Gugong0412/currentboard/R2_ALERT_REPORTS_005/explorer-template.html

CURRENT BOARD / R2

# 12채널 전류 측정 보드

공급원에서 DUT까지, 필요한 연결만 따라가며 보는 회로 지도

R2_REPAIRED_005ERC 0 · 8,437개 검사 통과ALERT 수정 반영제작 HOLD

## 같은 공급원은 묶고, 측정 채널은 따로

채널을 선택하면 실제 넷·핀·ALERT 연결이 표시됩니다.

−100%+기본 크기

블록도는 좌우로 이동할 수 있습니다. 채널 상세는 아래에 표시됩니다.

공통 공급원

직렬 션트채널 · Kelvin 측정DUT 출력

비측정 출력 U600 · VDDIO1V2 1.2V → J1400.7 / U620 · SYS_1V8 1.8V → J1400.9
두 전원에는 전류 측정 채널이 없습니다. SYS_1V8은 MOSCATO·레벨시프터에도 공급됩니다.

→ 공급원에서 DUT로 이어지는 경로INA228은 션트 양단을 Kelvin 감지보라색 = GND_F 기준 VGL 도메인

## 전원은 이렇게 만들어집니다

동일 공급원의 분기는 함께 ON/OFF됩니다. 전체 전원의 시퀀스 승인을 의미하지 않습니다.

J100 · DC 12VVIN_12V_RAW

→

U100 · TPS26600B1 · eFuse / UVLO·OVP·전류 제한

→

VIN_12V_PROTU200 및 U300의 공통 입력

12V 보호 출력에서 분기 A

### U200 · TPS62130 → AUX_5V

U400 · TPS7A9001CTRL_3V3→MCU · 양전압 INA 10개
U500/U520/U540/U600/U620 입력
USB 절연기 보드측 · U1300

U800 · RFM-0505S절연 DC/DC→RAW_5V_F → U810 TPS7A1633
F_3V3 / GND_FVGL INA 2개 + ISO1641 절연측

POWER LED→R1500 / D1500

12V 보호 출력에서 분기 B

### U300 · TPS62130 → VBAT

U900 · MOSCATOVBAT + SYS_1V8 공급→AVDDH1_SRC · 1채널
AVDDH2_SRC · S/O + GM 2채널
VGH_SRC · VGH1/2 2채널
VGL_SRC · VGL1/2 2채널

MOSCATO는 현재 PLACEHOLDER 심볼입니다. 실제 부품 핀맵은 확정 전입니다.

### CTRL_3V3에서 공급되는 LDO 5개 · 모두 TPS7A9001

LDO | 출력 | 분기·용도 | MCU 제어
U500 | VDDI_DIG_SRC | DIG 1채널 | EN_VDDI_DIG
U520 | VDDI_SRC | VDDI / LPDP / OSC 3채널 공통 | EN_VDDI
U540 | VCI_SRC | VCI 1채널 | EN_VCI
U600 | VDDIO1V2 · 1.2V | DUT · 비측정 | EN_VDDIO1V2
U620 | SYS_1V8 · 1.8V | DUT / MOSCATO / 레벨시프터 공유 | EN_SYS_1V8

U520 피드백은 R525 DNP / R526 FIT로 션트 전단 공통점을 기준으로 합니다. 채널별 션트 후단을 개별 보상하지 않습니다.

### VGL 도메인의 기준점

VGL_SRCMOSCATO 공통 음전원 출력

↔

NT800 · Copper net tieVGL_SRC와 GND_F 연결

↔

GND_FU820/U840 · U810 · ISO1641 절연측 기준

GND_F는 시스템 GND 또는 VGL1/2 DUT 후단과 같은 넷이 아닙니다. VGL 헤더의 2번 핀은 시스템 GND입니다.

## 측정값은 I2C로, 직접 알림은 ALERT로

12채널 모두 MCU에서 읽을 수 있습니다. MCU에 연결된 전용 ALERT는 6개입니다.

U1100 · STM32F072CBT6CTRL_3V3 / GND · 전원 EN · PG/FAULT 감시 · 측정값 수집

### I2C1 · 시스템 GND

PB6 SCL / PB7 SDA

↕

양전압 INA228 10개

전원 CTRL_3V3 / GND
주소 0x40~0x49

### I2C2 · 절연 경계 통과

PB10 SCL / PB11 SDA

↕

U830 · ISO1641시스템 GND ↔ GND_F

↕

U820 VGL1 · 0x40U840 VGL2 · 0x41

I2C2_SCL_F / I2C2_SDA_F
F_3V3 / GND_F 공급

### PC · USB 2.0

J1200 · USB4105-GF-ACC Rd / U1201~U1204 ESD

↕

U1200 · ADuM4160PC측 USB_VBUS / USB_GND
보드측 CTRL_3V3 / GND

↕

MCU PA11/PA12 · USB D−/D+
PB1 · USB_ATTACH_3V3

### 직접 ALERT · 6채널

AVDDH2 S/O → PB3, VGH1 → PB4 연결을 최신 수정본에서 복구했습니다.

### ALERT 핀은 있지만 MCU 연결은 없는 6채널

VGL1·2는 polling 유지
U820.3 / U840.3의 ALERT는 F_3V3에 10kΩ으로 pull-up됩니다. VGL1에는 TP1069가 있습니다. MCU로 가는 ALERT 절연 경로는 없으며, 진단 상태를 절연 I2C2로 읽습니다.

Polling = MCU가 주기적으로 측정·진단 레지스터를 읽는 방식입니다. 실행 펌웨어와 읽기 주기는 아직 검증되지 않았습니다.

### B13 · 1.8V 제어

U1300 · SN74AXC2T45

CTRL_3V3 → SYS_1V8 레벨 변환
MOSCATO_EN → U900
DDI_RESET_N → J1400.11

### B11 · 클록·서비스

Y1100 · 8MHz
J1100 SWD / J1101 BOOT
RESET / VDDA 필터 / 디커플링

### B10·B15 · 점검·상태

B10 테스트포인트 70개
POWER / STATUS / FAULT LED
추가 서비스 TP / M3 장착홀

## 12채널 연결표

주소·핀·ALERT 경로는 최신 네이티브 넷리스트와 펌웨어 정의에서 추출했습니다.

인쇄 / PDF 저장

채널 | 션트 | INA228 | I2C 주소 | DUT 핀 | MCU ALERT

R2_REPAIRED_005 · KiCad 10.0.7 · 2026-10-15 KST
회로 연결 검증 통과 / 션트값은 후보값 · 피크·기동·정확도·PCB 실측 미완료 · 제작 HOLD
