Gugong0412/currentboard/history/R2_VERIFY_002/channel_pin_audit.csv

ref | rail | bus | address_7bit | shunt_ref | R_ohm | 1 | 2 | 3 | 4 | 5 | 6 | 7 | 8 | 9 | 10
U700 | VDDI_DIG | 1 | 64 | R507 | 20.0 | GND | GND | ALERT_VDDI_DIG_N | I2C1_SDA | I2C1_SCL | CTRL_3V3 | GND | VDDI_DIG_SRC | VDDI_DIG_INA_N | VDDI_DIG_INA_P
U710 | VDDI | 1 | 65 | R527 | 20.0 | GND | CTRL_3V3 | ALERT_VDDI_N | I2C1_SDA | I2C1_SCL | CTRL_3V3 | GND | VDDI_SRC | VDDI_INA_N | VDDI_INA_P
U720 | VCI | 1 | 66 | R547 | 100.0 | GND | I2C1_SDA | ALERT_VCI_N | I2C1_SDA | I2C1_SCL | CTRL_3V3 | GND | VCI_SRC | VCI_INA_N | VCI_INA_P
U730 | AVDDH1 | 1 | 67 | R737 | 3.01 | GND | I2C1_SCL | ALERT_AVDDH1_N | I2C1_SDA | I2C1_SCL | CTRL_3V3 | GND | AVDDH1_SRC | AVDDH1_INA_N | AVDDH1_INA_P
U740 | AVDDH2_S_O | 1 | 68 | R747 | 3.01 | CTRL_3V3 | GND | ALERT_AVDDH2_S_O_N | I2C1_SDA | I2C1_SCL | CTRL_3V3 | GND | AVDDH2_SRC | AVDDH2_S_O_INA_N | AVDDH2_S_O_INA_P
U750 | VGH1 | 1 | 69 | R757 | 3.01 | CTRL_3V3 | CTRL_3V3 | ALERT_VGH1_N | I2C1_SDA | I2C1_SCL | CTRL_3V3 | GND | VGH_SRC | VGH1_INA_N | VGH1_INA_P
U820 | VGL1 | 2 | 64 | R807 | 20.0 | GND_F | GND_F | ALERT_VGL1_N | I2C2_SDA_F | I2C2_SCL_F | F_3V3 | GND_F | GND | VGL1_INA_N | VGL1_INA_P
U760 | AVDDH2_GM | 1 | 70 | R767 | 3.01 | CTRL_3V3 | I2C1_SDA | ALERT_AVDDH2_GM_N | I2C1_SDA | I2C1_SCL | CTRL_3V3 | GND | AVDDH2_SRC | AVDDH2_GM_INA_N | AVDDH2_GM_INA_P
U770 | VGH2 | 1 | 71 | R777 | 3.01 | CTRL_3V3 | I2C1_SCL | ALERT_VGH2_N | I2C1_SDA | I2C1_SCL | CTRL_3V3 | GND | VGH_SRC | VGH2_INA_N | VGH2_INA_P
U780 | VDDI_LPDP | 1 | 72 | R787 | 20 | I2C1_SDA | GND | ALERT_VDDI_LPDP_N | I2C1_SDA | I2C1_SCL | CTRL_3V3 | GND | VDDI_SRC | VDDI_LPDP_INA_N | VDDI_LPDP_INA_P
U790 | VDDI_OSC | 1 | 73 | R797 | 20 | I2C1_SDA | CTRL_3V3 | ALERT_VDDI_OSC_N | I2C1_SDA | I2C1_SCL | CTRL_3V3 | GND | VDDI_SRC | VDDI_OSC_INA_N | VDDI_OSC_INA_P
U840 | VGL2 | 2 | 65 | R847 | 20 | GND_F | F_3V3 | ALERT_VGL2_N | I2C2_SDA_F | I2C2_SCL_F | F_3V3 | GND_F | GND | VGL2_INA_N | VGL2_INA_P
