Gugong0412/currentboard/history/R2_VERIFY_002/SUMMARY.txt

Status: FAIL_OR_UNVERIFIED
Checks: 8473
Issues: 7
Production: HOLD
