Gugong0412/currentboard/R2_FIX_REPORTS_006/native/SUMMARY.txt

Status: SCHEMATIC_CHECKS_PASS_HARDWARE_HOLD
Checks: 8437
Issues: 0
Production: HOLD
