Gugong0412/currentboard/history/R1/DDI_Phase2_2_Independent_Audit.html

# Phase 2-2 · 독립 회로 검토

2026-10-13 / 제조사 데이터시트 · 실제 부품값 · 부분전원 · 고장조건 · 펌웨어 환산

검토 결과 JSON 내려받기

## 검토의 독립성과 범위

설계 작성과 분리된 검토 에이전트 3개가 전원부(B1~B6), 측정부(B7~B9), 디지털·인터페이스부(B11~B15)를 검토했다. B10 TP는 연결 계약 검사 범위에 포함하며 별도 능동회로는 없다. 실제 핀·넷·부품값을 제조사 자료와 대조하고, 보고서 설명이나 ERC 통과를 동작 보증으로 가정하지 않았다.

이 보고서는 전달했던 Phase2-2 회로도에 대한 정적 검토다. 미확정 MOSCATO 물리핀, 미선정 구매품 및 실측·PCB 레이아웃은 확인 완료로 처리하지 않았다. GitHub 현재판과 동일하다는 보증은 포함하지 않는다.

대상 344개 항목 / 전기 핀 897개 / IC·모듈·placeholder 27개. 아래 체크 표에 실제 확인한 범위를 기록하며 모든 수동소자의 모든 동작을 시험했다고 주장하지 않는다.

입력 계약 SHA256: 63ade460b9bef7a4eee51b0784ea3a5e7c3ac84fff7381ec68c0a9b74f5b98d3

## 우선 대응

① 실제 션트에서 전류 범위·펌웨어 환산값을 다시 생성한다. ② DUT 단락 시 션트 전력과 하드웨어 제한을 검증한다. ③ eFuse raw 입력 C와 서지 보호를 재선정한다. ④ MOSCATO 실물 자료로 VGL 및 전원 순서를 확정한다. ⑤ 저전류 전압 정확도·원격FB 안정성·기동 정착을 시험한다.

VDDA 1Ω 필터와 I²C timing은 에이전트 간 재대조하여 고장 확정과 조건부 계산을 구분했다. 중복되는 지적은 관련 ID를 함께 읽는다.

## 판정 기준

구분 | 의미
FAIL / CONFIRMED | FAIL은 명시 조건 불충족. CONFIRMED는 근거가 확인된 관측이며 tare 같은 정상 동작 영향도 포함한다. 제목·수정안을 보고 오류인지 미반영 예산인지 구분한다. Fault condition은 정상상태와 구분한다.
UNVERIFIED / CONDITIONAL | 필수 정보 또는 실측·제조사 허용 근거가 부족. 고장이 발생했다고 단정하지 않는다.
PASS | 해당 체크에서 명시한 정적 조건만 만족. 회로 전체 승인 아님.
P0 / P1 / P2 | P0: 제작 전 필수해결 / P1: 기능·정확도·보호 중요 / P2: 문서·실측·구현 확인. 원문 항목의 의미를 함께 읽는다.

## 발견사항 요약

ID | 우선도 | 판정 | Ref | 내용 | 수정 방향
PWR-01 | P0 | UNVERIFIED | ["D100", "U100", "U200", "U300"] | TVS/eFuse/벅의 서지 보호 최고전압 입증 미완료 | Specify actual adapter/surge/cable envelope, instrument VIN_12V_PROT during surge andfault. Use rated downstreamclamp with energycoordination or higherVINbuck if needed. Do not assume lowerVRWMalone solves
M-F08 | P0 | CONFIRMED | ["U900"] | 실제 PMIC 회로가 placeholder라 필수 외장부품 검증 불가 | Require MOSCATO exactMPN/data sheet/pinmap/reference circuit plus DUT power sequencing; keep fabrication release blocked forB9 until actual implementation audited.
PWR-02 | P1 | FAIL | ["C100", "U100"] | TVS 적용 시 eFuse 입력 커패시터 권장값 미충족 | Add manufacturerqualified≥1µFeffective highvoltage nonpolarceramic at U100IN/GND, checkhotplugringing and eFusepower; useactualsurgescope to validate
PWR-03 | P1 | UNVERIFIED | ["U500", "U520", "U540", "R505", "R525", "R545", "R507", "R527", "R547"] | 션트 뒤 원격 피드백의 부하별 루프 안정성 미검증 | SimulatevendorLDOmodel with Rs/CDUT/wiring/load range, measureloopgainorstepresponse allloads. Considerlocalfeedbackpluscalibratedvoltage setting, lowerRs plus highresolutionINA, or validatedcompensation. Do not labeloscillationconfirmed
PWR-04 | P1 | UNVERIFIED | ["U400", "U500", "U520", "U540", "U600", "U620", "R400", "R402", "R520", "R522", "R540", "R542"] | LDO 저전류 전압 정확도와 피드백 전류 오차 예산 미완료 | Declare railvoltage requirement; measurezero/min/maxloadandtemperature; reducefeedbackresistors while accounting for extra shunttare, orchooseLDOguaranteedlowloadaccuracy/calibratabletrim. No blindpromiseof±1%
PWR-05 | P1 | FAIL | ["R507", "R527", "U500", "U520"] | DUT 단락 시 20Ω 션트의 연속 열정격 초과 가능 | Hardwarechannelcurrentlimit/faultoff, appropriate shuntpower/derating and definedshortduration. FirmwareALERTalone should not be sole indefinitefaultprotection; testthermals. RaisingRsnotrecommendeddueheadroom/range
PWR-06 | P1 | UNVERIFIED | ["C405", "C505", "C525", "C545", "C605", "C625"] | SS 램프·30ms 대기·PG만으로 정밀 정착 완료 입증 불가 | UseactualINA/ADCvoltagestabilitywindow or characterized delay;keepPGforgrossvalidity,notprecisioncompletion. Specifyminimumdelay basedonworstcharacterization includingexternalDUTcapacitance
PWR-07 | P1 | UNVERIFIED | ["U400", "U500", "U520", "U540", "U600", "U620"] | 외부 전원 인가 및 입력 저하 시 LDO 역전류 미검증 | Defineexternalpower-offconstraints;testoutput>inputandinputremoval; addreverseblockingwhereexternalrailmayremainpowered,accountaddedvoltage/headroom
M-F01 | P1 | CONFIRMED | ["R737", "R757", "U730", "U750"] | AVDDH1/VGH 션트 최대 측정 전류 부족 | Choose actualR based peak/inrush plus margin;3.01Ω at20mA gives60.2mV and54.43mA FS. Update MPN/BOM/calibration/current-LSB together; VGH peak spec still required.
M-F02 | P1 | CONFIRMED | ["R527", "R737", "R757", "R807", "U710", "U730", "U750", "U820"] | 4개 채널의 실제 션트와 펌웨어 환산 저항 불일치 | Generate per-channelR_actual and conversion from authoritative BOM; add cross-artifact validation that fails on any mismatch.
M-F06 | P1 | UNVERIFIED | ["U820", "NT800", "U900", "R807"] | PMIC OFF 및 역방향 과도 상태에서 음전압 측정 입력 범위 미검증 | Measure GND_F/GND and both INA inputs during PMIC OFF/ON, unplug, rail shorts and residual charge with differential probe; derive safe clamp/discharge or rail-qualified power gating from actual PMIC spec. I2C delay alone does not ensure electrical limits.
M-F07 | P1 | UNVERIFIED | ["U900", "R807", "J1402"] | VGL1/VGL2의 공통 소스·통합 측정 허용 여부 미확정 | Obtain real PMIC/DUT net topology and decide common-sum vs separate measurement. Independent outputs require own sensing/power domains or suitable signed front end; revise actual contract.
D-F01 | P1 | UNVERIFIED | ["R1103", "C1105", "C1106", "U1100"] | VDDA 직렬1Ω 필터의 공급 규정 충족 근거 미완료 | 정확한STM32F072 제조사 허용filter 및기동파형으로closure; 가장보수적인최소수정은R1103=0Ω 동일rail직결 유지1u+100n localdecap.
D-F02 | P1 | CONFIRMED | ["U830", "U1100"] | ISO1641 side1 Cbus 한계를 보고서 I2C 설계한계에서 누락 | I2C2 MCU-side Cbus<=80pF로수정,각sidepin/trace/connector/probe합산;side2<=161pF현pullup/tr가정. rise/hold 실측.
D-F03 | P1 | UNVERIFIED | ["Y1100", "C1107", "C1108", "R1102"] | 정확도/드라이브/기동은 후보계산 단계이며 PCB검증 미완료 | 실제PCB Cs/주파수/drive/startup온도측정하여C1107/8,R1102조정;시간축200ppm요구기준기교정과온도/aging예산입증.
D-F04 | P1 | UNVERIFIED | ["U1201", "U1202", "U1203", "U1204", "U1300"] | 일부B12/B13 footprint 실제landpattern 미확정 | 제조사package/landpattern에대조한customfootprint완료후pin/padnumbergeometry검사.
PWR-08 | P2 | UNVERIFIED | ["U400", "U620"] | 정밀 영역의 국부 온도 상승 목표 미입증 | Thermalpad/copperdesign,spacefromshunt/INA,measurezoneΔTinworststeadystate;reportactualambients
M-F03 | P2 | UNVERIFIED | ["U700", "R507", "C701", "U730", "U820"] | 현재 ADC 설정의 노이즈 예산과 요구 측정 정확도 충족이 검증되지 않음 | Define target per sample/mean/window/threshold and test actual bandwidth/noise; select averaging/filter from required edge latency, characterize near100µA threshold chatter. Do not certify20-bit effective resolution.
M-F04 | P2 | CONFIRMED | ["R507", "R527", "R547", "U700", "U710", "U720"] | 원격 FB 분압 부하의 tare와 그 부하 의존성 확인 | Use measured no-DUT tare at same rail/temperature/config, preserve metadata; decide threshold semantics raw vs DUT. R507 remoteFB bandwidth/transient response needs actual DUT cap/load verification.
M-F05 | P2 | CONFIRMED | ["U700", "U710", "U720", "U730", "U740", "U750", "U820"] | INA 차동 입력저항의 션트 병렬 부하를 gain 예산에 추가 필요 | Include finite input impedance in calibration/error budget; do not infer guaranteed correction from typical92k. Validate fitted input filter with gain calibration.
M-F09 | P2 | UNVERIFIED | ["U800", "R800", "U810", "U820"] | 부동 전원의 발열 및 절연 커패시턴스 잡음 영향 미검증 | Place RFM/preload away from shunt/INA, verify thermal drift and VGLreference switching current; selectMLCCparts effectiveC, measure RFMlight-load startup/raw voltage, avoid grounded probes onGND_F.
M-F10 | P2 | UNVERIFIED | ["U720", "U830", "R830", "R831"] | I²C 소자별 주소 hold와 ISO1641 정전용량 조건 확인 | Verify addressMSBhold, buscap andVOL including MCU TIMINGR, routing and TP/probe loads; use scope across isolated domains appropriately.
D-F05 | P2 | UNVERIFIED | ["U1300", "J1400", "J1401", "J1402", "J1100"] | 외부DUT/debug장비연결조건에따른backpower/isolation 미검증 | MOSCATO/DDIpinleak,VDDI/O시퀀스외부전원조건확정;동일PCUSB+SWD동시사용시isolatedprobe혹은USB분리운용;headerkey/polaritymapping고정.

### PWR-01 · TVS/eFuse/벅의 서지 보호 최고전압 입증 미완료

항목 | 검토 결과
reviewer | power
severity | P0
status | UNVERIFIED
refs | ["D100", "U100", "U200", "U300"]
evidence | D100 clamp29.2V >TPS62130A abs20V; eFuseOVP14.874V and typicaldisable6µs, no max6µs guarantee
calculation | A fast step/ringing can cross20V beforedisconnect; staticOVP<17V does not prove peak limiting
fix | Specify actual adapter/surge/cable envelope, instrument VIN_12V_PROT during surge andfault. Use rated downstreamclamp with energycoordination or higherVINbuck if needed. Do not assume lowerVRWMalone solves
source_section | §7.5 OVPtyp6µs;TPS62130§7.1;TVSrating
cross_review | —

제조사 근거: https://www.ti.com/lit/ds/symlink/tps2660.pdf

### M-F08 · 실제 PMIC 회로가 placeholder라 필수 외장부품 검증 불가

항목 | 검토 결과
reviewer | measurement
severity | P0
status | CONFIRMED
refs | ["U900"]
evidence | Nine temporarylogicalpins; source contract PopulationPLACEHOLDER. No verified actualpinmap/footprint/output passives/timing limits available.
calculation | No basis to verify outputvoltage/current, startsequence, VGLoff impedance, required inductors/caps/diodes, voltage ratings or converterloop stability.
fix | Require MOSCATO exactMPN/data sheet/pinmap/reference circuit plus DUT power sequencing; keep fabrication release blocked forB9 until actual implementation audited.
source_section | MOSCATO actual source not supplied
cross_review | —

### PWR-02 · TVS 적용 시 eFuse 입력 커패시터 권장값 미충족

항목 | 검토 결과
reviewer | power
severity | P1
status | FAIL
refs | ["C100", "U100"]
evidence | Only100nF is present beforeeFuse; post-eFuse47µF+40µF cannot replace isolatedrawinputcap during cutoff
calculation | TI§11.1 recommends at least1µF for TVS/surge applications to limit negativeVINslew≤20V/µs
fix | Add manufacturerqualified≥1µFeffective highvoltage nonpolarceramic at U100IN/GND, checkhotplugringing and eFusepower; useactualsurgescope to validate
source_section | §11 PowerSupplyRecommendations;§11.1
cross_review | —

제조사 근거: https://www.ti.com/lit/ds/symlink/tps2660.pdf

### PWR-03 · 션트 뒤 원격 피드백의 부하별 루프 안정성 미검증

항목 | 검토 결과
reviewer | power
severity | P1
status | UNVERIFIED
refs | ["U500", "U520", "U540", "R505", "R525", "R545", "R507", "R527", "R547"]
evidence | FB selectedDUT aftershunt;44µFoutputcapacitorsatSRC;DUTcapacitanceandloadimpedanceunknown
calculation | Rs20Ω×CDUT10µF ->pole796Hz;100Ω×10µF ->159Hz (illustrative unloadedRC). Sourcecapacitance doesnotremove downstreamfeedbackphase shift
fix | SimulatevendorLDOmodel with Rs/CDUT/wiring/load range, measureloopgainorstepresponse allloads. Considerlocalfeedbackpluscalibratedvoltage setting, lowerRs plus highresolutionINA, or validatedcompensation. Do not labeloscillationconfirmed
source_section | §6.2;§7.1.3.1/§7.1.3.2
cross_review | —

제조사 근거: https://www.ti.com/lit/ds/symlink/tps7a90.pdf

### PWR-04 · LDO 저전류 전압 정확도와 피드백 전류 오차 예산 미완료

항목 | 검토 결과
reviewer | power
severity | P1
status | UNVERIFIED
refs | ["U400", "U500", "U520", "U540", "U600", "U620", "R400", "R402", "R520", "R522", "R540", "R542"]
evidence | TPS7A90±1% tested/guaranteed5mA..0.5A;actualDDIloads100µA..3mA;Rbottom150k gives5.333µAdivider;IFBmax±100nA
calculation | IFB×Rtop:CTRL46.875mV=1.42%;VCI41.25mV=1.375%;VDDI18.75mV=1.04%, on top ofIC/resistortolerance
fix | Declare railvoltage requirement; measurezero/min/maxloadandtemperature; reducefeedbackresistors while accounting for extra shunttare, orchooseLDOguaranteedlowloadaccuracy/calibratabletrim. No blindpromiseof±1%
source_section | §5.5;§7.1.1
cross_review | —

제조사 근거: https://www.ti.com/lit/ds/symlink/tps7a90.pdf

### PWR-05 · DUT 단락 시 20Ω 션트의 연속 열정격 초과 가능

항목 | 검토 결과
reviewer | power
severity | P1
status | FAIL
refs | ["R507", "R527", "U500", "U520"]
evidence | remoteFB=0 atshort commandsLDOsource towardCTRL3.3V;LDOcurrentlimit0.8–1.5A wellabovefault165mA;upstreameFuse~1.49A
calculation | 3.3²/20=.5445W, at3.333V .5554W;continuous0.25Wlimit corresponds111.8mA. Normal3mA0.18mW safe
fix | Hardwarechannelcurrentlimit/faultoff, appropriate shuntpower/derating and definedshortduration. FirmwareALERTalone should not be sole indefinitefaultprotection; testthermals. RaisingRsnotrecommendeddueheadroom/range
source_section | §5.5;§6.2
cross_review | —

제조사 근거: https://www.ti.com/lit/ds/symlink/tps7a90.pdf

### PWR-06 · SS 램프·30ms 대기·PG만으로 정밀 정착 완료 입증 불가

항목 | 검토 결과
reviewer | power
severity | P1
status | UNVERIFIED
refs | ["C405", "C505", "C525", "C545", "C605", "C625"]
evidence | 100nFSS_CTRL GND ramp13ms;last3%referencechargedvia280kΩ;PGthreshold84–95%
calculation | τ=280k*100n=28ms; final3%→1% needs28ln3=30.76ms additional after97% ramp≈12.5ms ⇒43.3ms typical;RNRtolerancenot specified
fix | UseactualINA/ADCvoltagestabilitywindow or characterized delay;keepPGforgrossvalidity,notprecisioncompletion. Specifyminimumdelay basedonworstcharacterization includingexternalDUTcapacitance
source_section | §7.1.2.2.2;§6.3.7
cross_review | —

제조사 근거: https://www.ti.com/lit/ds/symlink/tps7a90.pdf

### PWR-07 · 외부 전원 인가 및 입력 저하 시 LDO 역전류 미검증

항목 | 검토 결과
reviewer | power
severity | P1
status | UNVERIFIED
refs | ["U400", "U500", "U520", "U540", "U600", "U620"]
evidence | Datasheetdoesnot claimreversecurrentblocking;DUT/header maystilldriveoutputs whileCTRL inputoff;LDO500mAratingnotreverseblock
calculation | Storedcharge or externalDDIsignal/source can backfeedCTRL viaLDOpassstructure;actualdevicecurrentrequiresmodel/test
fix | Defineexternalpower-offconstraints;testoutput>inputandinputremoval; addreverseblockingwhereexternalrailmayremainpowered,accountaddedvoltage/headroom
source_section | §5.1;§6.2;§7.1.3.1
cross_review | —

제조사 근거: https://www.ti.com/lit/ds/symlink/tps7a90.pdf

### M-F01 · AVDDH1/VGH 션트 최대 측정 전류 부족

항목 | 검토 결과
reviewer | measurement
severity | P1
status | CONFIRMED
refs | ["R737", "R757", "U730", "U750"]
evidence | Contract+actual netlist component values20R; intended up to20mA analog measurement. INA228 range±163.84mV.
calculation | 10mA×20Ω=200mV; 20mA×20Ω=400mV. IFS=163.84mV/20Ω=8.192mA. Clipping starts before10mA.
fix | Choose actualR based peak/inrush plus margin;3.01Ω at20mA gives60.2mV and54.43mA FS. Update MPN/BOM/calibration/current-LSB together; VGH peak spec still required.
source_section | §6.5, §8.2.2 max shunt selection
cross_review | —

제조사 근거: https://www.ti.com/lit/ds/symlink/ina228.pdf

### M-F02 · 4개 채널의 실제 션트와 펌웨어 환산 저항 불일치

항목 | 검토 결과
reviewer | measurement
severity | P1
status | CONFIRMED
refs | ["R527", "R737", "R757", "R807", "U710", "U730", "U750", "U820"]
evidence | Hardware R52720Ω,R73720Ω,R75720Ω,R80720Ω; HTML firmware U710100Ω,U730/U750/U8203.01Ω. SHUNT_CAL1000 common.
calculation | Actual20Ω CURRENT_LSB15.625nA. U710 documented3.125nA yields0.2× true current. Other3.01Ω table103.8206nA yields6.644518× true current.
fix | Generate per-channelR_actual and conversion from authoritative BOM; add cross-artifact validation that fails on any mismatch.
source_section | §8.1.2 Equations2/4; artifact build_phase22.py INA table
cross_review | —

제조사 근거: https://www.ti.com/lit/ds/symlink/ina228.pdf

### M-F06 · PMIC OFF 및 역방향 과도 상태에서 음전압 측정 입력 범위 미검증

항목 | 검토 결과
reviewer | measurement
severity | P1
status | UNVERIFIED
refs | ["U820", "NT800", "U900", "R807"]
evidence | U820GND=VGL_SRC,VBUS=systemGND; IN−≈0 relativeGND_F,IN+≈I×20Ω. PMICOFF output behavior unknown. INA IN±/VBUS absolute min−0.3V.
calculation | Normal2mA givesIN+=40mV and VBUS≈11V atVGL_SRC−11V, valid. IfVGL_SRC rises above+0.3V, VBUS_local<−0.3V. Reverse current below−15mA at20Ω drivesIN+<−0.3V. Actual PMIC/output cap/return transient absent.
fix | Measure GND_F/GND and both INA inputs during PMIC OFF/ON, unplug, rail shorts and residual charge with differential probe; derive safe clamp/discharge or rail-qualified power gating from actual PMIC spec. I2C delay alone does not ensure electrical limits.
source_section | §6.1 absolute maximum; §6.5 VBUS/input ranges
cross_review | —

제조사 근거: https://www.ti.com/lit/ds/symlink/ina228.pdf

### M-F07 · VGL1/VGL2의 공통 소스·통합 측정 허용 여부 미확정

항목 | 검토 결과
reviewer | measurement
severity | P1
status | UNVERIFIED
refs | ["U900", "R807", "J1402"]
evidence | Actual U900 pin9 soleVGL, R807 one shunt, J1402 soleVGL_DUT. NoVGL1/VGL2 nets.
calculation | Common source split after shunt measuressum only. Independent PMIC outputs cannot be shorted merely because set voltage same.
fix | Obtain real PMIC/DUT net topology and decide common-sum vs separate measurement. Independent outputs require own sensing/power domains or suitable signed front end; revise actual contract.
source_section | Circuit topology; PMIC data sheet absent
cross_review | —

제조사 근거: https://www.ti.com/lit/ds/symlink/ina228.pdf

### D-F01 · VDDA 직렬1Ω 필터의 공급 규정 충족 근거 미완료

항목 | 검토 결과
reviewer | digital
severity | P1
status | UNVERIFIED
refs | ["R1103", "C1105", "C1106", "U1100"]
evidence | DS9826 VDDA>=VDD 및먼저형성 요구; actual1Ω+1.1uF는DCdrop와positive-ramp lag 발생. AN4080 외부filter권장하므로 필터 존재 자체를 확정불량으로 단정하지 않음. abs VDD−VDDA≤0.4V와operatingrule을분리.
calculation | tau1.1us; U40012.9ms/3.3V ramp capacitive lag0.281mV +analogload I*1Ω(예10mA→10mV). 실제 ramp/startuptested없음.
fix | 정확한STM32F072 제조사 허용filter 및기동파형으로closure; 가장보수적인최소수정은R1103=0Ω 동일rail직결 유지1u+100n localdecap.
source_section | §3.5.1/3.5.2;Table20;AN4080§1.1.1
cross_review | —

제조사 근거: https://www.st.com/resource/en/datasheet/stm32f072cb.pdf

### D-F02 · ISO1641 side1 Cbus 한계를 보고서 I2C 설계한계에서 누락

항목 | 검토 결과
reviewer | digital
severity | P1
status | CONFIRMED
refs | ["U830", "U1100"]
evidence | 보고서모든segment<=161pF라고지시하지만ISOside1recommendmax80pF. actualPCBcap미제공이라하드웨어초과는미확정.
calculation | tr0.8473*2200*80pF=149.1ns;161pF는300nsRC상한일뿐 device80pF제약이우선.
fix | I2C2 MCU-side Cbus<=80pF로수정,각sidepin/trace/connector/probe합산;side2<=161pF현pullup/tr가정. rise/hold 실측.
source_section | §6.3C1/C2
cross_review | —

제조사 근거: https://www.ti.com/lit/ds/symlink/iso1641.pdf

### D-F03 · 정확도/드라이브/기동은 후보계산 단계이며 PCB검증 미완료

항목 | 검토 결과
reviewer | digital
severity | P1
status | UNVERIFIED
refs | ["Y1100", "C1107", "C1108", "R1102"]
evidence | Cs4pF가정으로CL10pF. STM datasheet rough Cs10pF도가능,이면현재12p각CL16pF. 주변부품진동자loadpull/drivemax는ERC로검증못함.
calculation | actual CL=6pF+Cs. gmcrit0.584mS. maxdrive100uW에서IRMS sqrt(100uW/200Ω)=0.707mA;이는ESR200가정전류기준이지실측값아님.
fix | 실제PCB Cs/주파수/drive/startup온도측정하여C1107/8,R1102조정;시간축200ppm요구기준기교정과온도/aging예산입증.
source_section | specs;DS9826§6.3.6;AN2867
cross_review | —

제조사 근거: https://abracon.com/Resonators/abm3b.pdf

### D-F04 · 일부B12/B13 footprint 실제landpattern 미확정

항목 | 검토 결과
reviewer | digital
severity | P1
status | UNVERIFIED
refs | ["U1201", "U1202", "U1203", "U1204", "U1300"]
evidence | pending_footprints.json이ESD3pin/2pin+AXCDCT8을미확정으로표시;schematicprovenancepincorrect여도PCB생산용패드geometry증명없음.
calculation | B12/B13 5components footprintfinalizationpending.
fix | 제조사package/landpattern에대조한customfootprint완료후pin/padnumbergeometry검사.
source_section | DCTpackage mechanical drawing;TPDpackage drawings
cross_review | —

제조사 근거: https://www.ti.com/lit/ds/symlink/sn74axc2t45.pdf

### PWR-08 · 정밀 영역의 국부 온도 상승 목표 미입증

항목 | 검토 결과
reviewer | power
severity | P2
status | UNVERIFIED
refs | ["U400", "U620"]
evidence | CTRLseriesregulatordissipates~0.44W and SYS~0.15W;temperaturezone placementPCBpending
calculation | θJA62.5°C/W implies~27°C U400junctionrise—not boardlocalΔT≤5°C
fix | Thermalpad/copperdesign,spacefromshunt/INA,measurezoneΔTinworststeadystate;reportactualambients
source_section | §5.4;§7.2/§7.4
cross_review | —

제조사 근거: https://www.ti.com/lit/ds/symlink/tps7a90.pdf

### M-F03 · 현재 ADC 설정의 노이즈 예산과 요구 측정 정확도 충족이 검증되지 않음

항목 | 검토 결과
reviewer | measurement
severity | P2
status | UNVERIFIED
refs | ["U700", "R507", "C701", "U730", "U820"]
evidence | Datasheet Table8-2 AVG1 noise-freeENOB14.2 at540µs,16.0 at4120µs vs encoded20bits. Default differential caps DNP and0Ω series no fitted EMI filtering. HTML contains no ENOB/noise budget; this is a specification-validation gap, not proof that long-window averaging fails.
calculation | DIG noise-free p-p equivalent327.68mV/2^14.2≈17.41µV /20Ω≈0.871µA, versus15.625nA code step. At8µA signal this is ~10.9% p-p typical instantaneous spread; it is not a guaranteed absolute error and averaging-window accuracy must be separately assessed. 4120µs ENOB16 gives5µV p-p≈0.25µA at20Ω or1.661µA at3.01Ω. Offset max1µV=50nA at20Ω; resistor/gain/temp/tare add.
fix | Define target per sample/mean/window/threshold and test actual bandwidth/noise; select averaging/filter from required edge latency, characterize near100µA threshold chatter. Do not certify20-bit effective resolution.
source_section | §6.5; §8.1.3 Table8-2
cross_review | —

제조사 근거: https://www.ti.com/lit/ds/symlink/ina228.pdf

### M-F04 · 원격 FB 분압 부하의 tare와 그 부하 의존성 확인

항목 | 검토 결과
reviewer | measurement
severity | P2
status | CONFIRMED
refs | ["R507", "R527", "R547", "U700", "U710", "U720"]
evidence | FIT R505/R525/R545 connect feedback divider downstream of shunt. Divider current is0.8V/150kΩ≈5.333µA nominal. Source-sideVBUS bypasses shunt.
calculation | Measured load≈DUT current+divider+other downstream leakage; at8µA DUT nominal raw13.333µA. DIG SOVL0190=2mV/20Ω=100µA raw≈94.667µA DUT, not100µA DUT. FB bias/voltage/temp change tare.
fix | Use measured no-DUT tare at same rail/temperature/config, preserve metadata; decide threshold semantics raw vs DUT. R507 remoteFB bandwidth/transient response needs actual DUT cap/load verification.
source_section | §7.6.1.13 SOVL; TPS7A90 feedback circuit and actualR505/R525/R545
cross_review | —

제조사 근거: https://www.ti.com/lit/ds/symlink/ina228.pdf

### M-F05 · INA 차동 입력저항의 션트 병렬 부하를 gain 예산에 추가 필요

항목 | 검토 결과
reviewer | measurement
severity | P2
status | CONFIRMED
refs | ["U700", "U710", "U720", "U730", "U740", "U750", "U820"]
evidence | INA RDIFF typical92kΩ, in addition to2.5nA max input bias specification; report did not budget divider path explicitly.
calculation | EffectiveR=Rsh||92kΩ. Ideal hardware V/Rsh under-reports total DUT path current by Rsh/(92k+Rsh):20Ω0.021734%,100Ω0.108578%,3.01Ω0.003272%; typicalRDIFF only, not guaranteed bound. Optional10Ω filter each adds20/92k≈0.0217% additional gain loss.
fix | Include finite input impedance in calibration/error budget; do not infer guaranteed correction from typical92k. Validate fitted input filter with gain calibration.
source_section | §6.5 RDIFF; §8.1.4 input filtering Figure8-1
cross_review | —

제조사 근거: https://www.ti.com/lit/ds/symlink/ina228.pdf

### M-F09 · 부동 전원의 발열 및 절연 커패시턴스 잡음 영향 미검증

항목 | 검토 결과
reviewer | measurement
severity | P2
status | UNVERIFIED
refs | ["U800", "R800", "U810", "U820"]
evidence | RFM unregulated50..100kHz, ripple100mVppmax at specified100nFtest; isolation capacitance75pFmax. R800≈114mW at5V; RFM inputquiescent25mAtyp. U820offsetdrift10nV/°Cmax.
calculation | Digital3.3V headroom and capacitance nominal plausible; precision pickup depends PCB.75pF×dV/dt injects common-mode current, not DC short. 5°C INA offsetdrift max50nV (~2.5nA at20Ω), resistor25ppm/°C contributes125ppm over5°C; PCB temp actual unknown.
fix | Place RFM/preload away from shunt/INA, verify thermal drift and VGLreference switching current; selectMLCCparts effectiveC, measure RFMlight-load startup/raw voltage, avoid grounded probes onGND_F.
source_section | Electrical characteristics, regulation, isolation capacitance; INA §6.5
cross_review | —

제조사 근거: https://recom-power.com/pdf/Econoline/RFM.pdf

### M-F10 · I²C 소자별 주소 hold와 ISO1641 정전용량 조건 확인

항목 | 검토 결과
reviewer | measurement
severity | P2
status | UNVERIFIED
refs | ["U720", "U830", "R830", "R831"]
evidence | INA A0=SDA needsadditional100ns hold; ISOside1Cmax80pF,side2Cmax400pF; nominal2.2k pullups valid.
calculation | At80pF t_r≈0.8473×2.2k×80pF=149ns; RC-only300ns limit161pF does not authorizeISOside1>80pF.
fix | Verify addressMSBhold, buscap andVOL including MCU TIMINGR, routing and TP/probe loads; use scope across isolated domains appropriately.
source_section | INA §7.5.1 Table7-2; ISO §6.3 recommended operating conditions
cross_review | 디지털 검토와 대조: tf≤100ns/48MHz/지정필터 조건에서 주소 hold 최소 약179ns로 조건부 충족. 실제 파형 확인은 필요. ISO side1은≤80pF 적용; 보고서161pF 일반값과의 문서 불일치는D-F02에 별도 기록.

제조사 근거: https://www.ti.com/lit/ds/symlink/ina228.pdf ; https://www.ti.com/lit/ds/symlink/iso1640.pdf

### D-F05 · 외부DUT/debug장비연결조건에따른backpower/isolation 미검증

항목 | 검토 결과
reviewer | digital
severity | P2
status | UNVERIFIED
refs | ["U1300", "J1400", "J1401", "J1402", "J1100"]
evidence | AXC Ioff보호는신호포트에한정;DUT의외부pullup/다른전원/RESETdiode와railfeeding은미제공. SWD PC ground로USBisolation우회가능. unkeyedheadersreverse/misplug위험.
calculation | B출력Ioff8uA*10k=80mV은외부누설/풀업없을때만성립.
fix | MOSCATO/DDIpinleak,VDDI/O시퀀스외부전원조건확정;동일PCUSB+SWD동시사용시isolatedprobe혹은USB분리운용;headerkey/polaritymapping고정.
source_section | §5.5Ioff;systemconnectionconditions
cross_review | —

제조사 근거: https://www.ti.com/lit/ds/symlink/sn74axc2t45.pdf

## 체크 매트릭스 · 에이전트 원문

### Actual Phase2-2 B1–B6 independent datasheet audit; schematic/verified netlist; no edits

refs | status | item | actual | criterion | source_url | source_section
["U100"] | PASS | PWP16 pins/reference domains | IN1/2;OUT15/16;RTN8/EP17;GND9;UV3;OV5;MODE6→RTN;SHDN7 NC | §6 pinmap consistent; RTN must not be shorted GND | https://www.ti.com/lit/ds/symlink/tps2660.pdf | §6;§10.4
["R100", "R101", "R102"] | PASS | Nominal DC UVLO/OVP | 110k/4.99k/10k,0.1%; UVLO9.922V,OVP14.874V | At full resistor temp allowance OVP about14.508–15.433V <17V continuous buck max; no transient claim | https://www.ti.com/lit/ds/symlink/tps2660.pdf | §7.5;§9.3.2
["R103"] | PASS | eFuse nominal current limit | 8.06kΩ =>12000/8060=1.4888A | 5.36k≤RILIM≤120k; approximately1.40–1.58A with ±5%IC and ±1%R (interpolated bound) | https://www.ti.com/lit/ds/symlink/tps2660.pdf | §7.5;§9.3.5.1.1
["C101"] | PASS | Output slew ramp | 100nF;4.7µA,gain24.6 =>dVOUT/dt1.156V/ms;12V ramp10.38ms;CdVdt delay1.45ms typical | Local referenced to RTN, within recommended control pin voltage | https://www.ti.com/lit/ds/symlink/tps2660.pdf | §7.5;§9.3.3
["R104"] | PASS | FLT pullup | 10k CTRL_3V3; about330µA sink | Open-drain voltage rating covers3.3V; low≈53mV using max160Ω | https://www.ti.com/lit/ds/symlink/tps2660.pdf | §7.5
["C102", "C103"] | UNVERIFIED | eFuse output capacitor mechanical/surge | 47µF35V+100nF50V; logical polarity correct | Actual47µF MPN/ESR/ripple/land pattern not finalized; output-negative spike protection to be tested | https://www.ti.com/lit/ds/symlink/tps2660.pdf | §11.1
["J100"] | UNVERIFIED | Input jack physical rating/pin orientation | PJ-102AH logical center1/sleeve2/switch3NC | Manufacturer drawing/mating plug/actual max current rating not independently verified in this pass | https://www.sameskydevices.com/product/interconnect/connectors/dc-power-connectors/jacks/pj-102ah | Mechanical drawing
["D100", "C100", "U200", "U300"] | UNVERIFIED | Transient protection chain | SMBJ18CA29.2V;C100100nF;TPS62130A abs20V | Requires source surge envelope plus eFuse downstream peak proof; see findings PWR-01/PWR-02 | https://www.ti.com/lit/ds/symlink/tps2660.pdf | §7.5;§11.1
["U200"] | PASS | TPS62130A physical pins/function | SW1/2/3;PG4;FB5;AGND6;FSW7GND;DEF8GND;SS9;AVIN10;PVIN11/12;EN13;VOS14 output;PGND15/16;EP17GND | Matches datasheet RGT16; AVIN/PVIN same source;2.5MHz selected, DEFno+5% | https://www.ti.com/lit/ds/symlink/tps62130.pdf | §6 Table6-1;§8.3.5
["U300"] | PASS | TPS62130A physical pins/function | SW1/2/3;PG4;FB5;AGND6;FSW7GND;DEF8GND;SS9;AVIN10;PVIN11/12;EN13;VOS14 output;PGND15/16;EP17GND | Matches datasheet RGT16; AVIN/PVIN same source;2.5MHz selected, DEFno+5% | https://www.ti.com/lit/ds/symlink/tps62130.pdf | §6 Table6-1;§8.3.5
["R200", "R201", "R202"] | PASS | 5V divider | 523k+2k/100k =>0.8*(1+525/100)=5.000V;divider8µA | Rbottom≤400k, Vout0.9–6V; extra serialR mathematically okay | https://www.ti.com/lit/ds/symlink/tps62130.pdf | §9.2.2.1
["R300", "R301", "R302"] | PASS | 3.8V divider | 374k+1k/100k =>3.800V;divider8µA | Rbottom≤400k; ratio correct | https://www.ti.com/lit/ds/symlink/tps62130.pdf | §9.2.2.1
["L200", "L300"] | PASS | Inductor nominal value/load margin | XFL4020-222MEC2.2µH±20%;DCRmax23.5mΩ;datasheet3.8A recommendation; ΔI worst at15.43V,L1.76µH,f2MHz≈0.960A(5V),0.814A(3.8V) | At intended AUX≈0.5A/PMIC≤1A, peak≤1.48A < Coilcraft6A at10%L drop; actual full3A continuous not separately promised | https://www.ti.com/lit/ds/symlink/tps62130.pdf | §9.2.2.2;Table9-3;Coilcraft XFL4020 datasheet
["C200", "C201", "C202", "C203", "C204", "C300", "C301", "C302", "C303", "C304"] | UNVERIFIED | Buck input/output capacitors | CIN2×10µF50V+CAVIN100nF;COUT2×22µF16V | Nominal adequate and required AVIN100nF present; MPN/DC-bias effective cap/PCB loop placement pending | https://www.ti.com/lit/ds/symlink/tps62130.pdf | §9.2.2.2.2
["C205", "C305"] | PASS | Buck soft-start | 3.3nF =>tSS1.65ms typical | Equation10 C=t*2.5µA/1.25V; max timing not established | https://www.ti.com/lit/ds/symlink/tps62130.pdf | §9.2.2.2.2.3
["R203", "R303", "R304", "R305"] | PASS | Buck PG/EN/bleeder | PG10k→CTRL;VBAT EN100k→GND;VBAT1k→GND | PGopen-drain;bootENlow;bleeder3.8mA/14.44mW <0.1W;44µF→0.3V decay111.7ms nominal | https://www.ti.com/lit/ds/symlink/tps62130.pdf | §6;§8.3.3
["U400"] | PASS | TPS7A90 DSK10 pin wiring | OUT1/2;FB3;GND4;PG5;SS_CTRL6GND;EN7;NR8;IN9/10;EP11GND | Correct pinmap; supplies3.3/5V inside1.4–6.5V; SS_CTRL grounded | https://www.ti.com/lit/ds/symlink/tps7a90.pdf | §4 pinfunctions;§5.3
["U500"] | PASS | TPS7A90 DSK10 pin wiring | OUT1/2;FB3;GND4;PG5;SS_CTRL6GND;EN7;NR8;IN9/10;EP11GND | Correct pinmap; supplies3.3/5V inside1.4–6.5V; SS_CTRL grounded | https://www.ti.com/lit/ds/symlink/tps7a90.pdf | §4 pinfunctions;§5.3
["U520"] | PASS | TPS7A90 DSK10 pin wiring | OUT1/2;FB3;GND4;PG5;SS_CTRL6GND;EN7;NR8;IN9/10;EP11GND | Correct pinmap; supplies3.3/5V inside1.4–6.5V; SS_CTRL grounded | https://www.ti.com/lit/ds/symlink/tps7a90.pdf | §4 pinfunctions;§5.3
["U540"] | PASS | TPS7A90 DSK10 pin wiring | OUT1/2;FB3;GND4;PG5;SS_CTRL6GND;EN7;NR8;IN9/10;EP11GND | Correct pinmap; supplies3.3/5V inside1.4–6.5V; SS_CTRL grounded | https://www.ti.com/lit/ds/symlink/tps7a90.pdf | §4 pinfunctions;§5.3
["U600"] | PASS | TPS7A90 DSK10 pin wiring | OUT1/2;FB3;GND4;PG5;SS_CTRL6GND;EN7;NR8;IN9/10;EP11GND | Correct pinmap; supplies3.3/5V inside1.4–6.5V; SS_CTRL grounded | https://www.ti.com/lit/ds/symlink/tps7a90.pdf | §4 pinfunctions;§5.3
["U620"] | PASS | TPS7A90 DSK10 pin wiring | OUT1/2;FB3;GND4;PG5;SS_CTRL6GND;EN7;NR8;IN9/10;EP11GND | Correct pinmap; supplies3.3/5V inside1.4–6.5V; SS_CTRL grounded | https://www.ti.com/lit/ds/symlink/tps7a90.pdf | §4 pinfunctions;§5.3
["R400", "R401", "R402"] | UNVERIFIED | LDO nominal divider / total tolerance | Nominal 3.300000V, target3.3V;divider5.333µA;IFB±100nA gives±46.875mV (1.420%) | Ratio nominal PASS. Overall precision not established; IC1% is ≥5mA condition; IFB/resistor/temp added, see PWR-04 | https://www.ti.com/lit/ds/symlink/tps7a90.pdf | §5.5;§7.1.1
["R500", "R502"] | UNVERIFIED | LDO nominal divider / total tolerance | Nominal 1.240000V, target1.24V;divider5.333µA;IFB±100nA gives±8.250mV (0.665%) | Ratio nominal PASS. Overall precision not established; IC1% is ≥5mA condition; IFB/resistor/temp added, see PWR-04 | https://www.ti.com/lit/ds/symlink/tps7a90.pdf | §5.5;§7.1.1
["R520", "R521", "R522"] | UNVERIFIED | LDO nominal divider / total tolerance | Nominal 1.799995V, target1.8V;divider5.333µA;IFB±100nA gives±18.750mV (1.042%) | Ratio nominal PASS. Overall precision not established; IC1% is ≥5mA condition; IFB/resistor/temp added, see PWR-04 | https://www.ti.com/lit/ds/symlink/tps7a90.pdf | §5.5;§7.1.1
["R540", "R541", "R542"] | UNVERIFIED | LDO nominal divider / total tolerance | Nominal 2.999995V, target3V;divider5.333µA;IFB±100nA gives±41.250mV (1.375%) | Ratio nominal PASS. Overall precision not established; IC1% is ≥5mA condition; IFB/resistor/temp added, see PWR-04 | https://www.ti.com/lit/ds/symlink/tps7a90.pdf | §5.5;§7.1.1
["R600", "R602"] | UNVERIFIED | LDO nominal divider / total tolerance | Nominal 1.200000V, target1.2V;divider5.333µA;IFB±100nA gives±7.500mV (0.625%) | Ratio nominal PASS. Overall precision not established; IC1% is ≥5mA condition; IFB/resistor/temp added, see PWR-04 | https://www.ti.com/lit/ds/symlink/tps7a90.pdf | §5.5;§7.1.1
["R620", "R621", "R622"] | UNVERIFIED | LDO nominal divider / total tolerance | Nominal 1.799995V, target1.8V;divider5.333µA;IFB±100nA gives±18.750mV (1.042%) | Ratio nominal PASS. Overall precision not established; IC1% is ≥5mA condition; IFB/resistor/temp added, see PWR-04 | https://www.ti.com/lit/ds/symlink/tps7a90.pdf | §5.5;§7.1.1
["R505", "R506", "R525", "R526", "R545", "R546"] | UNVERIFIED | Feedback selection and remote regulation | DUT selection0Ω FIT, source0Ω DNP, exclusive assembly | Assembly population is correct; bothFIT would short shunt. Remote stability not covered by standard OUT-senseddatasheet;see PWR-03 | https://www.ti.com/lit/ds/symlink/tps7a90.pdf | §6.2;§7.1.3
["R507", "R527", "R547"] | FAIL | Shunt DC/fault power and dropout | 20Ω/20Ω/100Ω,0.25W;normal3mA→60mV0.18mW DIG;1mA→20mV0.02mW VDDI;1mA→100mV0.1mW VCI | Normal rated loads PASS. DUTshort makes20Ω about0.545W without upstream protection; see PWR-05 | https://www.ti.com/lit/ds/symlink/tps7a90.pdf | §5.5 currentlimit;§6.2 block diagram
["R503", "R523", "R543", "R603", "R623", "R404", "R504", "R524", "R544", "R604", "R624"] | PASS | LDO EN boot pull-down/PG pullup | EN100k→GND;PG10k→CTRL | ENdisabledthreshold≤0.4V;pullup10k within10–100k;PGnotprecisionstatus and invalid belowVIN0.8V | https://www.ti.com/lit/ds/symlink/tps7a90.pdf | §5.3;§5.5;§6.3.7
["C400", "C401", "C402", "C403", "C404", "C500", "C502", "C503", "C504", "C520", "C522", "C523", "C524", "C540", "C542", "C543", "C544", "C600", "C602", "C603", "C604", "C620", "C622", "C623", "C624"] | UNVERIFIED | LDO decoupling effective value | U400CIN44µF,COUT44µF;otherCIN10µF+100nF,COUT44µF | 10µF recommendation already includes50%derating; nominal setup acceptable. Actual ≥5µF minimum adopted design floor requires MPNcurve confirmation, not a separately specified guarantee | https://www.ti.com/lit/ds/symlink/tps7a90.pdf | §7.1.3
["C405", "C505", "C525", "C545", "C605", "C625"] | UNVERIFIED | Soft-start and final settling | 100nF,SS_CTRL GND;tSSnom12.90ms, referencecurrent4–9µA;last3%throughRNR≈280k | Last3% timeconstant≈28ms;43ms nominal to1%error;PGcanrise at84–95%;seePWR-06 | https://www.ti.com/lit/ds/symlink/tps7a90.pdf | §7.1.2.2.2;§6.3.7
["C406", "C506", "C526", "C546", "C606", "C626"] | PASS | Feedforward optional/DNP | 100pF allDNP | CFFnotrequired for standard topology stability. Fitting differentCFF requiresstartup/PGrecheck and remote-loop check | https://www.ti.com/lit/ds/symlink/tps7a90.pdf | §7.1.3.2
["U400", "U620"] | UNVERIFIED | Thermal intended budget | U400~0.436W@250mA θJA62.5→27.3°C;SYS100mA1.5Vdrop→0.15W≈9.4°C | Junction likely okay at labambient with thermalpad;localmeasurementzoneΔT≤5°Cnotguaranteed by package spec,PCB/IRtest needed | https://www.ti.com/lit/ds/symlink/tps7a90.pdf | §5.4;§7.2 thermal
["#FLG0100", "#FLG0101", "#FLG0102", "#FLG0200", "#FLG0300"] | PASS | PWR_FLAGs | No physicalload | ERC helper only; not functional sourcing guarantee

### B5 shunts + B7 INA228 positive channels + B8 floating VGL + B9 MOSCATO; Phase2-2 actual schematic/netlist/contract vs embedded firmware report; independent design audit, no changes

id | status | refs | detail
M-C01 | PASS | ["U700", "U710", "U720", "U730", "U740", "U750", "U820"] | INA228 physical pins 1=A1,2=A0,3=ALERT,4=SDA,5=SCL,6=VS,7=GND,8=VBUS,9=IN−,10=IN+; seven devices match. Positive rail IN+ source/IN− DUT; VGL polarity deliberately reversed to measure current toward negative source as positive.
M-C02 | PASS | ["U700", "U710", "U720", "U730", "U740", "U750", "U820"] | I2C1 0x40..0x45 unique; I2C2 local 0x40 allowed on separate bus. Supply CTRL_3V3/F_3V3 satisfies VS2.7..5.5V; each device has local100nF+1µF nominal.
M-C03 | UNVERIFIED | ["U720", "U830"] | A0=SDA address requires additional100ns hold on address MSB; measured timing is absent. ISO1641 side1 bus capacitance max80pF, side2 max400pF, stricter than RC-only side1 calculation. Pullup2.2k at3.3V sinks1.5mA, within ISO side1 max3.5mA.
M-C04 | FAIL | ["R737", "R757"] | 20Ω shunt fullscale8.192mA at ADCRANGE0, below intended analog20mA range.
M-C05 | FAIL | ["R527", "R737", "R757", "R807"] | Four hardware shunt values differ from embedded HTML firmware conversion table.
M-C06 | PASS | ["U700", "U710", "U720", "U730", "U740", "U750", "U820"] | CONFIG0000 ADCRANGE0; AB28/ABE8 correctly encode shunt-only continuous540µs/4120µs AVG1; SHUNT_CAL1000 corresponds CURRENT_LSB=0.3125µV/R_actual. 24-bit VSHUNT/CURRENT bits23:4 signed, VBUS bits23:4 nonnegative. SOVL LSB5µV differs ADC0.3125µV.
M-C07 | UNVERIFIED | ["R507", "R527", "R547", "R737", "R747", "R757", "R807"] | 0.1%/25ppm targets and logical4-pin/physical2-terminal1206 implementation are stated; actual ordered resistance/tempco, Kelvin pad routing and copper current distribution need PCB/manufacturer proof. FIT sense resistors0Ω, differential1nF DNP: no external analog filter fitted.
M-C08 | PASS | ["U800", "R800", "U810", "C810", "C812"] | RFM pin1−VIN/2+VIN/3−VOUT/4+VOUT correct. TPS7A1633 DNC pin2 open; DELAY7 open legal. IN22µF/OUT22µF nominal exceeds minima0.1/2.2µF; effective capacitance still needs selected-MLCC curve. R800220Ω creates>=20.25mA at4.5V,+1%R and therefore >=10% of200mA rating; 5V dissipation113.6mW within0.5W rating. Raw22.1µF is below470µF RFM max capacitive load.
M-C09 | PASS | ["U820", "NT800", "U830"] | VGL_SRC=GND_F byNT800; U820VBUS=systemGND means VBUS_local=−VGL_SRC, permitting magnitude measurement for negative rail. I2C domains electrically isolated; pullups terminate in own domains. No direct system-pullup feed into GND_F.
M-C10 | UNVERIFIED | ["U820", "U900", "NT800"] | No PMIC OFF-output impedance/discharge/waveform exists to guarantee GND_F potential or U820 pin absolute limits during power-up/off/reverse current. PG_F_3V3 proves only local3.3V, not floating-domain absolute potential.
M-C11 | UNVERIFIED | ["U900", "R807"] | Only one VGL source/shunt/output path; VGL1/VGL2 identity, permitted shared rail or independent PMIC outputs unprovided.
M-C12 | FAIL | ["U900"] | MOSCATO nine logical pins PLACEHOLDER, no actual package, PMIC inductor/diode/caps/current-limit/compensation/output discharge requirements; cannot release physical B9 design.
M-C13 | PASS | ["B7", "B8", "B9"] | {"exported_netlist_contract_mismatches": []}
M-C14 | PASS | ["R507", "R527", "R547", "R737", "R747", "R757", "R807"] | YageoRTseries latest2026-02-12V17 p5Table2 RT1206 1/4W ±0.1% ±25ppm range1Ω..1.5MΩ. Part codes BRD mean±0.1%,paperreel,±25ppm; 3.01Ω/20Ω/100Ω valid within series published range. Production exactorder availability remains procurement check. Source https://yageogroup.com/content/datasheet/asset/file/PYU-RT_1-TO-0-01_ROHS_L

### B11~B15 independent electrical/datasheet audit; actual schematic verified netlist; no edits

id | refs | status | detail | source_url | source_section

D-C01

["U1100", "C1100", "C1101", "C1102", "C1103", "C1104", "R1103", "C1105", "C1106", "Y1100", "R1102", "C1107", "C1108", "R1100", "C1109", "SW1100", "R1101", "J1101", "R1104", "R1105", "J1100", "J1200", "R1200", "R1201", "U1200", "R1202", "R1203", "R1204", "R1205", "R1206", "R1207", "C1200", "C1201", "C1202", "C1203", "C1204", "C1205", "U1201", "U1202", "U1203", "U1204", "#FLG1200", "#FLG1201", "U1300", "C1300", "C1301", "R1300", "R1301", "R1302", "R1303", "R1304", "R1305", "J1400", "J1401", "J1402", "R1500", "D1500", "R1501", "D1501", "R1502", "D1502", "H1500", "H1501", "H1502", "H1503", "LOGO1500", "TP1500", "TP1501", "TP1502", "TP1503", "TP1504", "TP1505", "TP1506", "TP1507", "TP1508"]

PASS

B11~B15 actual verified_netlist.xml vs contract: local sheet path normalized; PWR_FLAG excluded; non-NC pin differences=[]

None

netlist cross-check
D-C02 | ["U1100"] | PASS | LQFP48 physical pin names 1~48 compared DS9826 Table14/Figure10; VDD24/48 VDDIO2=36 VBAT=1 VDDA=9 VSSA=8 VSS23/35/47 correctly assigned. | https://www.st.com/resource/en/datasheet/stm32f072cb.pdf | Table14; Figure10
D-C03 | ["U1100", "C1100", "C1101", "C1102", "C1103", "C1104", "C1105", "C1106"] | PASS | VDD/VDDIO2/VBAT all same3.3V; separate100n per power,4.7u bulk,VDDA1u+100n present. PASS on values only; placement/return geometry unverified. | https://www.st.com/resource/en/datasheet/stm32f072cb.pdf | §3.5; Figure13
D-C04 | ["U1100", "R1103"] | UNVERIFIED | VDDA filter compliance needs closure: DS recommends VDDA>=VDD and first established, AN4080 recommends single rail external filtering. Current1Ω means small lag/drop; cannot call catastrophic error. See D-F01. | https://www.st.com/resource/en/datasheet/stm32f072cb.pdf | §3.5.1/3.5.2; Table20
D-C05 | ["R1100", "C1109", "SW1100", "R1101", "J1101", "J1100"] | PASS | NRST external10k to3.3V+100n GND+button; BOOT0 10k pulldown service jumper; ARM SWD standard1VTref2SWDIO3GND4SWCLK5GND7key9GND10reset. Pin7 remains physical unkeyed-header pin requiring remove/keying. | https://www.st.com/resource/en/application_note/an4080-getting-started-with-stm32f0x1x2x8-hardware-development-stmicroelectronics.pdf | §1.2.3; §3; §4
D-C06 | ["U1100"] | PASS | PA0 AF2 TIM2CH1_ETR; PB6/7 AF1 I2C1 and PB10/11 AF1 I2C2; PA13/14 SWD; PA11/12 USB PHY; PG/FAULT PC13/14/15 used inputs, so restricted drive PC13~15 not violated. | https://www.st.com/resource/en/datasheet/stm32f072cb.pdf | Table14/Table15/Table16
D-C07 | ["Y1100", "C1107", "C1108", "R1102"] | UNVERIFIED | 8MHz crystal CL10pF,12p+12p with assumed stray4p yields10p. ESR200Ω,C0max7p gives gmcrit0.584mS vs10mS startup ~17.1margin. Actual Cs,drive100µW bound,startup and ppm calibration are not measured. Crystal pin1/3 active2/4GND matches package drawing. | https://abracon.com/Resonators/abm3b.pdf | Electrical specs; package drawing; DS9826§6.3.6
D-C08 | ["U1100"] | PASS | HSE8/PREDIV1 PLLx6=48MHz; FLASH1WS; RCC_CFGR3.USBSW=1 PLL USB and I2C1SW=1 SYSCLK are correct settings; implementation absent so runtime confirmation pending. | https://www.st.com/resource/en/reference_manual/rm0091-stm32f0x1stm32f0x2stm32f0x8-advanced-armbased-32bit-mcus-stmicroelectronics.pdf | RCC_CFGR3
D-C09 | ["U1100"] | PASS | TIM2 32bit,48MHz PSC0 ARR0xffffffff wrap89.4785s. CCMR1=0x0201 CH1direct/CH2indirect sameTI1; CCER0x31 rising/falling; DIER0x7. 10/30s tick count fits. Need CCR/overflow atomic extension and overcapture rejection in code. | https://www.st.com/resource/en/reference_manual/rm0091-stm32f0x1stm32f0x2stm32f0x8-advanced-armbased-32bit-mcus-stmicroelectronics.pdf | TIM2 input capture/register definitions
D-C10 | ["U1100", "U720"] | PASS | TIMINGR0x10941723 uses48MHz PCLK, PRESC1,SCLDEL9,SDADEL4,SCLH23,SCLL35. AFon/DNF0,tr<=300ns,tf<=100ns condition: lower SDADEL bound for INA SDA-address100ns hold87.5ns <configured166.7ns, minhold~179.2ns. SCLDEL416.7>=tr300+setup100; upper SDADEL256.7ns>166.7. Scope each segment required. | https://www.st.com/resource/en/reference_manual/rm0091-stm32f0x1stm32f0x2stm32f0x8-advanced-armbased-32bit-mcus-stmicroelectronics.pdf | I2C data setup/hold equations,§26.4.5
D-C11 | ["U830", "U1100"] | FAIL | Report generic Cbus<=161pF from2.2k/tr300ns cannot supersede ISO1641 side1 max80pF. Side1 must<=80pF; side2<=min400pF,RC161pF=161pF. Actual capacitance not known. | https://www.ti.com/lit/ds/symlink/iso1641.pdf | §6.3 C1/C2 recommended operating conditions
D-C12 | ["J1200", "R1200", "R1201"] | PASS | USB-C sink-only: both CC separate5.1k toUSB_GND; A6/B6DP and A7/B7DM joined; VBUS/GND duplicatepins same respective net, SBU NC; shield via0Ω USB_GND only. Full USB4105 actual footprint pad geometry must match manufacturer drawing. | https://gct.co/files/drawings/usb4105.pdf | USB4105 drawing
D-C13 | ["U1200", "C1200", "C1201", "C1202", "C1203", "C1204", "C1205"] | PASS | ADuM Table9 physical16pin matched. Host VBUS1=5V,VDD1internal3.3V bypass; board VBUS2=VDD2=CTRL3.3V regulator bypass correct. 100n at all four power terminals; host directcap1.1uF. No hostVBUS-boardrail conductive route. | https://www.analog.com/media/en/technical-documentation/data-sheets/ADuM4160.pdf | Table9; Power supply options; Figure5
D-C14 | ["U1200", "R1207", "U1100"] | PASS | PDEN/SPU hostVDD1 and SPD boardVDD2 high set fullspeed; PIN drivenMCU with100k pulldown delayedenumeration. Table10 missing either sidepower forces other side outputsHiZ/disconnect within32bittimes. MCU internal D+ pullup must enabled prior PIN attach; firmware not supplied. | https://www.analog.com/media/en/technical-documentation/data-sheets/ADuM4160.pdf | Table9/Table10
D-C15 | ["R1202", "R1203", "R1204", "R1205"] | PASS | 24Ω1% series D+/D− on both ADuM sides matches fullspeed requirement; not duplicated by extraMCU22Ω. Connector-side ESD before seriesresistors. | https://www.analog.com/media/en/technical-documentation/data-sheets/ADuM4160.pdf | PCB layout
D-C16 | ["U1201", "U1202", "U1203", "U1204"] | PASS | TPD2EUSB30DRT3 pin1D+2D−3GND matched; TPD1E10B06bidirectional2terminal toCC1/CC2/VBUS andUSB_GND supports5V USB. ESD itself is not continuousOVP; customlandpatterns absent so PCB release unresolved. ESD discharge layout not checked. | https://www.ti.com/lit/ds/symlink/tpd2eusb30.pdf | Table5-1; TPD1E10B06 application
D-C17 | ["U1300", "R1300", "R1301", "R1302", "R1303", "R1304", "R1305", "C1300", "C1301"] | PASS | AXC DCT8 pinmap matched; VCCA3.3/VCCB1.8,DIR tiedVCCA AtoB correct; eachsupply100n. A/B both10k pulldowns,47Ω outputseries. Ioff<=8µA atfulltemp gives<=80mV atB10k (DUTleak excluded). AXC datasheet explicitly glitchfreepowersequencing; no OEpin. | https://www.ti.com/lit/ds/symlink/sn74axc2t45.pdf | Table4-1;§5.5;§7.3.4/§7.3.6
D-C18 | ["J1400", "J1401", "J1402"] | PASS | Each rail adjacent GND. Negativeheader carriesVGL_DUT andsystemGND; GND_F never routedtoDUTconnector so intendedfloatingdomainnotshorted. VGL1/VGL2independent outputarchitecture unspecified; onecombinedVGLonly currently. | None | actualnets/header contract
D-C19 | ["D1500", "D1501", "D1502", "R1500", "R1501", "R1502"] | PASS | LED polarity Kpin1GND Apin2seriesresistor; AUX5Vgreen3.3k ~0.91mA atVF2V; MCU3.3Vgreen1.5k~0.87mA/red~1mA; farbelownormalGPIOdrivelimit. LEDpart/VFminmax actualMPN unknown so brightness未verified. | https://www.st.com/resource/en/datasheet/stm32f072cb.pdf | GPIO DC characteristics; actualpassivevalues
D-C20 | ["H1500", "H1501", "H1502", "H1503", "TP1500", "TP1507", "TP1508"] | UNVERIFIED | M3NPTHholesnoelectricalpins; USB_GND TP separated electrically fromGND. Physicalisolationslots,copperclearance,standoff/screwclearance/harnesspolarity/connector-keying requirePCB andassemblyreview. SWDprobe groundedPC bypassesUSB galvanicisolation viaPCGND whenbothconnected. | None | layout/systemconnection absent

## 향후 검토 에이전트의 작업 규칙

1. 입력 고정: 실제 .kicad_sch → 내보낸 netlist → BOM/연결 계약을 읽고 서로 다르면 우선 불일치로 기록한다. 보고서 숫자를 회로도 값으로 간주하지 않는다.
2. 의도 명시: 레일 전압, 정상·최대·기동·단락 전류, 측정 범위/정확도, 외부 장비 연결과 허용 power sequence를 먼저 정리한다. 없는 정보는 UNVERIFIED다.
3. 핀 전수 대조: package별 physical pin, EP, NC/DNC, power/GND, pull-up/down, 방향핀 및 boot state를 제조사 pin table과 비교한다.
4. 외장부품: divider, shunt, inductor, input/output/NR/SS/filter capacitor, TVS, termination의 값·공차·온도·정격·실효값과 실제 구매 MPN을 대조한다.
5. 상태별 검토: 정상 최대부하, 모든 rail off, 부분전원, startup/shutdown, hot-plug, load removal, 단락, 외부 역급전, MCU reset을 구분한다.
6. 오차·보호 계산: ADC fullscale, offset/bias, burden, gain/tare/temp drift, rail headroom, capacitor/inrush, SOA/열, surge response를 계산한다. typ 값으로 max 보증을 선언하지 않는다.
7. 문서·펌웨어 동기화: 실제 션트 → CURRENT_LSB/SHUNT_CAL/ALERT threshold, 실제 clock → timer/I2C timing, actual EN/PG → sequence를 자동 대조한다.
8. 출력 계약: 모든 지적에 Ref·pin/net·실제값·제조사 문서 section·계산·심각도·수정안·닫힘 조건을 기록한다. 확인된 오류와 가설을 섞지 않는다.
9. 역검토: 다른 검토자는 지적의 근거와 권장 수정 자체의 부작용도 확인한다. 전원 필터/부동 ground 같은 항목은 한 문장만으로 고장 확정하지 않는다.
10. 종료 조건: 확정 오류 수정→새 netlist 대조/ERC→변경 항목 재검토. 실측이 필요한 항목은 시험조건·합격 기준을 남기고 전체 PASS로 덮지 않는다.

이 규칙은 이번 검토에 사용한 작업 기준이다. 상시 실행되는 자동 에이전트나 개인 플러그인을 설치했다는 의미는 아니다.
