Gugong0412/currentboard/history/README.md

# 변경 이력 및 보존 기록

과거 의사결정과 검증 경과를 보존합니다. 현재 설계는 `R2_REPAIRED_006`입니다. 이곳의 과거 채널 수·경로·미검증 문구는 당시 기록이며 최신 설계 지시가 아닙니다.

| 단계 | 기록 | 결과 |
|---|---|---|
| 초기 요구사항 | [requirements](requirements/) | 사용자 요구사항과 단계별 설계 프롬프트 원문 |
| R1 | [R1](R1/) | 독립 검토, PCB 착수 전 인수 문서, 과거 검증 요약 |
| R2 인수 | [R2_HANDOFF](R2_HANDOFF/) | 승인된 12채널 구조, 원본 63개 해시, 시작 지침 |
| R2 최초 로컬 검증 | [R2_VERIFY_002](R2_VERIFY_002/) | Value 5건, 라이브러리 보완 후 ERC 경고 8건 발견 |
| R2 표기·라벨·USB 수정 | [R2_FIX_003](R2_FIX_003/) | Value 5건, 이전 라벨 7건, J1200 풋프린트 수정; 8,445개 통과 |
| R2 ALERT 수정 | [최종 보고서](../R2_ALERT_REPORTS_005/RESULT_KO.txt) | AVDDH2 S/O·VGH1 ALERT 연결; 8,437개 통과; VGL polling 유지 |
| HTML 추가·브랜치 정리 | [정리 manifest](CLEANUP_MANIFEST_2026-10-16.json) | 제거 경로·보존 문서 대응·SHA256 |

## 주요 변경

- **2026-10-15 · 7d491da:** Value·라벨·J1200 수정본과 전후 검증 증거 업로드.
- **2026-10-15 · 3569bfe:** AVDDH2 S/O ALERT → PB3, VGH1 ALERT → PB4 복구. MCU 2핀과 대응 TP 2핀 외 연결 유지. VGL1·2 polling 유지.
- **2026-10-16 · 이번 정리:** 독립 실행 HTML 추가. 전원 흐름/전원 생성/MCU·ALERT/채널 표, 상세 선택·확대 기능 제공. 최종 프로젝트 바이트 변경 없이 중복·구버전 자료를 현재 브랜치에서 정리.

## 보존·복구

과거 문서·요구사항·변경 manifest·검증 요약·로그를 원문 바이트 그대로 복사했습니다. 재검증 도구는 [`tools/r2`](../tools/r2/)에 있습니다.

이력의 `repair_*.py`, `finalize.py`는 당시 절차 기록입니다. 현재 폴더 배치에서 다시 실행하는 도구가 아닙니다. 과거 환경 재현은 `3569bfe`를 별도 체크아웃하세요. 과거 문서의 경로도 당시 트리를 기준으로 합니다.

구버전 회로도·넷리스트·HTML·ZIP은 이전 커밋에 남아 있습니다. 로컬에서도 삭제하지 않고 Git 추적만 해제했으며 `.gitignore`로 재업로드를 방지했습니다. 최초 인수 원본 63개와 이전 수정본의 로컬 파일을 보존했습니다.

정리 manifest의 `removed_from_current_tree`는 현재 브랜치에서 제거한 경로, `preserved_records`는 새 위치와 원문 해시입니다. 제작 HOLD는 유지합니다.

## 2026-10-20 · VDDI 실장 표시 정정 및 전체 블록 해설

`R2_REPAIRED_006`은 005를 복사한 작업본입니다. R525의 Value를 `0R [DNP]`, R526을 `0R`로 변경해 기존 DNP 플래그·Population·BOM과 맞췄습니다. VDDI는 SRC 전단 피드백을 유지합니다. 변경된 회로 파일은 B5_VDDI.kicad_sch 하나이며 배선·BOM·펌웨어·12채널 및 VGL polling은 동일합니다.

[새 검증](../R2_FIX_REPORTS_006/native/verification_summary.json): KiCad 10.0.7, 8,437개 검사, 36시트 ERC 위반 0건. [변경 감사](../R2_FIX_REPORTS_006/change_audit.json)에 이전 65개 파일 해시와 전체 핀-넷 동일 결과를 기록했습니다. 기존 ERC 설정을 유지했고 제작 HOLD는 해제하지 않았습니다.

[B1~B15 탭형 해설](../R2_BLOCK_GUIDE/ALL_BLOCKS_GUIDE.html)을 추가했습니다. VDDI·LPDP·OSC 공통 공급원은 U520/VDDI_SRC이며 DIG/U500과 별개임을 해설에도 바로잡았습니다.

## 2026-10-20 · B1 기준으로 B2–B15 도식 및 해설 재작성

승인된 B1 문서를 보존하고 나머지 블록의 자동 핀–넷 그래프를 실제 소자 기호와 회로별 배선으로 구성한 33개 도식으로 교체했습니다. 기능 흐름과 각 R·C의 연결·값 해석·변경 영향을 추가했습니다. 근거가 없는 선정 의도는 확정하지 않고 조건부 계산과 미확인 자료를 표시했습니다. B9 미확정 상태, 12채널, VGL1·2 polling을 유지합니다.

회로·BOM·펌웨어 파일 변경은 없습니다. 기존 006 입력 65개 파일 해시와 1,035개 핀 연결을 대조했습니다. 도식의 부품·단자·넷, 배선 겹침, 글자 겹침·잘림, 15개 탭과 검색·확대·모바일 표시를 검사했습니다. 이 개정에서 ERC를 다시 실행한 것은 아니며 전기 검증 결과는 기존 006 보고서입니다. 웹 게시본은 동일한 통합 HTML을 사용합니다.
