Gugong0412/currentboard/history/R2_FIX_003/native_final/SUMMARY.txt

Status: SCHEMATIC_CHECKS_PASS_HARDWARE_HOLD
Checks: 8445
Issues: 0
Production: HOLD
