Gugong0412/currentboard/(list of files, drawings)

Other design files:
R2_BLOCK_GUIDE/SCHEMATIC_DRAWING_AUDIT.json
R2_REPAIRED_006/schematic_additions.json
