Gugong0412/currentboard/R2_REPAIRED_006/B1.kicad_sch

## KiCad design R2_REPAIRED_006/B1.kicad_sch (2026-10-15)

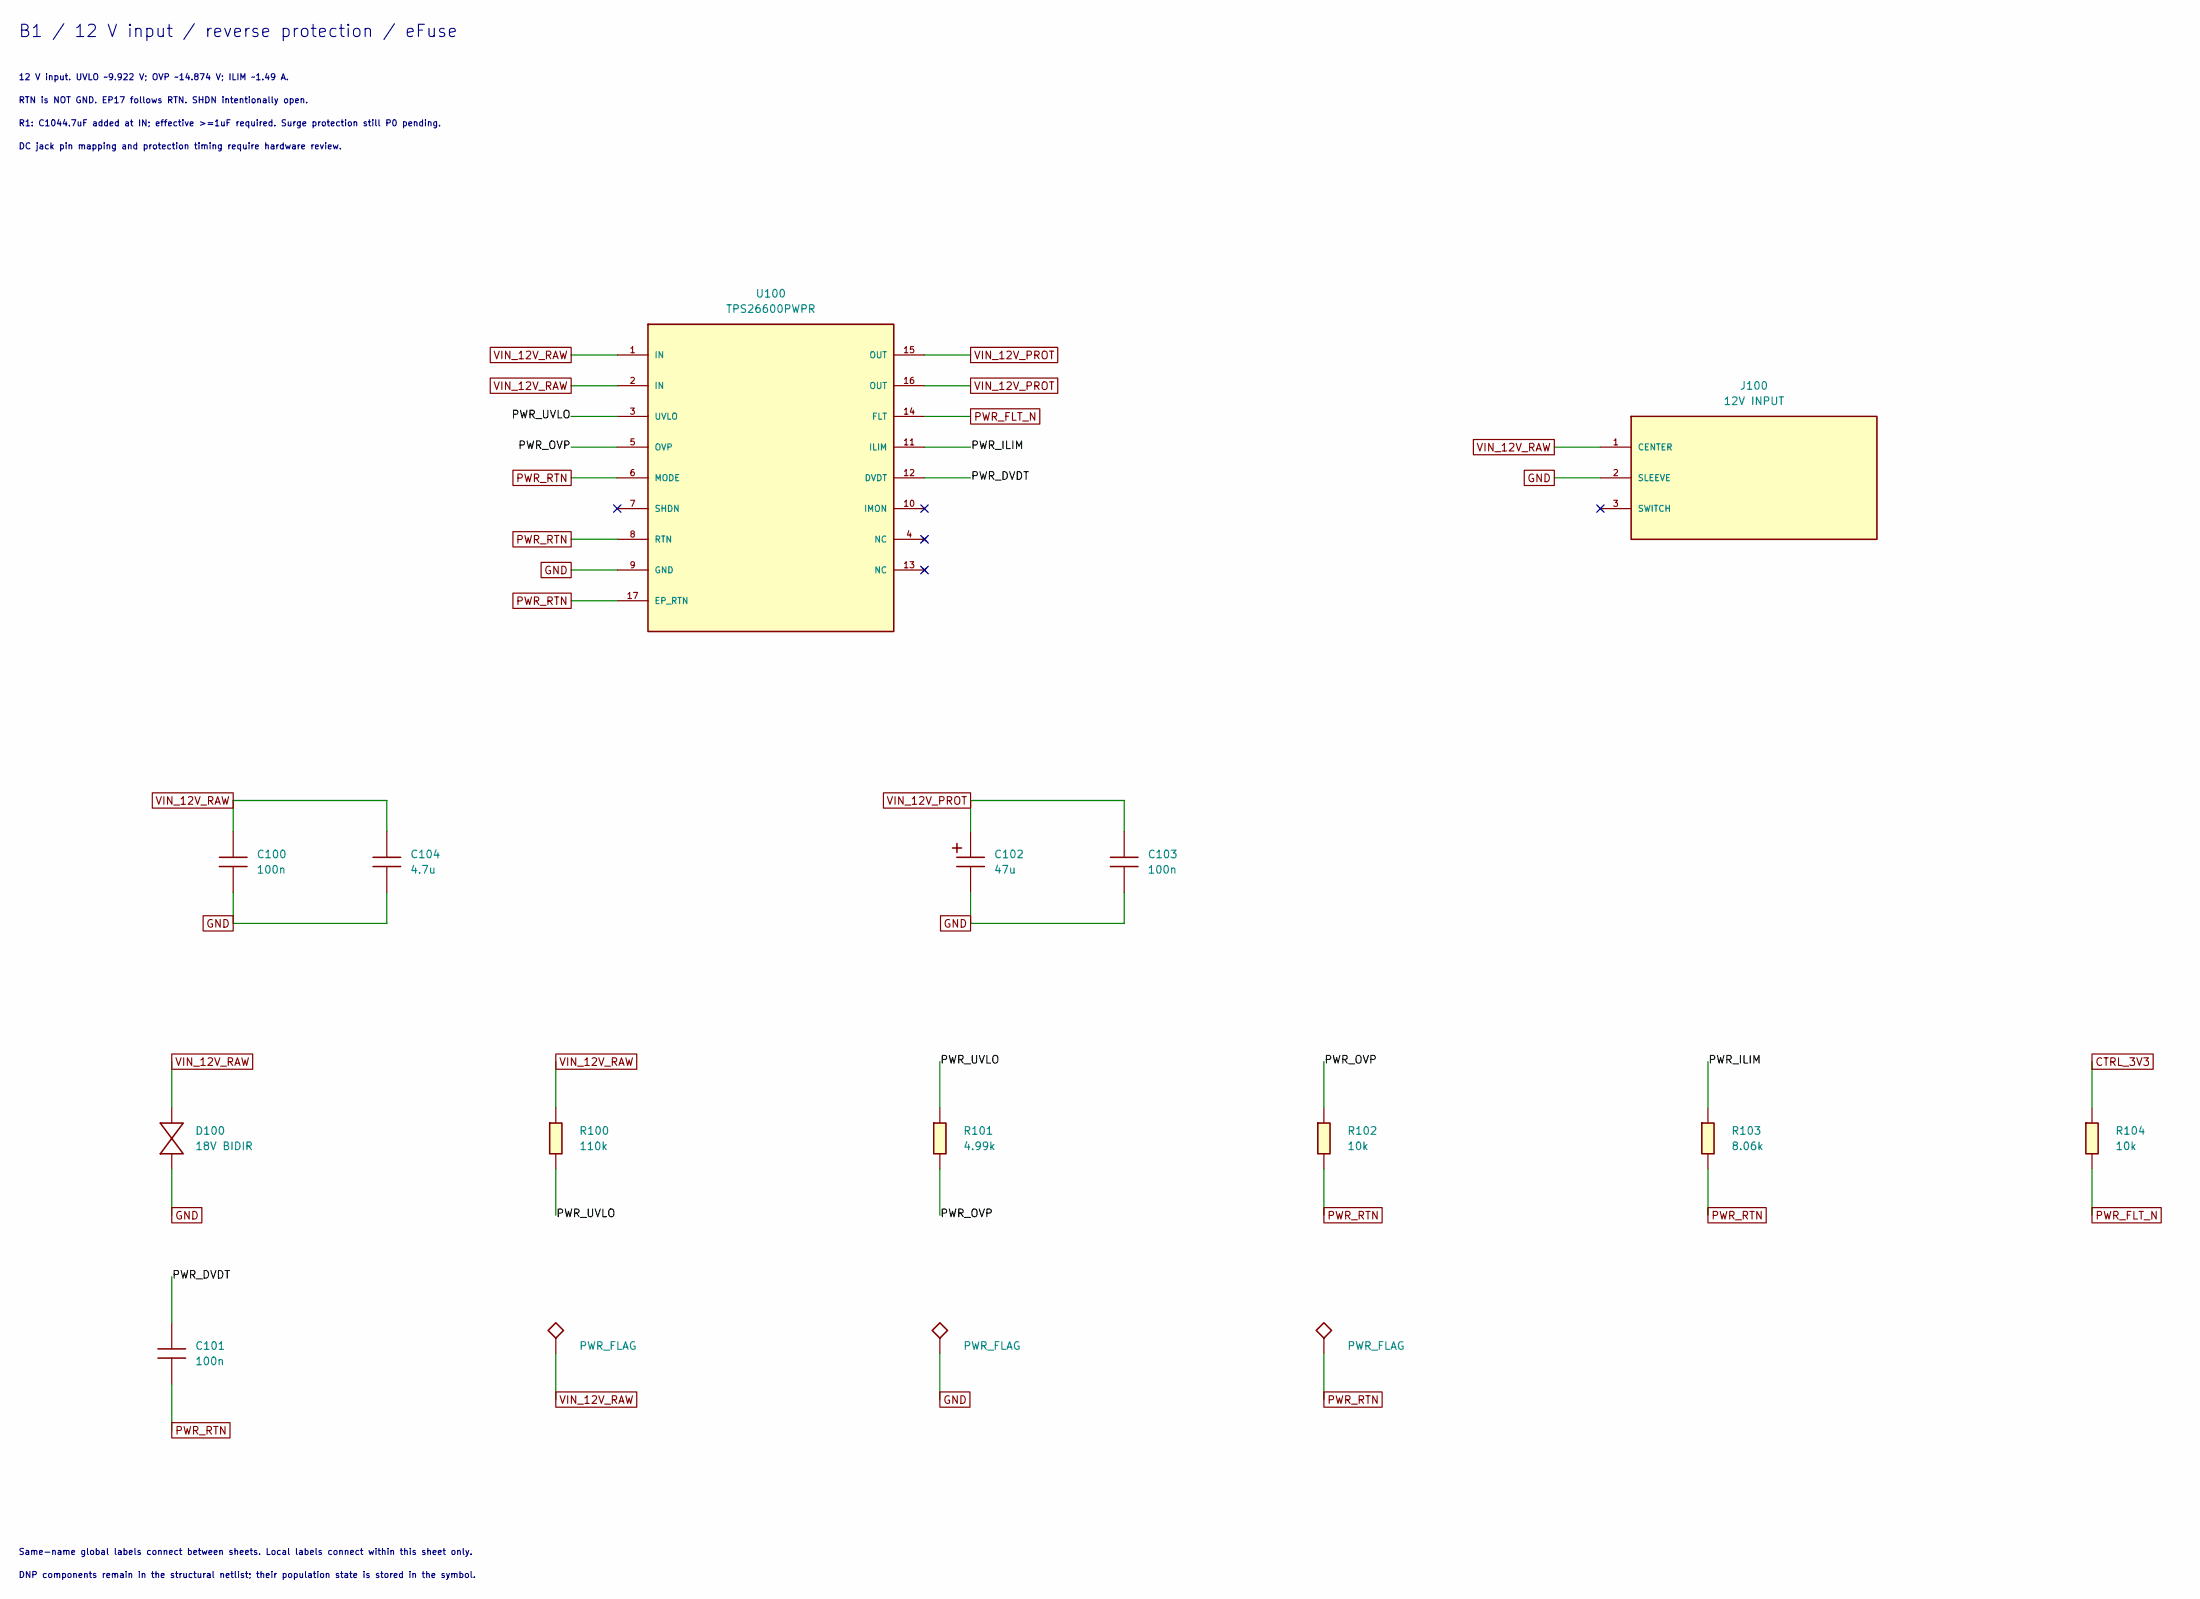
[picture p1: schematic B1.kicad_sch]

Parts:
C100, C103: 100n; C_0603_1608Metric; Rating 50V X7R ±10%; MPN 확인 필요: 유효용량·누설 검증 후 선정
C101: 100n; C_0603_1608Metric; Rating 25V X7R ±10%; MPN 확인 필요: 유효용량·누설 검증 후 선정
C102: 47u; Rating 35V ≥47µF ±20%; ripple/ESR 확인; MPN 확인 필요: 35V low-ESR
C104: 4.7u; C_1210_3225Metric; Rating 50V X7R ±20%; actual DC/temperature/tol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; MPN 확인 필요: 4.7µF/50V/X7R/1210 유효≥1µF
D100: 18V BIDIR; D_SMB; Rating VRWM18V, Vclamp29.2V@정격pulse,600W pulse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; MPN SMBJ18CA
J100: 12V INPUT; BarrelJack_CUI_PJ-102AH_Horizontal; Rating 24V/5A 후보; mating plug 및 제조사 도면 확인; MPN PJ-102AH
R100: 110k; R_0603_1608Metric; Rating 0.1%, ≤25ppm/°C, ≥0.1W, ≥25V; MPN 확인 필요: 지정값·정격 구매품
R101: 4.99k; R_0603_1608Metric; Rating 0.1%, ≤25ppm/°C, ≥0.1W, ≥25V; MPN 확인 필요: 지정값·정격 구매품
R102: 10k; R_0603_1608Metric; Rating 0.1%, ≤25ppm/°C, ≥0.1W, ≥25V; MPN 확인 필요: 지정값·정격 구매품
R103: 8.06k; R_0603_1608Metric; Rating 1%, ≥0.1W, ≥50V; MPN 확인 필요: 지정값·정격 구매품
R104: 10k; R_0603_1608Metric; Rating 1%, ≥0.1W, ≥50V; MPN 확인 필요: 지정값·정격 구매품
U100: TPS26600PWPR; Rating 4.2~60V; current limit 설정 약1.49A; PWP 패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; MPN TPS26600PWPR

Connections:
CTRL_3V3: R104.1
GND: C100.2, C102.2 (-), C103.2, C104.2, D100.2 (A2), J100.2 (SLEEVE), U100.9 (GND)
PWR_DVDT: C101.1, U100.12 (DVDT)
PWR_FLT_N: R104.2, U100.14 (FLT)
PWR_ILIM: R103.1, U100.11 (ILIM)
PWR_OVP: R101.2, R102.1, U100.5 (OVP)
PWR_RTN: C101.2, R102.2, R103.2, U100.6 (MODE), U100.8 (RTN), U100.17 (EP_RTN)
PWR_UVLO: R100.2, R101.1, U100.3 (UVLO)
VIN_12V_PROT: C102.1 (+), C103.1, U100.15 (OUT), U100.16 (OUT)
VIN_12V_RAW: C100.1, C104.1, D100.1 (A1), J100.1 (CENTER), R100.1, U100.1 (IN), U100.2 (IN)

Notes on the sheet:
B1 / 12 V input / reverse protection / eFuse
12 V input. UVLO ~9.922 V; OVP ~14.874 V; ILIM ~1.49 A.
RTN is NOT GND. EP17 follows RTN. SHDN intentionally open.
R1: C1044.7uF added at IN; effective >=1uF required. Surge protection still P0 pending.
DC jack pin mapping and protection timing require hardware review.
Same-name global labels connect between sheets. Local labels connect within this sheet only.
DNP components remain in the structural netlist; their population state is stored in the symbol.
