Gugong0412/currentboard/R2_REPAIRED_006/B2.kicad_sch

## KiCad design R2_REPAIRED_006/B2.kicad_sch (2026-10-15)

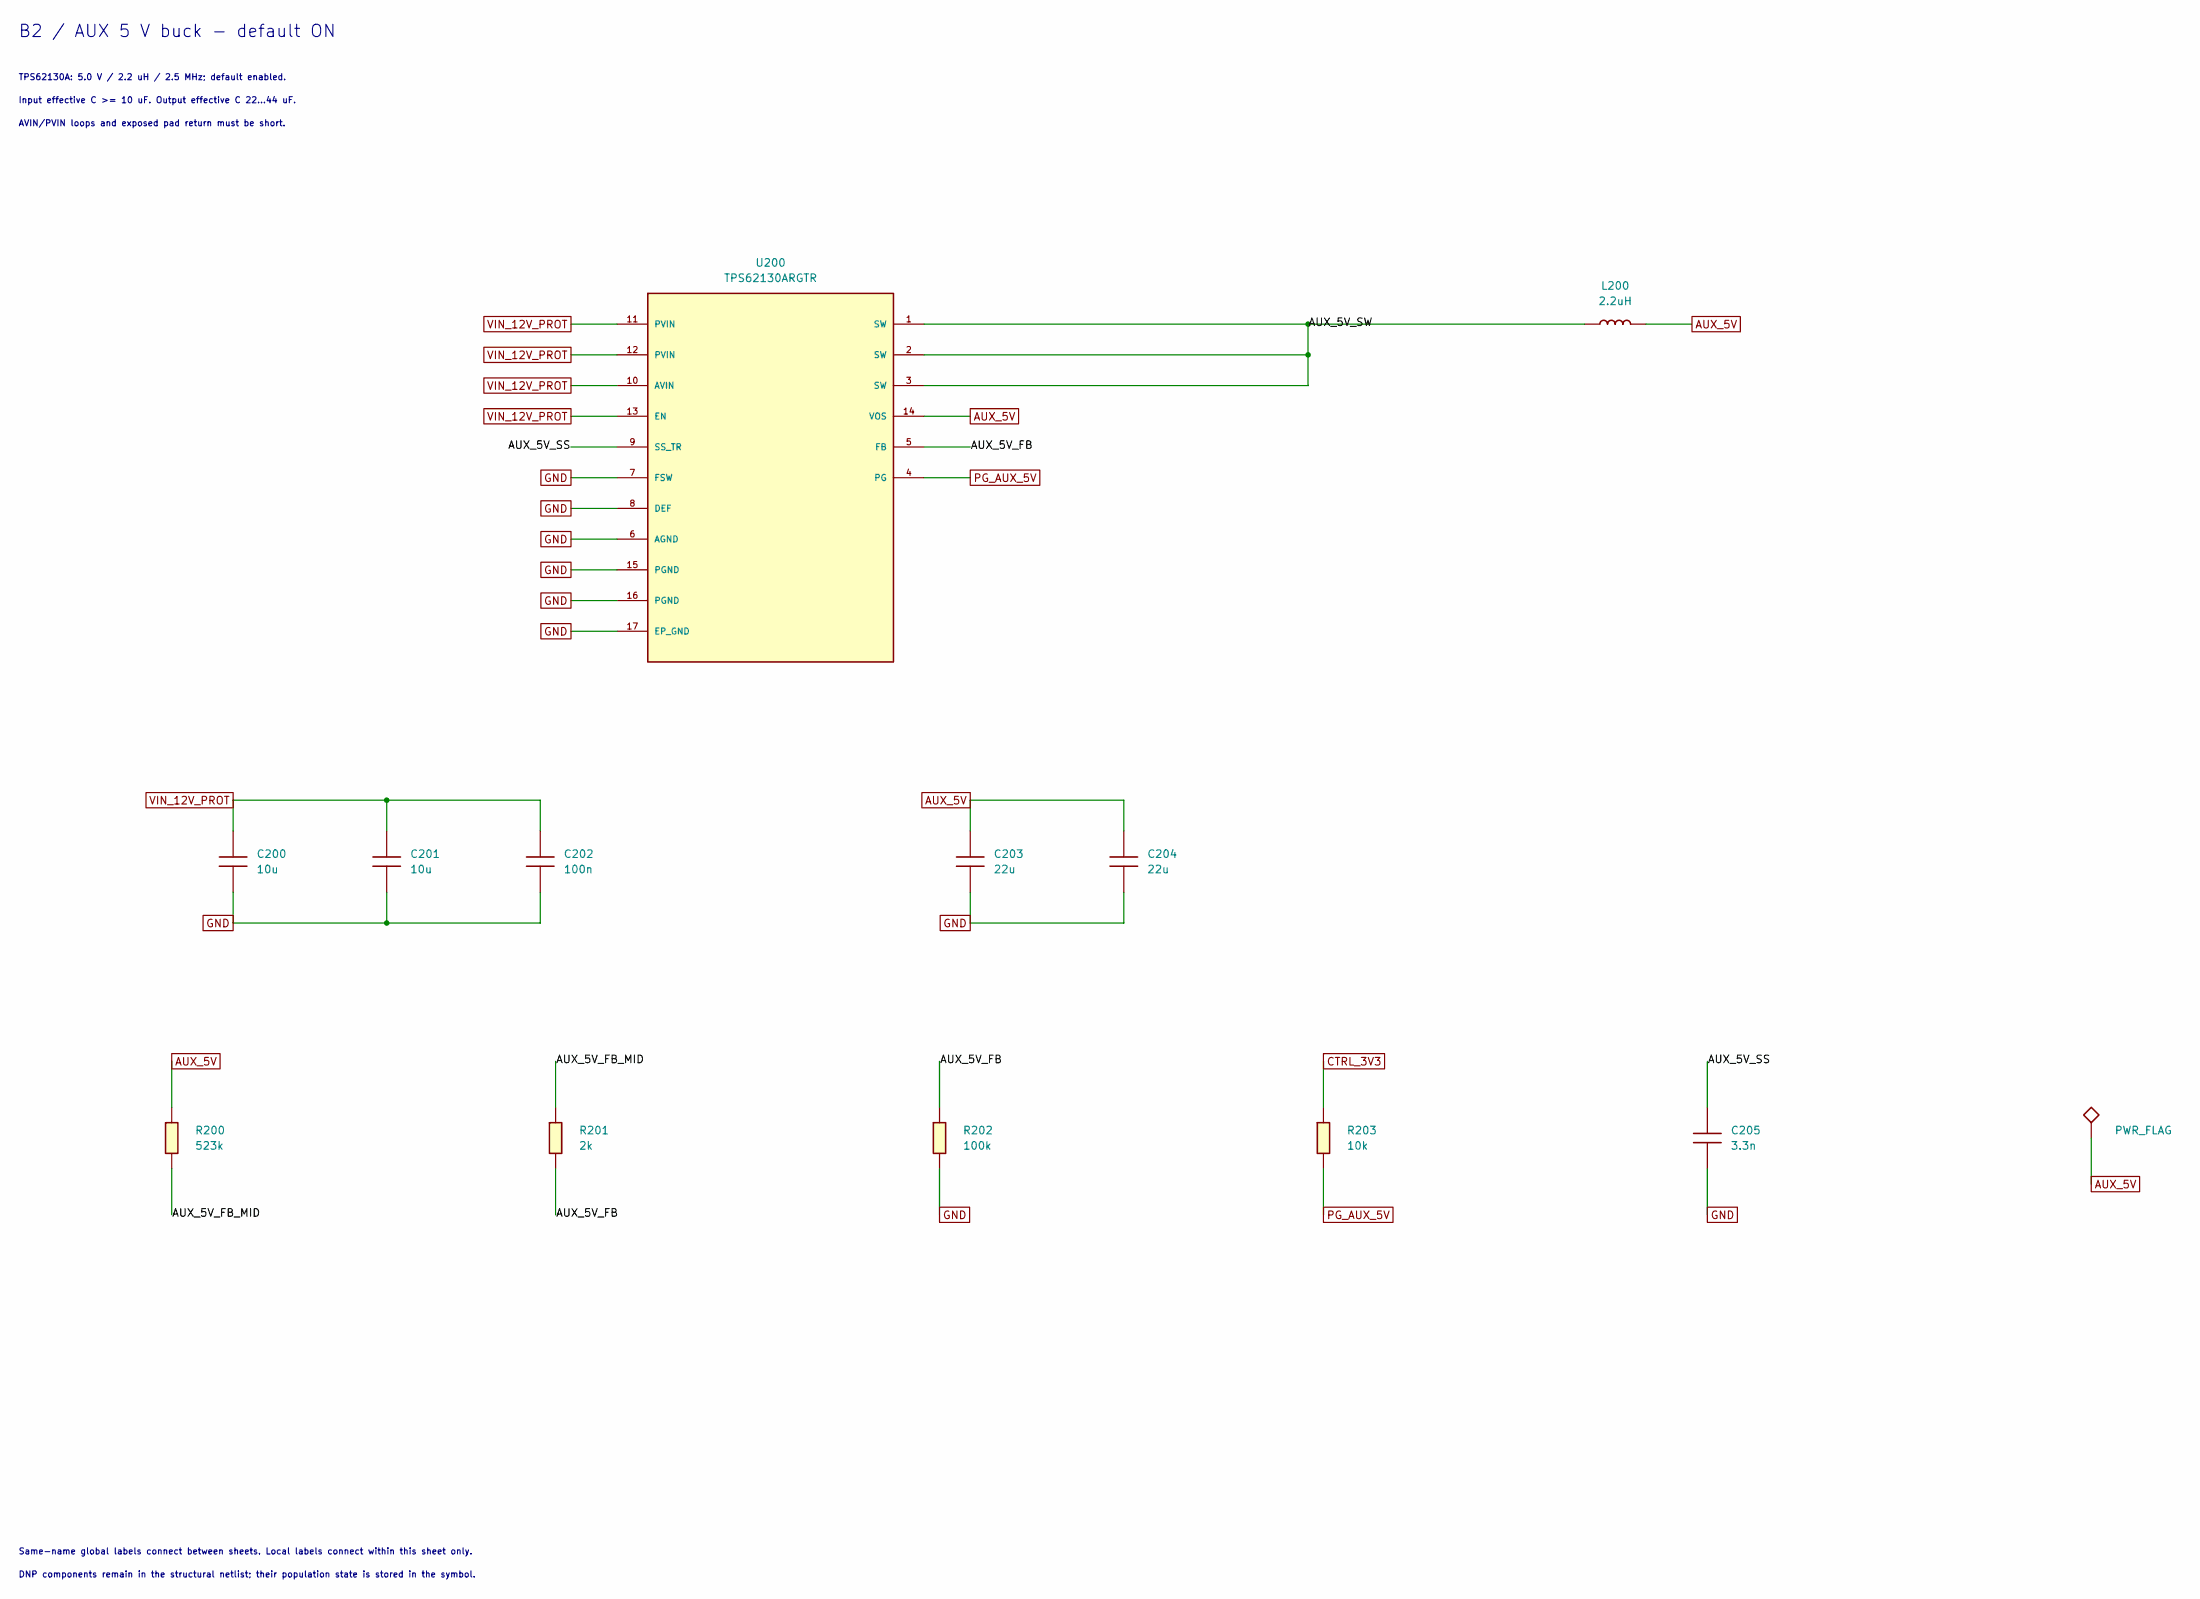
[picture p2: schematic B2.kicad_sch]

Parts:
C200, C201: 10u; C_1210_3225Metric; Rating 50V X7R ±10%; MPN 확인 필요: 유효용량·누설 검증 후 선정
C202: 100n; C_0603_1608Metric; Rating 50V X7R ±10%; MPN 확인 필요: 유효용량·누설 검증 후 선정
C203, C204: 22u; C_1210_3225Metric; Rating 16V X7R ±10%; MPN 확인 필요: 유효용량·누설 검증 후 선정
C205: 3.3n; C_0603_1608Metric; Rating 25V C0G ±5%; MPN 확인 필요: 유효용량·누설 검증 후 선정
L200: 2.2uH; Rating ±20%; current/Isat·DCR 공식선정표 대조; MPN XFL4020-222MEC
R200: 523k; R_0603_1608Metric; Rating 0.1%, ≤25ppm/°C, ≥0.1W, ≥25V; MPN 확인 필요: 지정값·정격 구매품
R201: 2k; R_0603_1608Metric; Rating 0.1%, ≤25ppm/°C, ≥0.1W, ≥25V; MPN 확인 필요: 지정값·정격 구매품
R202: 100k; R_0603_1608Metric; Rating 0.1%, ≤25ppm/°C, ≥0.1W, ≥25V; MPN 확인 필요: 지정값·정격 구매품
R203: 10k; R_0603_1608Metric; Rating 1%, ≥0.1W, ≥50V; MPN 확인 필요: 지정값·정격 구매품
U200: TPS62130ARGTR; VQFN-16-1EP_3x3mm_P0.5mm_EP1.68x1.68mm_ThermalVias; Rating 데이터시트 운용범위 적용; MPN TPS62130ARGTR

Connections:
AUX_5V: C203.1, C204.1, L200.2, R200.1, U200.14 (VOS)
AUX_5V_FB: R201.2, R202.1, U200.5 (FB)
AUX_5V_FB_MID: R200.2, R201.1
AUX_5V_SS: C205.1, U200.9 (SS_TR)
AUX_5V_SW: L200.1, U200.1 (SW), U200.2 (SW), U200.3 (SW)
CTRL_3V3: R203.1
GND: C200.2, C201.2, C202.2, C203.2, C204.2, C205.2, R202.2, U200.6 (AGND), U200.7 (FSW), U200.8 (DEF), U200.15 (PGND), U200.16 (PGND), U200.17 (EP_GND)
PG_AUX_5V: R203.2, U200.4 (PG)
VIN_12V_PROT: C200.1, C201.1, C202.1, U200.10 (AVIN), U200.11 (PVIN), U200.12 (PVIN), U200.13 (EN)

Notes on the sheet:
B2 / AUX 5 V buck - default ON
TPS62130A: 5.0 V / 2.2 uH / 2.5 MHz; default enabled.
Input effective C >= 10 uF. Output effective C 22...44 uF.
AVIN/PVIN loops and exposed pad return must be short.
Same-name global labels connect between sheets. Local labels connect within this sheet only.
DNP components remain in the structural netlist; their population state is stored in the symbol.
