Gugong0412/currentboard/R2_REPAIRED_006/B3.kicad_sch

## KiCad design R2_REPAIRED_006/B3.kicad_sch (2026-10-15)

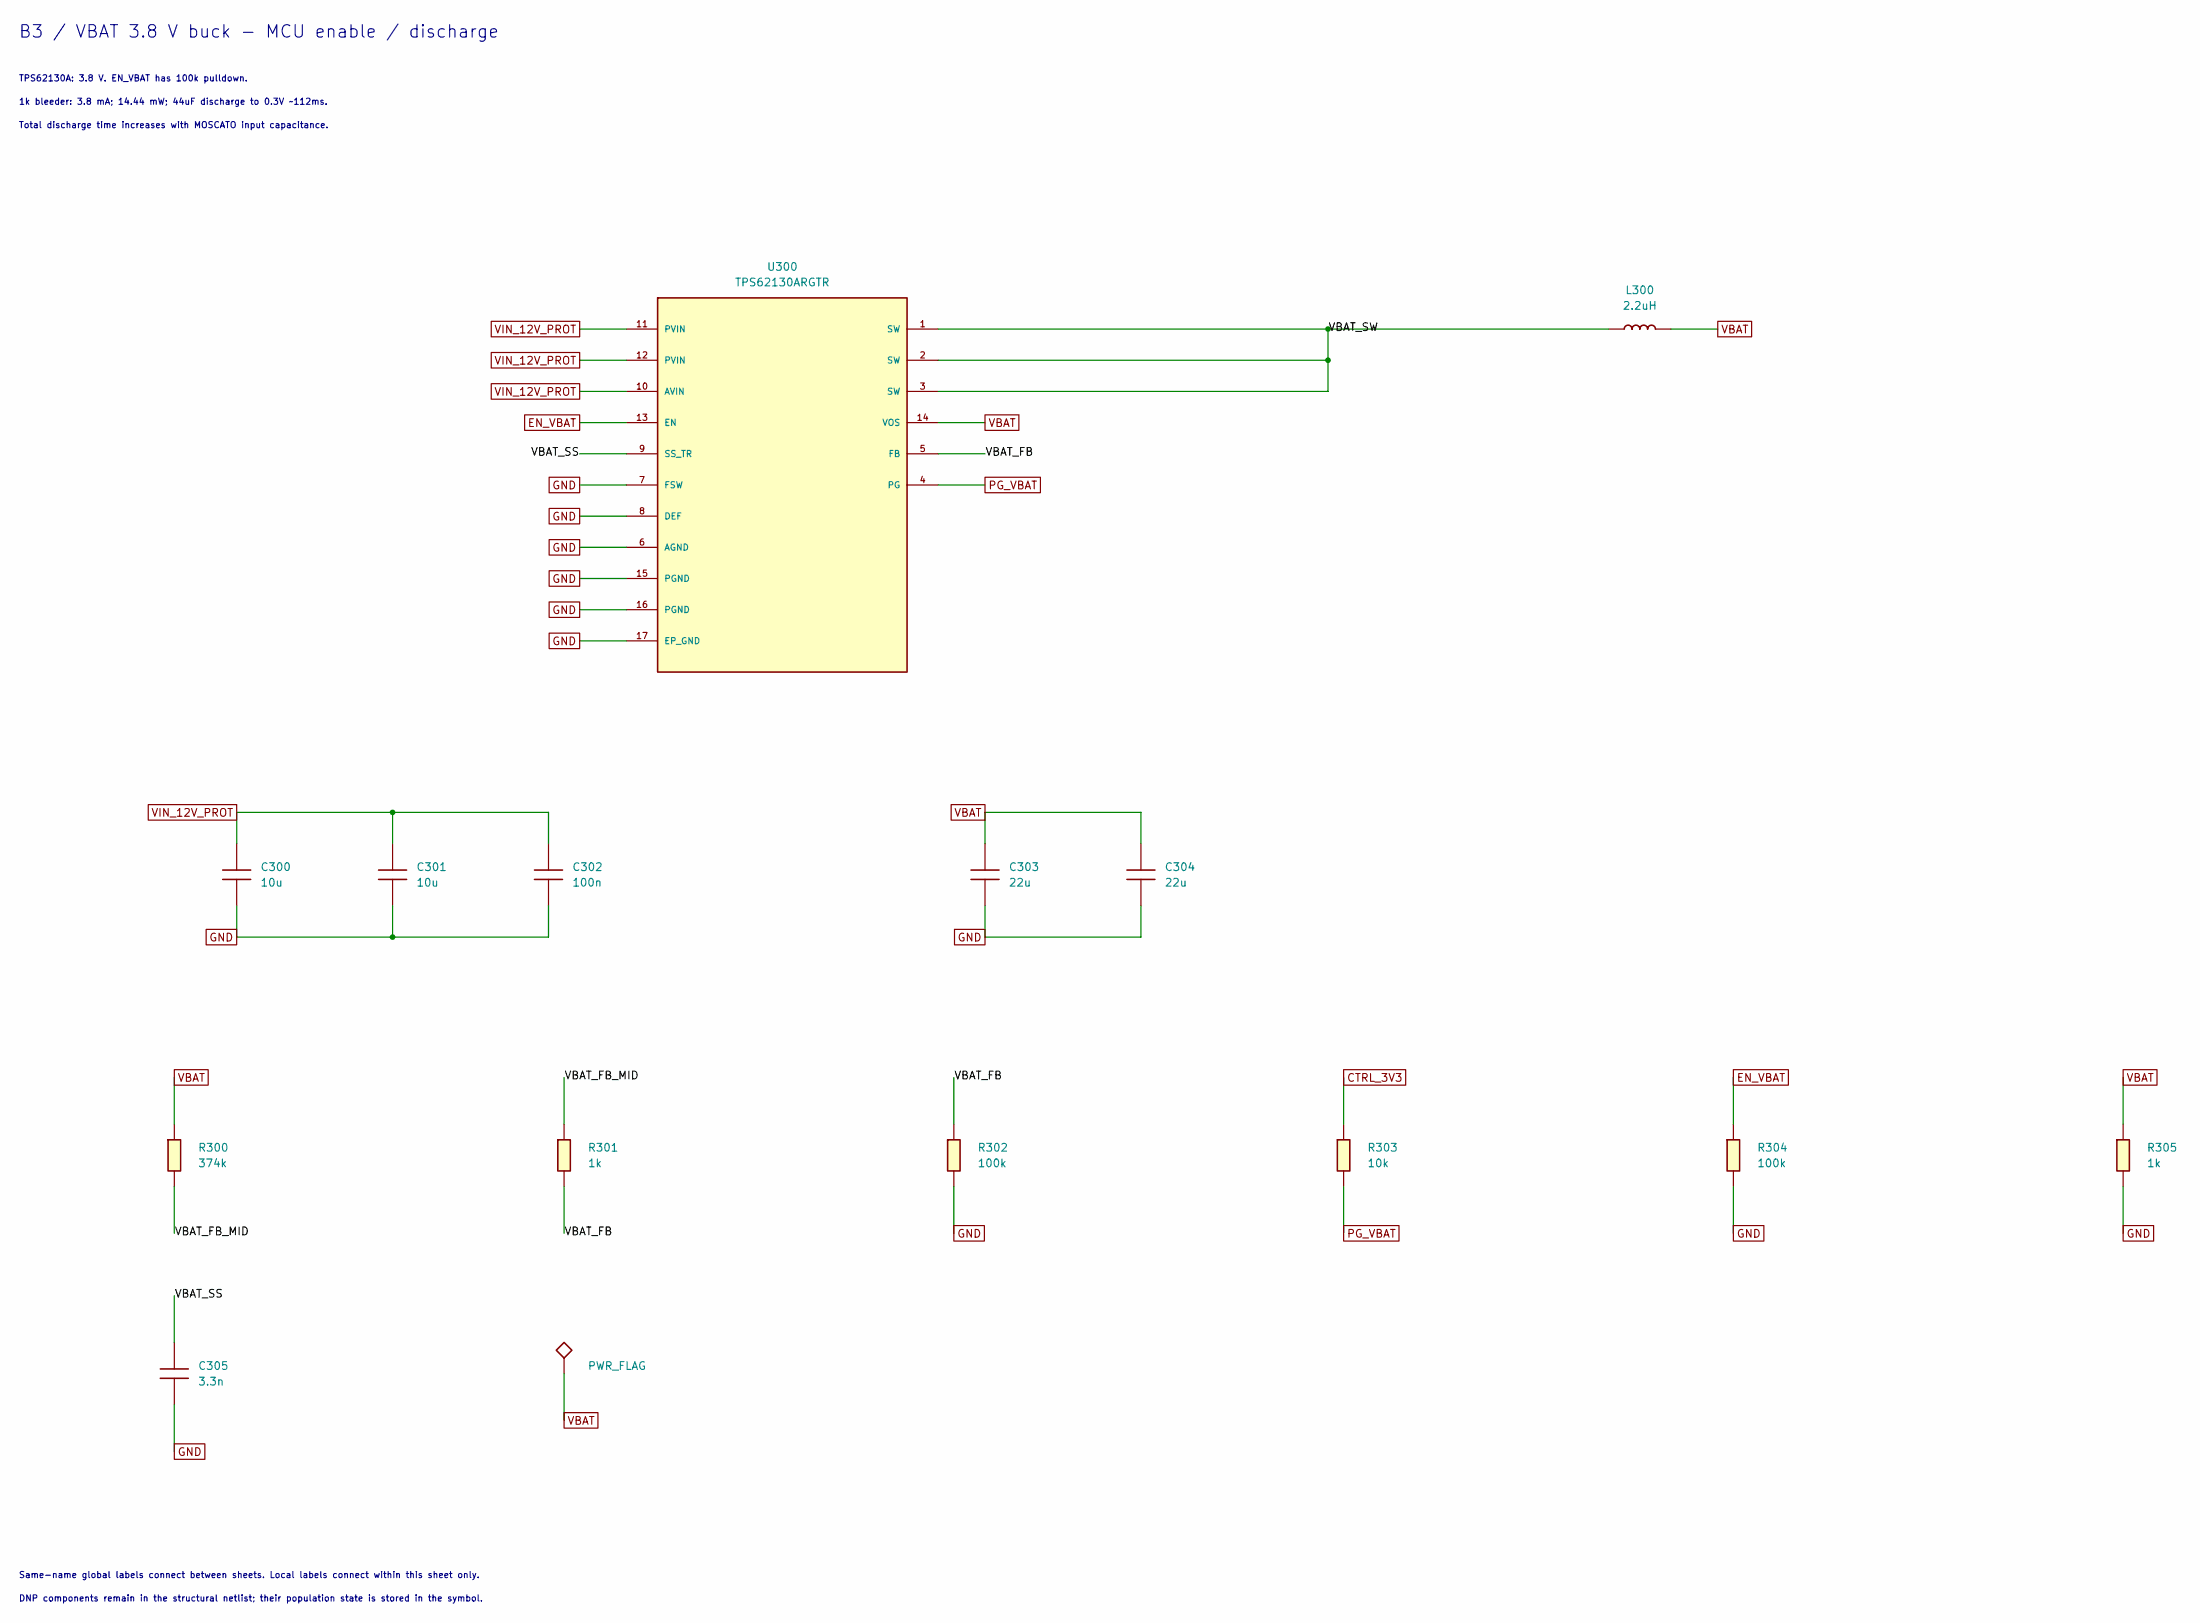
[picture p3: schematic B3.kicad_sch]

Parts:
C300, C301: 10u; C_1210_3225Metric; Rating 50V X7R ±10%; MPN 확인 필요: 유효용량·누설 검증 후 선정
C302: 100n; C_0603_1608Metric; Rating 50V X7R ±10%; MPN 확인 필요: 유효용량·누설 검증 후 선정
C303, C304: 22u; C_1210_3225Metric; Rating 16V X7R ±10%; MPN 확인 필요: 유효용량·누설 검증 후 선정
C305: 3.3n; C_0603_1608Metric; Rating 25V C0G ±5%; MPN 확인 필요: 유효용량·누설 검증 후 선정
L300: 2.2uH; Rating ±20%; current/Isat·DCR 공식선정표 대조; MPN XFL4020-222MEC
R300: 374k; R_0603_1608Metric; Rating 0.1%, ≤25ppm/°C, ≥0.1W, ≥25V; MPN 확인 필요: 지정값·정격 구매품
R301: 1k; R_0603_1608Metric; Rating 0.1%, ≤25ppm/°C, ≥0.1W, ≥25V; MPN 확인 필요: 지정값·정격 구매품
R302: 100k; R_0603_1608Metric; Rating 0.1%, ≤25ppm/°C, ≥0.1W, ≥25V; MPN 확인 필요: 지정값·정격 구매품
R303: 10k; R_0603_1608Metric; Rating 1%, ≥0.1W, ≥50V; MPN 확인 필요: 지정값·정격 구매품
R304: 100k; R_0603_1608Metric; Rating 1%, ≥0.1W, ≥50V; MPN 확인 필요: 지정값·정격 구매품
R305: 1k; R_0603_1608Metric; Rating 1%, ≥0.1W, ≥50V; MPN 확인 필요: 지정값·정격 구매품
U300: TPS62130ARGTR; VQFN-16-1EP_3x3mm_P0.5mm_EP1.68x1.68mm_ThermalVias; Rating 데이터시트 운용범위 적용; MPN TPS62130ARGTR

Connections:
CTRL_3V3: R303.1
EN_VBAT: R304.1, U300.13 (EN)
GND: C300.2, C301.2, C302.2, C303.2, C304.2, C305.2, R302.2, R304.2, R305.2, U300.6 (AGND), U300.7 (FSW), U300.8 (DEF), U300.15 (PGND), U300.16 (PGND), U300.17 (EP_GND)
PG_VBAT: R303.2, U300.4 (PG)
VBAT: C303.1, C304.1, L300.2, R300.1, R305.1, U300.14 (VOS)
VBAT_FB: R301.2, R302.1, U300.5 (FB)
VBAT_FB_MID: R300.2, R301.1
VBAT_SS: C305.1, U300.9 (SS_TR)
VBAT_SW: L300.1, U300.1 (SW), U300.2 (SW), U300.3 (SW)
VIN_12V_PROT: C300.1, C301.1, C302.1, U300.10 (AVIN), U300.11 (PVIN), U300.12 (PVIN)

Notes on the sheet:
B3 / VBAT 3.8 V buck - MCU enable / discharge
TPS62130A: 3.8 V. EN_VBAT has 100k pulldown.
1k bleeder: 3.8 mA; 14.44 mW; 44uF discharge to 0.3V ~112ms.
Total discharge time increases with MOSCATO input capacitance.
Same-name global labels connect between sheets. Local labels connect within this sheet only.
DNP components remain in the structural netlist; their population state is stored in the symbol.
