Gugong0412/currentboard/R2_REPAIRED_006/B4.kicad_sch

## KiCad design R2_REPAIRED_006/B4.kicad_sch (2026-10-15)

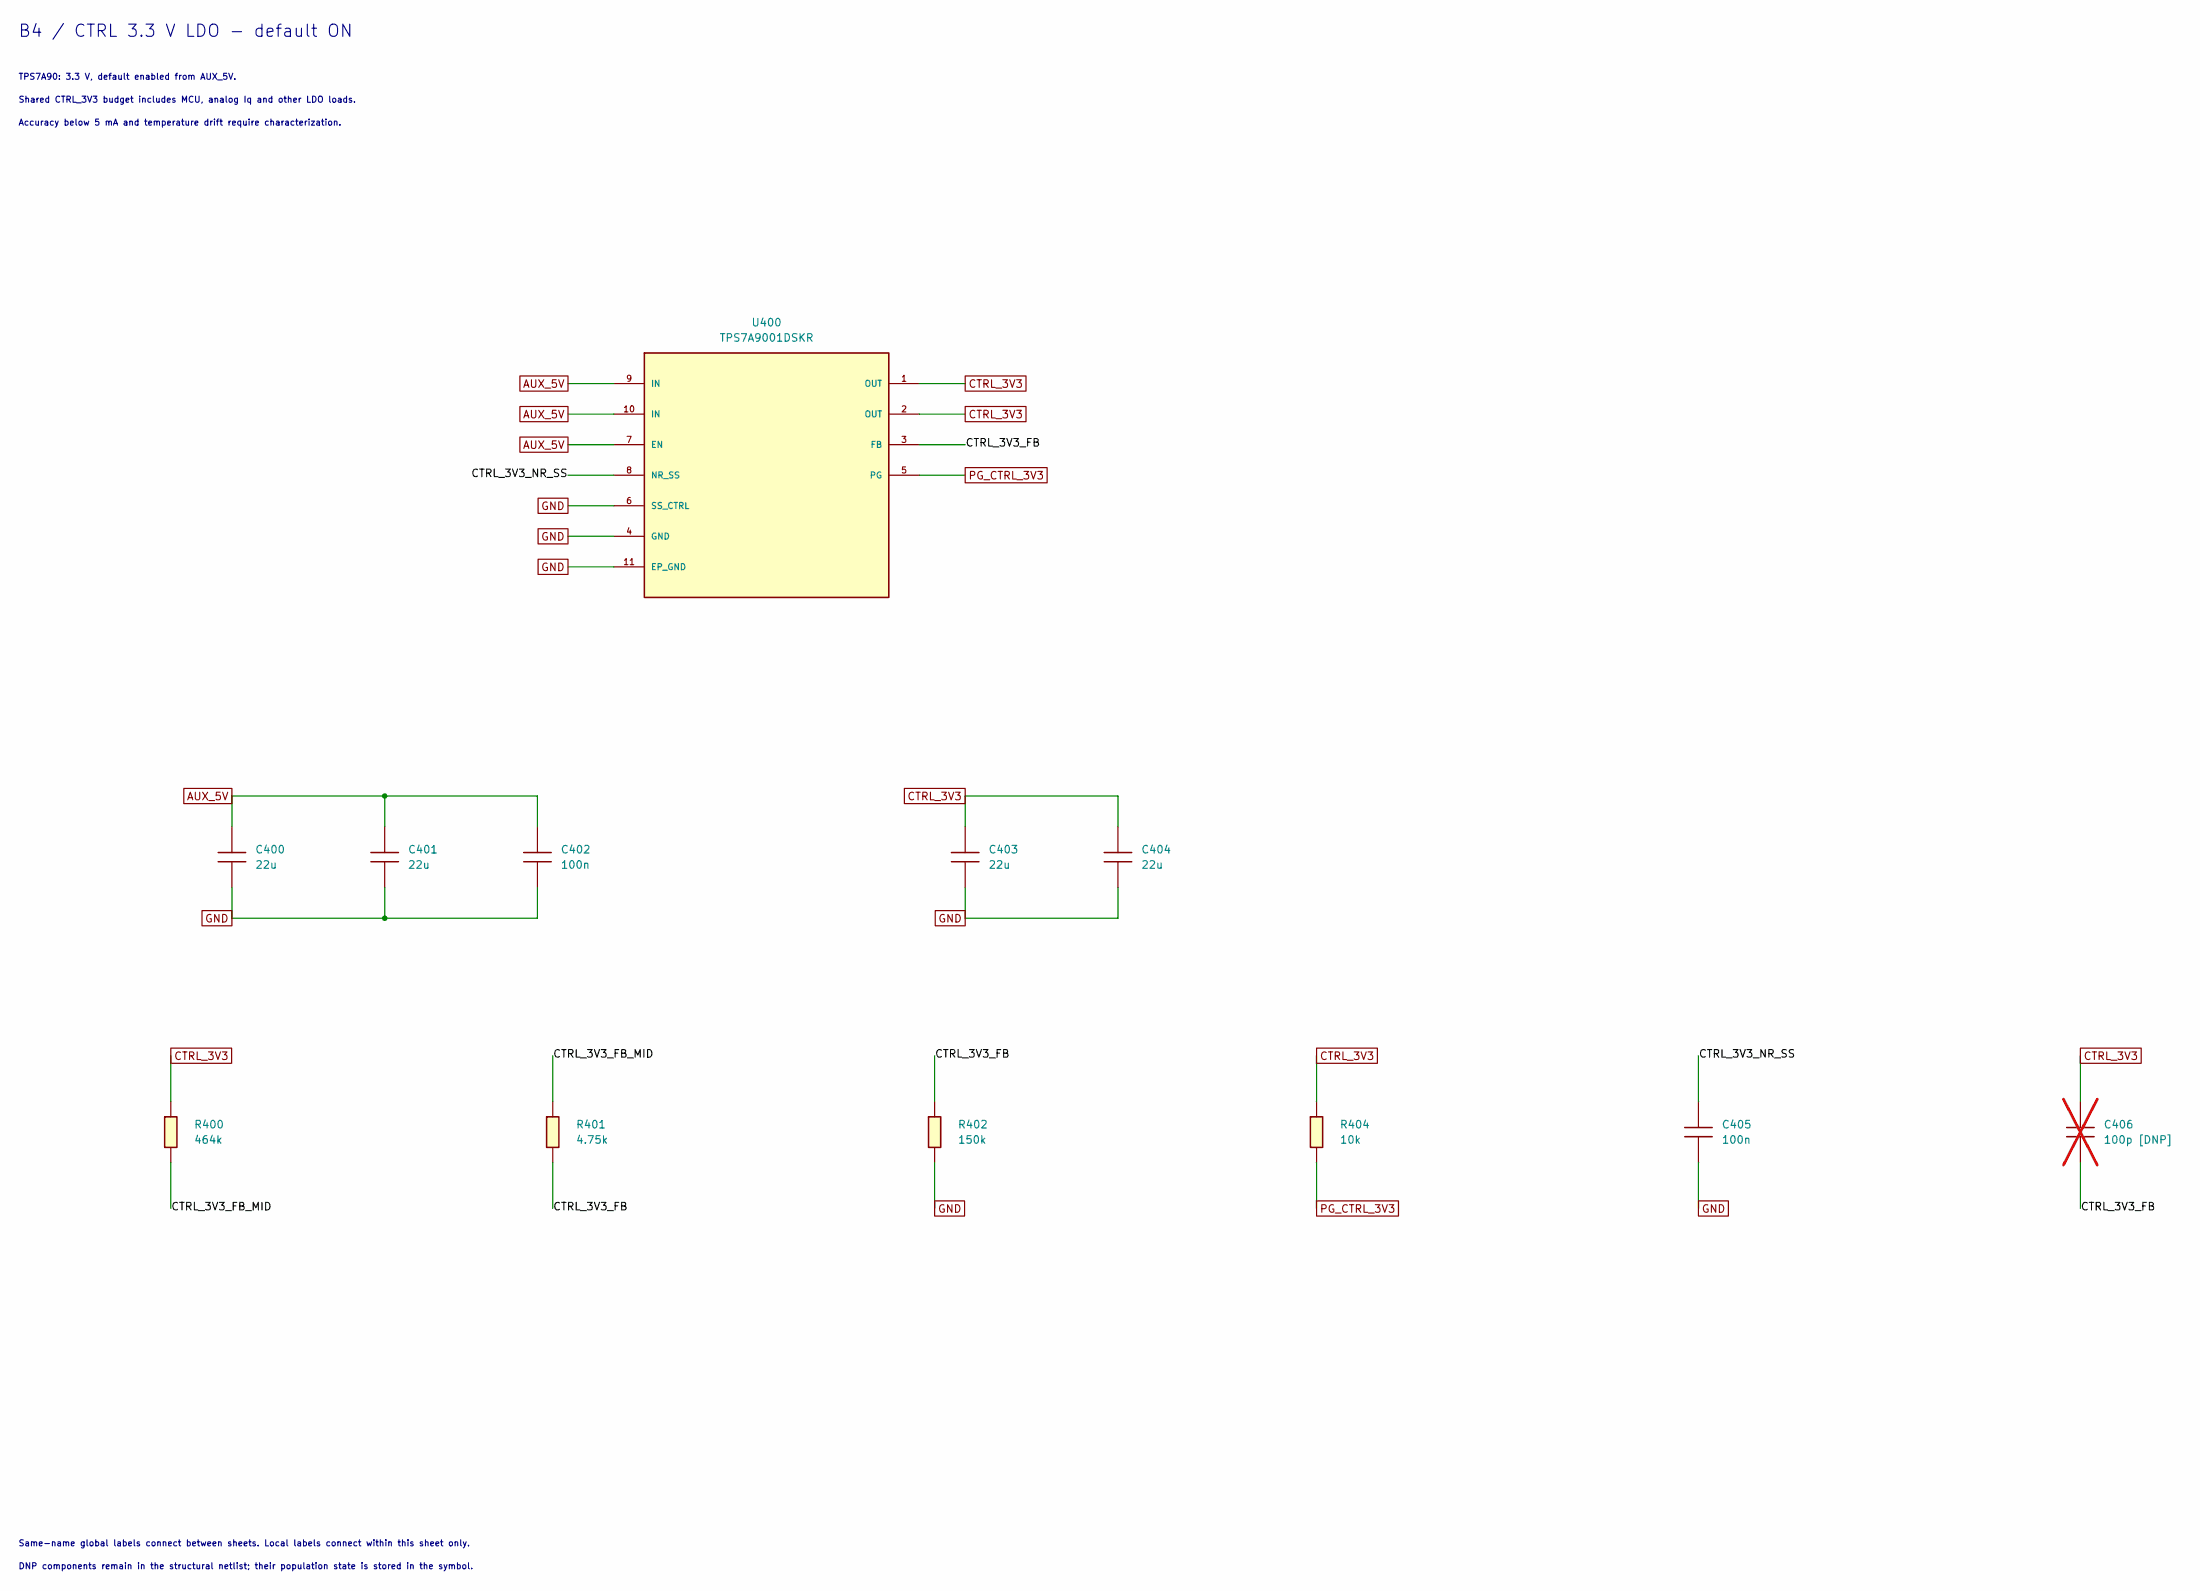
[picture p4: schematic B4.kicad_sch]

Parts:
C400, C401, C403, C404: 22u; C_1210_3225Metric; Rating 16V X7R ±10%; MPN 확인 필요: 유효용량·누설 검증 후 선정
C402: 100n; C_0603_1608Metric; Rating 50V X7R ±10%; MPN 확인 필요: 유효용량·누설 검증 후 선정
C405: 100n; C_0603_1608Metric; Rating 25V X7R ±10%; MPN 확인 필요: 유효용량·누설 검증 후 선정
C406: 100p [DNP]; C_0603_1608Metric; Rating 25V C0G ±5%; MPN 확인 필요: 유효용량·누설 검증 후 선정; not fitted
R400: 464k; R_0603_1608Metric; Rating 0.1%, ≤25ppm/°C, ≥0.1W, ≥25V; MPN 확인 필요: 지정값·정격 구매품
R401: 4.75k; R_0603_1608Metric; Rating 0.1%, ≤25ppm/°C, ≥0.1W, ≥25V; MPN 확인 필요: 지정값·정격 구매품
R402: 150k; R_0603_1608Metric; Rating 0.1%, ≤25ppm/°C, ≥0.1W, ≥25V; MPN 확인 필요: 지정값·정격 구매품
R404: 10k; R_0603_1608Metric; Rating 1%, ≥0.1W, ≥50V; MPN 확인 필요: 지정값·정격 구매품
U400: TPS7A9001DSKR; Texas_S-PDSO-N10_EP1.2x2mm; Rating 데이터시트 운용범위 적용; MPN TPS7A9001DSKR

Connections:
AUX_5V: C400.1, C401.1, C402.1, U400.7 (EN), U400.9 (IN), U400.10 (IN)
CTRL_3V3: C403.1, C404.1, C406.1, R400.1, R404.1, U400.1 (OUT), U400.2 (OUT)
CTRL_3V3_FB: C406.2, R401.2, R402.1, U400.3 (FB)
CTRL_3V3_FB_MID: R400.2, R401.1
CTRL_3V3_NR_SS: C405.1, U400.8 (NR_SS)
GND: C400.2, C401.2, C402.2, C403.2, C404.2, C405.2, R402.2, U400.4 (GND), U400.6 (SS_CTRL), U400.11 (EP_GND)
PG_CTRL_3V3: R404.2, U400.5 (PG)

Notes on the sheet:
B4 / CTRL 3.3 V LDO - default ON
TPS7A90: 3.3 V, default enabled from AUX_5V.
Shared CTRL_3V3 budget includes MCU, analog Iq and other LDO loads.
Accuracy below 5 mA and temperature drift require characterization.
Same-name global labels connect between sheets. Local labels connect within this sheet only.
DNP components remain in the structural netlist; their population state is stored in the symbol.
