Gugong0412/currentboard/R2_REPAIRED_006/B5_DIG.kicad_sch

## KiCad design R2_REPAIRED_006/B5_DIG.kicad_sch (2026-10-15)

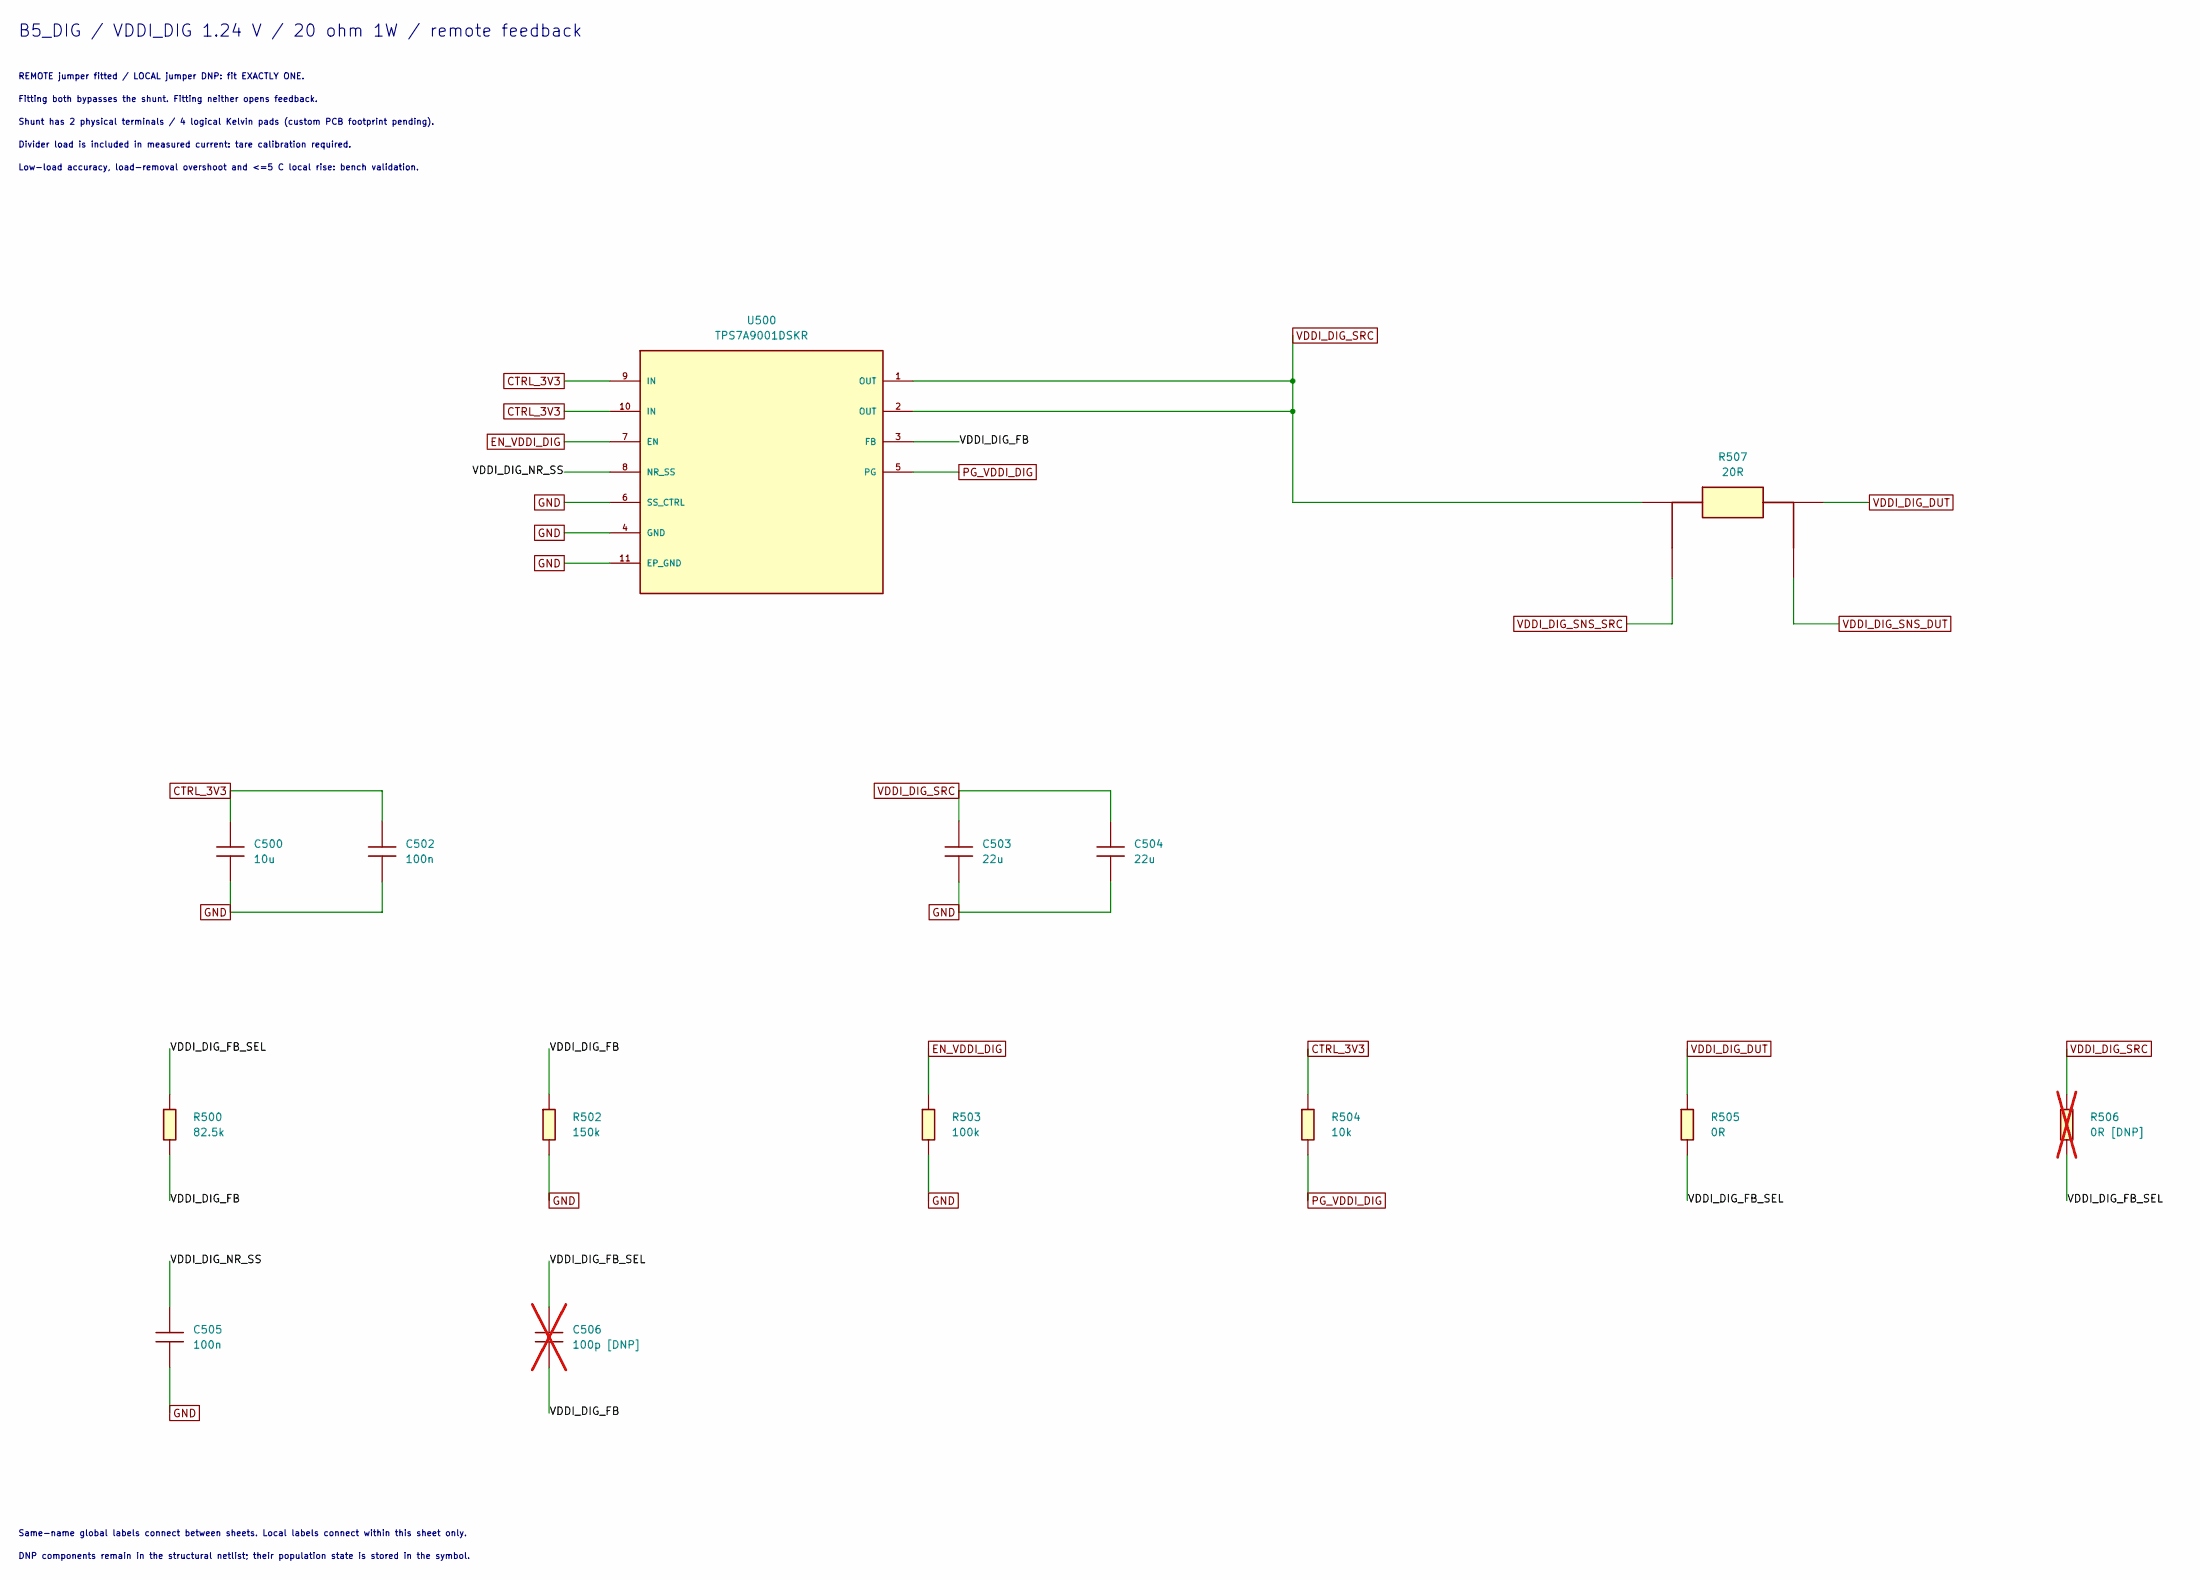
[picture p5: schematic B5_DIG.kicad_sch]

Parts:
C500: 10u; C_1210_3225Metric; Rating 16V X7R ±20%; 3.3V DC·온도·공차 포함 유효≥5µF 요구; MPN 확인 필요: 유효용량·누설 검증 후 선정
C502: 100n; C_0603_1608Metric; Rating 50V X7R ±10%; MPN 확인 필요: 유효용량·누설 검증 후 선정
C503, C504: 22u; C_1210_3225Metric; Rating 16V X7R ±10%; MPN 확인 필요: 유효용량·누설 검증 후 선정
C505: 100n; C_0603_1608Metric; Rating 25V X7R ±10%; MPN 확인 필요: 유효용량·누설 검증 후 선정
C506: 100p [DNP]; C_0603_1608Metric; Rating 25V C0G ±5%; MPN 확인 필요: 유효용량·누설 검증 후 선정; not fitted
R500: 82.5k; R_0603_1608Metric; Rating 0.1%, ≤25ppm/°C, ≥0.1W, ≥25V; MPN 확인 필요: 지정값·정격 구매품
R502: 150k; R_0603_1608Metric; Rating 0.1%, ≤25ppm/°C, ≥0.1W, ≥25V; MPN 확인 필요: 지정값·정격 구매품
R503: 100k; R_0603_1608Metric; Rating 1%, ≥0.1W, ≥50V; MPN 확인 필요: 지정값·정격 구매품
R504: 10k; R_0603_1608Metric; Rating 1%, ≥0.1W, ≥50V; MPN 확인 필요: 지정값·정격 구매품
R505: 0R; R_0603_1608Metric; Rating jumper; ≤50mΩ 목표, ≥0.1W; MPN 확인 필요: 지정값·정격 구매품
R506: 0R [DNP]; R_0603_1608Metric; Rating jumper; ≤50mΩ 목표, ≥0.1W; MPN 확인 필요: 지정값·정격 구매품; not fitted
R507: 20R; Rating 20Ω 0.1%,25ppm/°C;1W@70°C,derate to0W@1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; MPN RT2512BKD7W20RL
U500: TPS7A9001DSKR; Texas_S-PDSO-N10_EP1.2x2mm; Rating 데이터시트 운용범위 적용; MPN TPS7A9001DSKR

Connections:
CTRL_3V3: C500.1, C502.1, R504.1, U500.9 (IN), U500.10 (IN)
EN_VDDI_DIG: R503.1, U500.7 (EN)
GND: C500.2, C502.2, C503.2, C504.2, C505.2, R502.2, R503.2, U500.4 (GND), U500.6 (SS_CTRL), U500.11 (EP_GND)
PG_VDDI_DIG: R504.2, U500.5 (PG)
VDDI_DIG_DUT: R505.1, R507.2 (FORCE_DUT)
VDDI_DIG_FB: C506.2, R500.2, R502.1, U500.3 (FB)
VDDI_DIG_FB_SEL: C506.1, R500.1, R505.2, R506.2
VDDI_DIG_NR_SS: C505.1, U500.8 (NR_SS)
VDDI_DIG_SNS_DUT: R507.4 (SENSE_DUT)
VDDI_DIG_SNS_SRC: R507.3 (SENSE_SRC)
VDDI_DIG_SRC: C503.1, C504.1, R506.1, R507.1 (FORCE_SRC), U500.1 (OUT), U500.2 (OUT)

Notes on the sheet:
B5_DIG / VDDI_DIG 1.24 V / 20 ohm 1W / remote feedback
REMOTE jumper fitted / LOCAL jumper DNP: fit EXACTLY ONE.
Fitting both bypasses the shunt. Fitting neither opens feedback.
Shunt has 2 physical terminals / 4 logical Kelvin pads (custom PCB footprint pending).
Divider load is included in measured current: tare calibration required.
Low-load accuracy, load-removal overshoot and <=5 C local rise: bench validation.
Same-name global labels connect between sheets. Local labels connect within this sheet only.
DNP components remain in the structural netlist; their population state is stored in the symbol.
