Gugong0412/currentboard/R2_REPAIRED_006/B5_VCI.kicad_sch

## KiCad design R2_REPAIRED_006/B5_VCI.kicad_sch (2026-10-15)

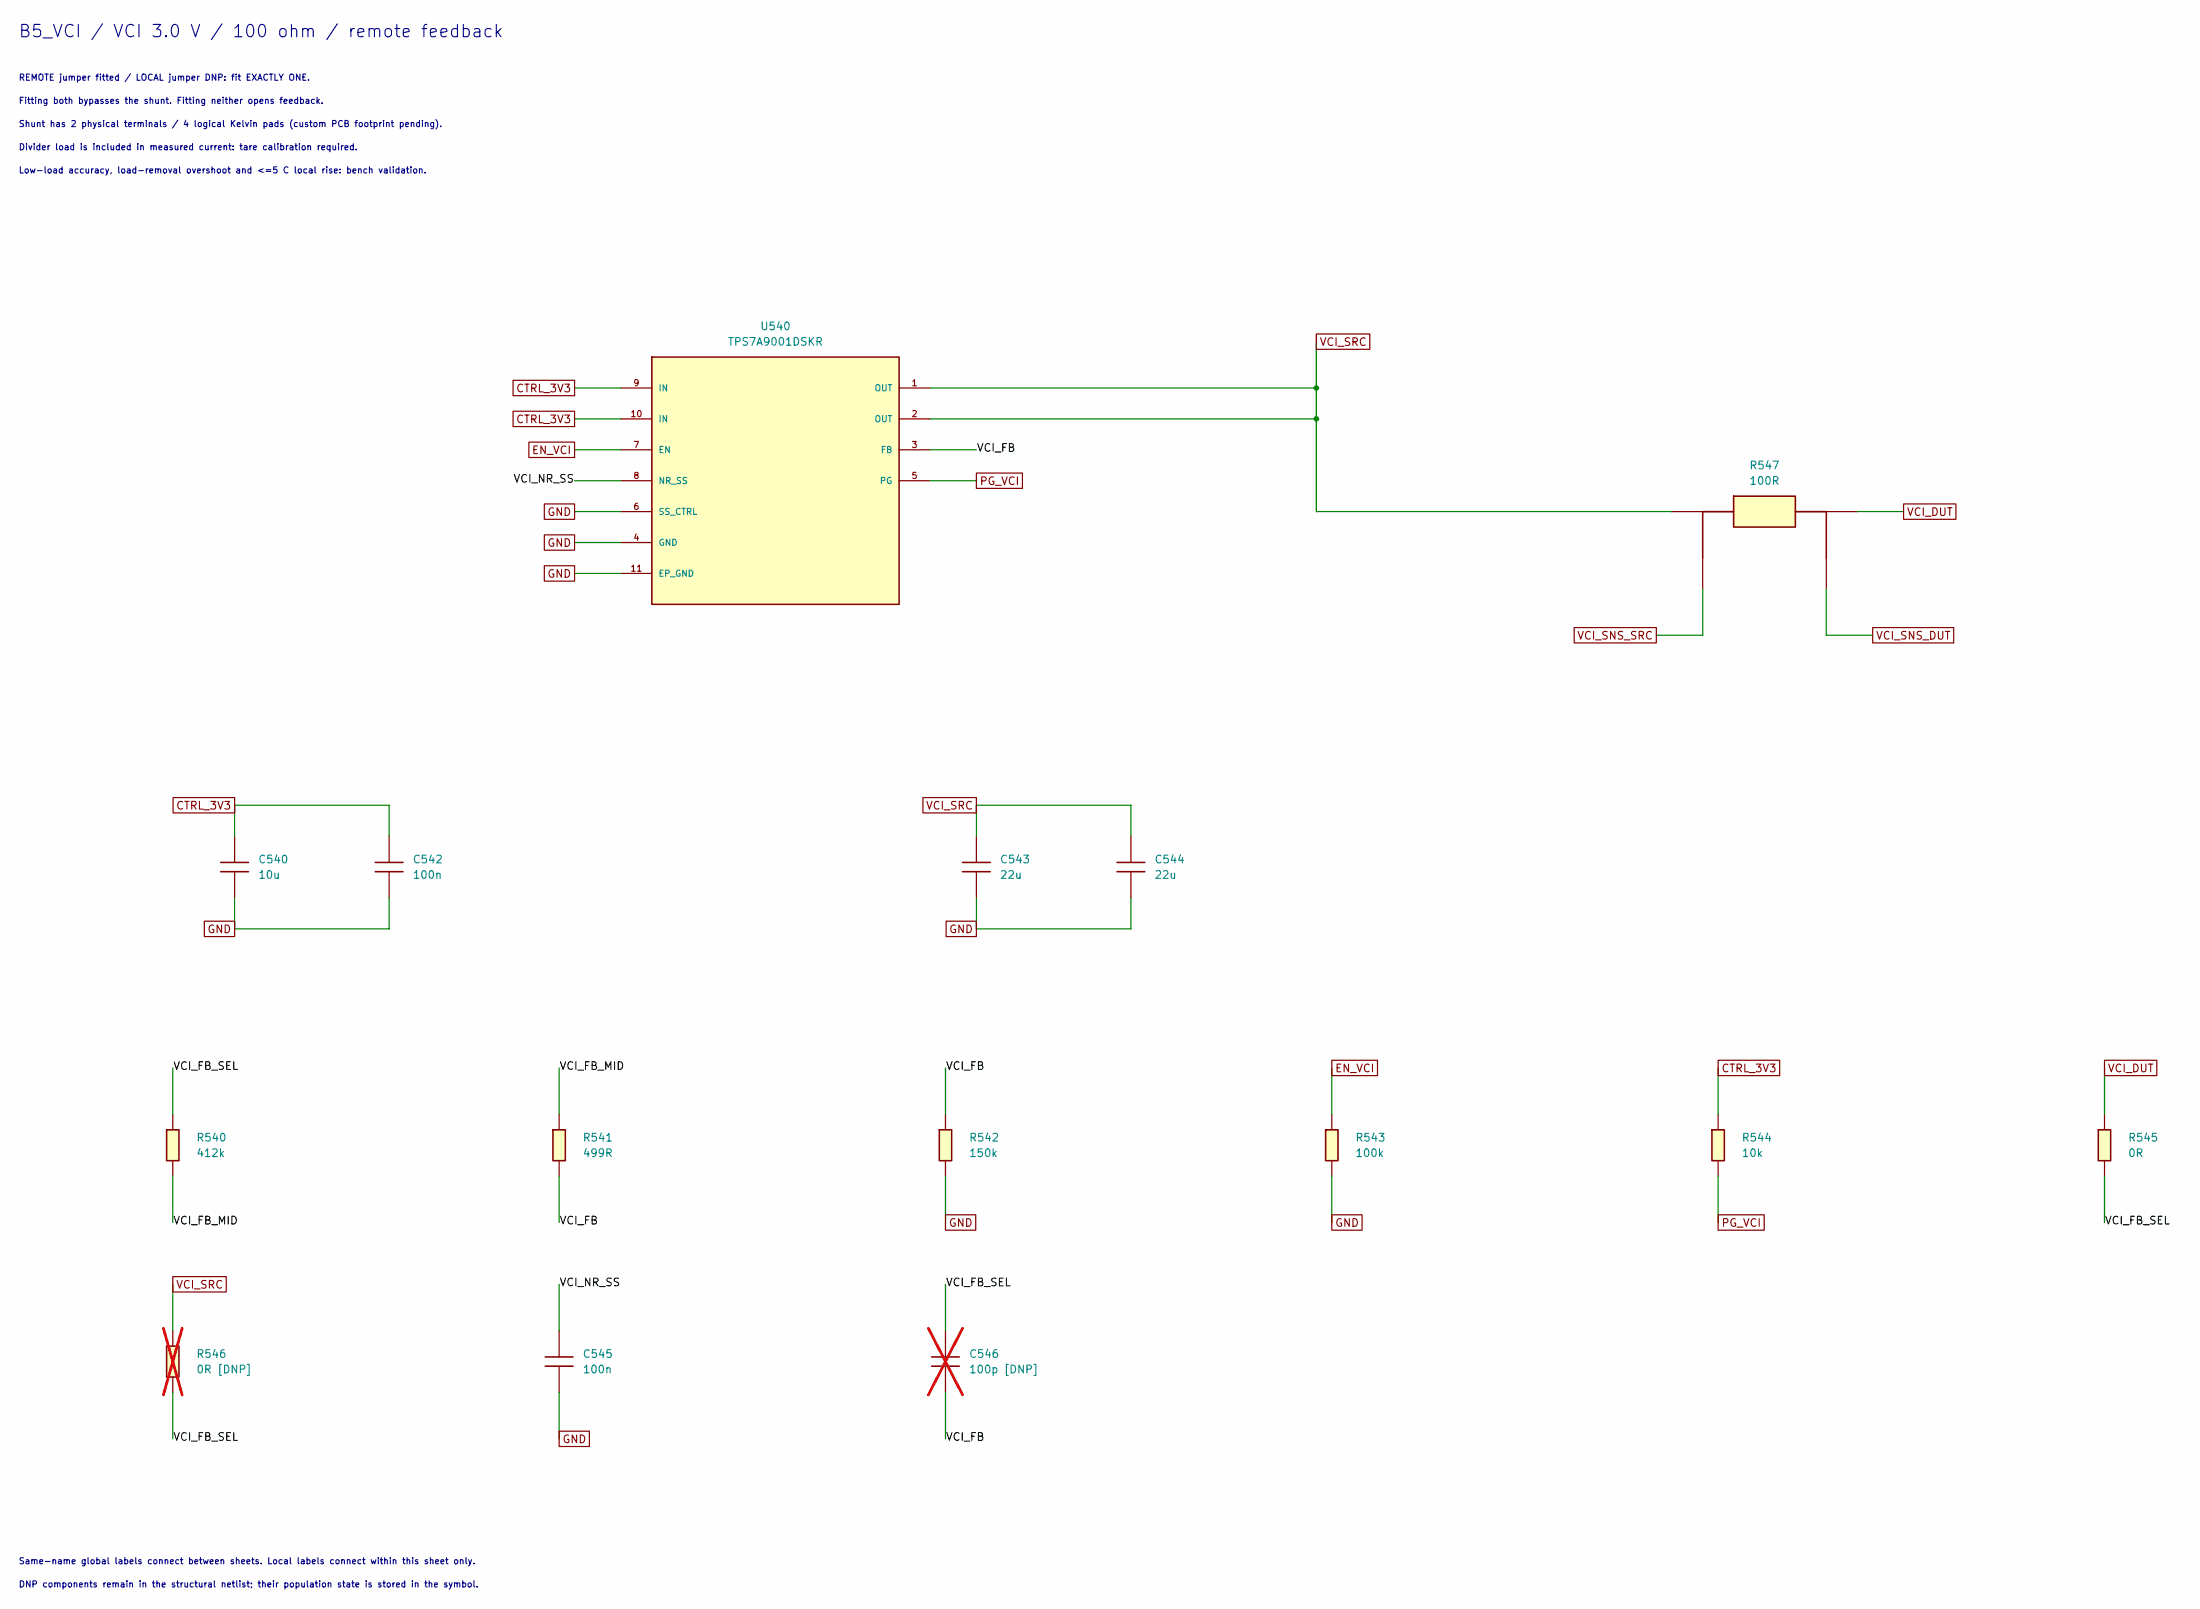
[picture p6: schematic B5_VCI.kicad_sch]

Parts:
C540: 10u; C_1210_3225Metric; Rating 16V X7R ±20%; 3.3V DC·온도·공차 포함 유효≥5µF 요구; MPN 확인 필요: 유효용량·누설 검증 후 선정
C542: 100n; C_0603_1608Metric; Rating 50V X7R ±10%; MPN 확인 필요: 유효용량·누설 검증 후 선정
C543, C544: 22u; C_1210_3225Metric; Rating 16V X7R ±10%; MPN 확인 필요: 유효용량·누설 검증 후 선정
C545: 100n; C_0603_1608Metric; Rating 25V X7R ±10%; MPN 확인 필요: 유효용량·누설 검증 후 선정
C546: 100p [DNP]; C_0603_1608Metric; Rating 25V C0G ±5%; MPN 확인 필요: 유효용량·누설 검증 후 선정; not fitted
R540: 412k; R_0603_1608Metric; Rating 0.1%, ≤25ppm/°C, ≥0.1W, ≥25V; MPN 확인 필요: 지정값·정격 구매품
R541: 499R; R_0603_1608Metric; Rating 0.1%, ≤25ppm/°C, ≥0.1W, ≥25V; MPN 확인 필요: 지정값·정격 구매품
R542: 150k; R_0603_1608Metric; Rating 0.1%, ≤25ppm/°C, ≥0.1W, ≥25V; MPN 확인 필요: 지정값·정격 구매품
R543: 100k; R_0603_1608Metric; Rating 1%, ≥0.1W, ≥50V; MPN 확인 필요: 지정값·정격 구매품
R544: 10k; R_0603_1608Metric; Rating 1%, ≥0.1W, ≥50V; MPN 확인 필요: 지정값·정격 구매품
R545: 0R; R_0603_1608Metric; Rating jumper; ≤50mΩ 목표, ≥0.1W; MPN 확인 필요: 지정값·정격 구매품
R546: 0R [DNP]; R_0603_1608Metric; Rating jumper; ≤50mΩ 목표, ≥0.1W; MPN 확인 필요: 지정값·정격 구매품; not fitted
R547: 100R; Rating 0.1%, ≤25ppm/°C, 0.25W 요구; 발주 원문 확인; MPN RT1206BRD07100RL
U540: TPS7A9001DSKR; Texas_S-PDSO-N10_EP1.2x2mm; Rating 데이터시트 운용범위 적용; MPN TPS7A9001DSKR

Connections:
CTRL_3V3: C540.1, C542.1, R544.1, U540.9 (IN), U540.10 (IN)
EN_VCI: R543.1, U540.7 (EN)
GND: C540.2, C542.2, C543.2, C544.2, C545.2, R542.2, R543.2, U540.4 (GND), U540.6 (SS_CTRL), U540.11 (EP_GND)
PG_VCI: R544.2, U540.5 (PG)
VCI_DUT: R545.1, R547.2 (FORCE_DUT)
VCI_FB: C546.2, R541.2, R542.1, U540.3 (FB)
VCI_FB_MID: R540.2, R541.1
VCI_FB_SEL: C546.1, R540.1, R545.2, R546.2
VCI_NR_SS: C545.1, U540.8 (NR_SS)
VCI_SNS_DUT: R547.4 (SENSE_DUT)
VCI_SNS_SRC: R547.3 (SENSE_SRC)
VCI_SRC: C543.1, C544.1, R546.1, R547.1 (FORCE_SRC), U540.1 (OUT), U540.2 (OUT)

Notes on the sheet:
B5_VCI / VCI 3.0 V / 100 ohm / remote feedback
REMOTE jumper fitted / LOCAL jumper DNP: fit EXACTLY ONE.
Fitting both bypasses the shunt. Fitting neither opens feedback.
Shunt has 2 physical terminals / 4 logical Kelvin pads (custom PCB footprint pending).
Divider load is included in measured current: tare calibration required.
Low-load accuracy, load-removal overshoot and <=5 C local rise: bench validation.
Same-name global labels connect between sheets. Local labels connect within this sheet only.
DNP components remain in the structural netlist; their population state is stored in the symbol.
