Gugong0412/currentboard/R2_REPAIRED_006/B5_VDDI.kicad_sch

## KiCad design R2_REPAIRED_006/B5_VDDI.kicad_sch (2026-10-20)

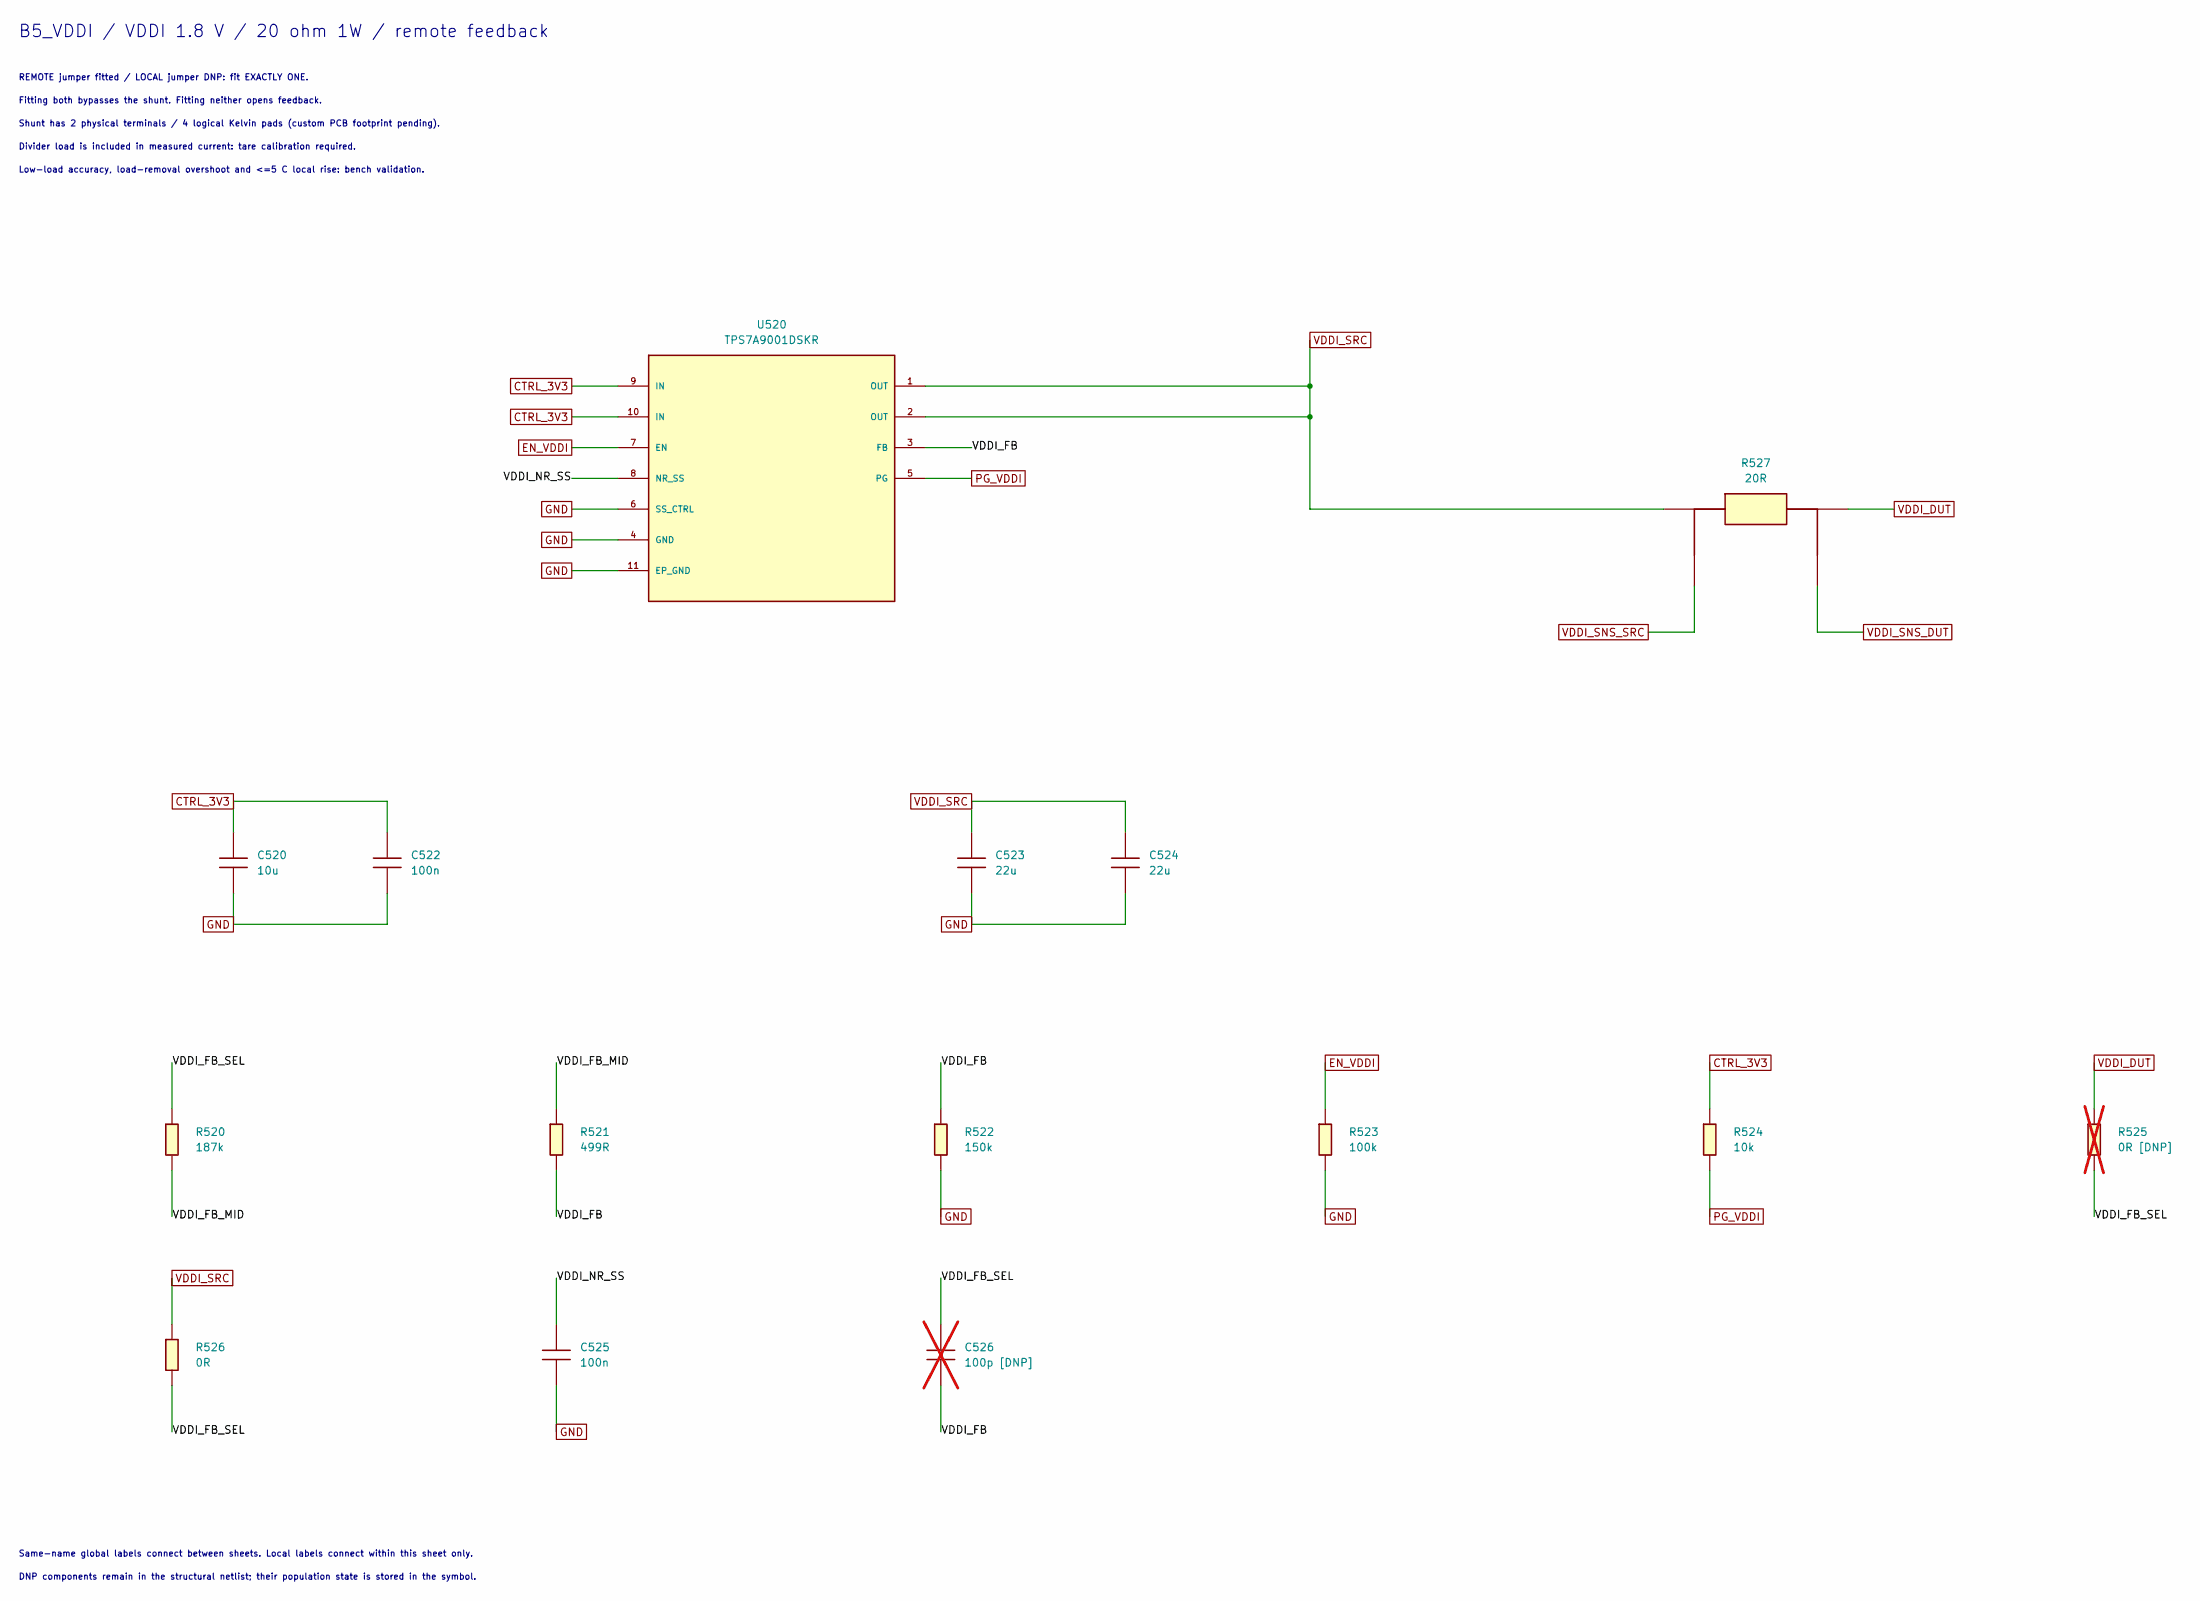
[picture p7: schematic B5_VDDI.kicad_sch]

Parts:
C520: 10u; C_1210_3225Metric; Rating 16V X7R ±20%; 3.3V DC·온도·공차 포함 유효≥5µF 요구; MPN 확인 필요: 유효용량·누설 검증 후 선정
C522: 100n; C_0603_1608Metric; Rating 50V X7R ±10%; MPN 확인 필요: 유효용량·누설 검증 후 선정
C523, C524: 22u; C_1210_3225Metric; Rating 16V X7R ±10%; MPN 확인 필요: 유효용량·누설 검증 후 선정
C525: 100n; C_0603_1608Metric; Rating 25V X7R ±10%; MPN 확인 필요: 유효용량·누설 검증 후 선정
C526: 100p [DNP]; C_0603_1608Metric; Rating 25V C0G ±5%; MPN 확인 필요: 유효용량·누설 검증 후 선정; not fitted
R520: 187k; R_0603_1608Metric; Rating 0.1%, ≤25ppm/°C, ≥0.1W, ≥25V; MPN 확인 필요: 지정값·정격 구매품
R521: 499R; R_0603_1608Metric; Rating 0.1%, ≤25ppm/°C, ≥0.1W, ≥25V; MPN 확인 필요: 지정값·정격 구매품
R522: 150k; R_0603_1608Metric; Rating 0.1%, ≤25ppm/°C, ≥0.1W, ≥25V; MPN 확인 필요: 지정값·정격 구매품
R523: 100k; R_0603_1608Metric; Rating 1%, ≥0.1W, ≥50V; MPN 확인 필요: 지정값·정격 구매품
R524: 10k; R_0603_1608Metric; Rating 1%, ≥0.1W, ≥50V; MPN 확인 필요: 지정값·정격 구매품
R525: 0R [DNP]; R_0603_1608Metric; Rating jumper; ≤50mΩ 목표, ≥0.1W; MPN 확인 필요: 지정값·정격 구매품; not fitted
R526: 0R; R_0603_1608Metric; Rating jumper; ≤50mΩ 목표, ≥0.1W; MPN 확인 필요: 지정값·정격 구매품
R527: 20R; Rating 20Ω 0.1%,25ppm/°C;1W@70°C,derate to0W@1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; MPN RT2512BKD7W20RL
U520: TPS7A9001DSKR; Texas_S-PDSO-N10_EP1.2x2mm; Rating 데이터시트 운용범위 적용; MPN TPS7A9001DSKR

Connections:
CTRL_3V3: C520.1, C522.1, R524.1, U520.9 (IN), U520.10 (IN)
EN_VDDI: R523.1, U520.7 (EN)
GND: C520.2, C522.2, C523.2, C524.2, C525.2, R522.2, R523.2, U520.4 (GND), U520.6 (SS_CTRL), U520.11 (EP_GND)
PG_VDDI: R524.2, U520.5 (PG)
VDDI_DUT: R525.1, R527.2 (FORCE_DUT)
VDDI_FB: C526.2, R521.2, R522.1, U520.3 (FB)
VDDI_FB_MID: R520.2, R521.1
VDDI_FB_SEL: C526.1, R520.1, R525.2, R526.2
VDDI_NR_SS: C525.1, U520.8 (NR_SS)
VDDI_SNS_DUT: R527.4 (SENSE_DUT)
VDDI_SNS_SRC: R527.3 (SENSE_SRC)
VDDI_SRC: C523.1, C524.1, R526.1, R527.1 (FORCE_SRC), U520.1 (OUT), U520.2 (OUT)

Notes on the sheet:
B5_VDDI / VDDI 1.8 V / 20 ohm 1W / remote feedback
REMOTE jumper fitted / LOCAL jumper DNP: fit EXACTLY ONE.
Fitting both bypasses the shunt. Fitting neither opens feedback.
Shunt has 2 physical terminals / 4 logical Kelvin pads (custom PCB footprint pending).
Divider load is included in measured current: tare calibration required.
Low-load accuracy, load-removal overshoot and <=5 C local rise: bench validation.
Same-name global labels connect between sheets. Local labels connect within this sheet only.
DNP components remain in the structural netlist; their population state is stored in the symbol.
