Gugong0412/currentboard/R2_REPAIRED_006/B6_IO.kicad_sch

## KiCad design R2_REPAIRED_006/B6_IO.kicad_sch (2026-10-15)

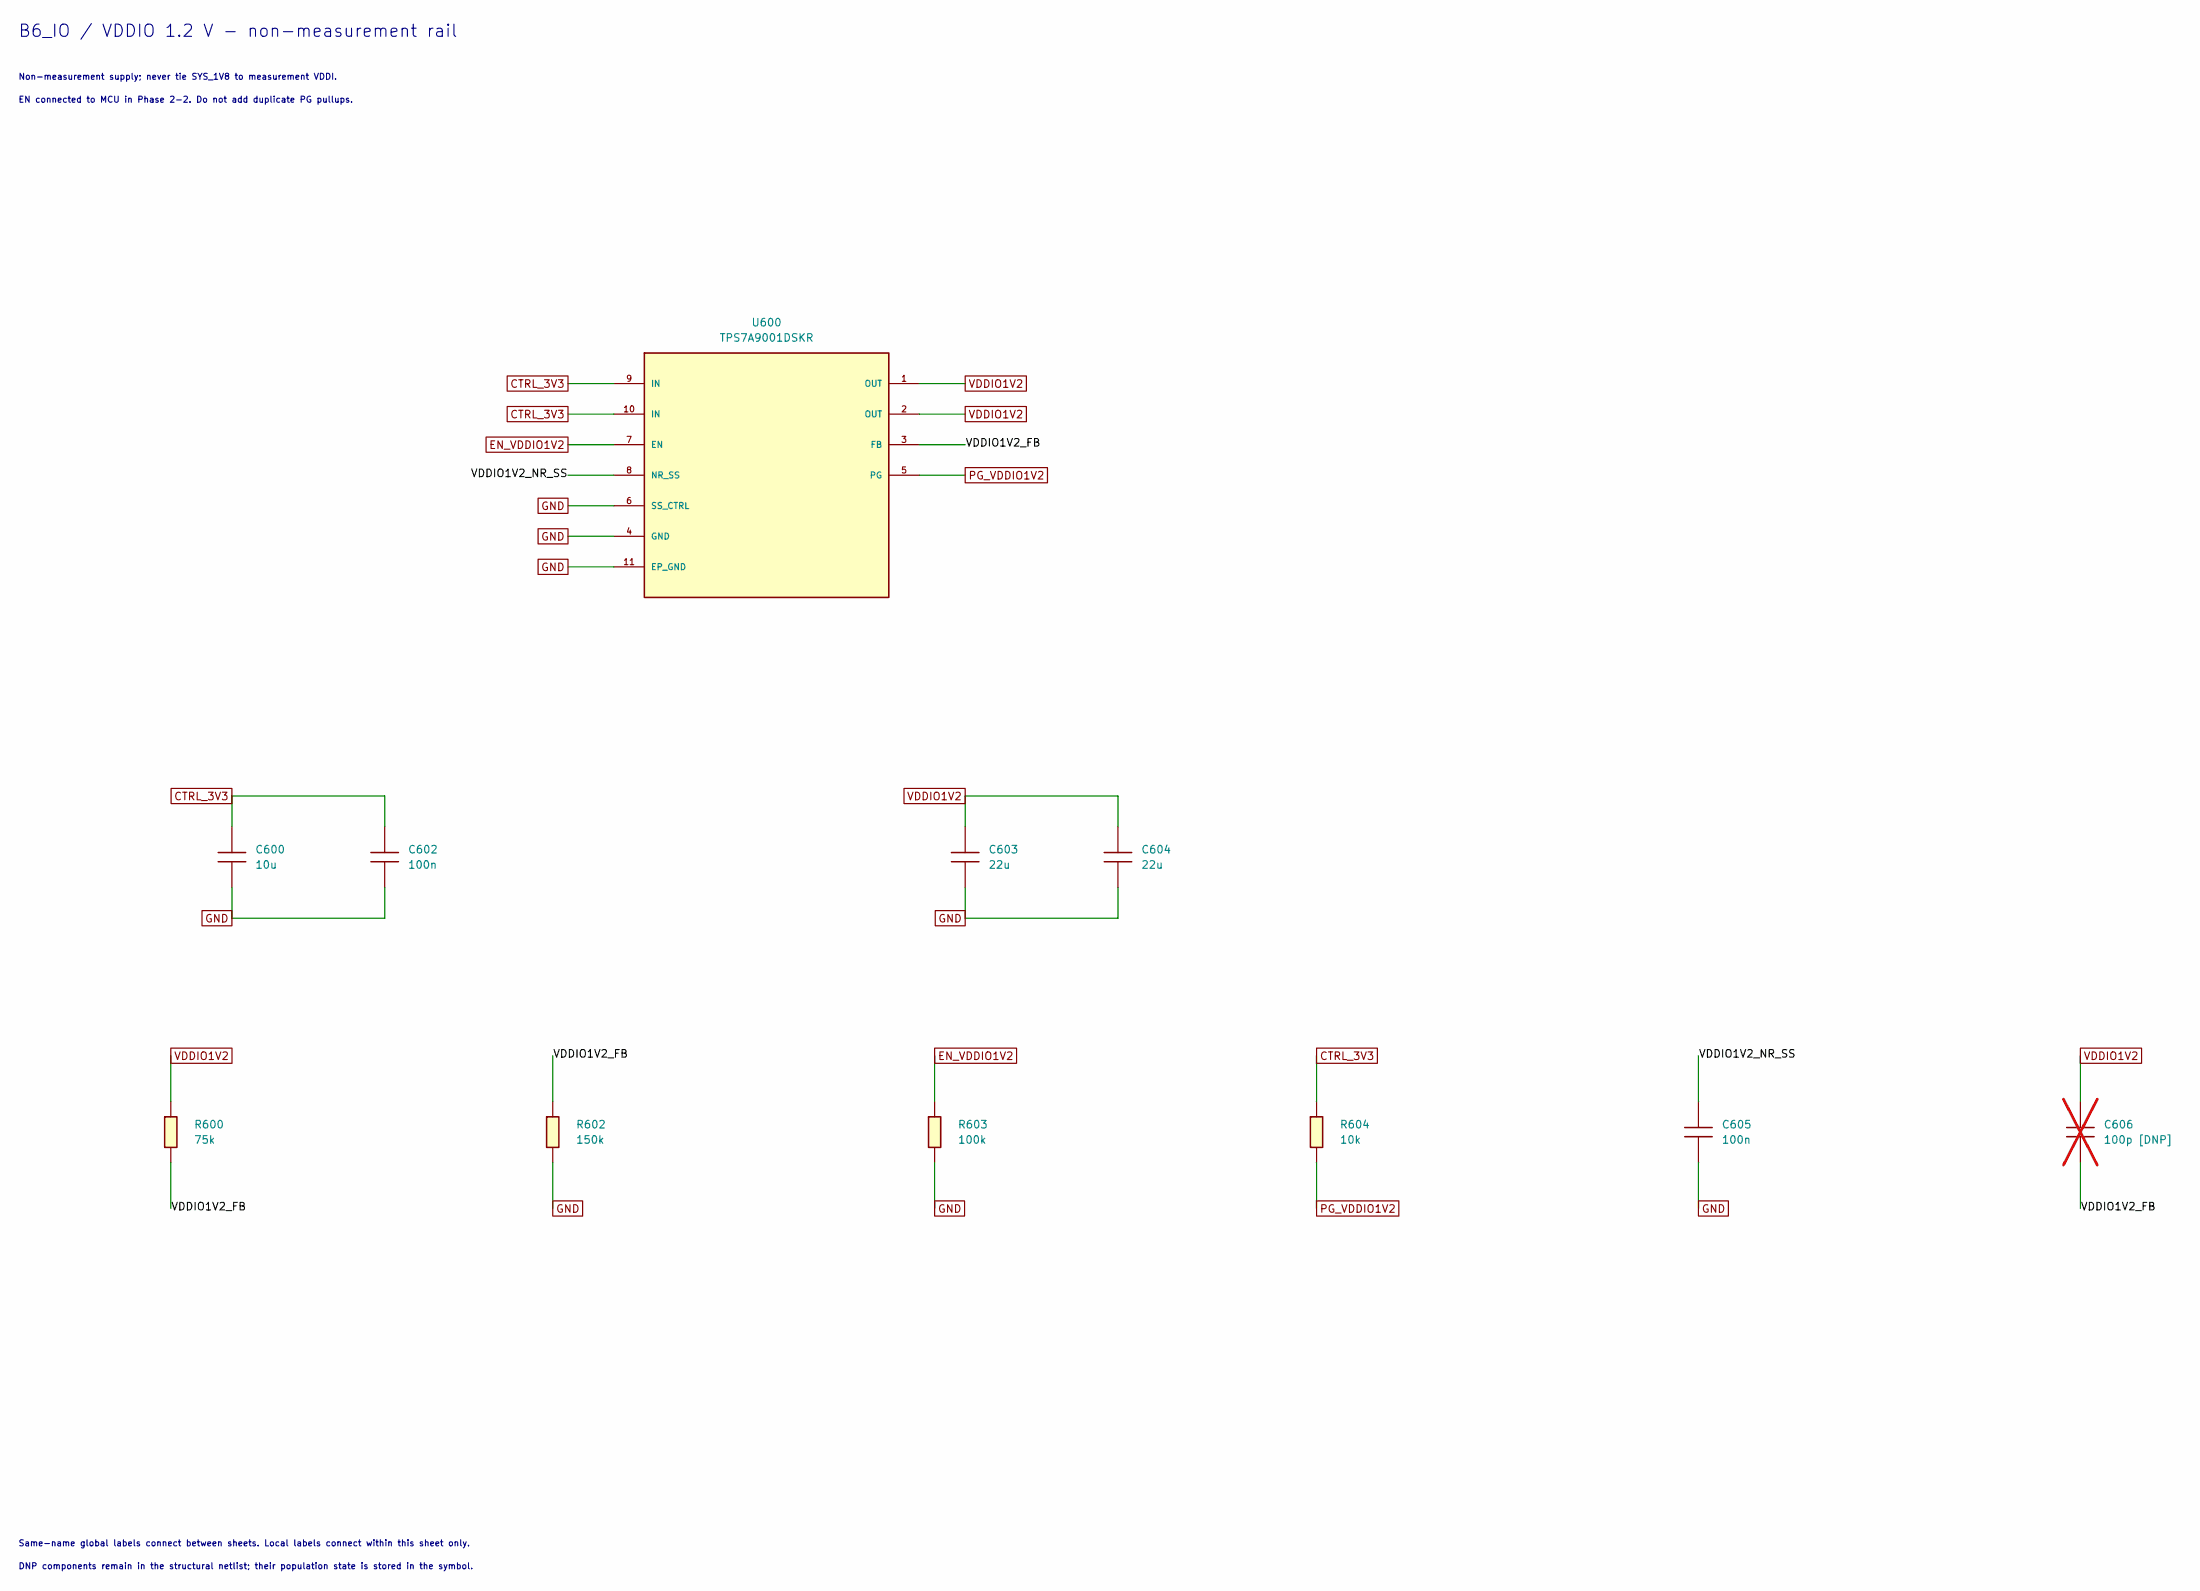
[picture p8: schematic B6_IO.kicad_sch]

Parts:
C600: 10u; C_1210_3225Metric; Rating 16V X7R ±20%; 3.3V DC·온도·공차 포함 유효≥5µF 요구; MPN 확인 필요: 유효용량·누설 검증 후 선정
C602: 100n; C_0603_1608Metric; Rating 50V X7R ±10%; MPN 확인 필요: 유효용량·누설 검증 후 선정
C603, C604: 22u; C_1210_3225Metric; Rating 16V X7R ±10%; MPN 확인 필요: 유효용량·누설 검증 후 선정
C605: 100n; C_0603_1608Metric; Rating 25V X7R ±10%; MPN 확인 필요: 유효용량·누설 검증 후 선정
C606: 100p [DNP]; C_0603_1608Metric; Rating 25V C0G ±5%; MPN 확인 필요: 유효용량·누설 검증 후 선정; not fitted
R600: 75k; R_0603_1608Metric; Rating 0.1%, ≤25ppm/°C, ≥0.1W, ≥25V; MPN 확인 필요: 지정값·정격 구매품
R602: 150k; R_0603_1608Metric; Rating 0.1%, ≤25ppm/°C, ≥0.1W, ≥25V; MPN 확인 필요: 지정값·정격 구매품
R603: 100k; R_0603_1608Metric; Rating 1%, ≥0.1W, ≥50V; MPN 확인 필요: 지정값·정격 구매품
R604: 10k; R_0603_1608Metric; Rating 1%, ≥0.1W, ≥50V; MPN 확인 필요: 지정값·정격 구매품
U600: TPS7A9001DSKR; Texas_S-PDSO-N10_EP1.2x2mm; Rating 데이터시트 운용범위 적용; MPN TPS7A9001DSKR

Connections:
CTRL_3V3: C600.1, C602.1, R604.1, U600.9 (IN), U600.10 (IN)
EN_VDDIO1V2: R603.1, U600.7 (EN)
GND: C600.2, C602.2, C603.2, C604.2, C605.2, R602.2, R603.2, U600.4 (GND), U600.6 (SS_CTRL), U600.11 (EP_GND)
PG_VDDIO1V2: R604.2, U600.5 (PG)
VDDIO1V2: C603.1, C604.1, C606.1, R600.1, U600.1 (OUT), U600.2 (OUT)
VDDIO1V2_FB: C606.2, R600.2, R602.1, U600.3 (FB)
VDDIO1V2_NR_SS: C605.1, U600.8 (NR_SS)

Notes on the sheet:
B6_IO / VDDIO 1.2 V - non-measurement rail
Non-measurement supply; never tie SYS_1V8 to measurement VDDI.
EN connected to MCU in Phase 2-2. Do not add duplicate PG pullups.
Same-name global labels connect between sheets. Local labels connect within this sheet only.
DNP components remain in the structural netlist; their population state is stored in the symbol.
