Gugong0412/currentboard/R2_REPAIRED_006/B6_SYS.kicad_sch

## KiCad design R2_REPAIRED_006/B6_SYS.kicad_sch (2026-10-15)

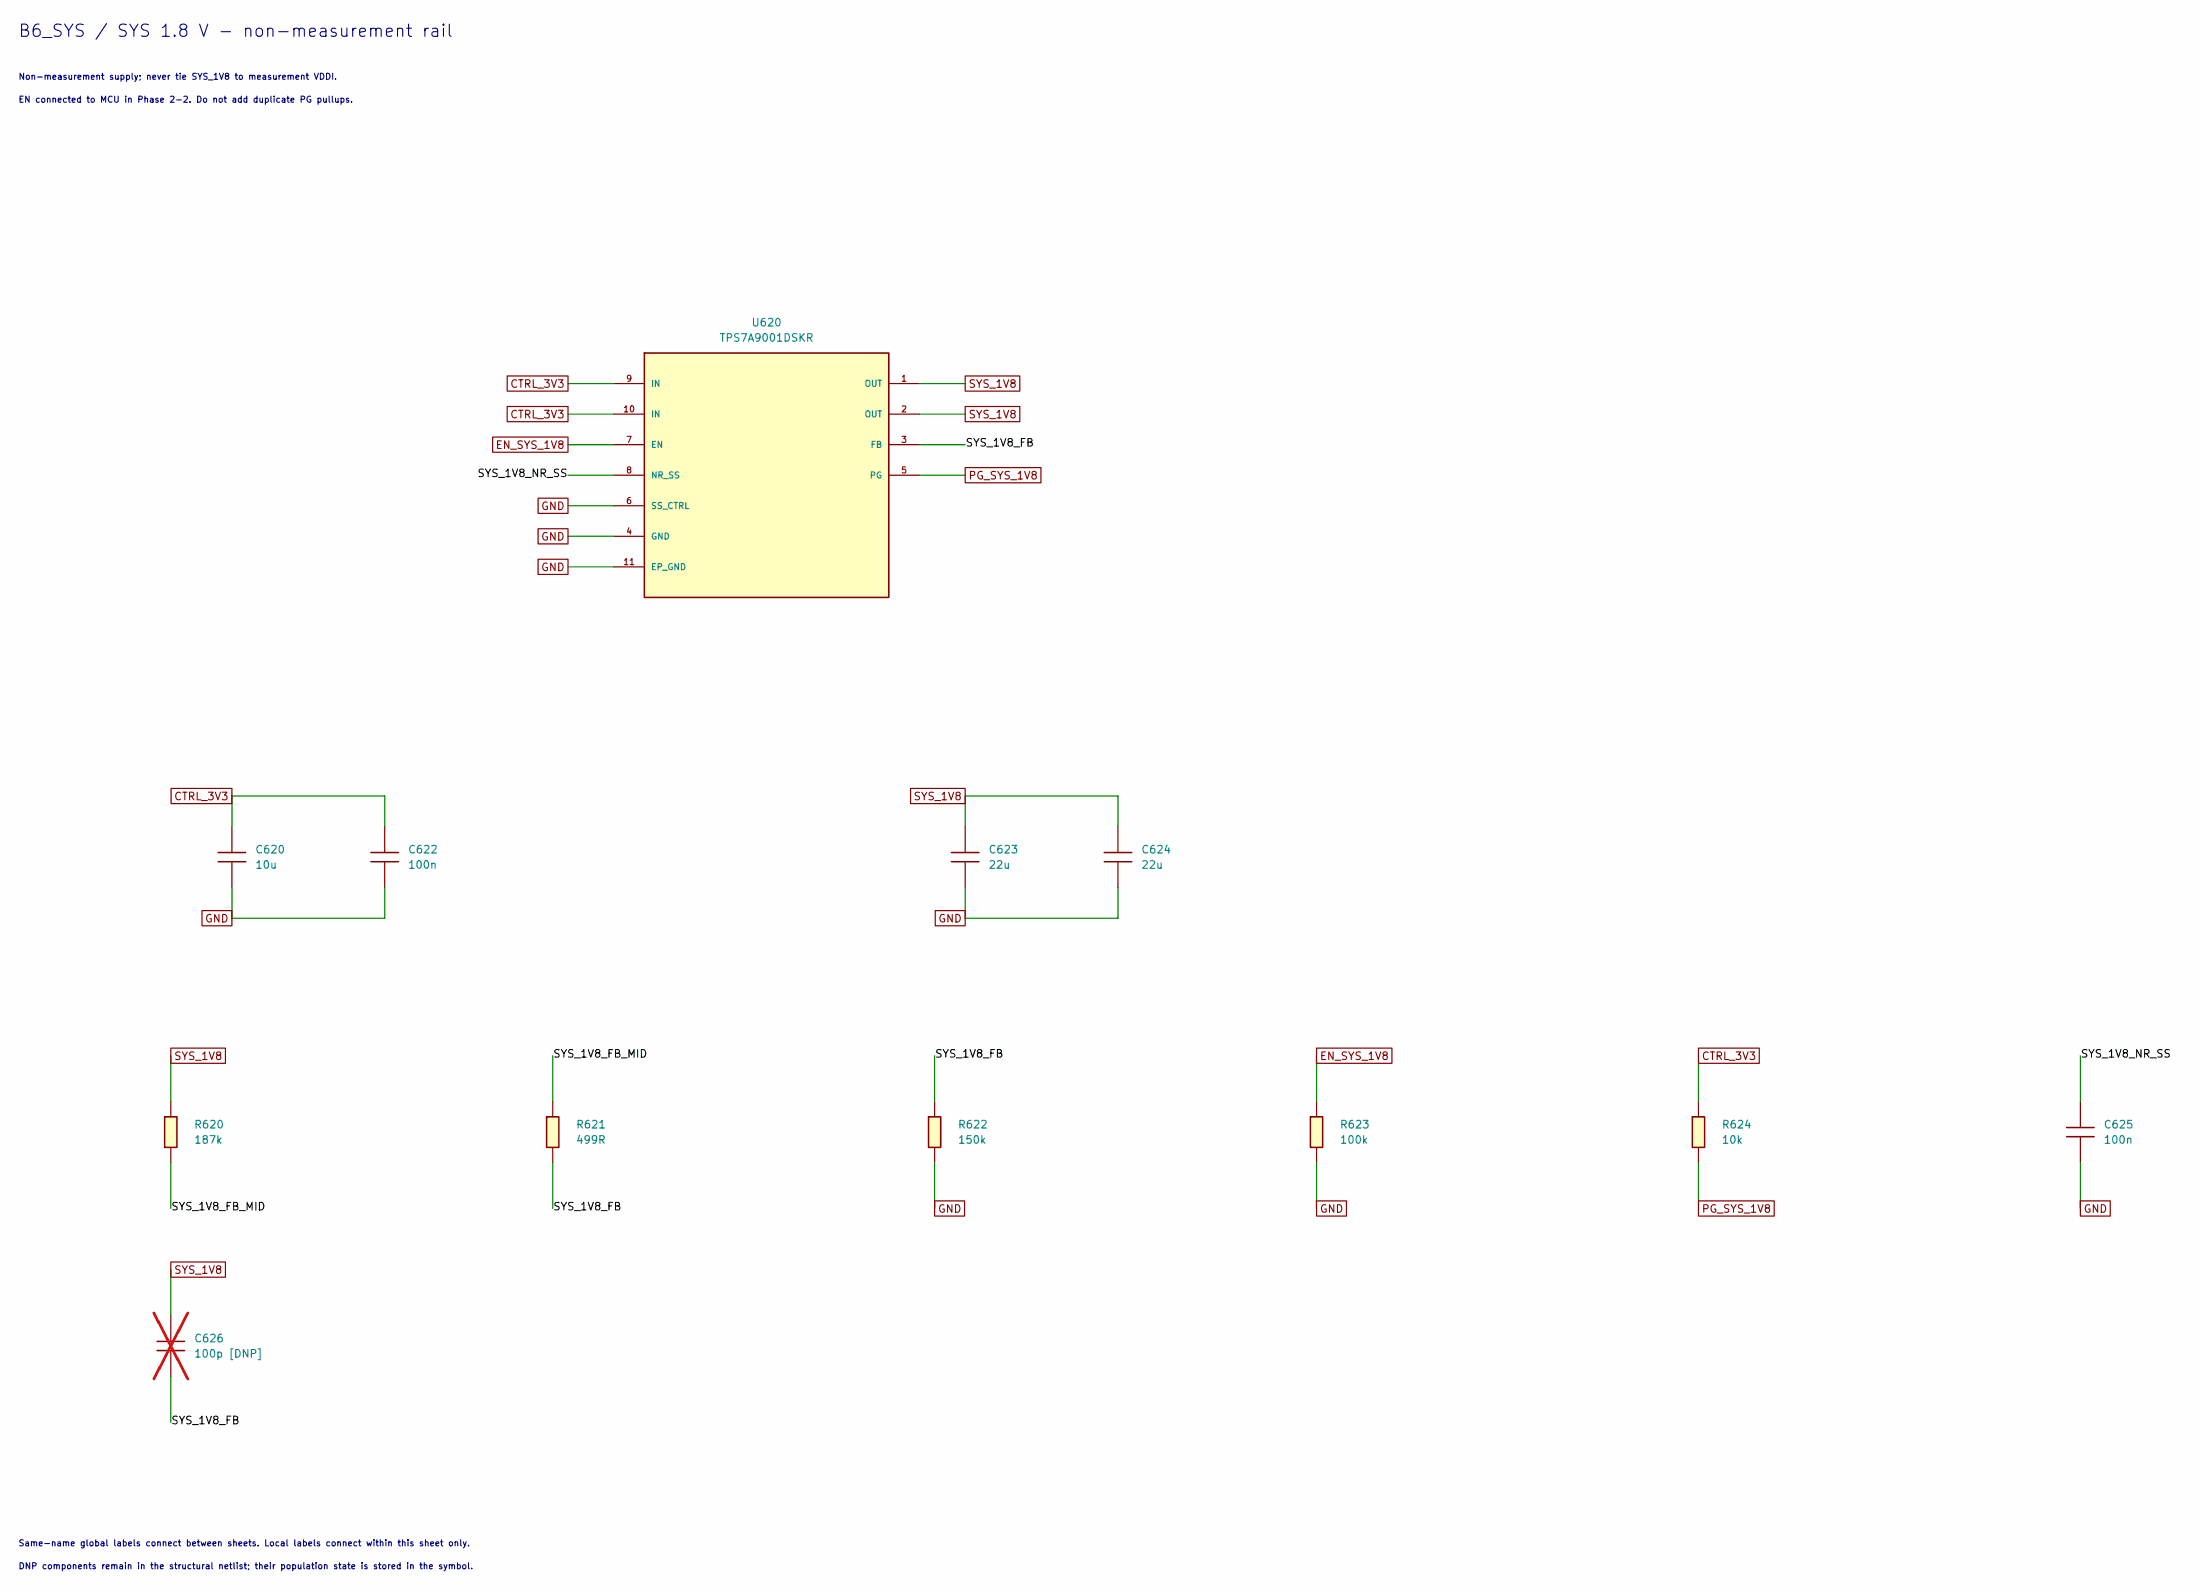
[picture p9: schematic B6_SYS.kicad_sch]

Parts:
C620: 10u; C_1210_3225Metric; Rating 16V X7R ±20%; 3.3V DC·온도·공차 포함 유효≥5µF 요구; MPN 확인 필요: 유효용량·누설 검증 후 선정
C622: 100n; C_0603_1608Metric; Rating 50V X7R ±10%; MPN 확인 필요: 유효용량·누설 검증 후 선정
C623, C624: 22u; C_1210_3225Metric; Rating 16V X7R ±10%; MPN 확인 필요: 유효용량·누설 검증 후 선정
C625: 100n; C_0603_1608Metric; Rating 25V X7R ±10%; MPN 확인 필요: 유효용량·누설 검증 후 선정
C626: 100p [DNP]; C_0603_1608Metric; Rating 25V C0G ±5%; MPN 확인 필요: 유효용량·누설 검증 후 선정; not fitted
R620: 187k; R_0603_1608Metric; Rating 0.1%, ≤25ppm/°C, ≥0.1W, ≥25V; MPN 확인 필요: 지정값·정격 구매품
R621: 499R; R_0603_1608Metric; Rating 0.1%, ≤25ppm/°C, ≥0.1W, ≥25V; MPN 확인 필요: 지정값·정격 구매품
R622: 150k; R_0603_1608Metric; Rating 0.1%, ≤25ppm/°C, ≥0.1W, ≥25V; MPN 확인 필요: 지정값·정격 구매품
R623: 100k; R_0603_1608Metric; Rating 1%, ≥0.1W, ≥50V; MPN 확인 필요: 지정값·정격 구매품
R624: 10k; R_0603_1608Metric; Rating 1%, ≥0.1W, ≥50V; MPN 확인 필요: 지정값·정격 구매품
U620: TPS7A9001DSKR; Texas_S-PDSO-N10_EP1.2x2mm; Rating 데이터시트 운용범위 적용; MPN TPS7A9001DSKR

Connections:
CTRL_3V3: C620.1, C622.1, R624.1, U620.9 (IN), U620.10 (IN)
EN_SYS_1V8: R623.1, U620.7 (EN)
GND: C620.2, C622.2, C623.2, C624.2, C625.2, R622.2, R623.2, U620.4 (GND), U620.6 (SS_CTRL), U620.11 (EP_GND)
PG_SYS_1V8: R624.2, U620.5 (PG)
SYS_1V8: C623.1, C624.1, C626.1, R620.1, U620.1 (OUT), U620.2 (OUT)
SYS_1V8_FB: C626.2, R621.2, R622.1, U620.3 (FB)
SYS_1V8_FB_MID: R620.2, R621.1
SYS_1V8_NR_SS: C625.1, U620.8 (NR_SS)

Notes on the sheet:
B6_SYS / SYS 1.8 V - non-measurement rail
Non-measurement supply; never tie SYS_1V8 to measurement VDDI.
EN connected to MCU in Phase 2-2. Do not add duplicate PG pullups.
Same-name global labels connect between sheets. Local labels connect within this sheet only.
DNP components remain in the structural netlist; their population state is stored in the symbol.
