Gugong0412/currentboard/R2_REPAIRED_006/B7_AVDDH1.kicad_sch

## KiCad design R2_REPAIRED_006/B7_AVDDH1.kicad_sch (2026-10-15)

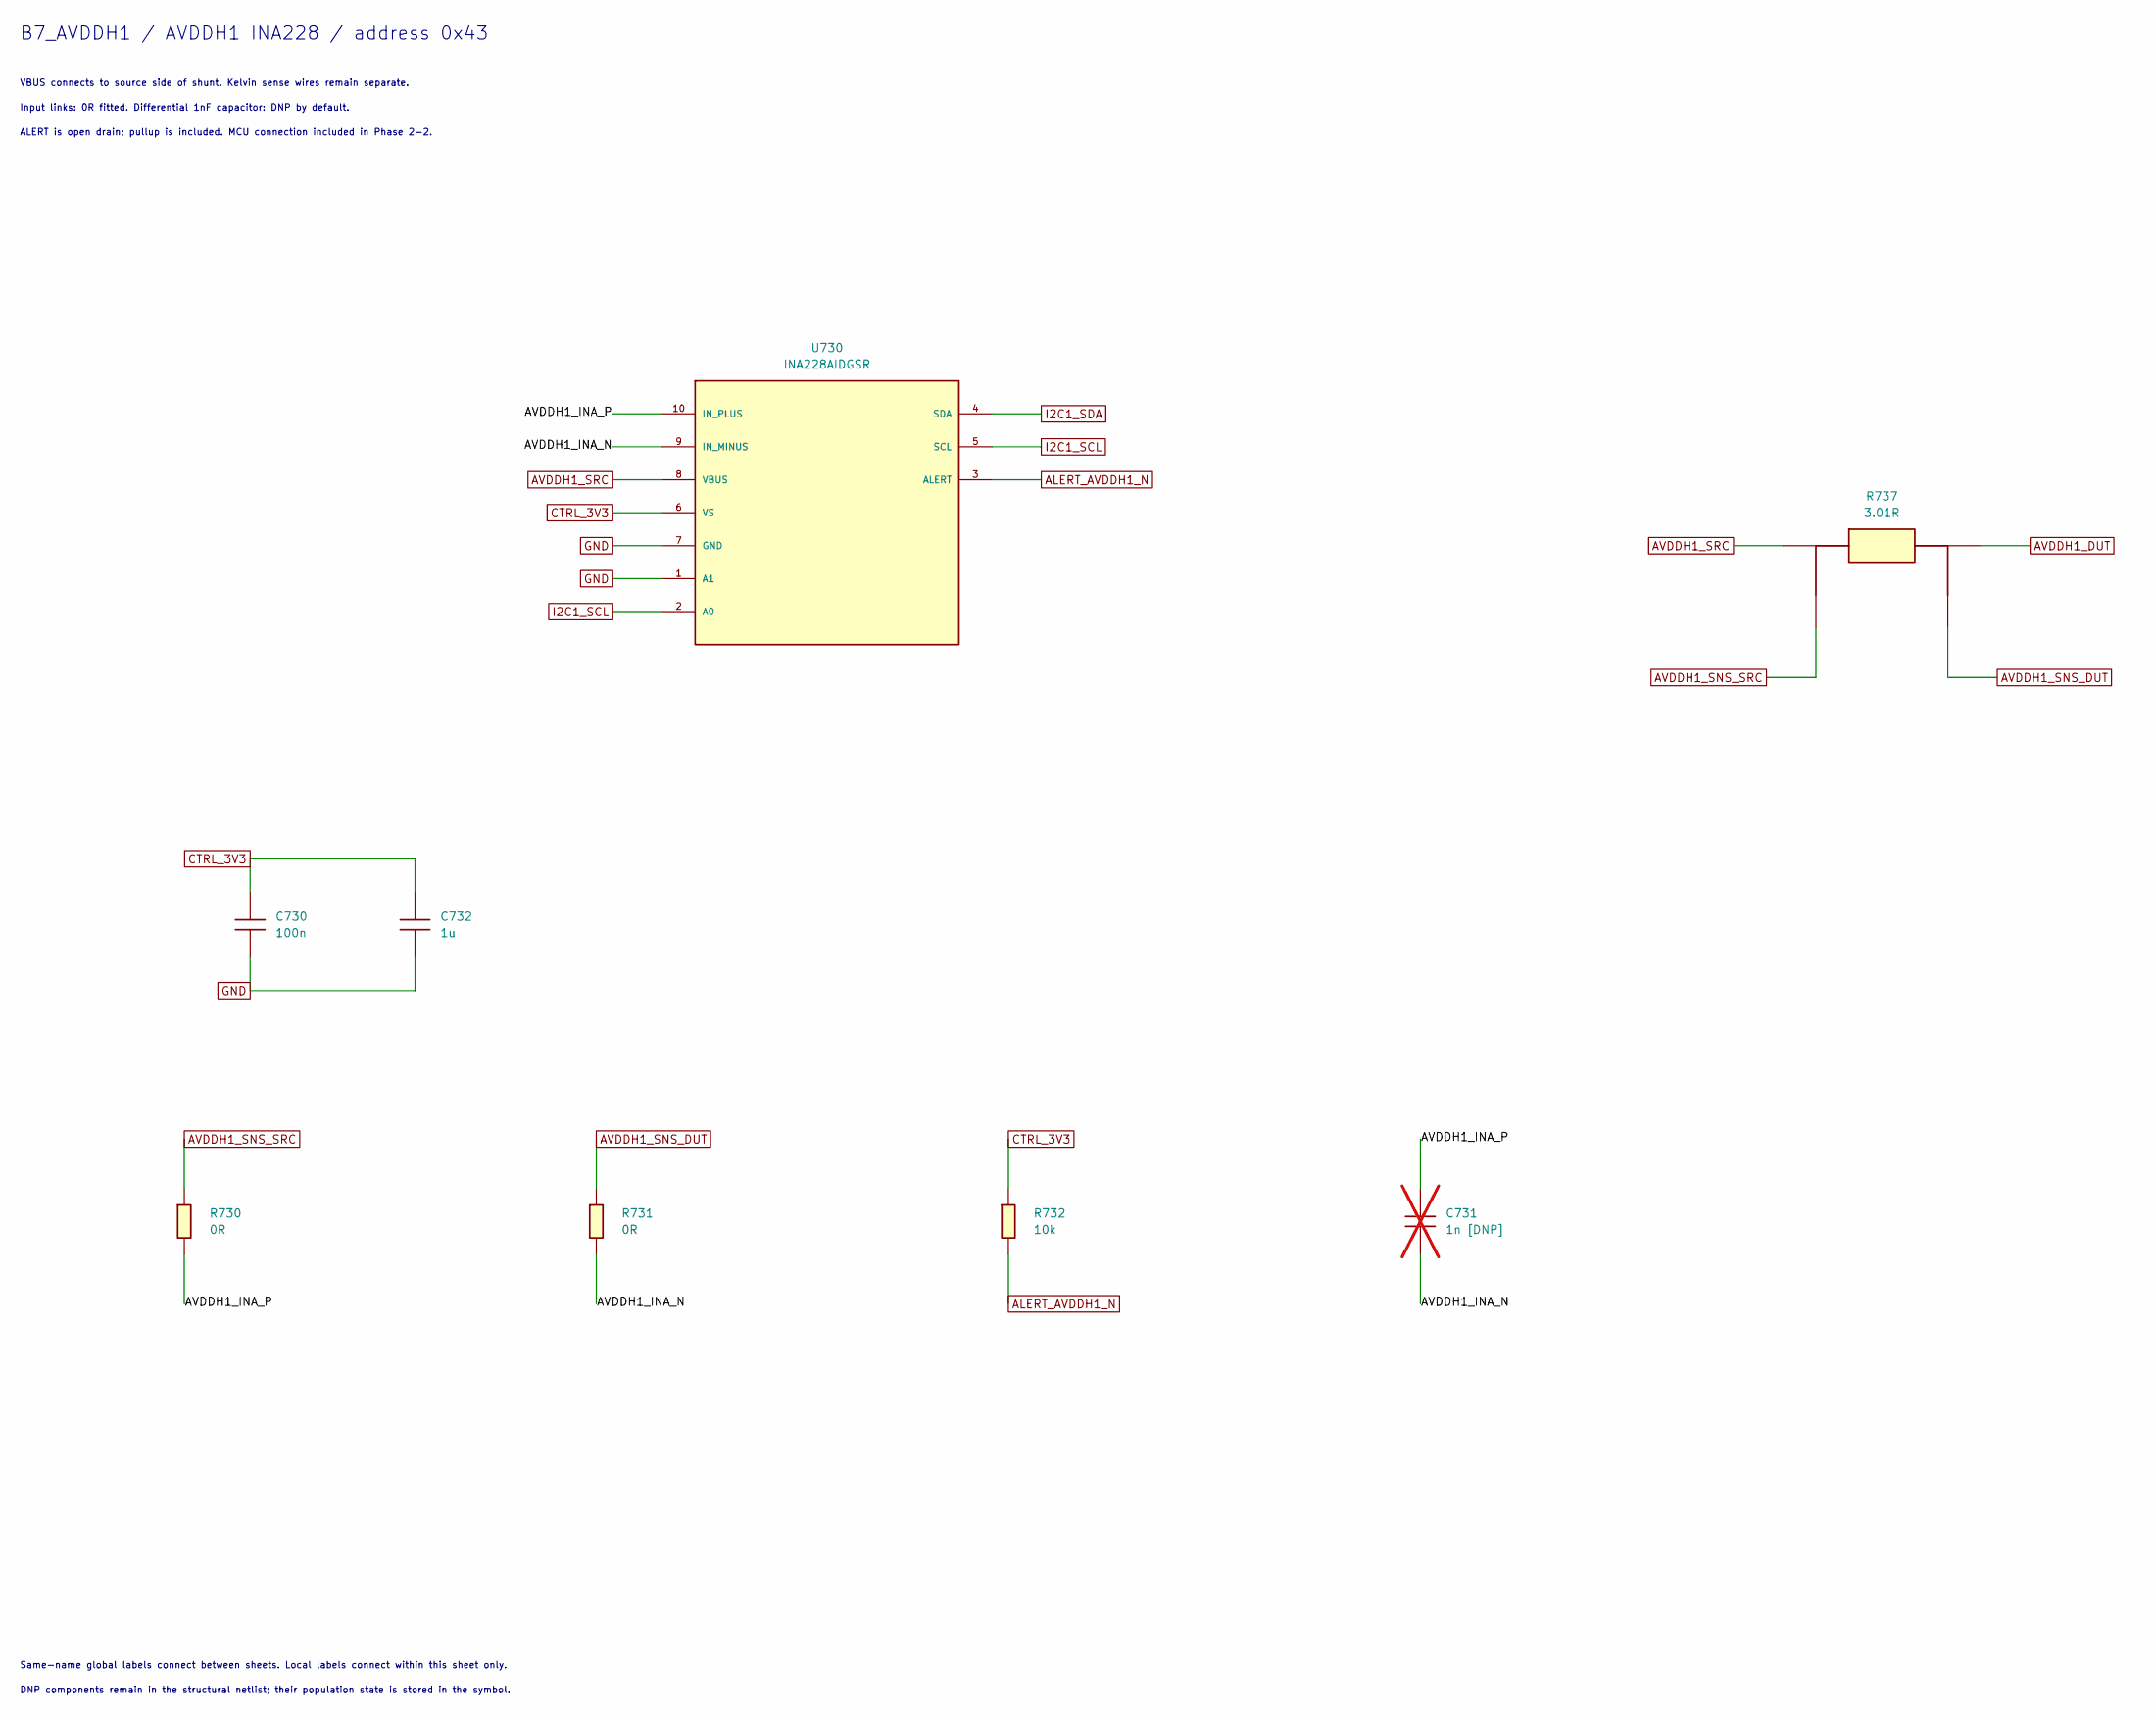
[picture p10: schematic B7_AVDDH1.kicad_sch]

Parts:
C730: 100n; C_0603_1608Metric; Rating 16V X7R ±10%; MPN 확인 필요: 유효용량·누설 검증 후 선정
C731: 1n [DNP]; C_0603_1608Metric; Rating 25V C0G ±5%; MPN 확인 필요: 유효용량·누설 검증 후 선정; not fitted
C732: 1u; C_0603_1608Metric; Rating 16V X7R ±10%; MPN 확인 필요: 유효용량·누설 검증 후 선정
R730, R731: 0R; R_0603_1608Metric; Rating jumper; ≤50mΩ 목표, ≥0.1W; MPN 확인 필요: 지정값·정격 구매품
R732: 10k; R_0603_1608Metric; Rating 1%, ≥0.1W, ≥50V; MPN 확인 필요: 지정값·정격 구매품
R737: 3.01R; Rating 0.1%, ≤25ppm/°C, 0.25W 요구; 발주 원문 확인; MPN RT1206BRD073R01L
U730: INA228AIDGSR; VSSOP-10_3x3mm_P0.5mm; Rating 데이터시트 운용범위 적용; MPN INA228AIDGSR

Connections:
ALERT_AVDDH1_N: R732.2, U730.3 (ALERT)
AVDDH1_DUT: R737.2 (FORCE_DUT)
AVDDH1_INA_N: C731.2, R731.2, U730.9 (IN_MINUS)
AVDDH1_INA_P: C731.1, R730.2, U730.10 (IN_PLUS)
AVDDH1_SNS_DUT: R731.1, R737.4 (SENSE_DUT)
AVDDH1_SNS_SRC: R730.1, R737.3 (SENSE_SRC)
AVDDH1_SRC: R737.1 (FORCE_SRC), U730.8 (VBUS)
CTRL_3V3: C730.1, C732.1, R732.1, U730.6 (VS)
GND: C730.2, C732.2, U730.1 (A1), U730.7 (GND)
I2C1_SCL: U730.2 (A0), U730.5 (SCL)
I2C1_SDA: U730.4 (SDA)

Notes on the sheet:
B7_AVDDH1 / AVDDH1 INA228 / address 0x43
VBUS connects to source side of shunt. Kelvin sense wires remain separate.
Input links: 0R fitted. Differential 1nF capacitor: DNP by default.
ALERT is open drain; pullup is included. MCU connection included in Phase 2-2.
Same-name global labels connect between sheets. Local labels connect within this sheet only.
DNP components remain in the structural netlist; their population state is stored in the symbol.
