Gugong0412/currentboard/R2_REPAIRED_006/B7_AVDDH2.kicad_sch

## KiCad design R2_REPAIRED_006/B7_AVDDH2.kicad_sch (2026-10-15)

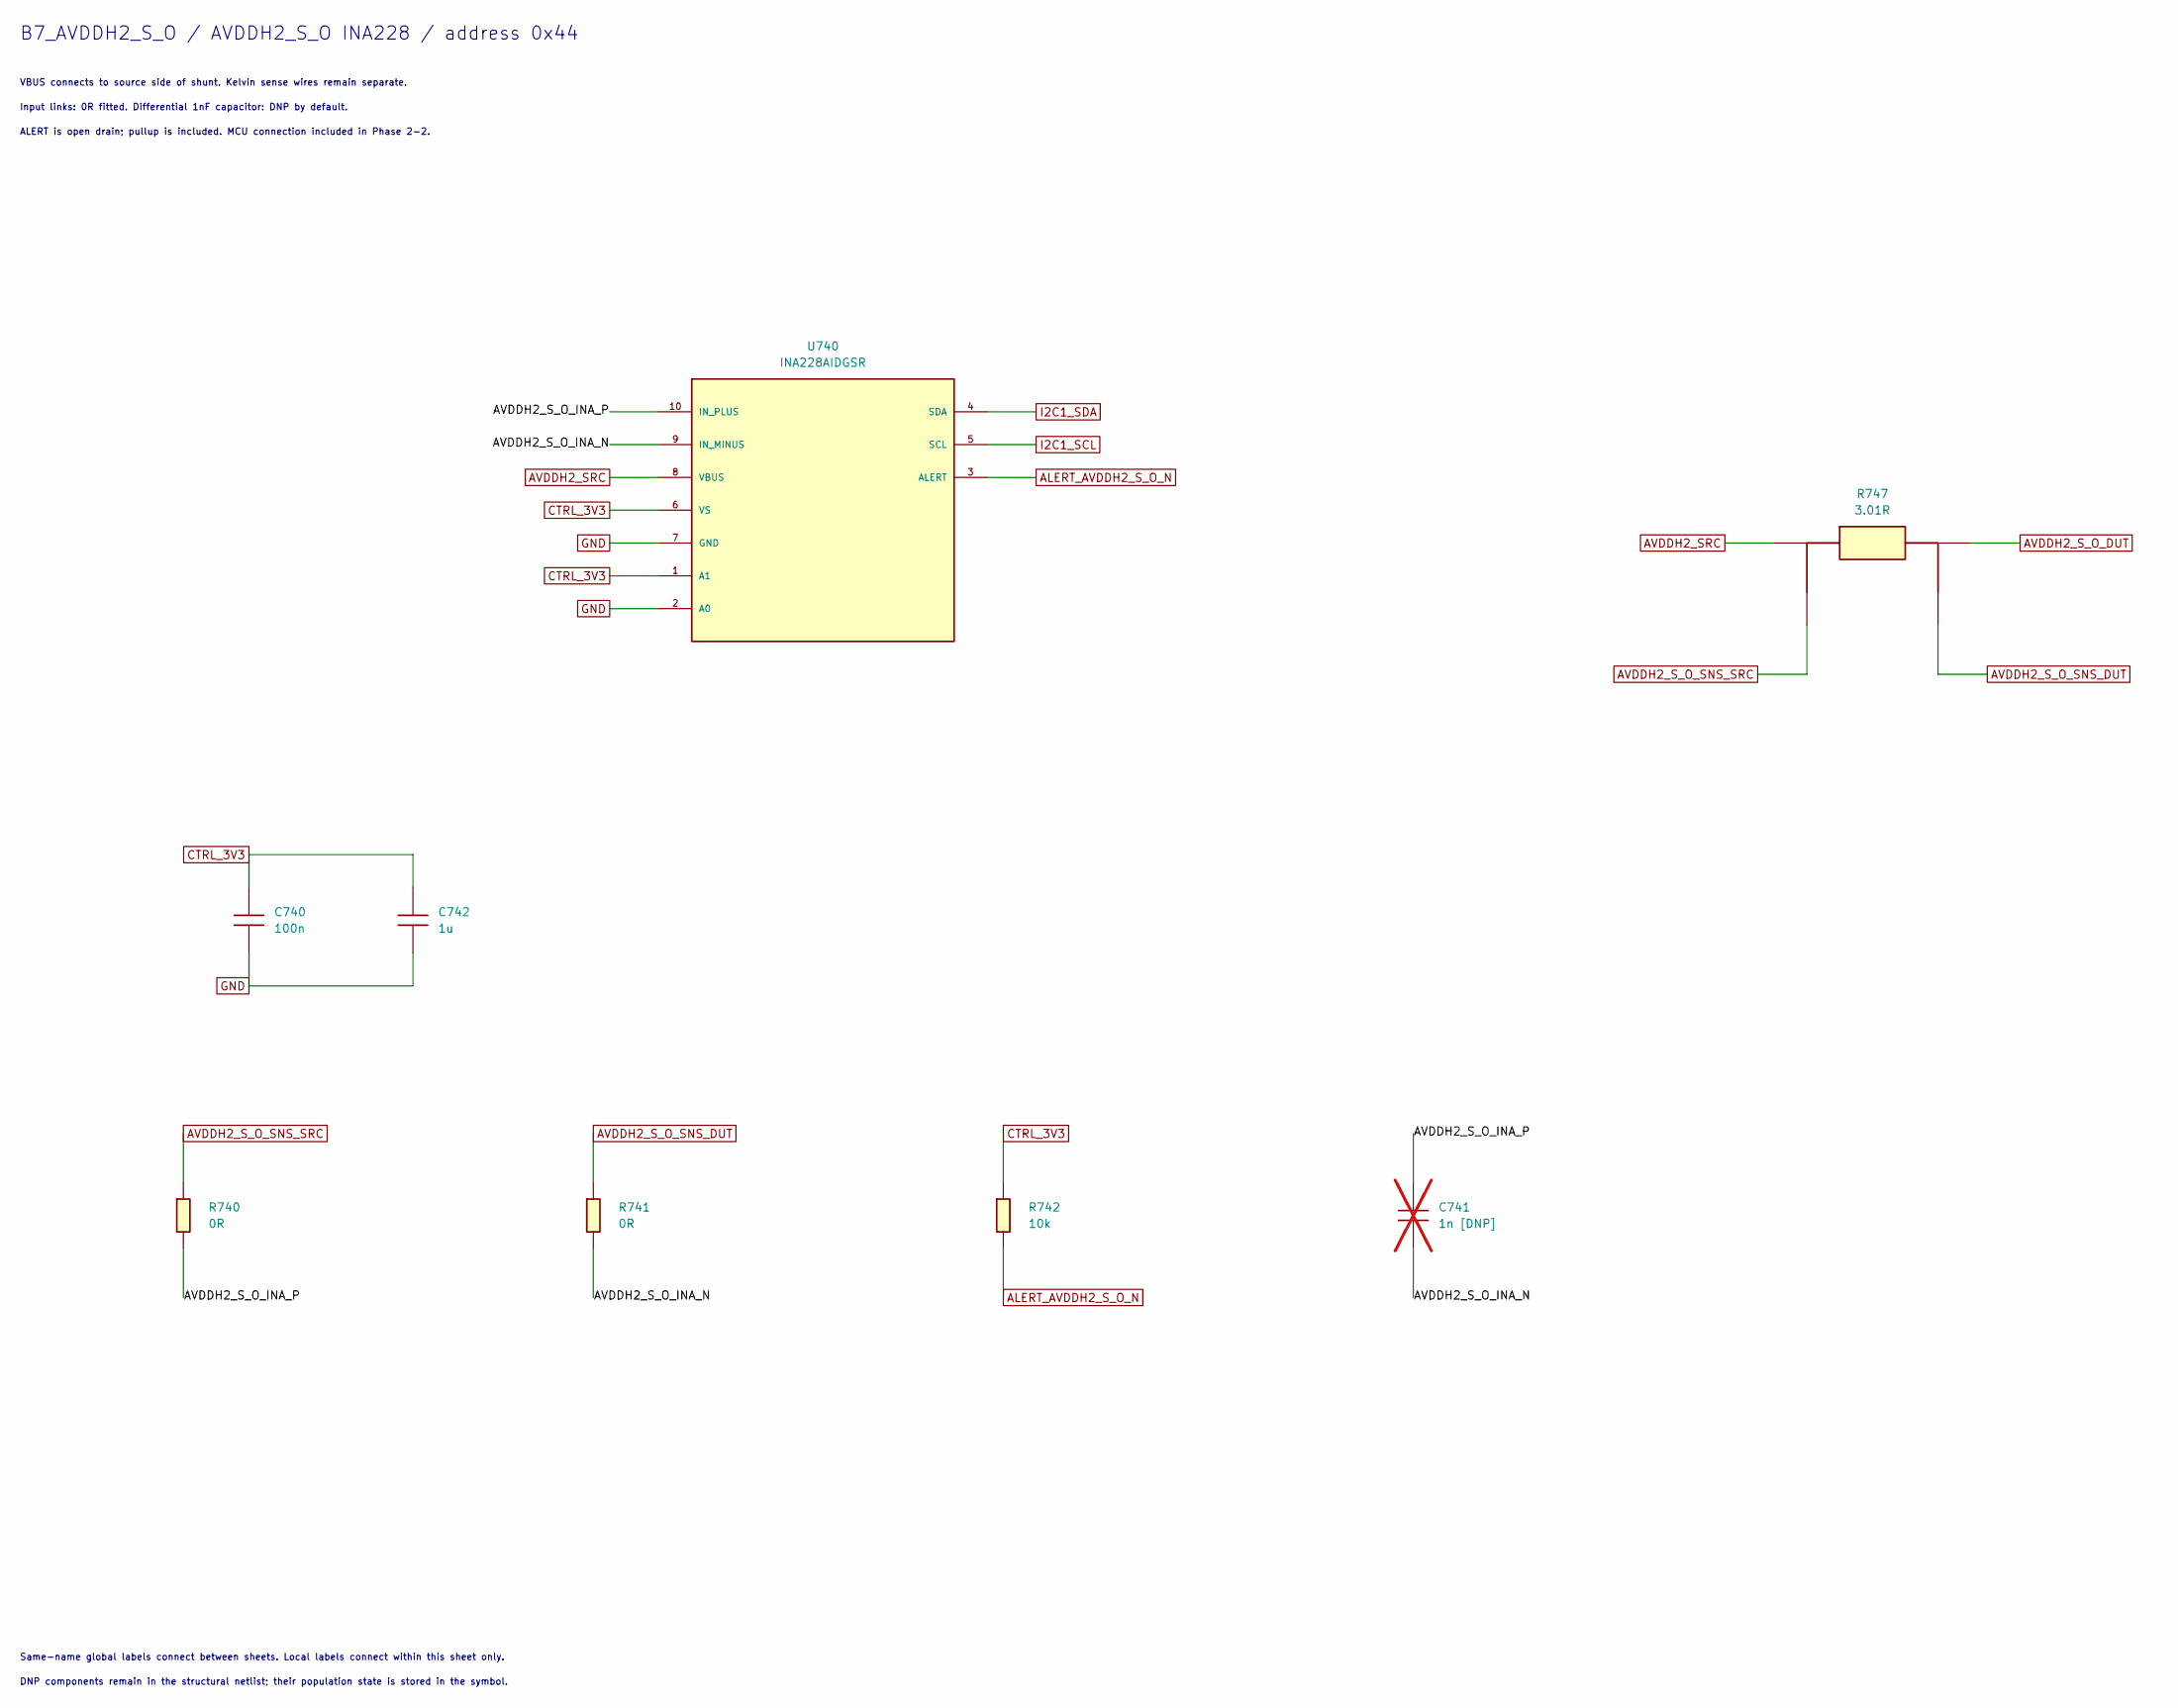
[picture p11: schematic B7_AVDDH2.kicad_sch]

Parts:
C740: 100n; C_0603_1608Metric; Rating 16V X7R ±10%; MPN 확인 필요: 유효용량·누설 검증 후 선정
C741: 1n [DNP]; C_0603_1608Metric; Rating 25V C0G ±5%; MPN 확인 필요: 유효용량·누설 검증 후 선정; not fitted
C742: 1u; C_0603_1608Metric; Rating 16V X7R ±10%; MPN 확인 필요: 유효용량·누설 검증 후 선정
R740, R741: 0R; R_0603_1608Metric; Rating jumper; ≤50mΩ 목표, ≥0.1W; MPN 확인 필요: 지정값·정격 구매품
R742: 10k; R_0603_1608Metric; Rating 1%, ≥0.1W, ≥50V; MPN 확인 필요: 지정값·정격 구매품
R747: 3.01R; Rating 0.1%, ≤25ppm/°C, 0.25W 요구; 발주 원문 확인; MPN RT1206BRD073R01L
U740: INA228AIDGSR; VSSOP-10_3x3mm_P0.5mm; Rating 데이터시트 운용범위 적용; MPN INA228AIDGSR

Connections:
ALERT_AVDDH2_S_O_N: R742.2, U740.3 (ALERT)
AVDDH2_SRC: R747.1 (FORCE_SRC), U740.8 (VBUS)
AVDDH2_S_O_DUT: R747.2 (FORCE_DUT)
AVDDH2_S_O_INA_N: C741.2, R741.2, U740.9 (IN_MINUS)
AVDDH2_S_O_INA_P: C741.1, R740.2, U740.10 (IN_PLUS)
AVDDH2_S_O_SNS_DUT: R741.1, R747.4 (SENSE_DUT)
AVDDH2_S_O_SNS_SRC: R740.1, R747.3 (SENSE_SRC)
CTRL_3V3: C740.1, C742.1, R742.1, U740.1 (A1), U740.6 (VS)
GND: C740.2, C742.2, U740.2 (A0), U740.7 (GND)
I2C1_SCL: U740.5 (SCL)
I2C1_SDA: U740.4 (SDA)

Notes on the sheet:
B7_AVDDH2_S_O / AVDDH2_S_O INA228 / address 0x44
VBUS connects to source side of shunt. Kelvin sense wires remain separate.
Input links: 0R fitted. Differential 1nF capacitor: DNP by default.
ALERT is open drain; pullup is included. MCU connection included in Phase 2-2.
Same-name global labels connect between sheets. Local labels connect within this sheet only.
DNP components remain in the structural netlist; their population state is stored in the symbol.
