Gugong0412/currentboard/R2_REPAIRED_006/B7_AVDDH2_GM.kicad_sch

## KiCad design R2_REPAIRED_006/B7_AVDDH2_GM.kicad_sch (2026-10-15)

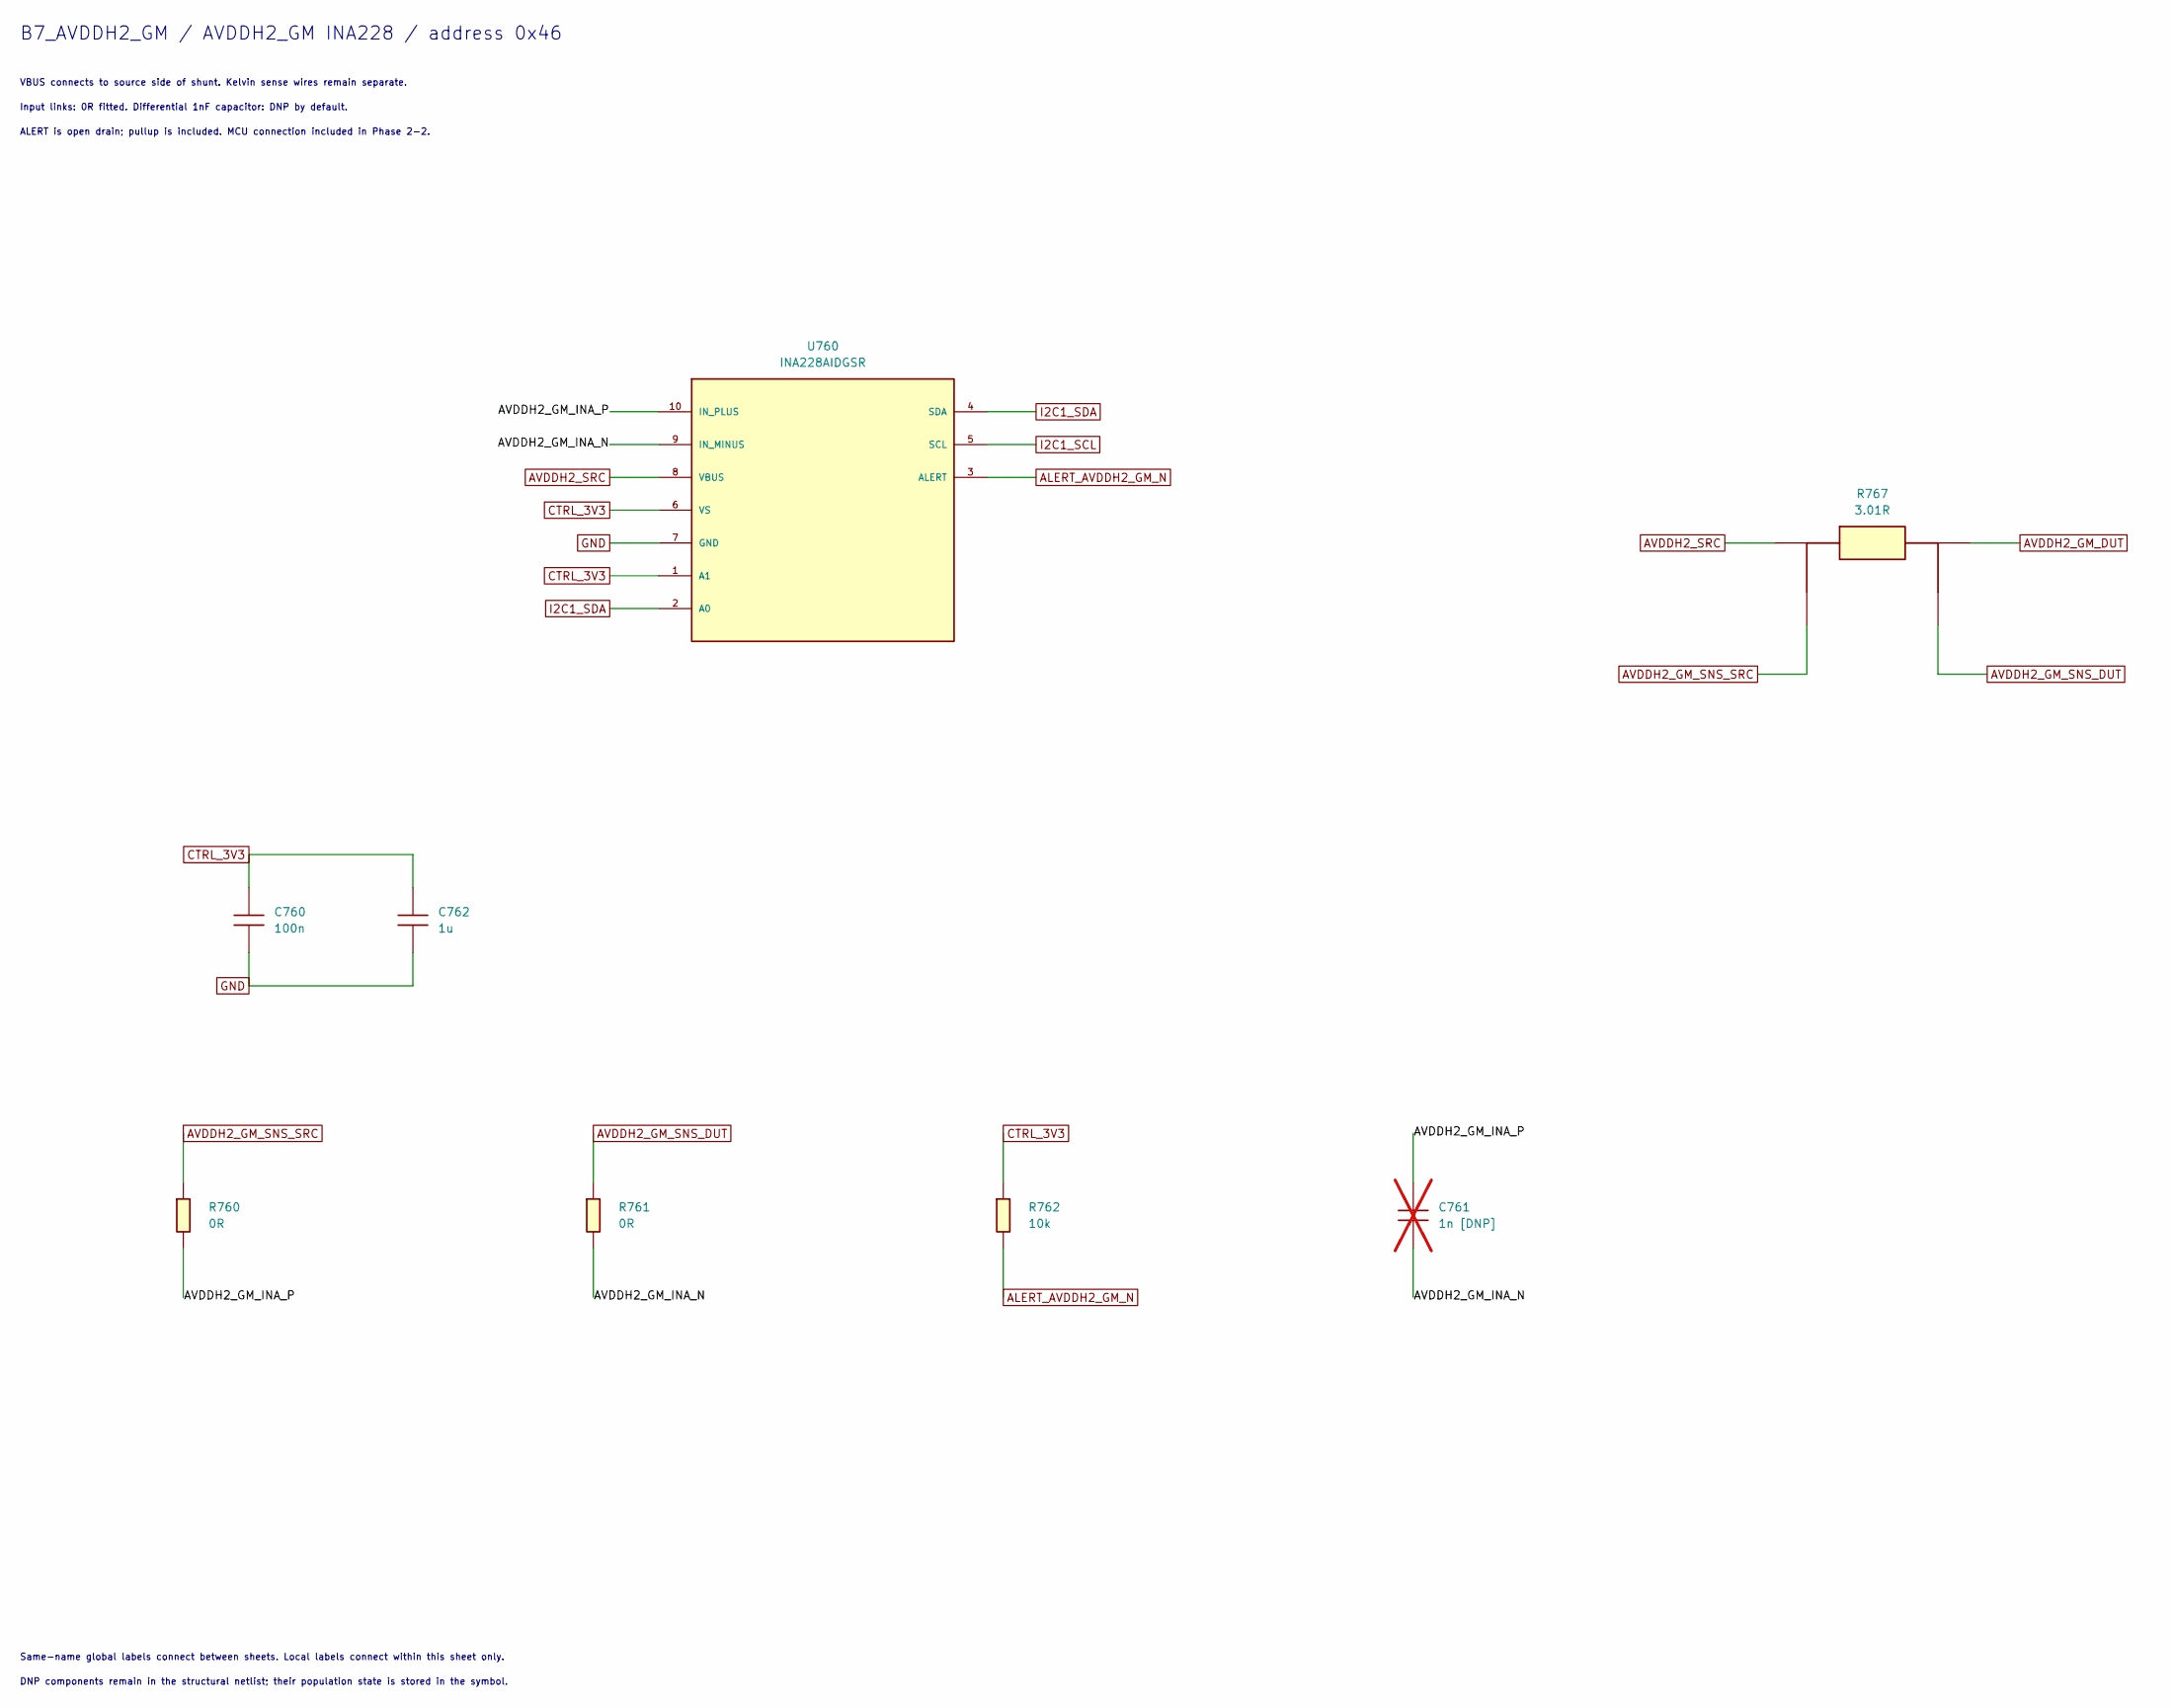
[picture p12: schematic B7_AVDDH2_GM.kicad_sch]

Parts:
C760: 100n; C_0603_1608Metric; Rating 16V X7R ±10%; MPN 확인 필요: 유효용량·누설 검증 후 선정
C761: 1n [DNP]; C_0603_1608Metric; Rating 25V C0G ±5%; MPN 확인 필요: 유효용량·누설 검증 후 선정; not fitted
C762: 1u; C_0603_1608Metric; Rating 16V X7R ±10%; MPN 확인 필요: 유효용량·누설 검증 후 선정
R760, R761: 0R; R_0603_1608Metric; Rating jumper; ≤50mΩ 목표, ≥0.1W; MPN 확인 필요: 지정값·정격 구매품
R762: 10k; R_0603_1608Metric; Rating 1%, ≥0.1W, ≥50V; MPN 확인 필요: 지정값·정격 구매품
R767: 3.01R; Rating 0.1%, ≤25ppm/°C, 0.25W 요구; 발주 원문 확인; MPN RT1206BRD073R01L
U760: INA228AIDGSR; VSSOP-10_3x3mm_P0.5mm; Rating 데이터시트 운용범위 적용; MPN INA228AIDGSR

Connections:
ALERT_AVDDH2_GM_N: R762.2, U760.3 (ALERT)
AVDDH2_GM_DUT: R767.2 (FORCE_DUT)
AVDDH2_GM_INA_N: C761.2, R761.2, U760.9 (IN_MINUS)
AVDDH2_GM_INA_P: C761.1, R760.2, U760.10 (IN_PLUS)
AVDDH2_GM_SNS_DUT: R761.1, R767.4 (SENSE_DUT)
AVDDH2_GM_SNS_SRC: R760.1, R767.3 (SENSE_SRC)
AVDDH2_SRC: R767.1 (FORCE_SRC), U760.8 (VBUS)
CTRL_3V3: C760.1, C762.1, R762.1, U760.1 (A1), U760.6 (VS)
GND: C760.2, C762.2, U760.7 (GND)
I2C1_SCL: U760.5 (SCL)
I2C1_SDA: U760.2 (A0), U760.4 (SDA)

Notes on the sheet:
B7_AVDDH2_GM / AVDDH2_GM INA228 / address 0x46
VBUS connects to source side of shunt. Kelvin sense wires remain separate.
Input links: 0R fitted. Differential 1nF capacitor: DNP by default.
ALERT is open drain; pullup is included. MCU connection included in Phase 2-2.
Same-name global labels connect between sheets. Local labels connect within this sheet only.
DNP components remain in the structural netlist; their population state is stored in the symbol.
