Gugong0412/currentboard/R2_REPAIRED_006/B7_VCI.kicad_sch

## KiCad design R2_REPAIRED_006/B7_VCI.kicad_sch (2026-10-15)

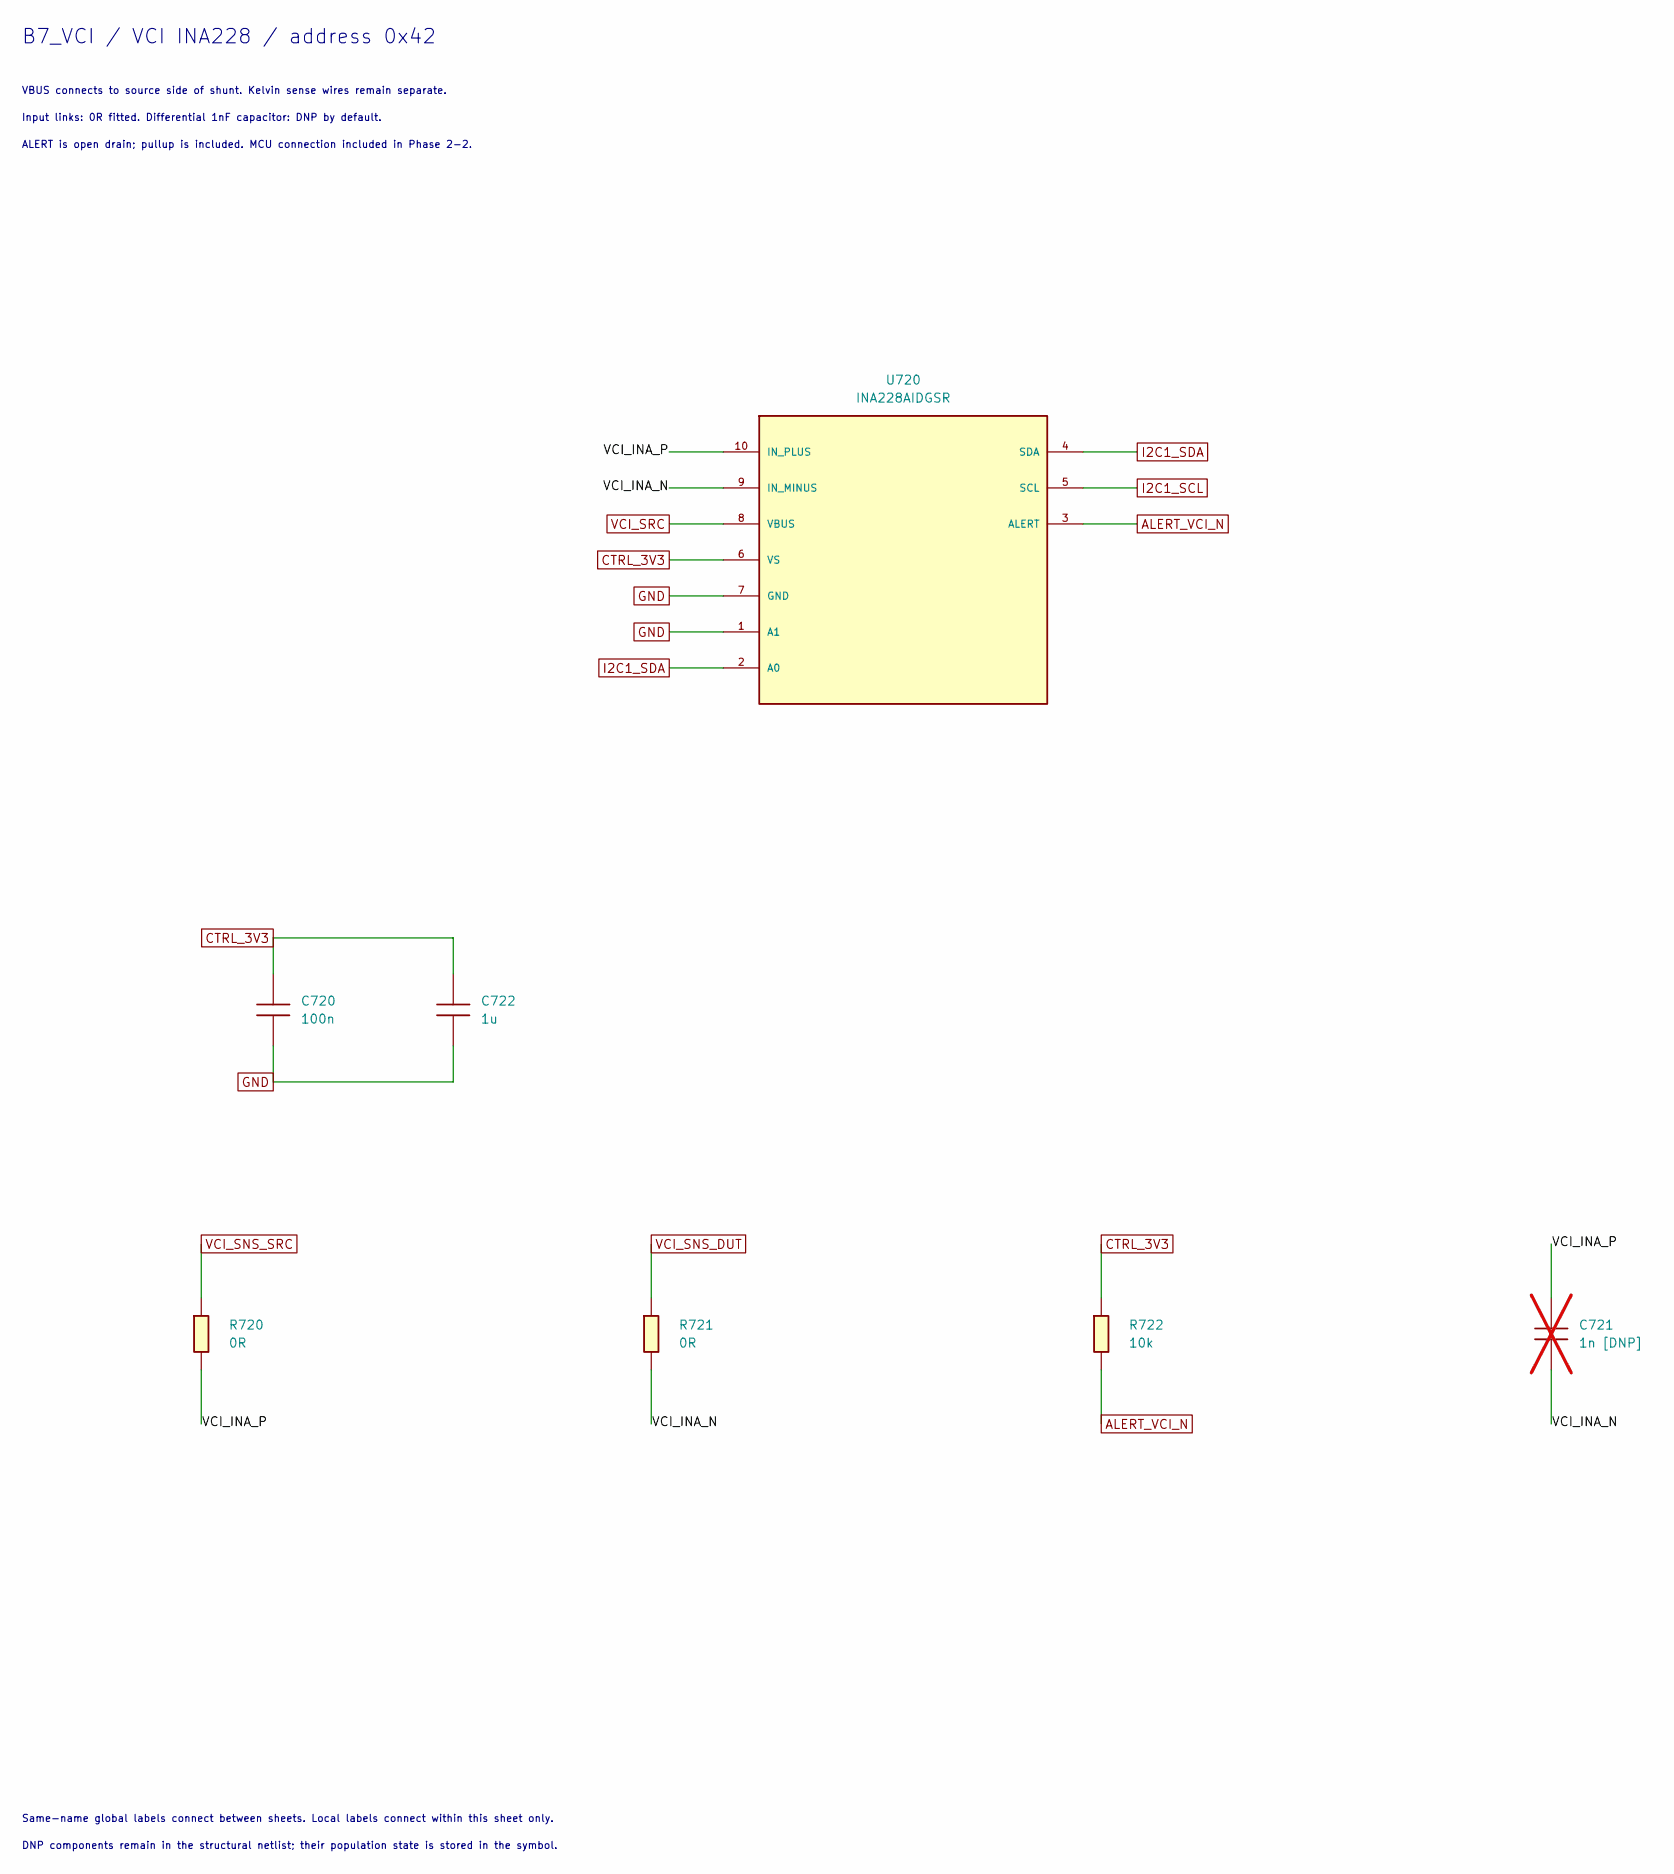
[picture p13: schematic B7_VCI.kicad_sch]

Parts:
C720: 100n; C_0603_1608Metric; Rating 16V X7R ±10%; MPN 확인 필요: 유효용량·누설 검증 후 선정
C721: 1n [DNP]; C_0603_1608Metric; Rating 25V C0G ±5%; MPN 확인 필요: 유효용량·누설 검증 후 선정; not fitted
C722: 1u; C_0603_1608Metric; Rating 16V X7R ±10%; MPN 확인 필요: 유효용량·누설 검증 후 선정
R720, R721: 0R; R_0603_1608Metric; Rating jumper; ≤50mΩ 목표, ≥0.1W; MPN 확인 필요: 지정값·정격 구매품
R722: 10k; R_0603_1608Metric; Rating 1%, ≥0.1W, ≥50V; MPN 확인 필요: 지정값·정격 구매품
U720: INA228AIDGSR; VSSOP-10_3x3mm_P0.5mm; Rating 데이터시트 운용범위 적용; MPN INA228AIDGSR

Connections:
ALERT_VCI_N: R722.2, U720.3 (ALERT)
CTRL_3V3: C720.1, C722.1, R722.1, U720.6 (VS)
GND: C720.2, C722.2, U720.1 (A1), U720.7 (GND)
I2C1_SCL: U720.5 (SCL)
I2C1_SDA: U720.2 (A0), U720.4 (SDA)
VCI_INA_N: C721.2, R721.2, U720.9 (IN_MINUS)
VCI_INA_P: C721.1, R720.2, U720.10 (IN_PLUS)
VCI_SNS_DUT: R721.1
VCI_SNS_SRC: R720.1
VCI_SRC: U720.8 (VBUS)

Notes on the sheet:
B7_VCI / VCI INA228 / address 0x42
VBUS connects to source side of shunt. Kelvin sense wires remain separate.
Input links: 0R fitted. Differential 1nF capacitor: DNP by default.
ALERT is open drain; pullup is included. MCU connection included in Phase 2-2.
Same-name global labels connect between sheets. Local labels connect within this sheet only.
DNP components remain in the structural netlist; their population state is stored in the symbol.
