Gugong0412/currentboard/R2_REPAIRED_006/B7_VDDI.kicad_sch

## KiCad design R2_REPAIRED_006/B7_VDDI.kicad_sch (2026-10-15)

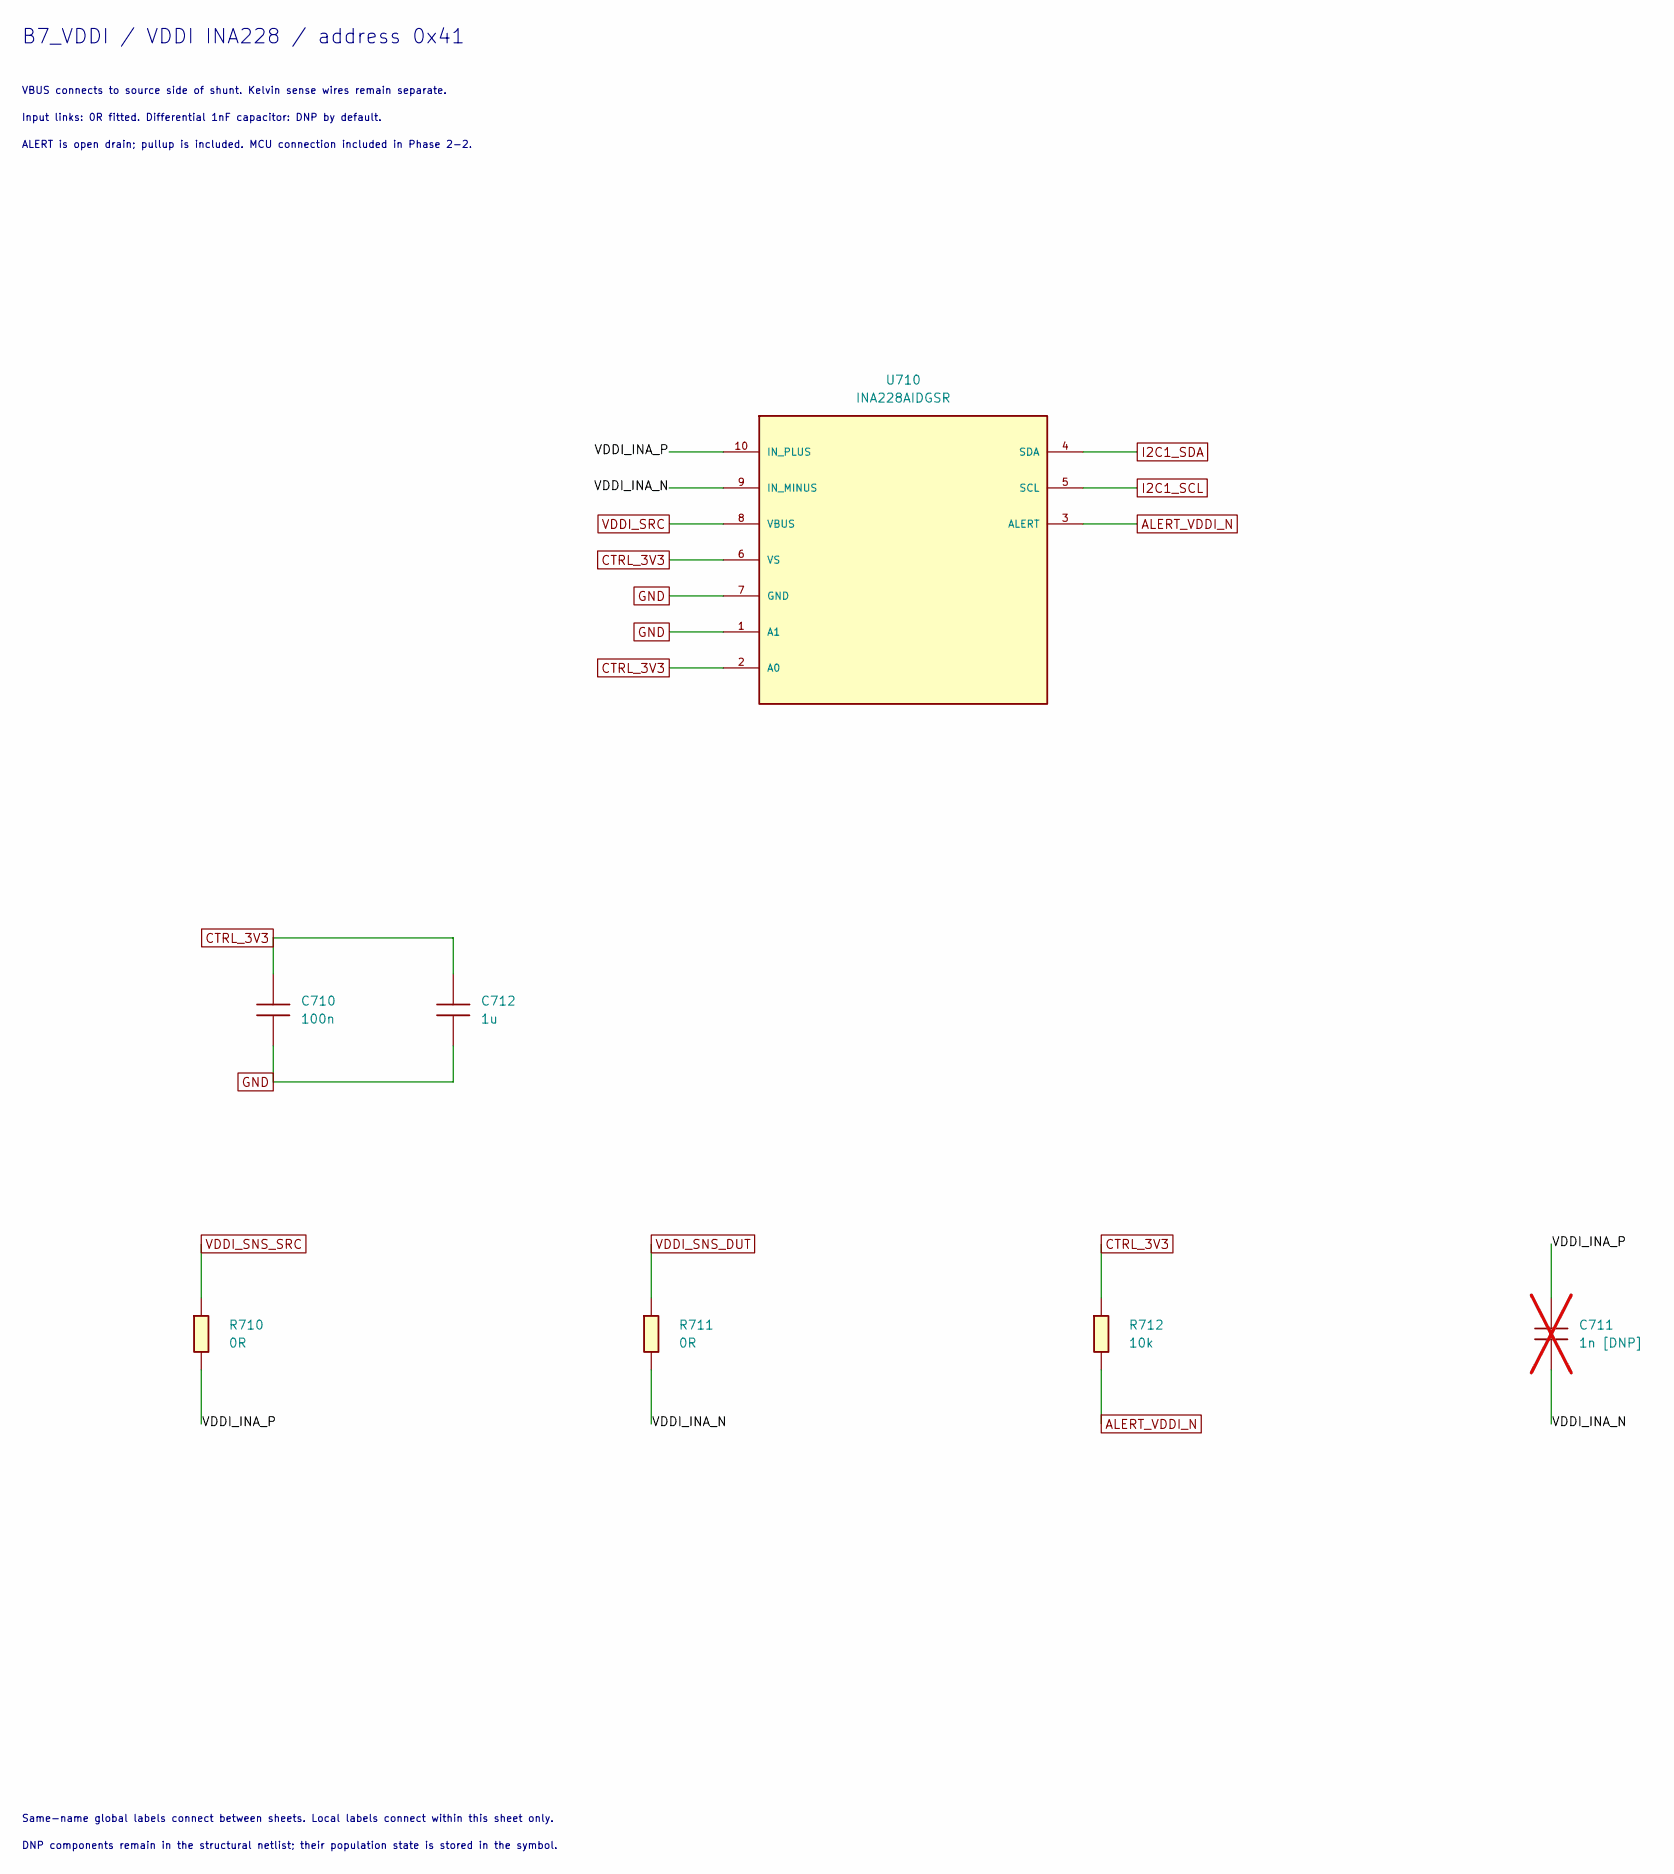
[picture p14: schematic B7_VDDI.kicad_sch]

Parts:
C710: 100n; C_0603_1608Metric; Rating 16V X7R ±10%; MPN 확인 필요: 유효용량·누설 검증 후 선정
C711: 1n [DNP]; C_0603_1608Metric; Rating 25V C0G ±5%; MPN 확인 필요: 유효용량·누설 검증 후 선정; not fitted
C712: 1u; C_0603_1608Metric; Rating 16V X7R ±10%; MPN 확인 필요: 유효용량·누설 검증 후 선정
R710, R711: 0R; R_0603_1608Metric; Rating jumper; ≤50mΩ 목표, ≥0.1W; MPN 확인 필요: 지정값·정격 구매품
R712: 10k; R_0603_1608Metric; Rating 1%, ≥0.1W, ≥50V; MPN 확인 필요: 지정값·정격 구매품
U710: INA228AIDGSR; VSSOP-10_3x3mm_P0.5mm; Rating 데이터시트 운용범위 적용; MPN INA228AIDGSR

Connections:
ALERT_VDDI_N: R712.2, U710.3 (ALERT)
CTRL_3V3: C710.1, C712.1, R712.1, U710.2 (A0), U710.6 (VS)
GND: C710.2, C712.2, U710.1 (A1), U710.7 (GND)
I2C1_SCL: U710.5 (SCL)
I2C1_SDA: U710.4 (SDA)
VDDI_INA_N: C711.2, R711.2, U710.9 (IN_MINUS)
VDDI_INA_P: C711.1, R710.2, U710.10 (IN_PLUS)
VDDI_SNS_DUT: R711.1
VDDI_SNS_SRC: R710.1
VDDI_SRC: U710.8 (VBUS)

Notes on the sheet:
B7_VDDI / VDDI INA228 / address 0x41
VBUS connects to source side of shunt. Kelvin sense wires remain separate.
Input links: 0R fitted. Differential 1nF capacitor: DNP by default.
ALERT is open drain; pullup is included. MCU connection included in Phase 2-2.
Same-name global labels connect between sheets. Local labels connect within this sheet only.
DNP components remain in the structural netlist; their population state is stored in the symbol.
