Gugong0412/currentboard/R2_REPAIRED_006/B7_VDDI_DIG.kicad_sch

## KiCad design R2_REPAIRED_006/B7_VDDI_DIG.kicad_sch (2026-10-15)

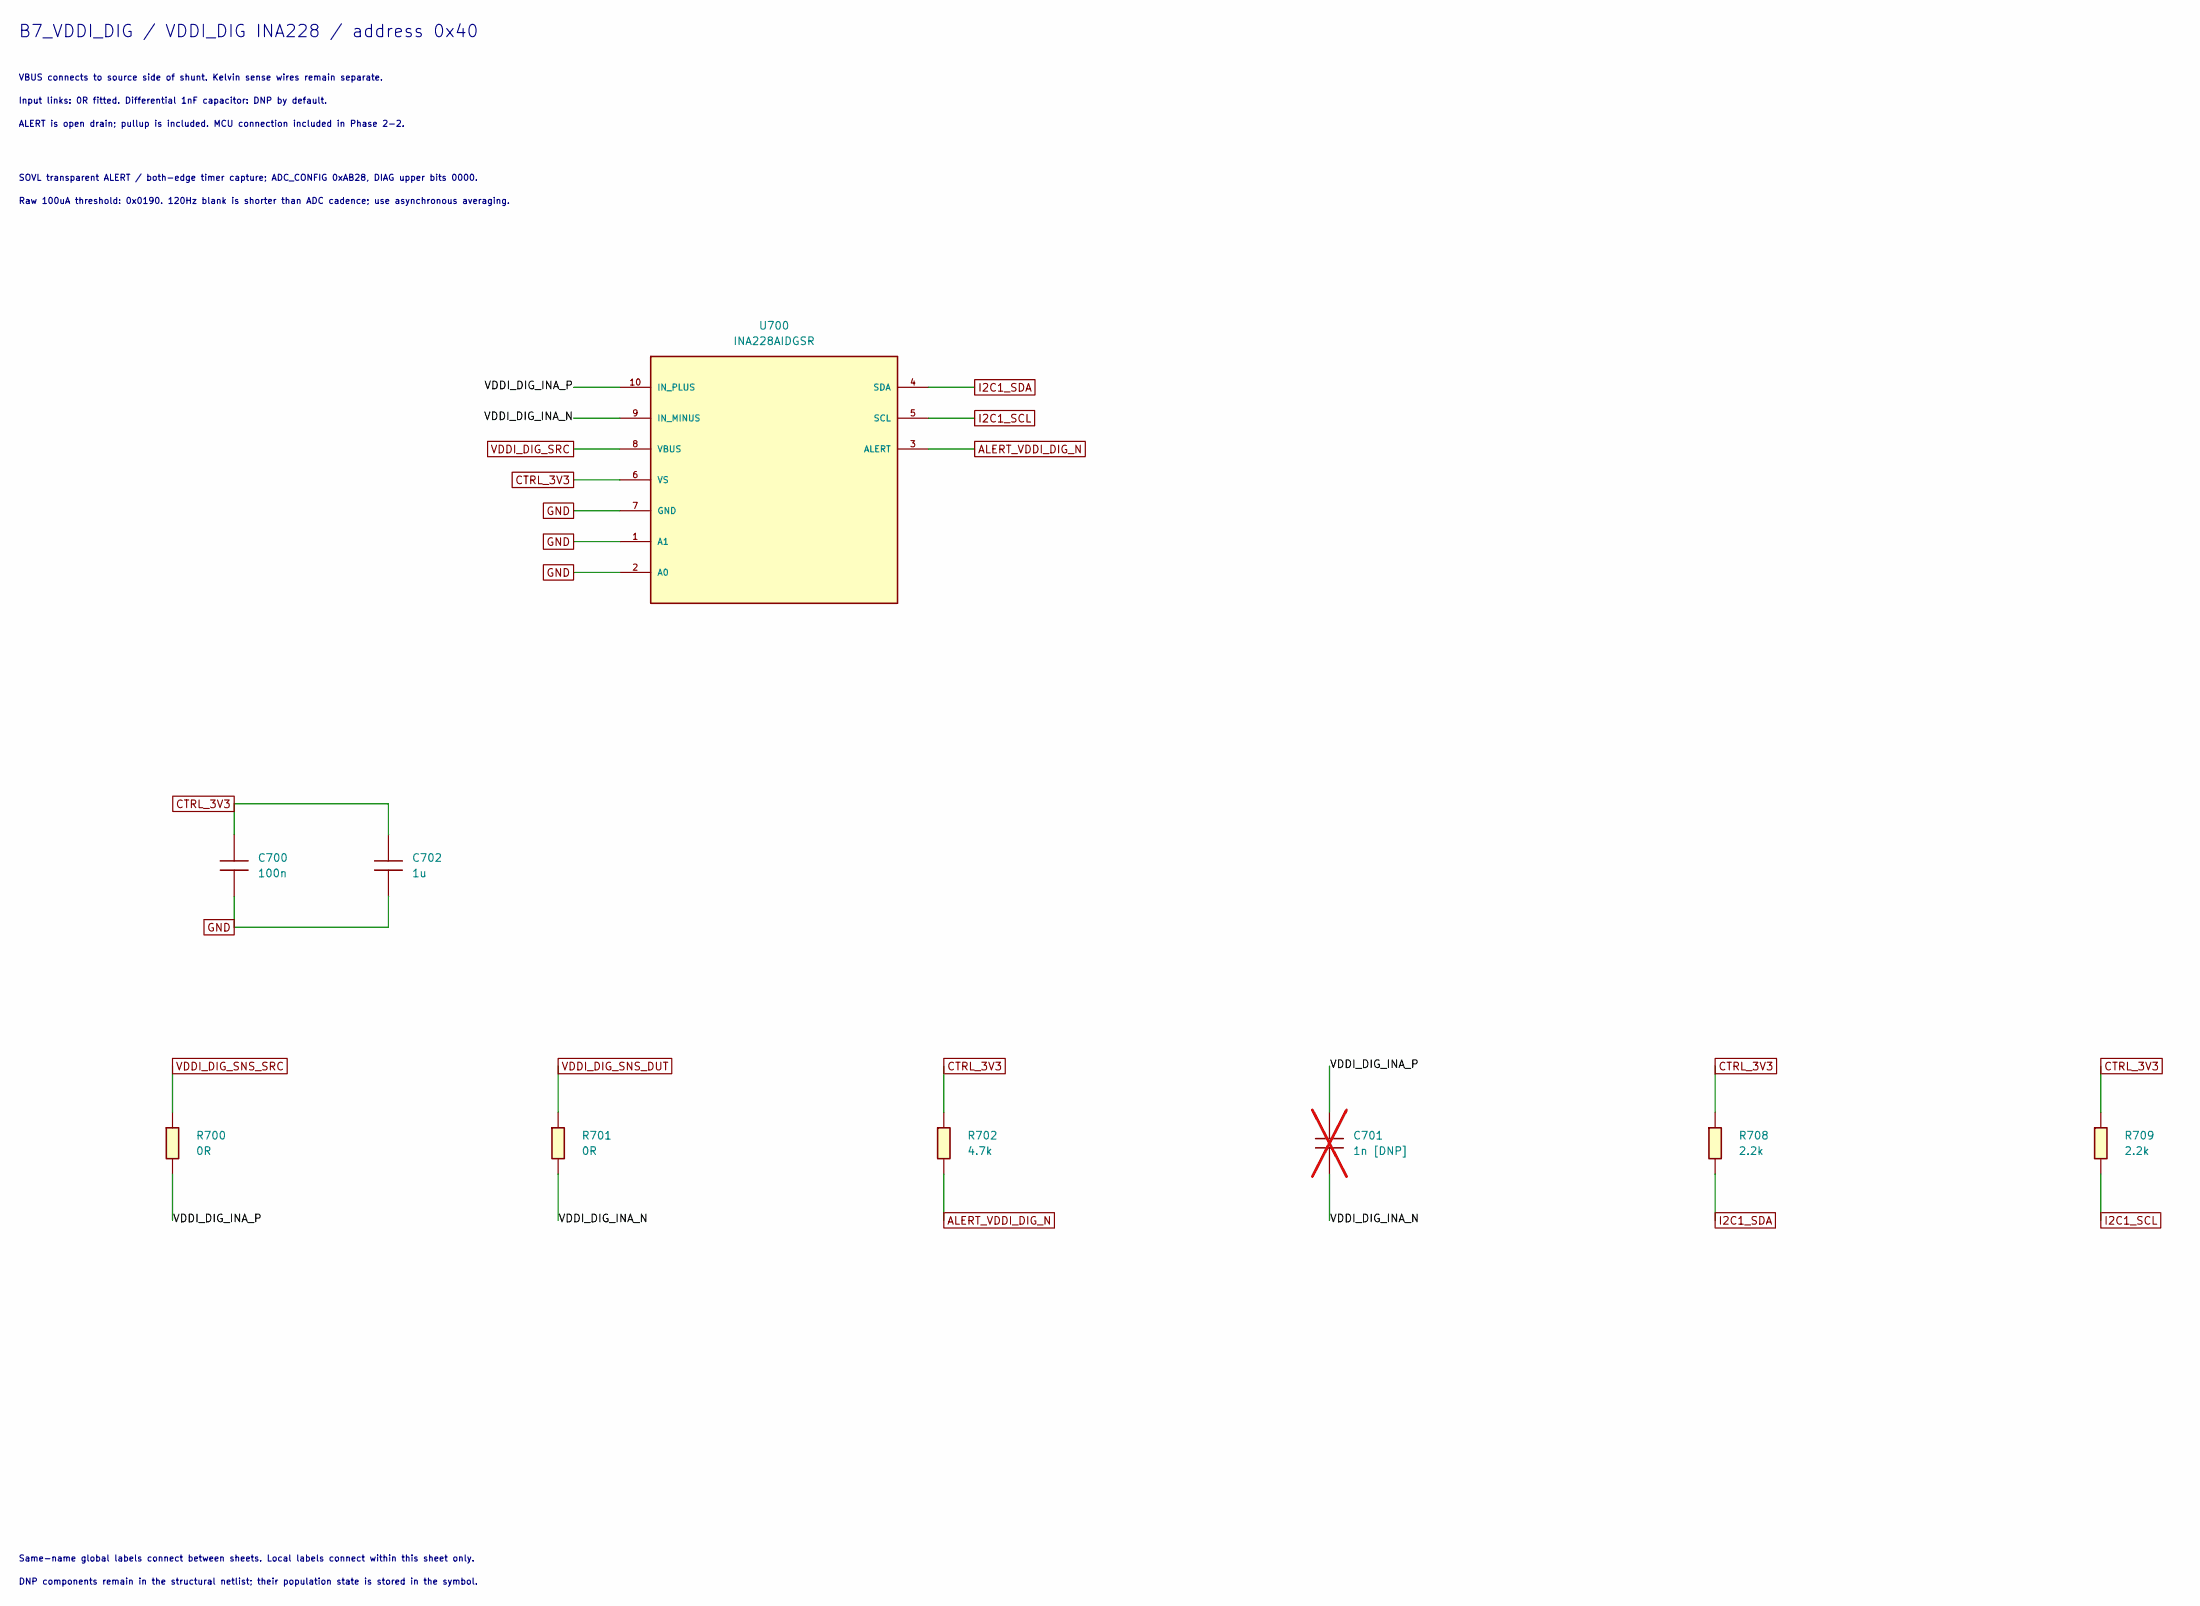
[picture p15: schematic B7_VDDI_DIG.kicad_sch]

Parts:
C700: 100n; C_0603_1608Metric; Rating 16V X7R ±10%; MPN 확인 필요: 유효용량·누설 검증 후 선정
C701: 1n [DNP]; C_0603_1608Metric; Rating 25V C0G ±5%; MPN 확인 필요: 유효용량·누설 검증 후 선정; not fitted
C702: 1u; C_0603_1608Metric; Rating 16V X7R ±10%; MPN 확인 필요: 유효용량·누설 검증 후 선정
R700, R701: 0R; R_0603_1608Metric; Rating jumper; ≤50mΩ 목표, ≥0.1W; MPN 확인 필요: 지정값·정격 구매품
R702: 4.7k; R_0603_1608Metric; Rating 1%, ≥0.1W, ≥50V; MPN 확인 필요: 지정값·정격 구매품
R708, R709: 2.2k; R_0603_1608Metric; Rating 1%, ≥0.1W, ≥50V; MPN 확인 필요: 지정값·정격 구매품
U700: INA228AIDGSR; VSSOP-10_3x3mm_P0.5mm; Rating 데이터시트 운용범위 적용; MPN INA228AIDGSR

Connections:
ALERT_VDDI_DIG_N: R702.2, U700.3 (ALERT)
CTRL_3V3: C700.1, C702.1, R702.1, R708.1, R709.1, U700.6 (VS)
GND: C700.2, C702.2, U700.1 (A1), U700.2 (A0), U700.7 (GND)
I2C1_SCL: R709.2, U700.5 (SCL)
I2C1_SDA: R708.2, U700.4 (SDA)
VDDI_DIG_INA_N: C701.2, R701.2, U700.9 (IN_MINUS)
VDDI_DIG_INA_P: C701.1, R700.2, U700.10 (IN_PLUS)
VDDI_DIG_SNS_DUT: R701.1
VDDI_DIG_SNS_SRC: R700.1
VDDI_DIG_SRC: U700.8 (VBUS)

Notes on the sheet:
B7_VDDI_DIG / VDDI_DIG INA228 / address 0x40
VBUS connects to source side of shunt. Kelvin sense wires remain separate.
Input links: 0R fitted. Differential 1nF capacitor: DNP by default.
ALERT is open drain; pullup is included. MCU connection included in Phase 2-2.
SOVL transparent ALERT / both-edge timer capture; ADC_CONFIG 0xAB28, DIAG upper bits 0000.
Raw 100uA threshold: 0x0190. 120Hz blank is shorter than ADC cadence; use asynchronous averaging.
Same-name global labels connect between sheets. Local labels connect within this sheet only.
DNP components remain in the structural netlist; their population state is stored in the symbol.
