Gugong0412/currentboard/R2_REPAIRED_006/B7_VDDI_LPDP.kicad_sch

## KiCad design R2_REPAIRED_006/B7_VDDI_LPDP.kicad_sch (2026-10-15)

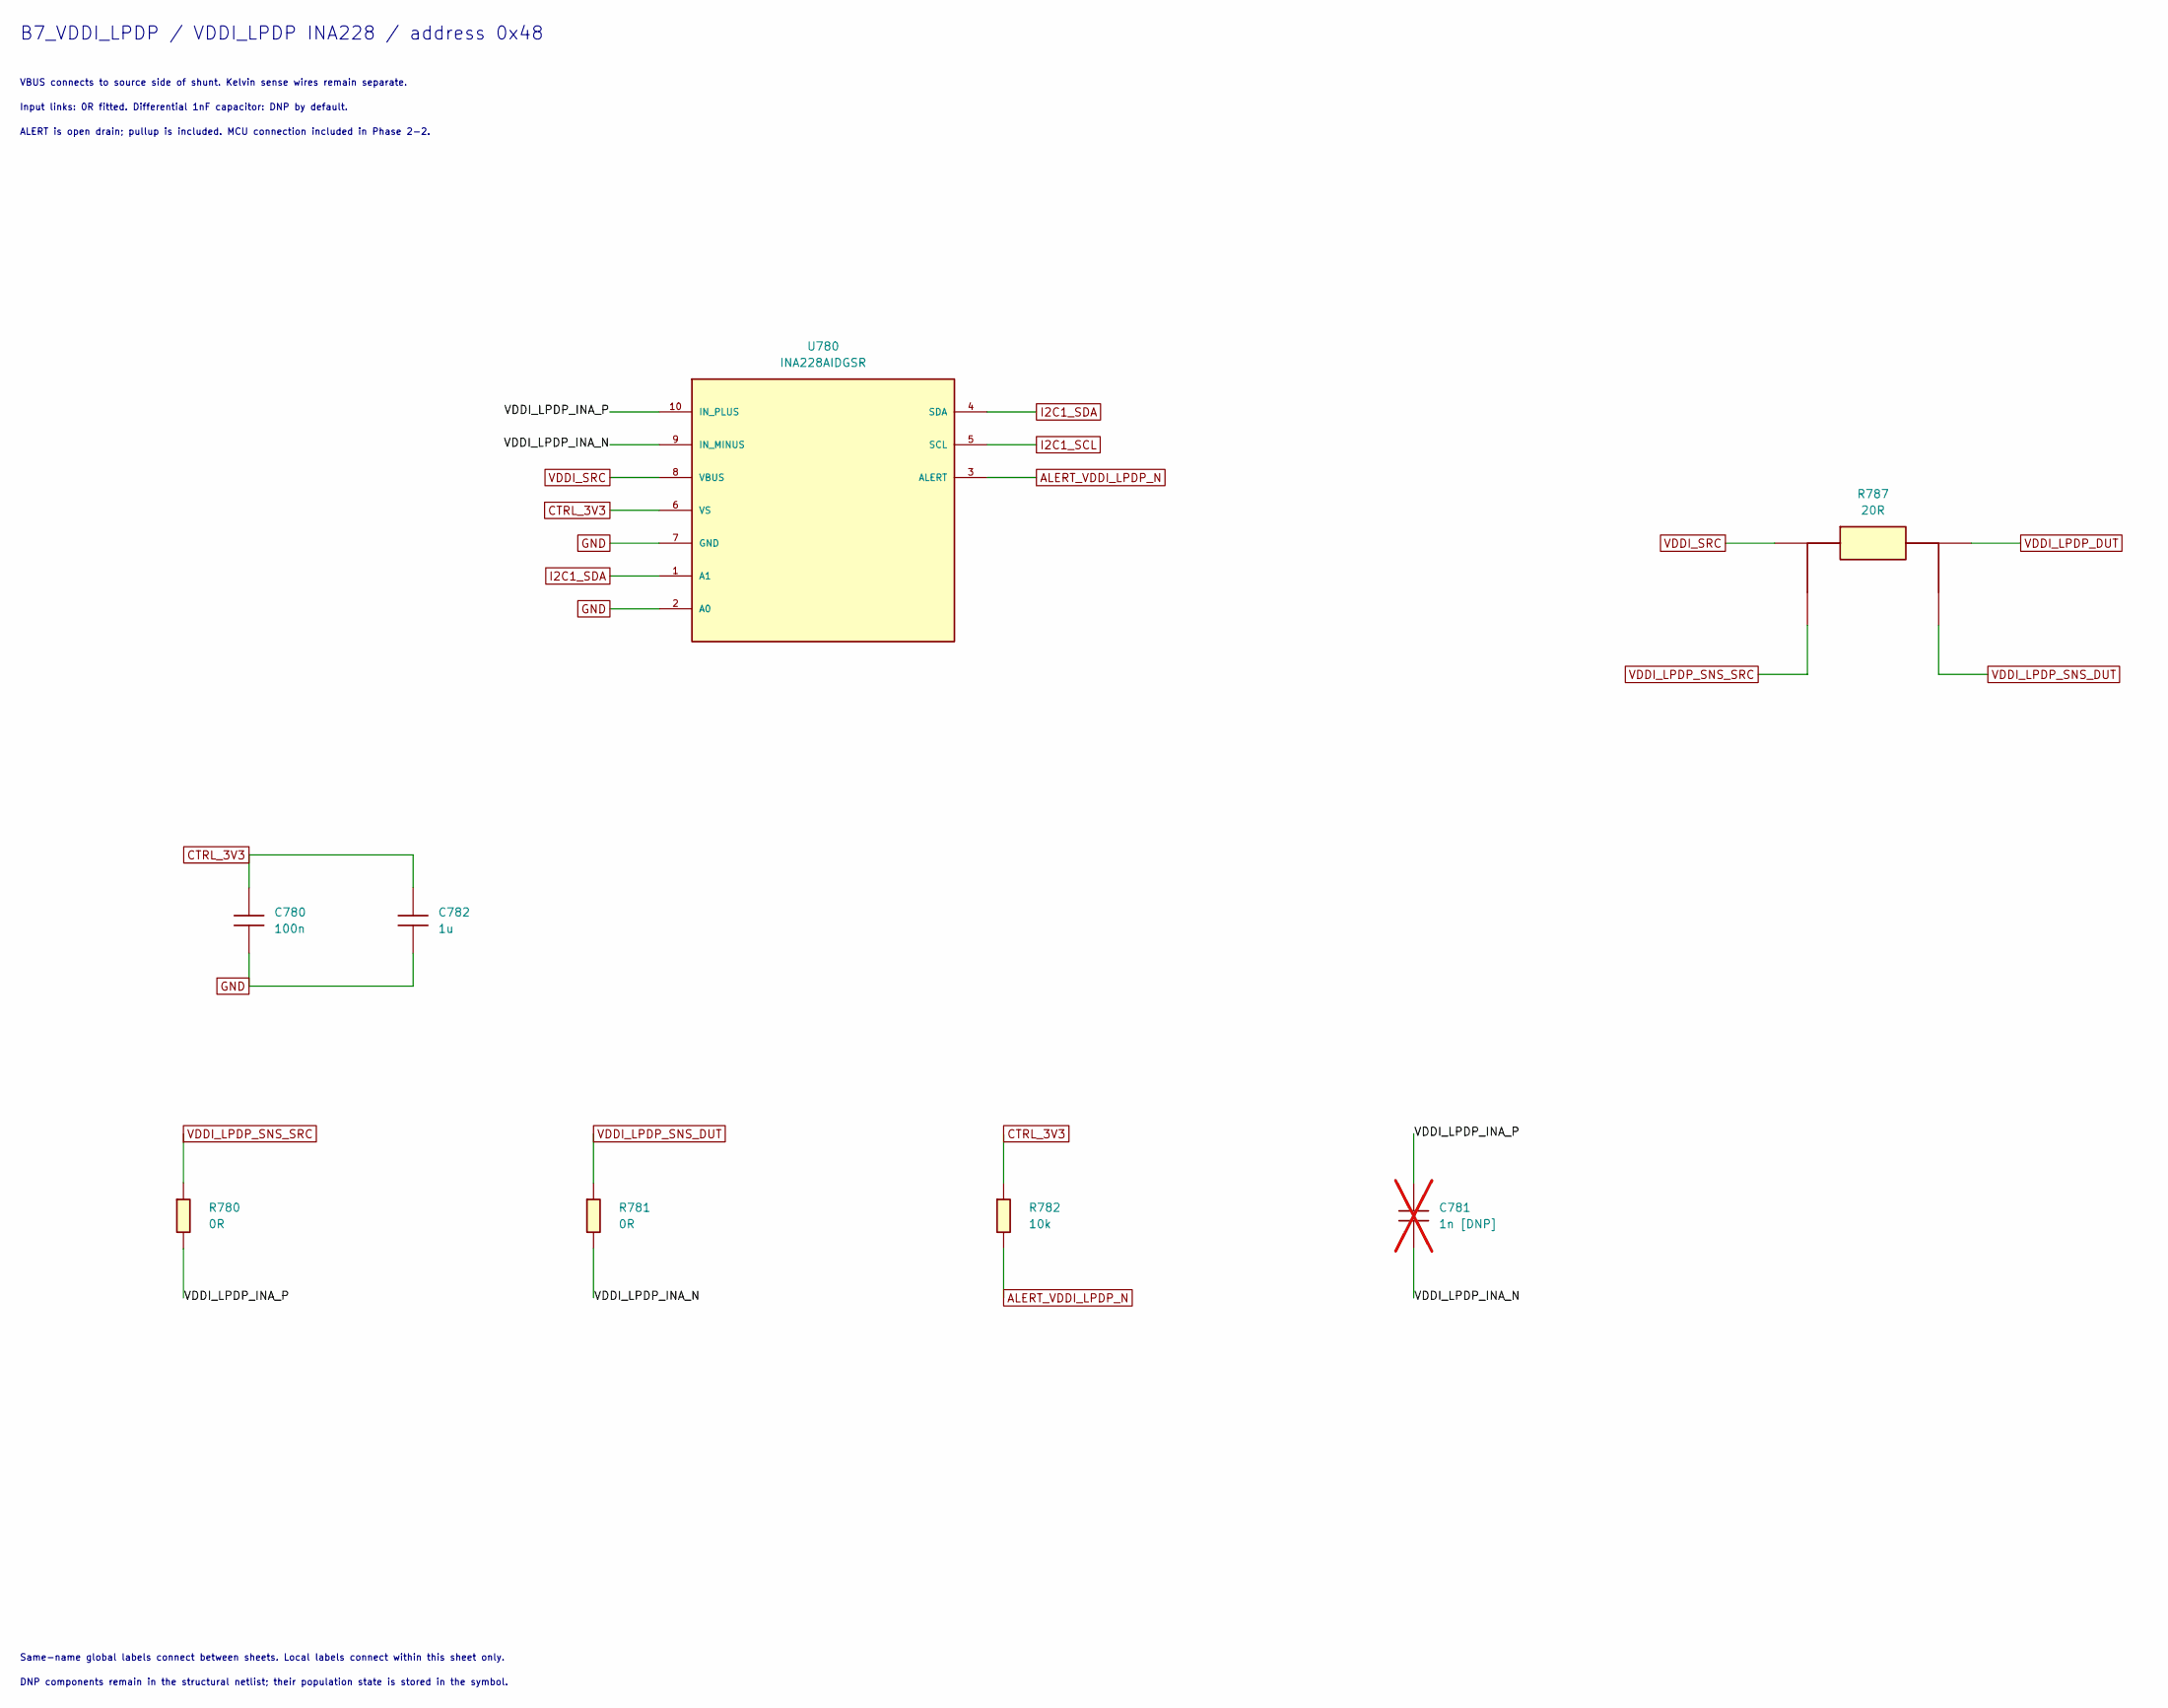
[picture p16: schematic B7_VDDI_LPDP.kicad_sch]

Parts:
C780: 100n; C_0603_1608Metric; Rating 16V X7R ±10%; MPN 확인 필요: 유효용량·누설 검증 후 선정
C781: 1n [DNP]; C_0603_1608Metric; Rating 25V C0G ±5%; MPN 확인 필요: 유효용량·누설 검증 후 선정; not fitted
C782: 1u; C_0603_1608Metric; Rating 16V X7R ±10%; MPN 확인 필요: 유효용량·누설 검증 후 선정
R780, R781: 0R; R_0603_1608Metric; Rating jumper; ≤50mΩ 목표, ≥0.1W; MPN 확인 필요: 지정값·정격 구매품
R782: 10k; R_0603_1608Metric; Rating 1%, ≥0.1W, ≥50V; MPN 확인 필요: 지정값·정격 구매품
R787: 20R; Rating 0.1%, ≤25ppm/°C, 0.25W 요구; 발주 원문 확인; MPN RT2512BKD7W20RL
U780: INA228AIDGSR; VSSOP-10_3x3mm_P0.5mm; Rating 데이터시트 운용범위 적용; MPN INA228AIDGSR

Connections:
ALERT_VDDI_LPDP_N: R782.2, U780.3 (ALERT)
CTRL_3V3: C780.1, C782.1, R782.1, U780.6 (VS)
GND: C780.2, C782.2, U780.2 (A0), U780.7 (GND)
I2C1_SCL: U780.5 (SCL)
I2C1_SDA: U780.1 (A1), U780.4 (SDA)
VDDI_LPDP_DUT: R787.2 (FORCE_DUT)
VDDI_LPDP_INA_N: C781.2, R781.2, U780.9 (IN_MINUS)
VDDI_LPDP_INA_P: C781.1, R780.2, U780.10 (IN_PLUS)
VDDI_LPDP_SNS_DUT: R781.1, R787.4 (SENSE_DUT)
VDDI_LPDP_SNS_SRC: R780.1, R787.3 (SENSE_SRC)
VDDI_SRC: R787.1 (FORCE_SRC), U780.8 (VBUS)

Notes on the sheet:
B7_VDDI_LPDP / VDDI_LPDP INA228 / address 0x48
VBUS connects to source side of shunt. Kelvin sense wires remain separate.
Input links: 0R fitted. Differential 1nF capacitor: DNP by default.
ALERT is open drain; pullup is included. MCU connection included in Phase 2-2.
Same-name global labels connect between sheets. Local labels connect within this sheet only.
DNP components remain in the structural netlist; their population state is stored in the symbol.
