Gugong0412/currentboard/R2_REPAIRED_006/B7_VDDI_OSC.kicad_sch

## KiCad design R2_REPAIRED_006/B7_VDDI_OSC.kicad_sch (2026-10-15)

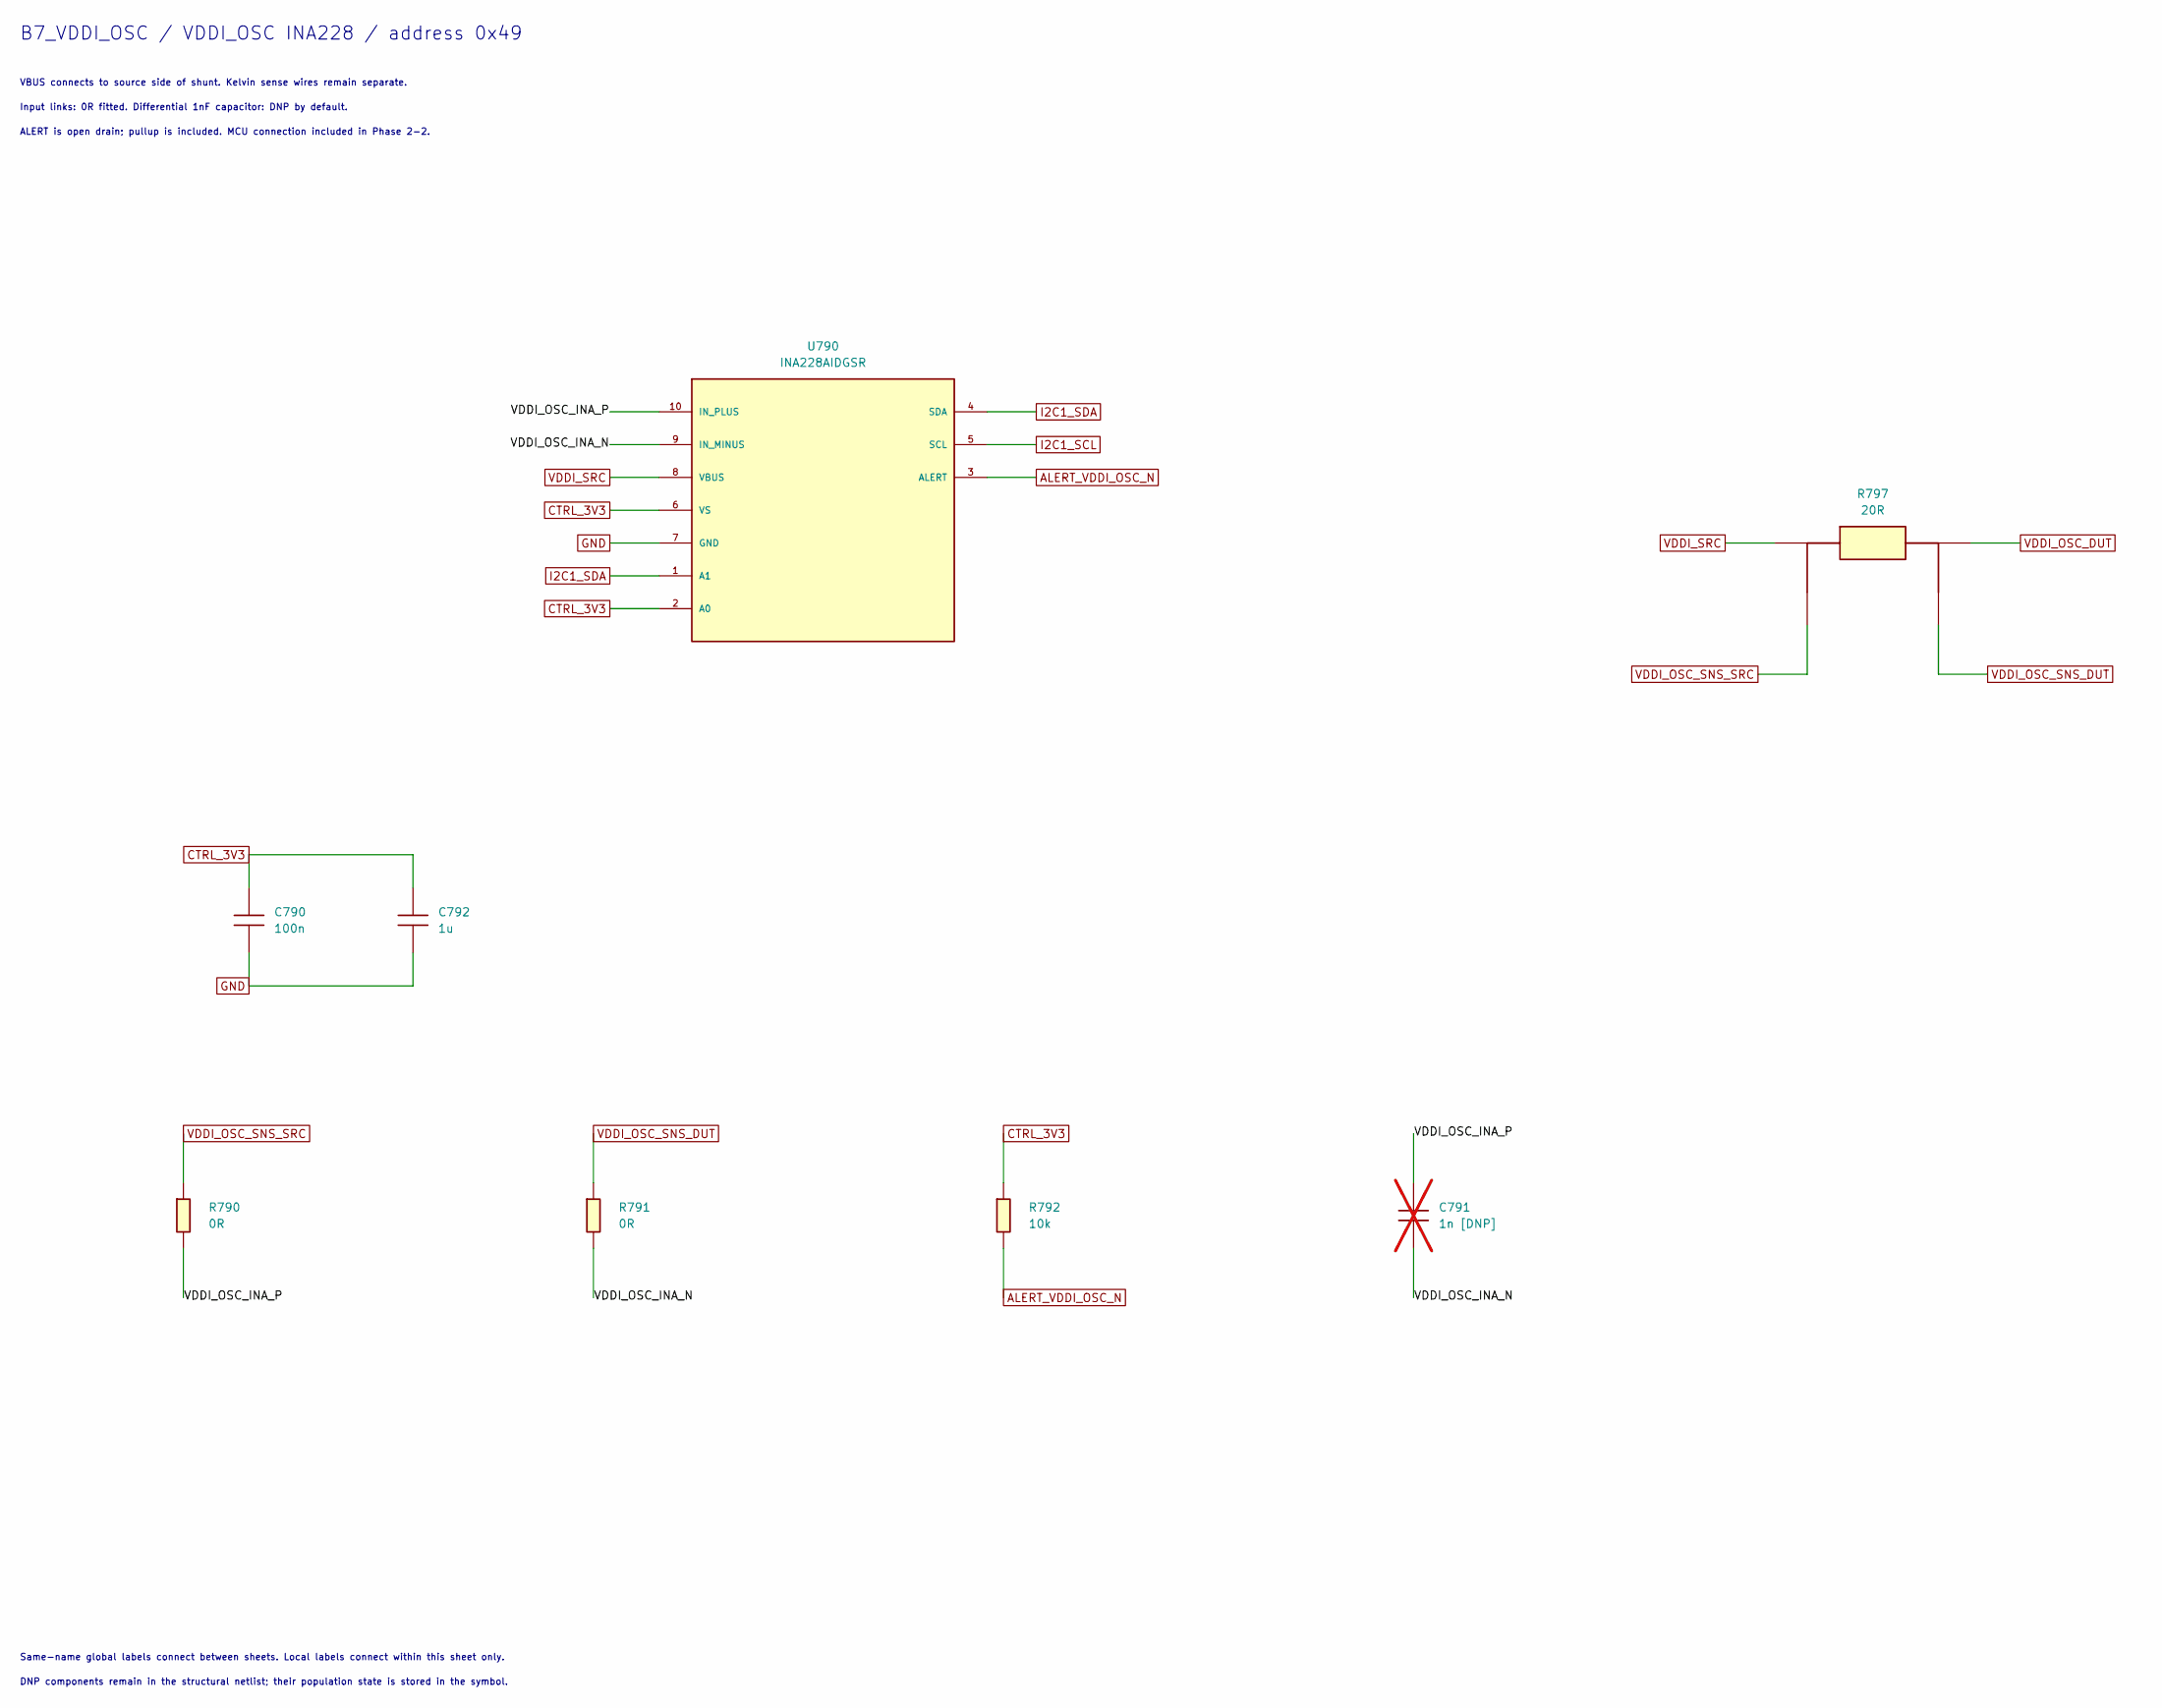
[picture p17: schematic B7_VDDI_OSC.kicad_sch]

Parts:
C790: 100n; C_0603_1608Metric; Rating 16V X7R ±10%; MPN 확인 필요: 유효용량·누설 검증 후 선정
C791: 1n [DNP]; C_0603_1608Metric; Rating 25V C0G ±5%; MPN 확인 필요: 유효용량·누설 검증 후 선정; not fitted
C792: 1u; C_0603_1608Metric; Rating 16V X7R ±10%; MPN 확인 필요: 유효용량·누설 검증 후 선정
R790, R791: 0R; R_0603_1608Metric; Rating jumper; ≤50mΩ 목표, ≥0.1W; MPN 확인 필요: 지정값·정격 구매품
R792: 10k; R_0603_1608Metric; Rating 1%, ≥0.1W, ≥50V; MPN 확인 필요: 지정값·정격 구매품
R797: 20R; Rating 0.1%, ≤25ppm/°C, 0.25W 요구; 발주 원문 확인; MPN RT2512BKD7W20RL
U790: INA228AIDGSR; VSSOP-10_3x3mm_P0.5mm; Rating 데이터시트 운용범위 적용; MPN INA228AIDGSR

Connections:
ALERT_VDDI_OSC_N: R792.2, U790.3 (ALERT)
CTRL_3V3: C790.1, C792.1, R792.1, U790.2 (A0), U790.6 (VS)
GND: C790.2, C792.2, U790.7 (GND)
I2C1_SCL: U790.5 (SCL)
I2C1_SDA: U790.1 (A1), U790.4 (SDA)
VDDI_OSC_DUT: R797.2 (FORCE_DUT)
VDDI_OSC_INA_N: C791.2, R791.2, U790.9 (IN_MINUS)
VDDI_OSC_INA_P: C791.1, R790.2, U790.10 (IN_PLUS)
VDDI_OSC_SNS_DUT: R791.1, R797.4 (SENSE_DUT)
VDDI_OSC_SNS_SRC: R790.1, R797.3 (SENSE_SRC)
VDDI_SRC: R797.1 (FORCE_SRC), U790.8 (VBUS)

Notes on the sheet:
B7_VDDI_OSC / VDDI_OSC INA228 / address 0x49
VBUS connects to source side of shunt. Kelvin sense wires remain separate.
Input links: 0R fitted. Differential 1nF capacitor: DNP by default.
ALERT is open drain; pullup is included. MCU connection included in Phase 2-2.
Same-name global labels connect between sheets. Local labels connect within this sheet only.
DNP components remain in the structural netlist; their population state is stored in the symbol.
