Gugong0412/currentboard/R2_REPAIRED_006/B7_VGH2.kicad_sch

## KiCad design R2_REPAIRED_006/B7_VGH2.kicad_sch (2026-10-15)

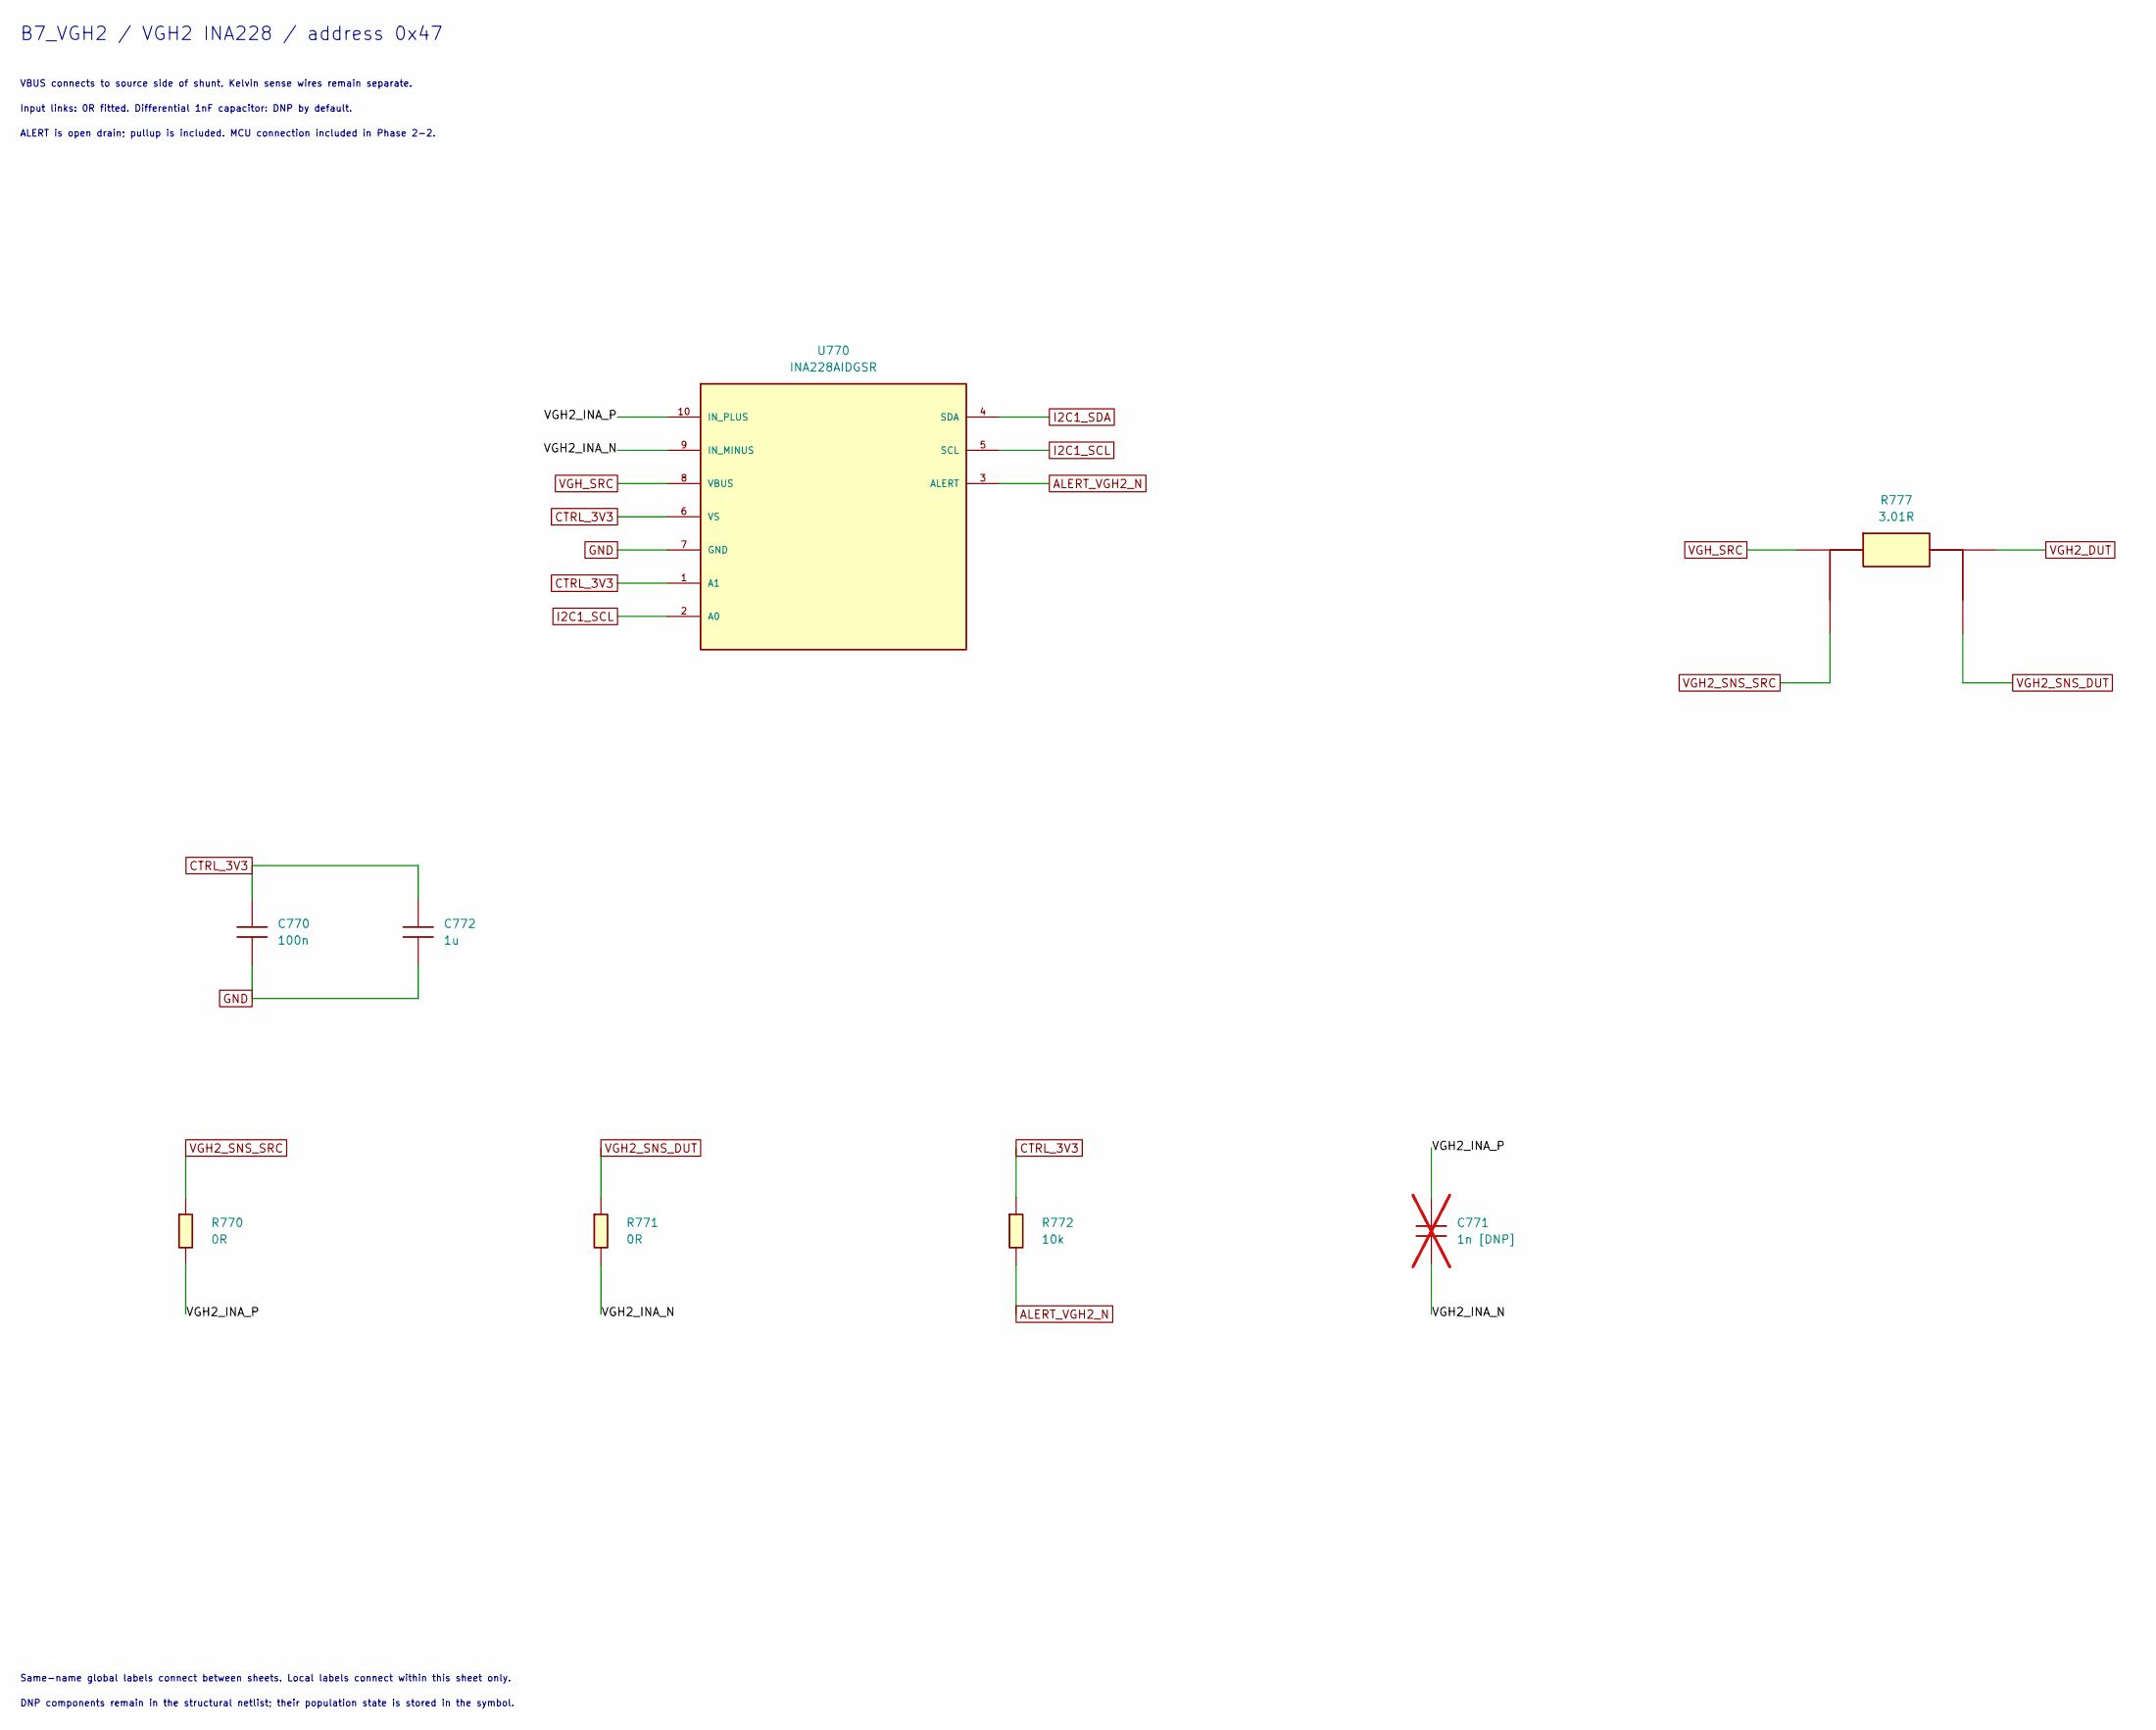
[picture p18: schematic B7_VGH2.kicad_sch]

Parts:
C770: 100n; C_0603_1608Metric; Rating 16V X7R ±10%; MPN 확인 필요: 유효용량·누설 검증 후 선정
C771: 1n [DNP]; C_0603_1608Metric; Rating 25V C0G ±5%; MPN 확인 필요: 유효용량·누설 검증 후 선정; not fitted
C772: 1u; C_0603_1608Metric; Rating 16V X7R ±10%; MPN 확인 필요: 유효용량·누설 검증 후 선정
R770, R771: 0R; R_0603_1608Metric; Rating jumper; ≤50mΩ 목표, ≥0.1W; MPN 확인 필요: 지정값·정격 구매품
R772: 10k; R_0603_1608Metric; Rating 1%, ≥0.1W, ≥50V; MPN 확인 필요: 지정값·정격 구매품
R777: 3.01R; Rating 0.1%, ≤25ppm/°C, 0.25W 요구; 발주 원문 확인; MPN RT1206BRD073R01L
U770: INA228AIDGSR; VSSOP-10_3x3mm_P0.5mm; Rating 데이터시트 운용범위 적용; MPN INA228AIDGSR

Connections:
ALERT_VGH2_N: R772.2, U770.3 (ALERT)
CTRL_3V3: C770.1, C772.1, R772.1, U770.1 (A1), U770.6 (VS)
GND: C770.2, C772.2, U770.7 (GND)
I2C1_SCL: U770.2 (A0), U770.5 (SCL)
I2C1_SDA: U770.4 (SDA)
VGH2_DUT: R777.2 (FORCE_DUT)
VGH2_INA_N: C771.2, R771.2, U770.9 (IN_MINUS)
VGH2_INA_P: C771.1, R770.2, U770.10 (IN_PLUS)
VGH2_SNS_DUT: R771.1, R777.4 (SENSE_DUT)
VGH2_SNS_SRC: R770.1, R777.3 (SENSE_SRC)
VGH_SRC: R777.1 (FORCE_SRC), U770.8 (VBUS)

Notes on the sheet:
B7_VGH2 / VGH2 INA228 / address 0x47
VBUS connects to source side of shunt. Kelvin sense wires remain separate.
Input links: 0R fitted. Differential 1nF capacitor: DNP by default.
ALERT is open drain; pullup is included. MCU connection included in Phase 2-2.
Same-name global labels connect between sheets. Local labels connect within this sheet only.
DNP components remain in the structural netlist; their population state is stored in the symbol.
