Gugong0412/currentboard/R2_REPAIRED_006/B7_VGH.kicad_sch

## KiCad design R2_REPAIRED_006/B7_VGH.kicad_sch (2026-10-15)

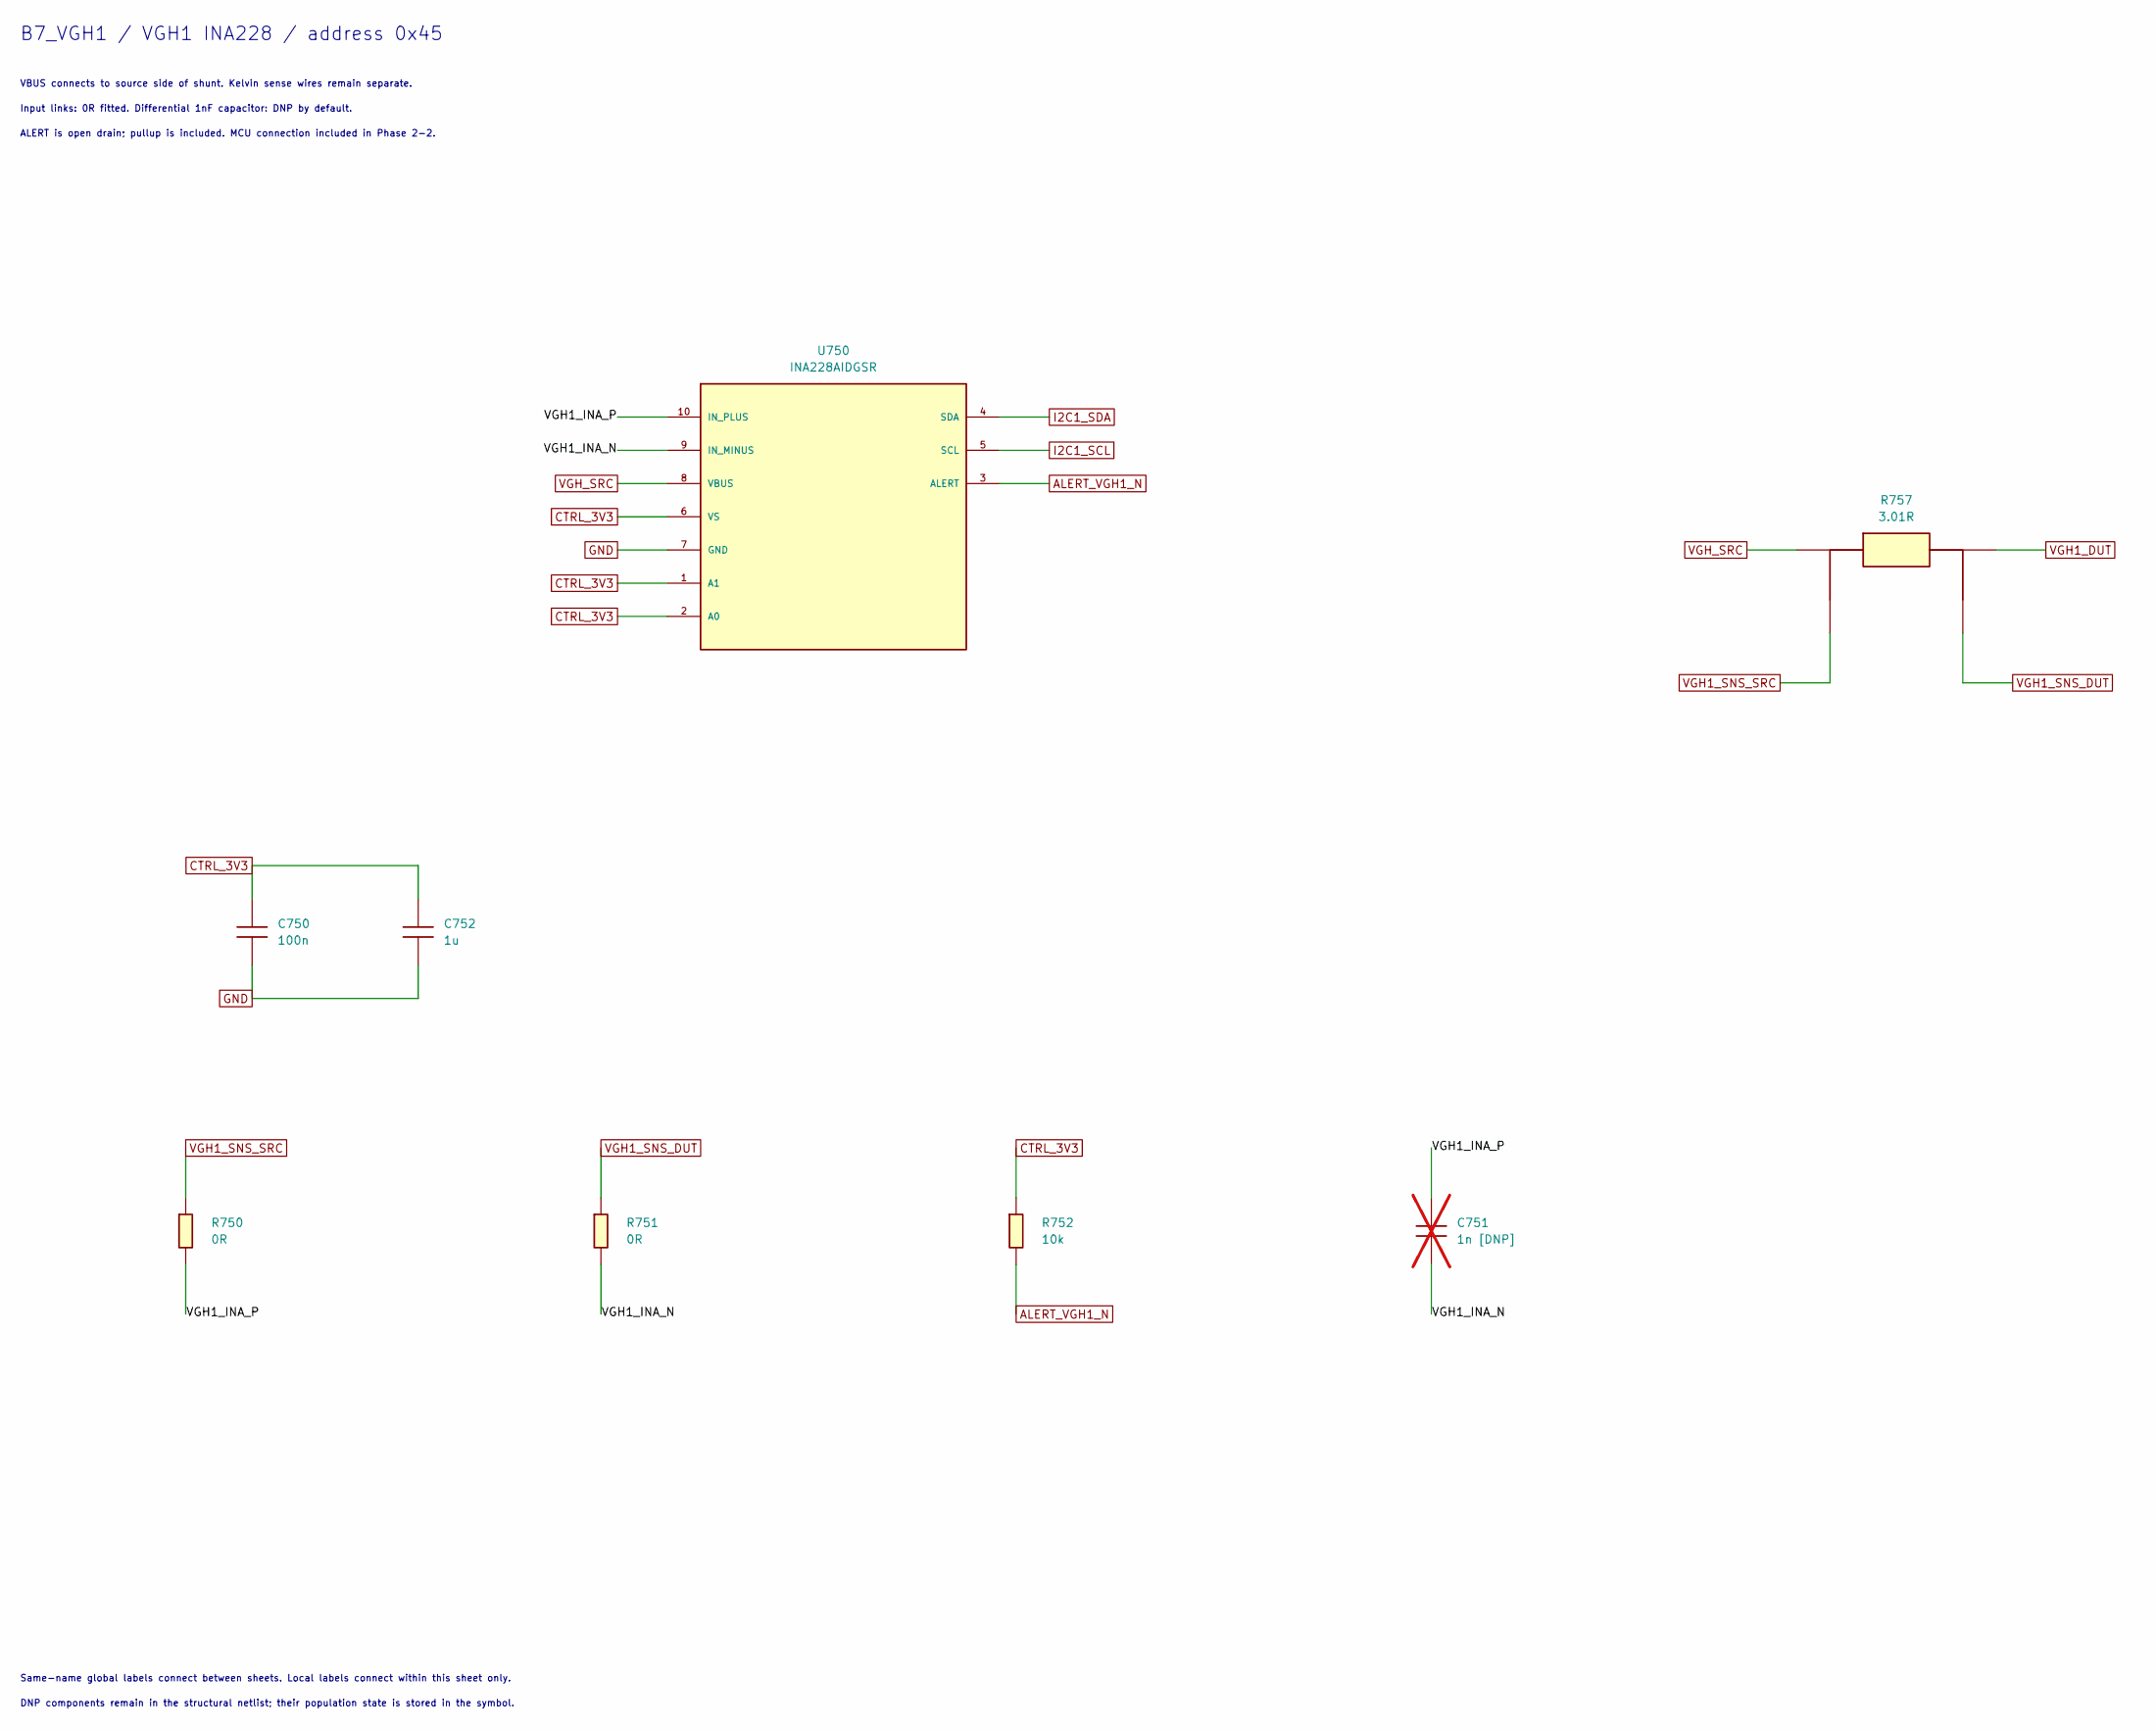
[picture p19: schematic B7_VGH.kicad_sch]

Parts:
C750: 100n; C_0603_1608Metric; Rating 16V X7R ±10%; MPN 확인 필요: 유효용량·누설 검증 후 선정
C751: 1n [DNP]; C_0603_1608Metric; Rating 25V C0G ±5%; MPN 확인 필요: 유효용량·누설 검증 후 선정; not fitted
C752: 1u; C_0603_1608Metric; Rating 16V X7R ±10%; MPN 확인 필요: 유효용량·누설 검증 후 선정
R750, R751: 0R; R_0603_1608Metric; Rating jumper; ≤50mΩ 목표, ≥0.1W; MPN 확인 필요: 지정값·정격 구매품
R752: 10k; R_0603_1608Metric; Rating 1%, ≥0.1W, ≥50V; MPN 확인 필요: 지정값·정격 구매품
R757: 3.01R; Rating 0.1%, ≤25ppm/°C, 0.25W 요구; 발주 원문 확인; MPN RT1206BRD073R01L
U750: INA228AIDGSR; VSSOP-10_3x3mm_P0.5mm; Rating 데이터시트 운용범위 적용; MPN INA228AIDGSR

Connections:
ALERT_VGH1_N: R752.2, U750.3 (ALERT)
CTRL_3V3: C750.1, C752.1, R752.1, U750.1 (A1), U750.2 (A0), U750.6 (VS)
GND: C750.2, C752.2, U750.7 (GND)
I2C1_SCL: U750.5 (SCL)
I2C1_SDA: U750.4 (SDA)
VGH1_DUT: R757.2 (FORCE_DUT)
VGH1_INA_N: C751.2, R751.2, U750.9 (IN_MINUS)
VGH1_INA_P: C751.1, R750.2, U750.10 (IN_PLUS)
VGH1_SNS_DUT: R751.1, R757.4 (SENSE_DUT)
VGH1_SNS_SRC: R750.1, R757.3 (SENSE_SRC)
VGH_SRC: R757.1 (FORCE_SRC), U750.8 (VBUS)

Notes on the sheet:
B7_VGH1 / VGH1 INA228 / address 0x45
VBUS connects to source side of shunt. Kelvin sense wires remain separate.
Input links: 0R fitted. Differential 1nF capacitor: DNP by default.
ALERT is open drain; pullup is included. MCU connection included in Phase 2-2.
Same-name global labels connect between sheets. Local labels connect within this sheet only.
DNP components remain in the structural netlist; their population state is stored in the symbol.
