Gugong0412/currentboard/R2_REPAIRED_006/B8_INA.kicad_sch

## KiCad design R2_REPAIRED_006/B8_INA.kicad_sch (2026-10-15)

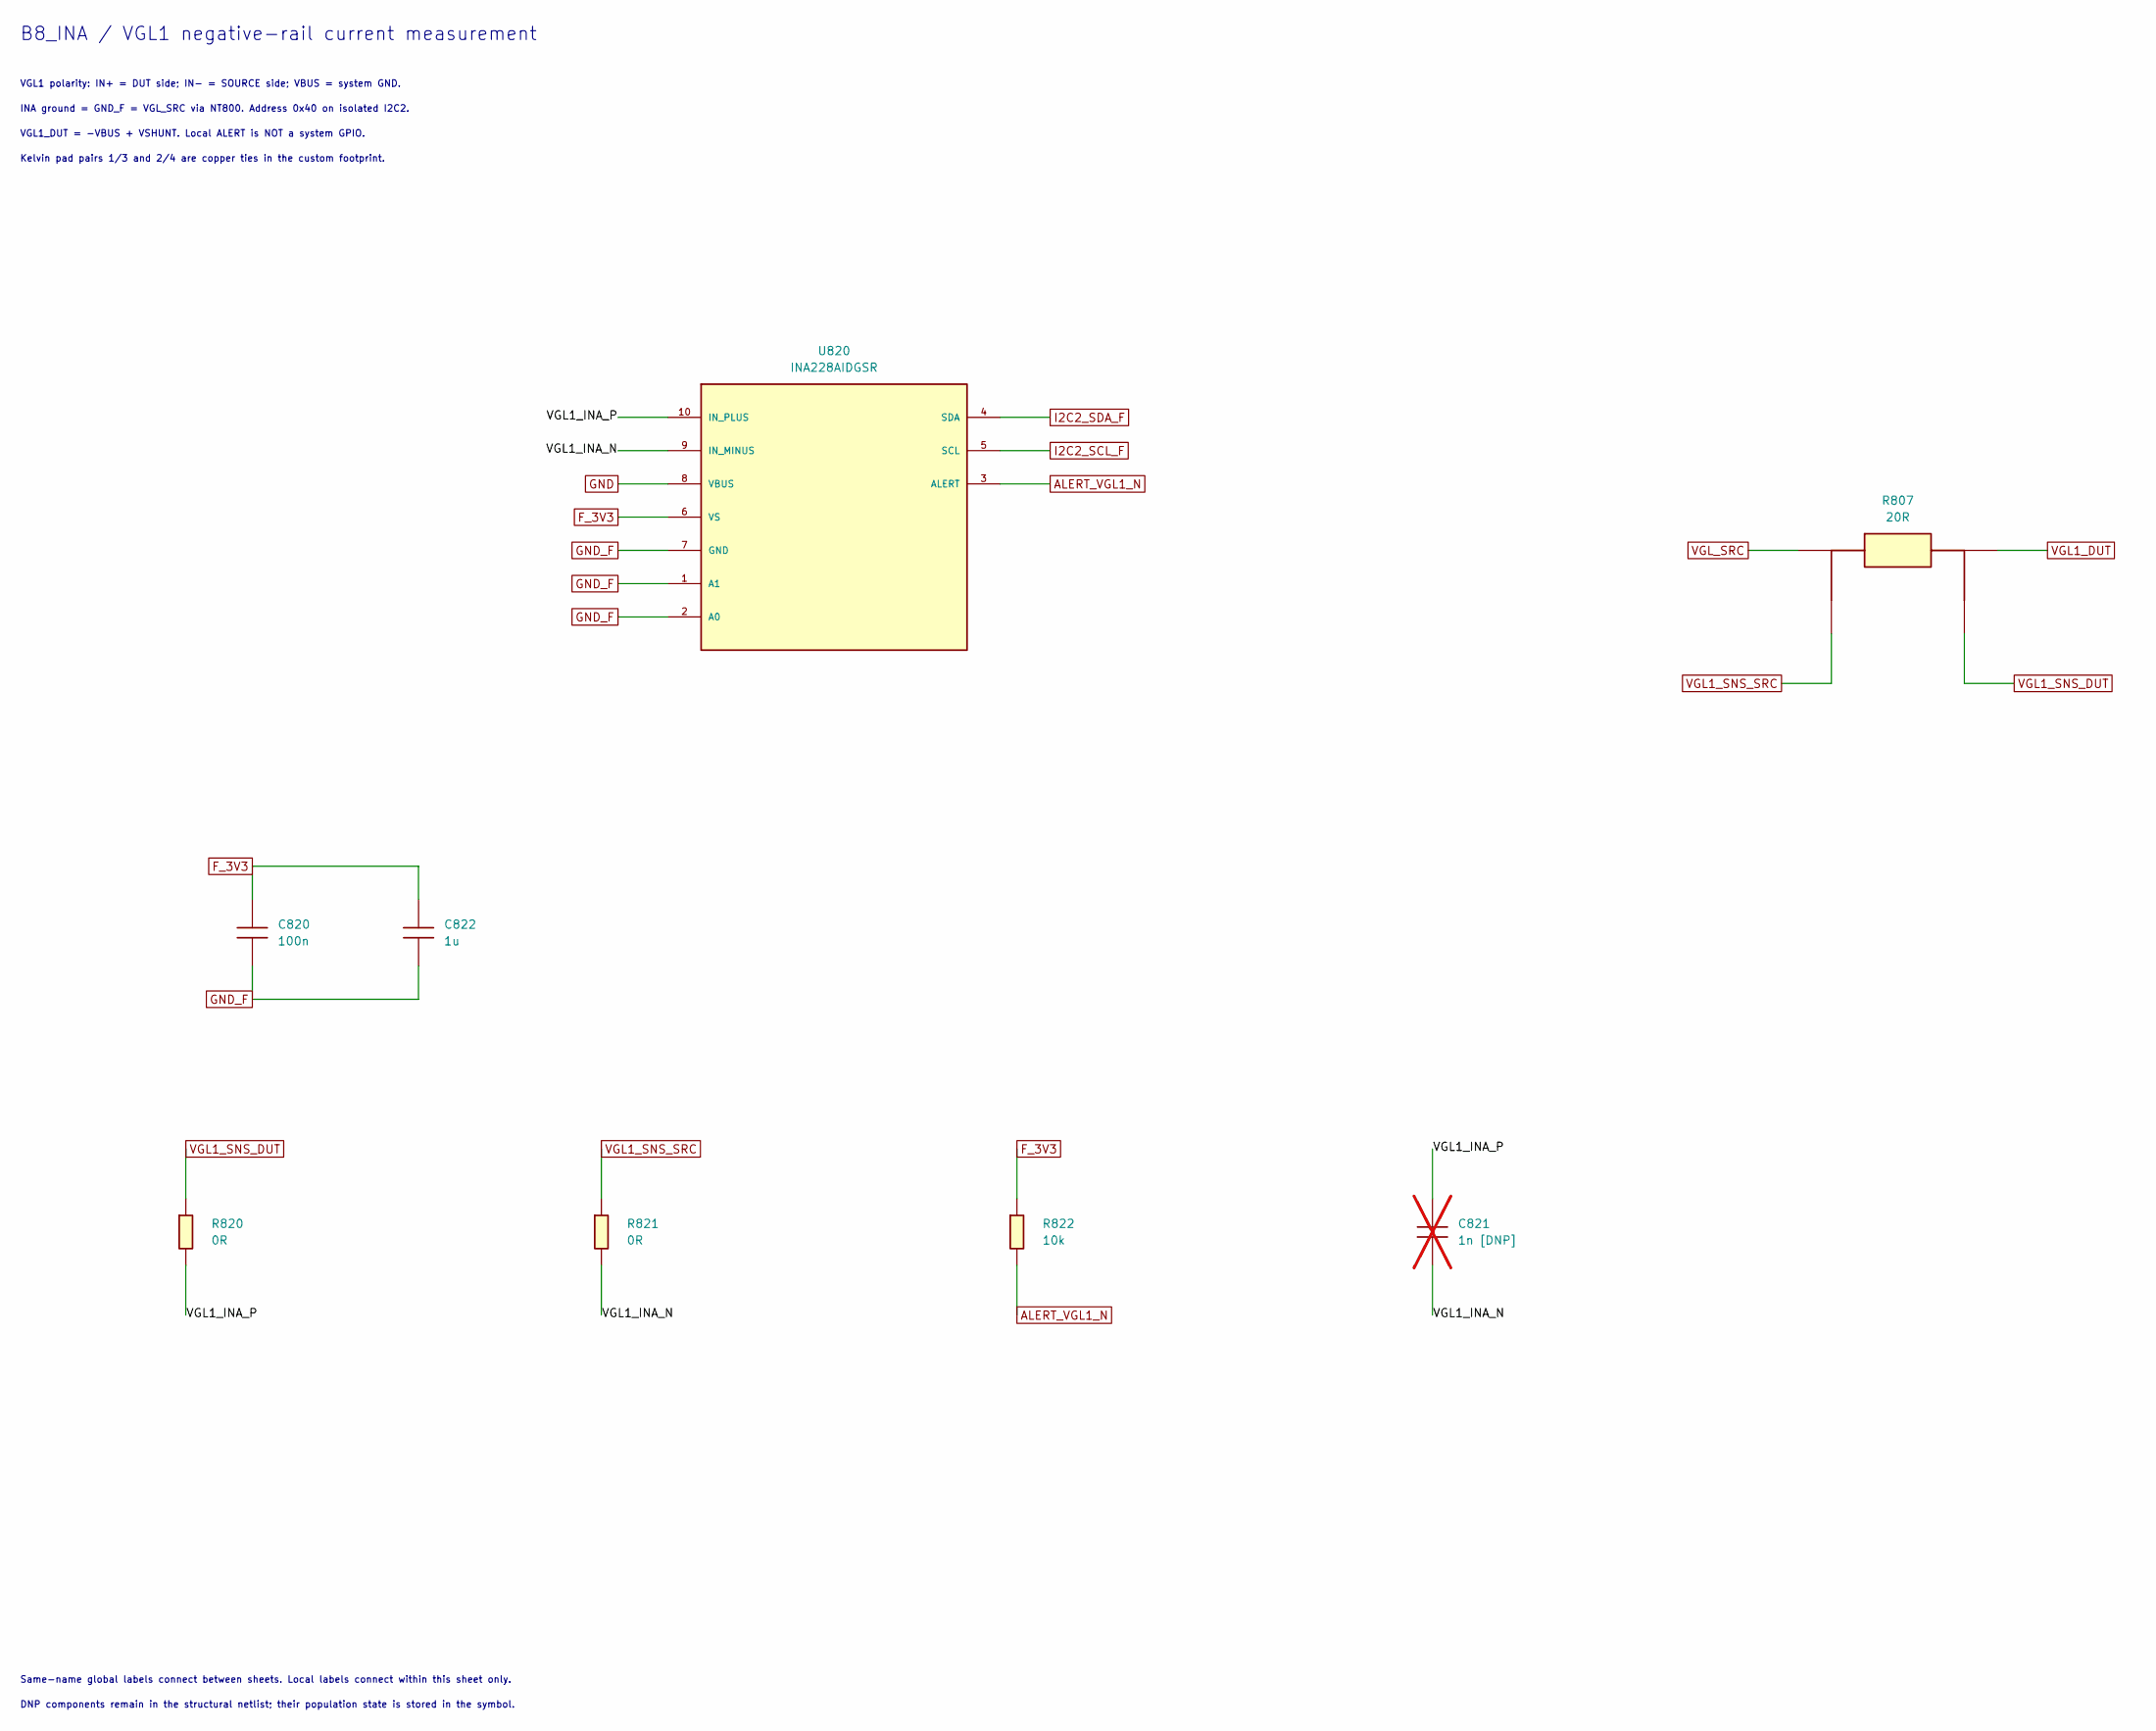
[picture p20: schematic B8_INA.kicad_sch]

Parts:
C820: 100n; C_0603_1608Metric; Rating 16V X7R ±10%; MPN 확인 필요: 유효용량·누설 검증 후 선정
C821: 1n [DNP]; C_0603_1608Metric; Rating 25V C0G ±5%; MPN 확인 필요: 유효용량·누설 검증 후 선정; not fitted
C822: 1u; C_0603_1608Metric; Rating 16V X7R ±10%; MPN 확인 필요: 유효용량·누설 검증 후 선정
R807: 20R; Rating 0.1%, ≤25ppm/°C, 0.25W 요구; 발주 원문 확인; MPN RT1206BRD0720RL
R820, R821: 0R; R_0603_1608Metric; Rating jumper; ≤50mΩ 목표, ≥0.1W; MPN 확인 필요: 지정값·정격 구매품
R822: 10k; R_0603_1608Metric; Rating 1%, ≥0.1W, ≥50V; MPN 확인 필요: 지정값·정격 구매품
U820: INA228AIDGSR; VSSOP-10_3x3mm_P0.5mm; Rating 데이터시트 운용범위 적용; MPN INA228AIDGSR

Connections:
ALERT_VGL1_N: R822.2, U820.3 (ALERT)
F_3V3: C820.1, C822.1, R822.1, U820.6 (VS)
GND: U820.8 (VBUS)
GND_F: C820.2, C822.2, U820.1 (A1), U820.2 (A0), U820.7 (GND)
I2C2_SCL_F: U820.5 (SCL)
I2C2_SDA_F: U820.4 (SDA)
VGL1_DUT: R807.2 (FORCE_DUT)
VGL1_INA_N: C821.2, R821.2, U820.9 (IN_MINUS)
VGL1_INA_P: C821.1, R820.2, U820.10 (IN_PLUS)
VGL1_SNS_DUT: R807.4 (SENSE_DUT), R820.1
VGL1_SNS_SRC: R807.3 (SENSE_SRC), R821.1
VGL_SRC: R807.1 (FORCE_SRC)

Notes on the sheet:
B8_INA / VGL1 negative-rail current measurement
VGL1 polarity: IN+ = DUT side; IN- = SOURCE side; VBUS = system GND.
INA ground = GND_F = VGL_SRC via NT800. Address 0x40 on isolated I2C2.
VGL1_DUT = -VBUS + VSHUNT. Local ALERT is NOT a system GPIO.
Kelvin pad pairs 1/3 and 2/4 are copper ties in the custom footprint.
Same-name global labels connect between sheets. Local labels connect within this sheet only.
DNP components remain in the structural netlist; their population state is stored in the symbol.
