Gugong0412/currentboard/R2_REPAIRED_006/B8_ISO.kicad_sch

## KiCad design R2_REPAIRED_006/B8_ISO.kicad_sch (2026-10-15)

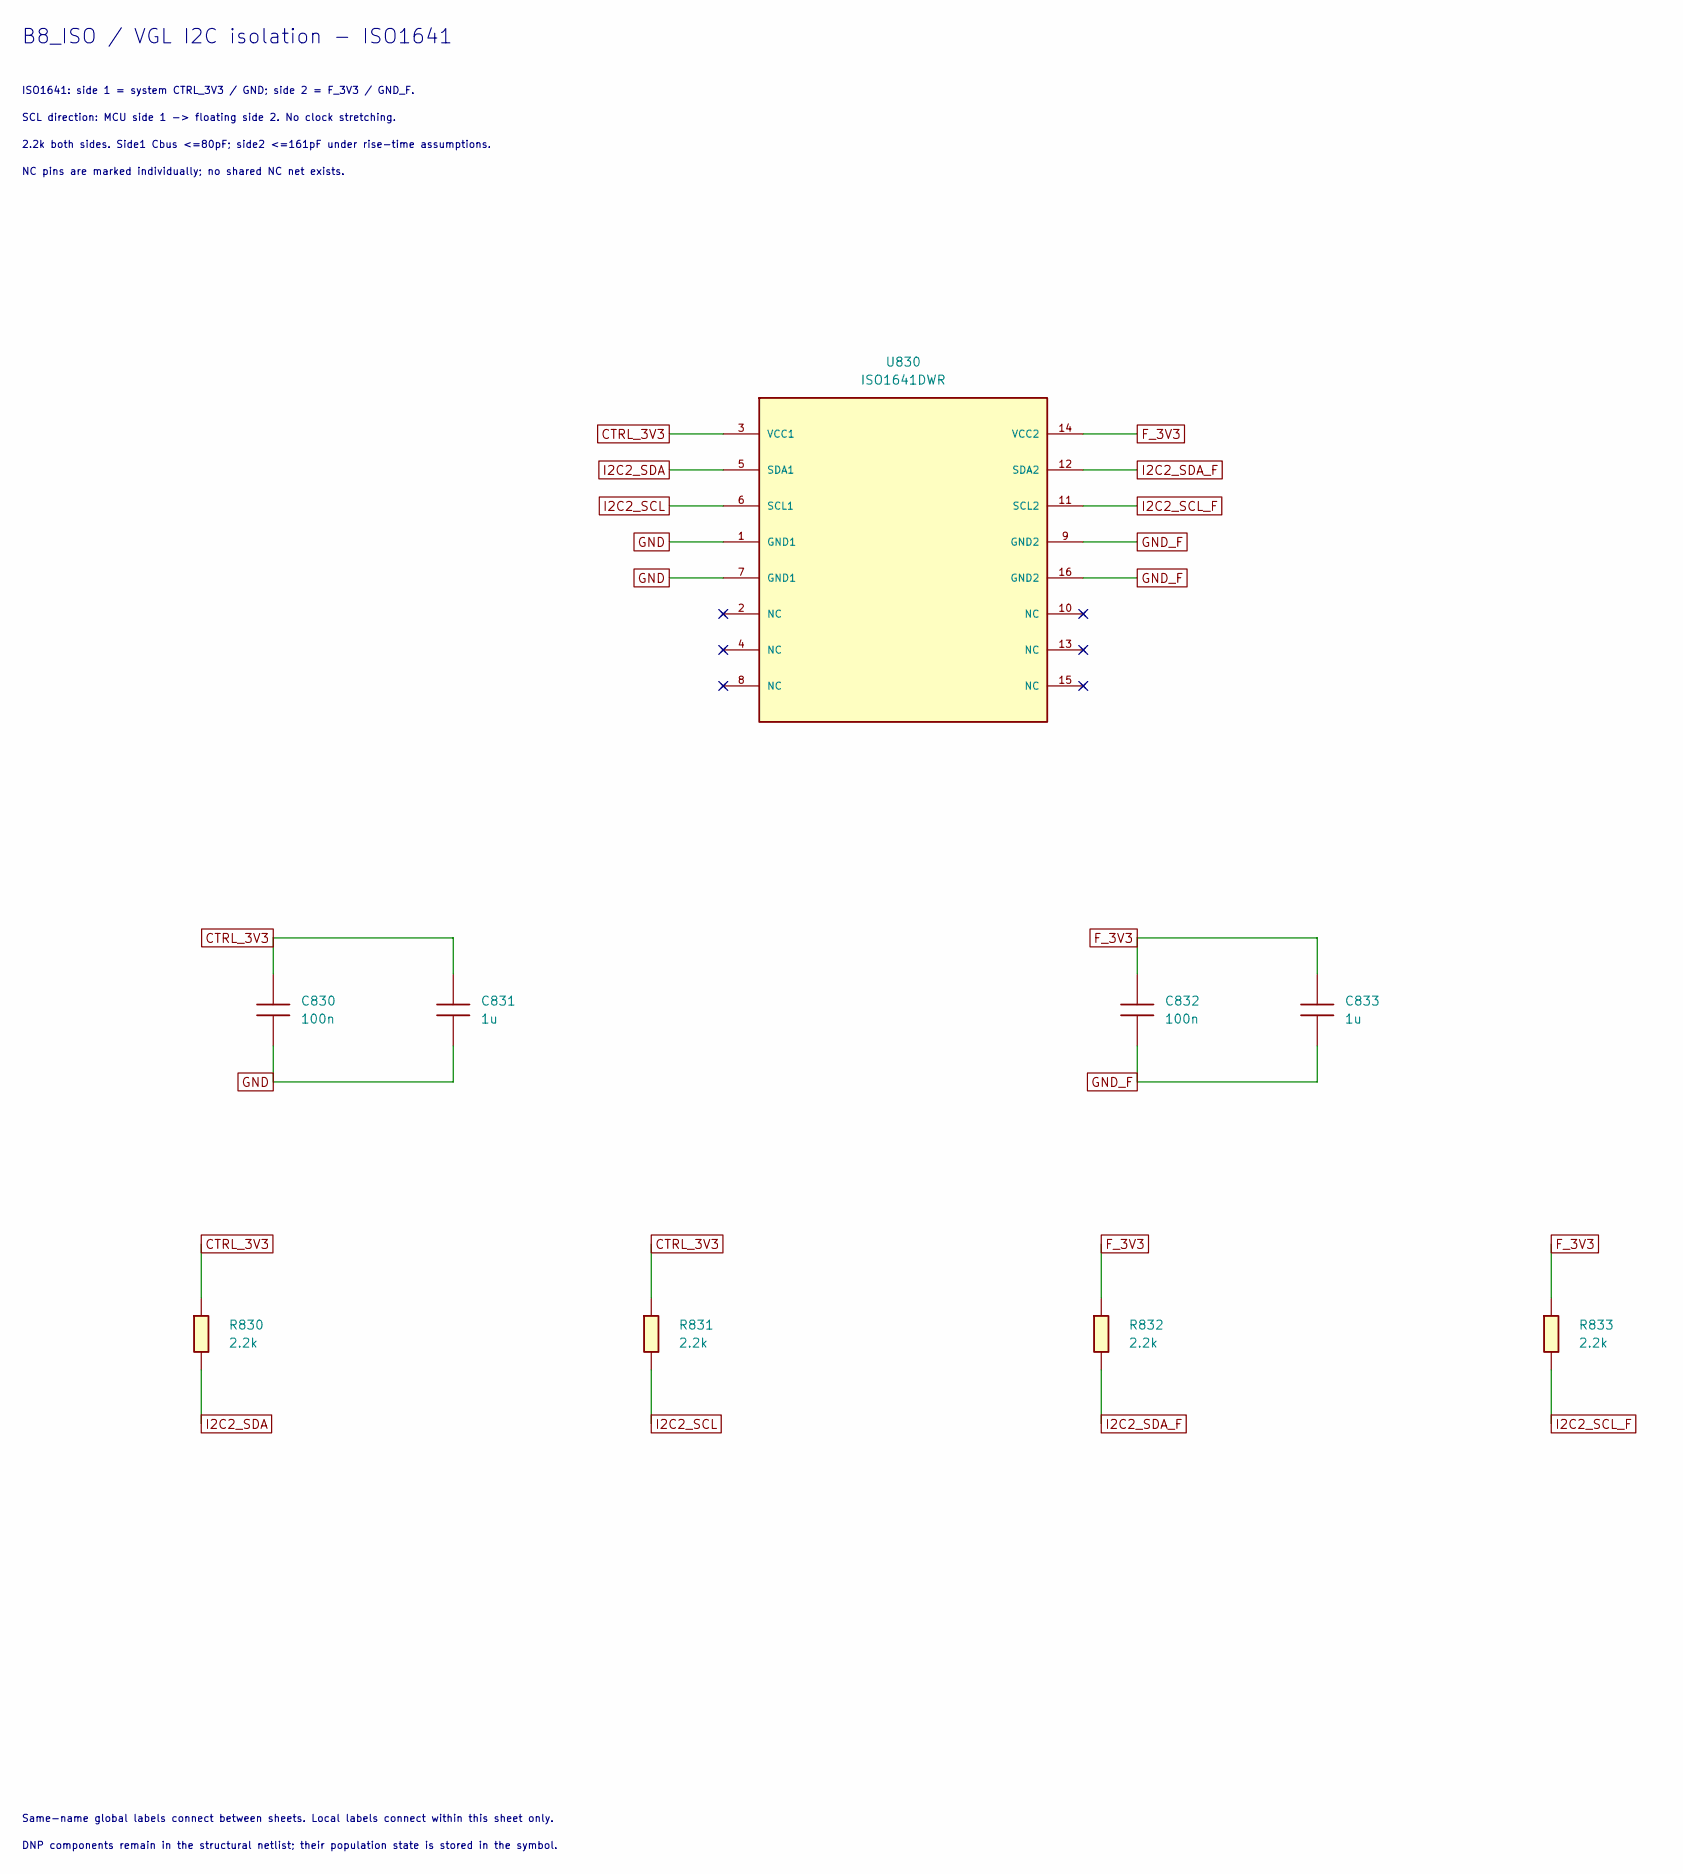
[picture p21: schematic B8_ISO.kicad_sch]

Parts:
C830, C832: 100n; C_0603_1608Metric; Rating 16V X7R ±10%; MPN 확인 필요: 유효용량·누설 검증 후 선정
C831, C833: 1u; C_0603_1608Metric; Rating 16V X7R ±10%; MPN 확인 필요: 유효용량·누설 검증 후 선정
R830, R831, R832, R833: 2.2k; R_0603_1608Metric; Rating 1%, ≥0.1W, ≥50V; MPN 확인 필요: 지정값·정격 구매품
U830: ISO1641DWR; SOIC-16W_7.5x10.3mm_P1.27mm; Rating 데이터시트 운용범위 적용; MPN ISO1641DWR

Connections:
CTRL_3V3: C830.1, C831.1, R830.1, R831.1, U830.3 (VCC1)
F_3V3: C832.1, C833.1, R832.1, R833.1, U830.14 (VCC2)
GND: C830.2, C831.2, U830.1 (GND1), U830.7 (GND1)
GND_F: C832.2, C833.2, U830.9 (GND2), U830.16 (GND2)
I2C2_SCL: R831.2, U830.6 (SCL1)
I2C2_SCL_F: R833.2, U830.11 (SCL2)
I2C2_SDA: R830.2, U830.5 (SDA1)
I2C2_SDA_F: R832.2, U830.12 (SDA2)

Notes on the sheet:
B8_ISO / VGL I2C isolation - ISO1641
ISO1641: side 1 = system CTRL_3V3 / GND; side 2 = F_3V3 / GND_F.
SCL direction: MCU side 1 -> floating side 2. No clock stretching.
2.2k both sides. Side1 Cbus <=80pF; side2 <=161pF under rise-time assumptions.
NC pins are marked individually; no shared NC net exists.
Same-name global labels connect between sheets. Local labels connect within this sheet only.
DNP components remain in the structural netlist; their population state is stored in the symbol.
