Gugong0412/currentboard/R2_REPAIRED_006/B8_PWR.kicad_sch

## KiCad design R2_REPAIRED_006/B8_PWR.kicad_sch (2026-10-15)

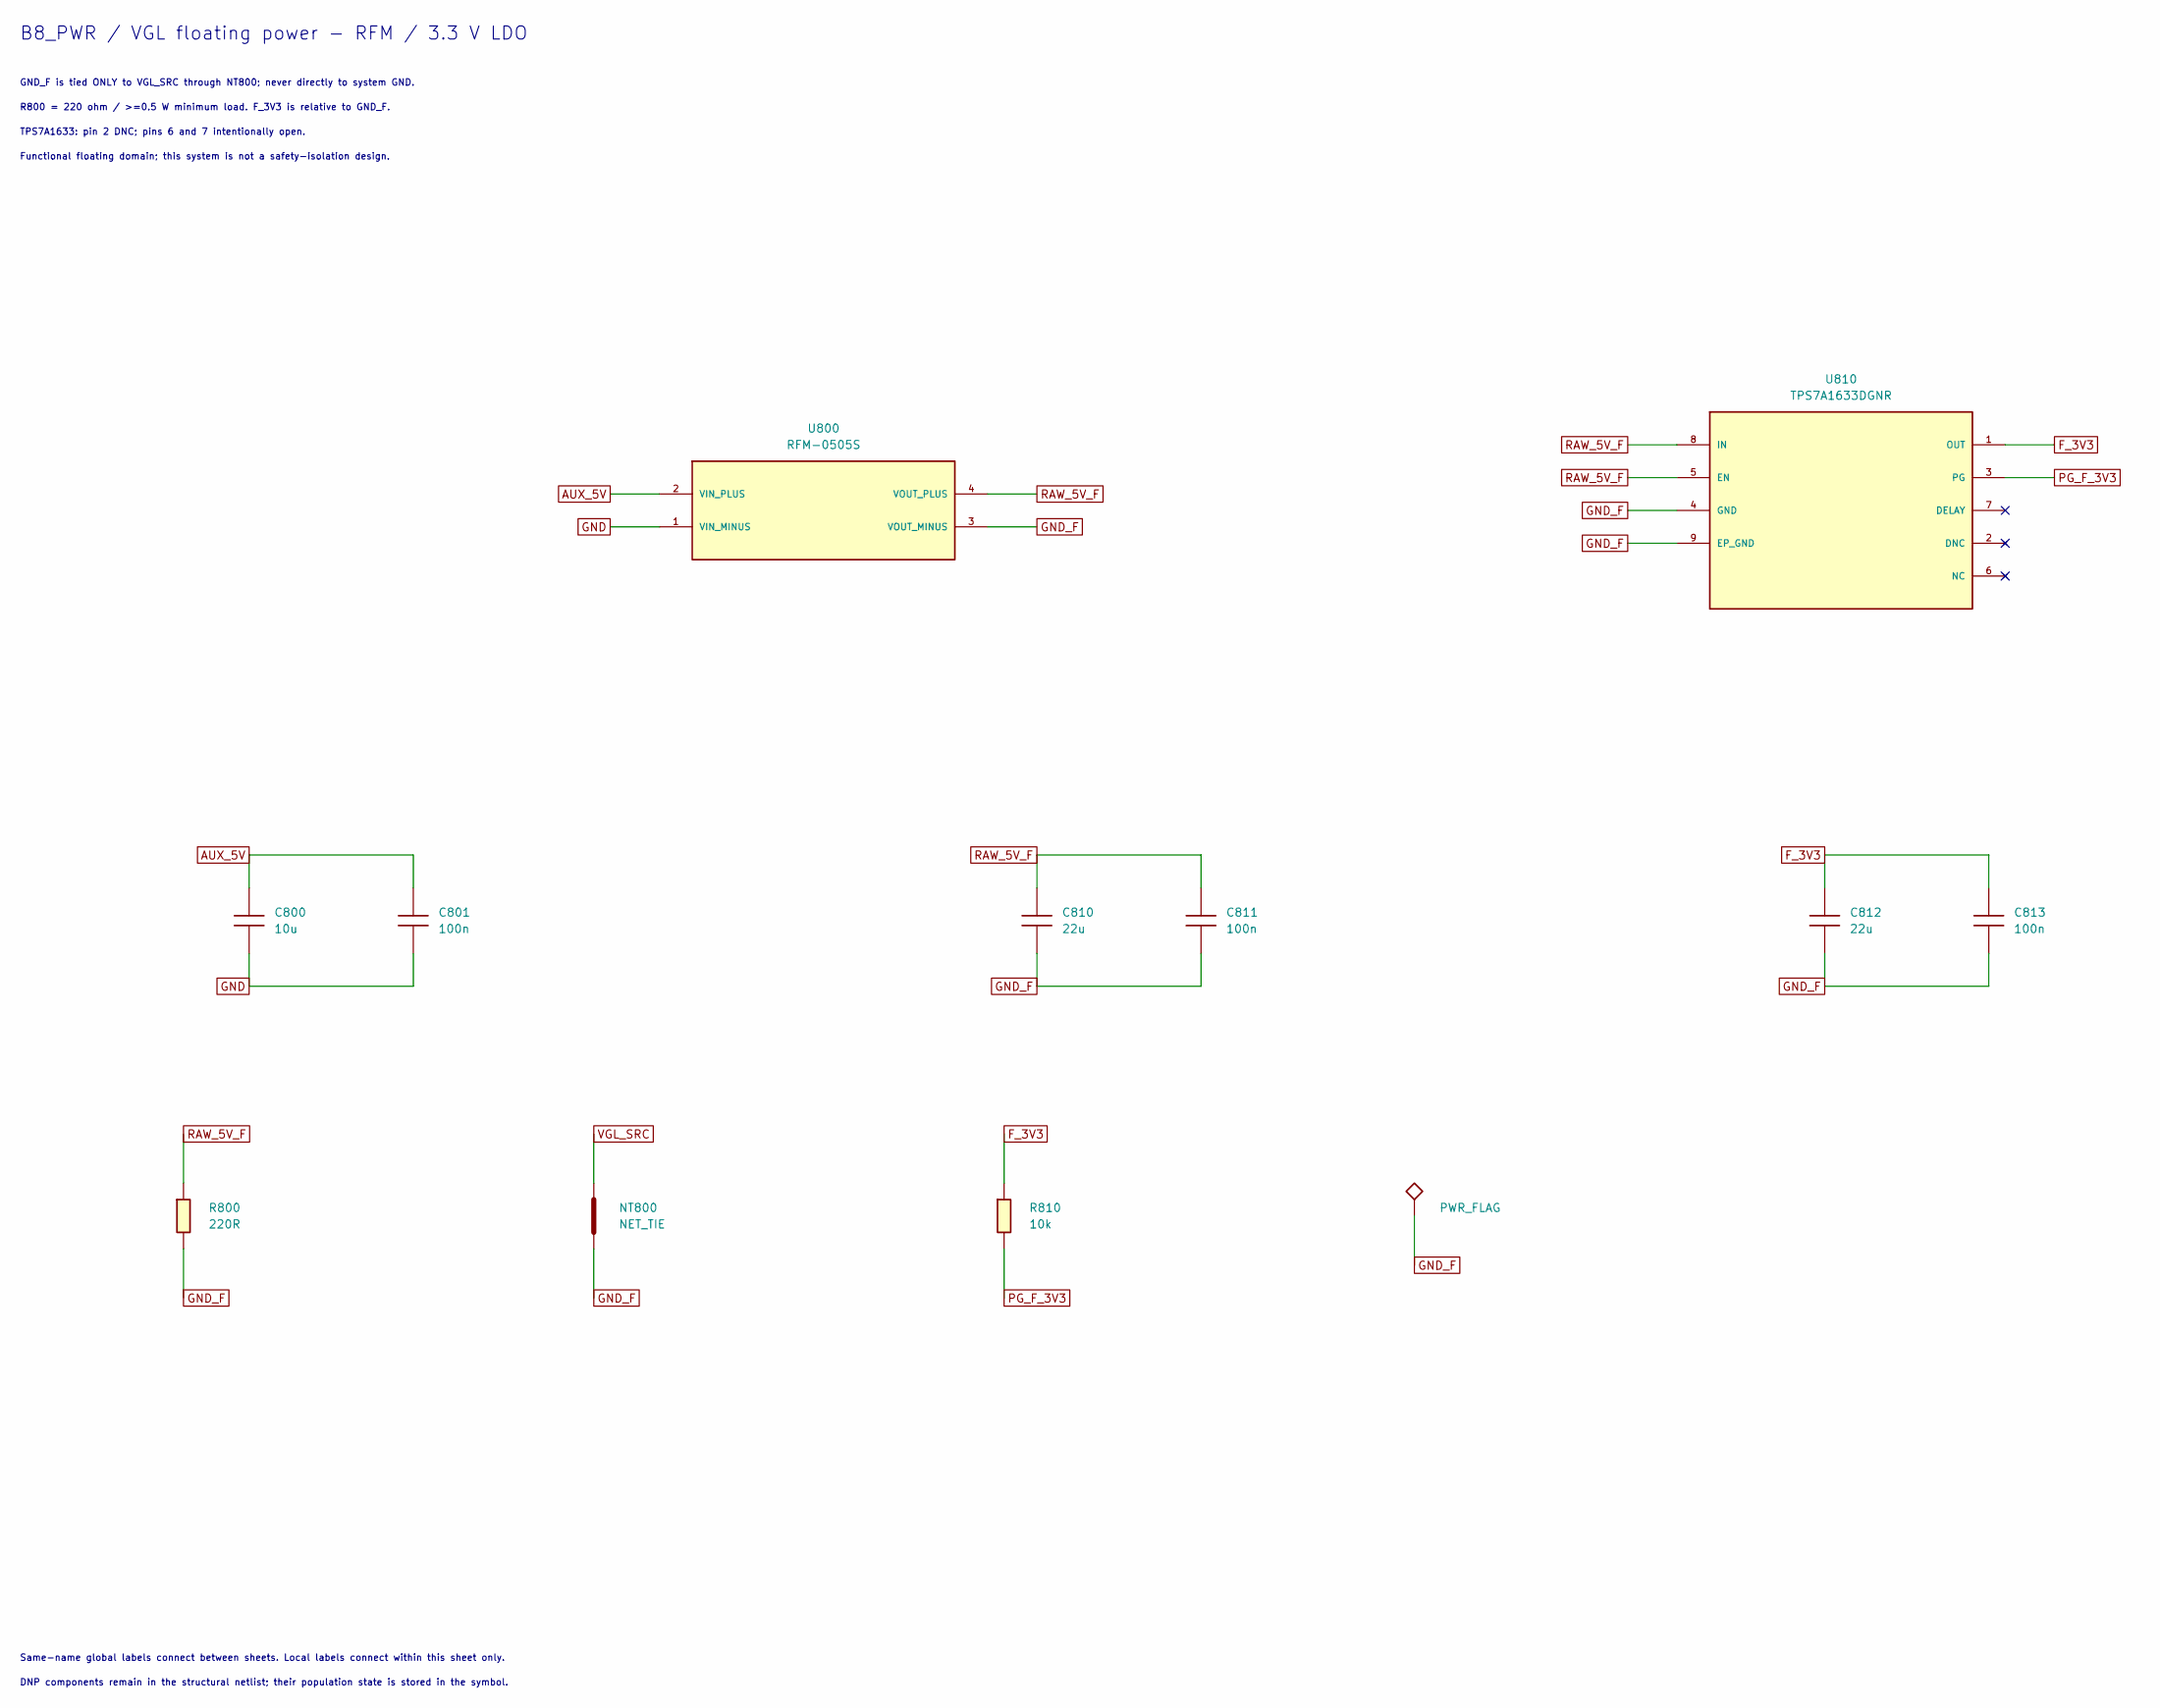
[picture p22: schematic B8_PWR.kicad_sch]

Parts:
C800: 10u; C_1210_3225Metric; Rating 50V X7R ±10%; MPN 확인 필요: 유효용량·누설 검증 후 선정
C801, C811, C813: 100n; C_0603_1608Metric; Rating 50V X7R ±10%; MPN 확인 필요: 유효용량·누설 검증 후 선정
C810: 22u; C_1210_3225Metric; Rating 25V X7R ±10%; MPN 확인 필요: 유효용량·누설 검증 후 선정
C812: 22u; C_1210_3225Metric; Rating 16V X7R ±10%; MPN 확인 필요: 유효용량·누설 검증 후 선정
NT800: NET_TIE; NetTie-2_SMD_Pad0.5mm; Rating 동박 연결; BOM제외; MPN N/A
R800: 220R; R_2512_6332Metric; Rating 1%, ≥0.5W, ≥25V; MPN 확인 필요: 지정값·정격 구매품
R810: 10k; R_0603_1608Metric; Rating 1%, ≥0.1W, ≥50V; MPN 확인 필요: 지정값·정격 구매품
U800: RFM-0505S; Rating 5V±10% 입력,5V/200mA 비안정화,기능절연; MPN RFM-0505S
U810: TPS7A1633DGNR; Rating 데이터시트 운용범위 적용; MPN TPS7A1633DGNR

Connections:
AUX_5V: C800.1, C801.1, U800.2 (VIN_PLUS)
F_3V3: C812.1, C813.1, R810.1, U810.1 (OUT)
GND: C800.2, C801.2, U800.1 (VIN_MINUS)
GND_F: C810.2, C811.2, C812.2, C813.2, NT800.2, R800.2, U800.3 (VOUT_MINUS), U810.4 (GND), U810.9 (EP_GND)
PG_F_3V3: R810.2, U810.3 (PG)
RAW_5V_F: C810.1, C811.1, R800.1, U800.4 (VOUT_PLUS), U810.5 (EN), U810.8 (IN)
VGL_SRC: NT800.1

Notes on the sheet:
B8_PWR / VGL floating power - RFM / 3.3 V LDO
GND_F is tied ONLY to VGL_SRC through NT800; never directly to system GND.
R800 = 220 ohm / >=0.5 W minimum load. F_3V3 is relative to GND_F.
TPS7A1633: pin 2 DNC; pins 6 and 7 intentionally open.
Functional floating domain; this system is not a safety-isolation design.
Same-name global labels connect between sheets. Local labels connect within this sheet only.
DNP components remain in the structural netlist; their population state is stored in the symbol.
