Gugong0412/currentboard/R2_REPAIRED_006/B8_VGL2.kicad_sch

## KiCad design R2_REPAIRED_006/B8_VGL2.kicad_sch (2026-10-15)

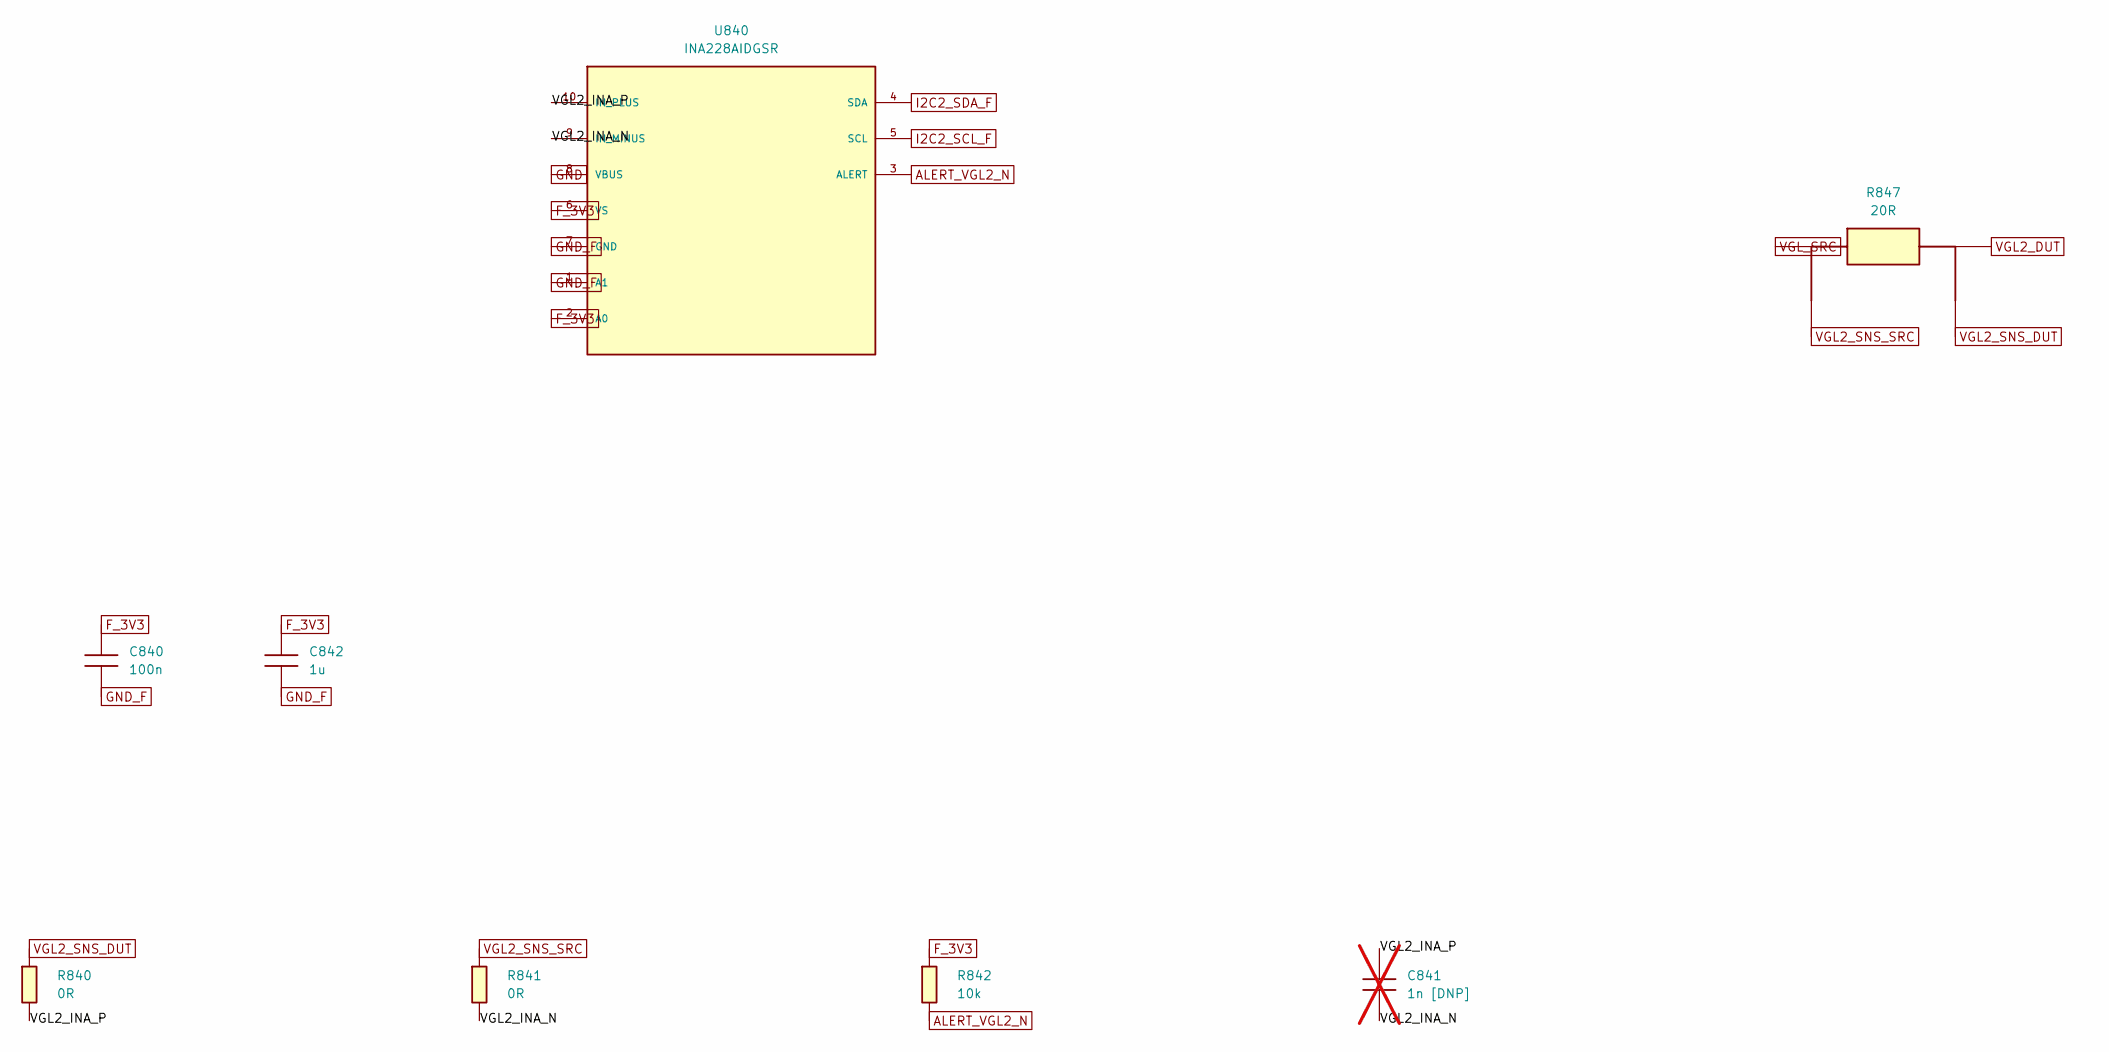
[picture p23: schematic B8_VGL2.kicad_sch]

Parts:
C840: 100n; C_0603_1608Metric; Rating 16V X7R ±10%; MPN 확인 필요: 유효용량·누설 검증 후 선정
C841: 1n [DNP]; C_0603_1608Metric; Rating 25V C0G ±5%; MPN 확인 필요: 유효용량·누설 검증 후 선정; not fitted
C842: 1u; C_0603_1608Metric; Rating 16V X7R ±10%; MPN 확인 필요: 유효용량·누설 검증 후 선정
R840, R841: 0R; R_0603_1608Metric; Rating jumper; ≤50mΩ 목표, ≥0.1W; MPN 확인 필요: 지정값·정격 구매품
R842: 10k; R_0603_1608Metric; Rating 1%, ≥0.1W, ≥50V; MPN 확인 필요: 지정값·정격 구매품
R847: 20R; Rating 0.1%, ≤25ppm/°C, 0.25W 요구; 발주 원문 확인; MPN RT1206BRD0720RL
U840: INA228AIDGSR; VSSOP-10_3x3mm_P0.5mm; Rating 데이터시트 운용범위 적용; MPN INA228AIDGSR

Connections:
ALERT_VGL2_N: R842.2, U840.3 (ALERT)
F_3V3: C840.1, C842.1, R842.1, U840.2 (A0), U840.6 (VS)
GND: U840.8 (VBUS)
GND_F: C840.2, C842.2, U840.1 (A1), U840.7 (GND)
I2C2_SCL_F: U840.5 (SCL)
I2C2_SDA_F: U840.4 (SDA)
VGL2_DUT: R847.2 (FORCE_DUT)
VGL2_INA_N: C841.2, R841.2, U840.9 (IN_MINUS)
VGL2_INA_P: C841.1, R840.2, U840.10 (IN_PLUS)
VGL2_SNS_DUT: R840.1, R847.4 (SENSE_DUT)
VGL2_SNS_SRC: R841.1, R847.3 (SENSE_SRC)
VGL_SRC: R847.1 (FORCE_SRC)
