Gugong0412/currentboard/R2_REPAIRED_006/B10_A.kicad_sch

## KiCad design R2_REPAIRED_006/B10_A.kicad_sch (2026-10-15)

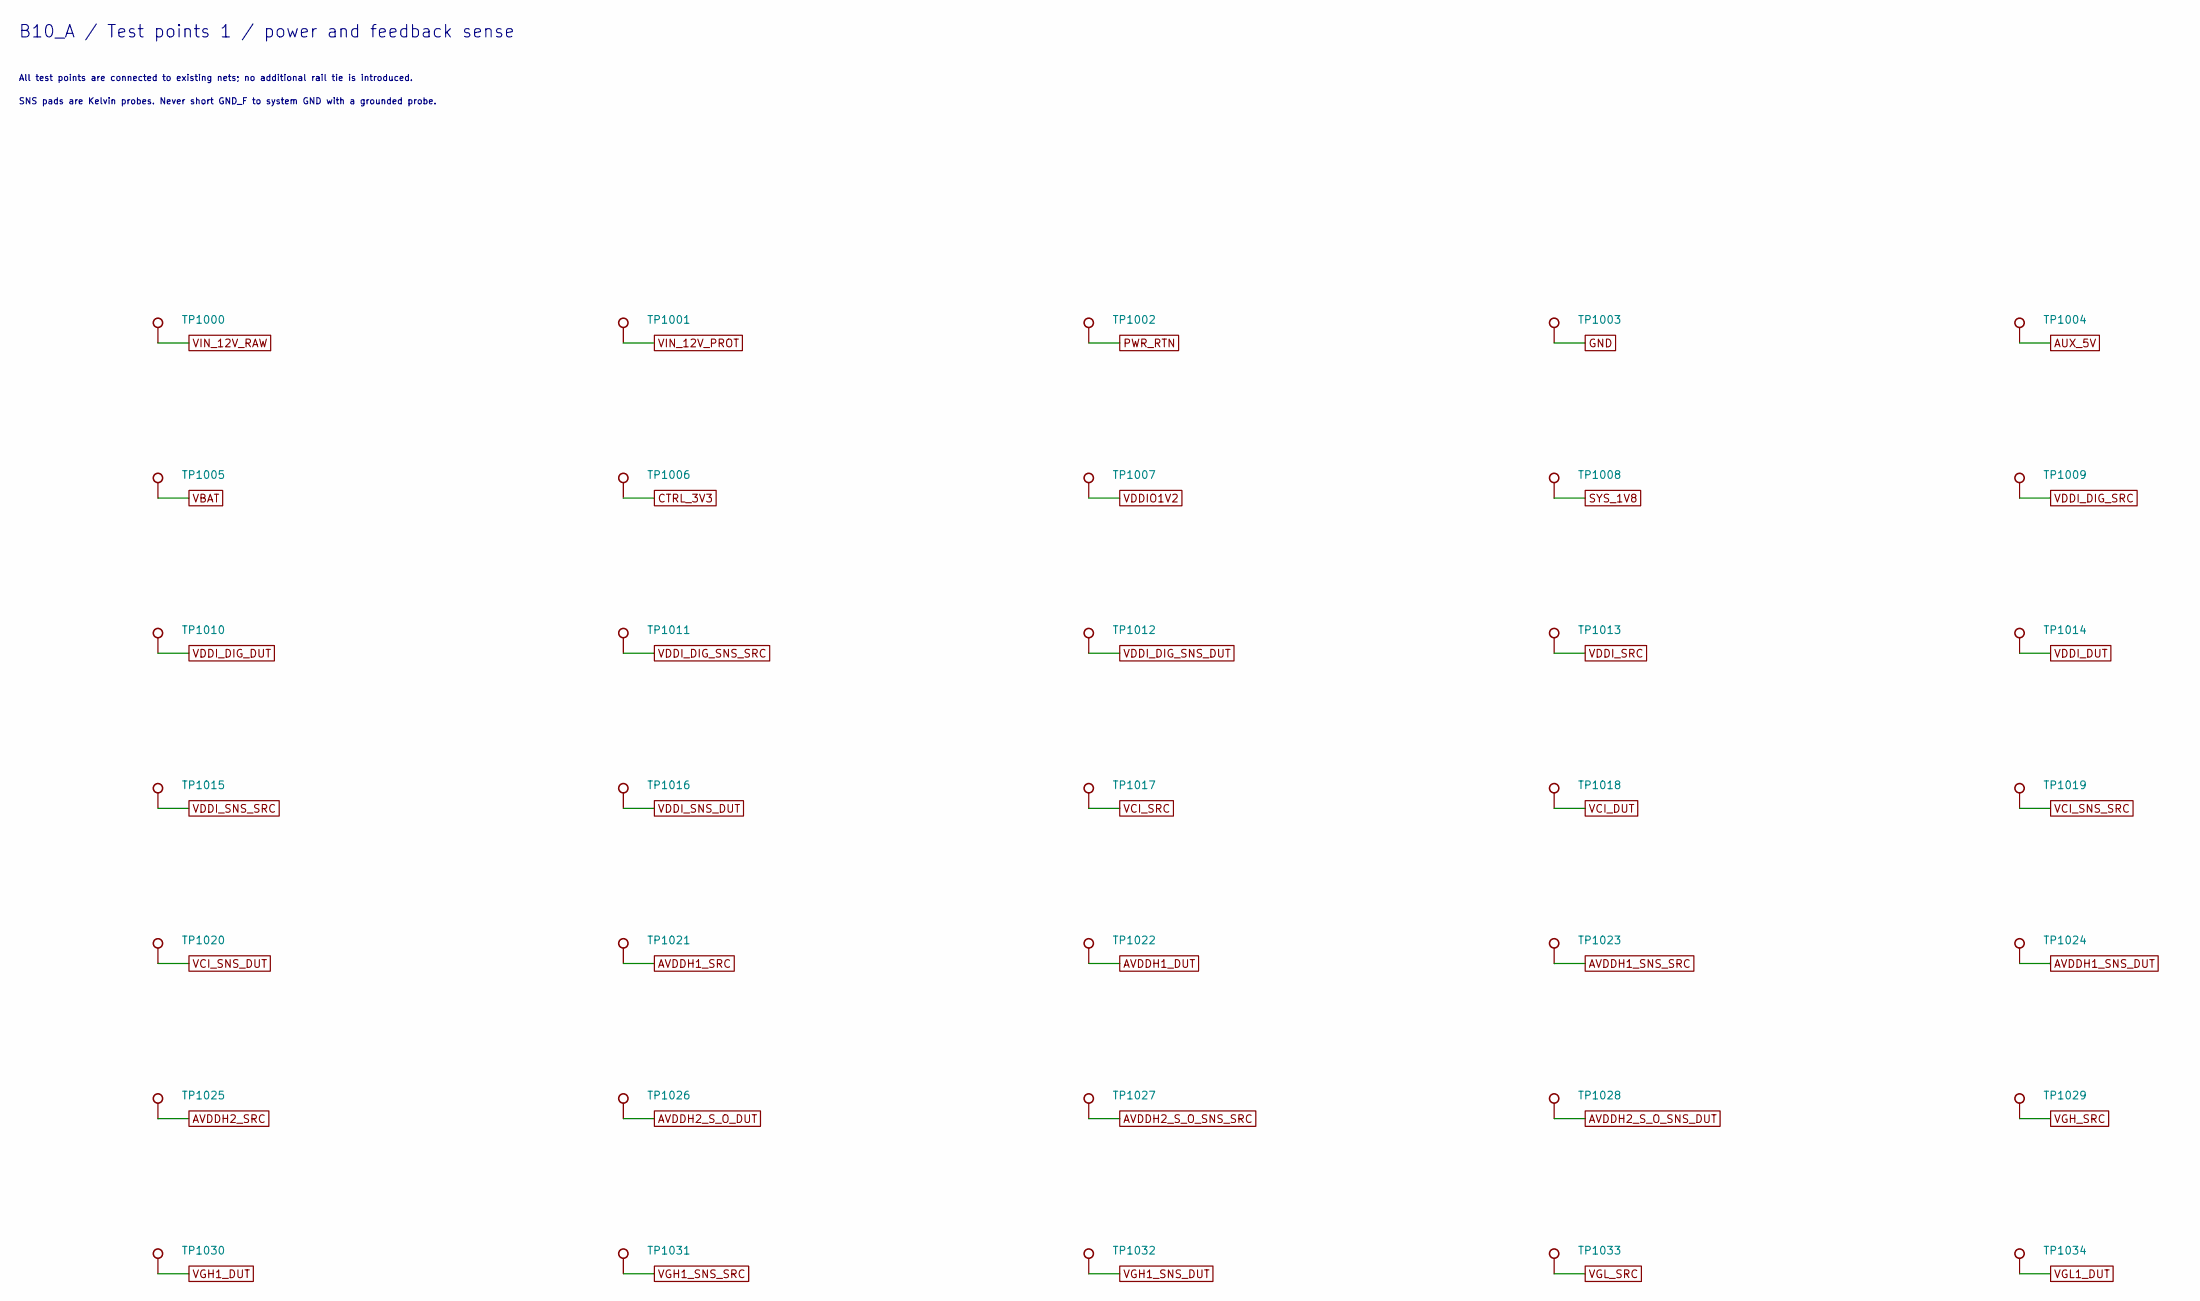
[picture p24: schematic B10_A.kicad_sch]

Parts:
TP1000: VIN_12V_RAW; TestPoint_Pad_D1.5mm; Rating 동박노출 pad1.5mm; BOM 제외; MPN N/A
TP1001: VIN_12V_PROT; TestPoint_Pad_D1.5mm; Rating 동박노출 pad1.5mm; BOM 제외; MPN N/A
TP1002: PWR_RTN; TestPoint_Pad_D1.5mm; Rating 동박노출 pad1.5mm; BOM 제외; MPN N/A
TP1003: GND; TestPoint_Pad_D1.5mm; Rating 동박노출 pad1.5mm; BOM 제외; MPN N/A
TP1004: AUX_5V; TestPoint_Pad_D1.5mm; Rating 동박노출 pad1.5mm; BOM 제외; MPN N/A
TP1005: VBAT; TestPoint_Pad_D1.5mm; Rating 동박노출 pad1.5mm; BOM 제외; MPN N/A
TP1006: CTRL_3V3; TestPoint_Pad_D1.5mm; Rating 동박노출 pad1.5mm; BOM 제외; MPN N/A
TP1007: VDDIO1V2; TestPoint_Pad_D1.5mm; Rating 동박노출 pad1.5mm; BOM 제외; MPN N/A
TP1008: SYS_1V8; TestPoint_Pad_D1.5mm; Rating 동박노출 pad1.5mm; BOM 제외; MPN N/A
TP1009: VDDI_DIG_SRC; TestPoint_Pad_D1.5mm; Rating 동박노출 pad1.5mm; BOM 제외; MPN N/A
TP1010: VDDI_DIG_DUT; TestPoint_Pad_D1.5mm; Rating 동박노출 pad1.5mm; BOM 제외; MPN N/A
TP1011: VDDI_DIG_SNS_SRC; TestPoint_Pad_D1.5mm; Rating 동박노출 pad1.5mm; BOM 제외; MPN N/A
TP1012: VDDI_DIG_SNS_DUT; TestPoint_Pad_D1.5mm; Rating 동박노출 pad1.5mm; BOM 제외; MPN N/A
TP1013: VDDI_SRC; TestPoint_Pad_D1.5mm; Rating 동박노출 pad1.5mm; BOM 제외; MPN N/A
TP1014: VDDI_DUT; TestPoint_Pad_D1.5mm; Rating 동박노출 pad1.5mm; BOM 제외; MPN N/A
TP1015: VDDI_SNS_SRC; TestPoint_Pad_D1.5mm; Rating 동박노출 pad1.5mm; BOM 제외; MPN N/A
TP1016: VDDI_SNS_DUT; TestPoint_Pad_D1.5mm; Rating 동박노출 pad1.5mm; BOM 제외; MPN N/A
TP1017: VCI_SRC; TestPoint_Pad_D1.5mm; Rating 동박노출 pad1.5mm; BOM 제외; MPN N/A
TP1018: VCI_DUT; TestPoint_Pad_D1.5mm; Rating 동박노출 pad1.5mm; BOM 제외; MPN N/A
TP1019: VCI_SNS_SRC; TestPoint_Pad_D1.5mm; Rating 동박노출 pad1.5mm; BOM 제외; MPN N/A
TP1020: VCI_SNS_DUT; TestPoint_Pad_D1.5mm; Rating 동박노출 pad1.5mm; BOM 제외; MPN N/A
TP1021: AVDDH1_SRC; TestPoint_Pad_D1.5mm; Rating 동박노출 pad1.5mm; BOM 제외; MPN N/A
TP1022: AVDDH1_DUT; TestPoint_Pad_D1.5mm; Rating 동박노출 pad1.5mm; BOM 제외; MPN N/A
TP1023: AVDDH1_SNS_SRC; TestPoint_Pad_D1.5mm; Rating 동박노출 pad1.5mm; BOM 제외; MPN N/A
TP1024: AVDDH1_SNS_DUT; TestPoint_Pad_D1.5mm; Rating 동박노출 pad1.5mm; BOM 제외; MPN N/A
TP1025: AVDDH2_SRC; TestPoint_Pad_D1.5mm; Rating 동박노출 pad1.5mm; BOM 제외; MPN N/A
TP1026: AVDDH2_S_O_DUT; TestPoint_Pad_D1.5mm; Rating 동박노출 pad1.5mm; BOM 제외; MPN N/A
TP1027: AVDDH2_S_O_SNS_SRC; TestPoint_Pad_D1.5mm; Rating 동박노출 pad1.5mm; BOM 제외; MPN N/A
TP1028: AVDDH2_S_O_SNS_DUT; TestPoint_Pad_D1.5mm; Rating 동박노출 pad1.5mm; BOM 제외; MPN N/A
TP1029: VGH_SRC; TestPoint_Pad_D1.5mm; Rating 동박노출 pad1.5mm; BOM 제외; MPN N/A
TP1030: VGH1_DUT; TestPoint_Pad_D1.5mm; Rating 동박노출 pad1.5mm; BOM 제외; MPN N/A
TP1031: VGH1_SNS_SRC; TestPoint_Pad_D1.5mm; Rating 동박노출 pad1.5mm; BOM 제외; MPN N/A
TP1032: VGH1_SNS_DUT; TestPoint_Pad_D1.5mm; Rating 동박노출 pad1.5mm; BOM 제외; MPN N/A
TP1033: VGL_SRC; TestPoint_Pad_D1.5mm; Rating 동박노출 pad1.5mm; BOM 제외; MPN N/A
TP1034: VGL1_DUT; TestPoint_Pad_D1.5mm; Rating 동박노출 pad1.5mm; BOM 제외; MPN N/A

Connections:
AUX_5V: TP1004.1
AVDDH1_DUT: TP1022.1
AVDDH1_SNS_DUT: TP1024.1
AVDDH1_SNS_SRC: TP1023.1
AVDDH1_SRC: TP1021.1
AVDDH2_SRC: TP1025.1
AVDDH2_S_O_DUT: TP1026.1
AVDDH2_S_O_SNS_DUT: TP1028.1
AVDDH2_S_O_SNS_SRC: TP1027.1
CTRL_3V3: TP1006.1
GND: TP1003.1
PWR_RTN: TP1002.1
SYS_1V8: TP1008.1
VBAT: TP1005.1
VCI_DUT: TP1018.1
VCI_SNS_DUT: TP1020.1
VCI_SNS_SRC: TP1019.1
VCI_SRC: TP1017.1
VDDIO1V2: TP1007.1
VDDI_DIG_DUT: TP1010.1
VDDI_DIG_SNS_DUT: TP1012.1
VDDI_DIG_SNS_SRC: TP1011.1
VDDI_DIG_SRC: TP1009.1
VDDI_DUT: TP1014.1
VDDI_SNS_DUT: TP1016.1
VDDI_SNS_SRC: TP1015.1
VDDI_SRC: TP1013.1
VGH1_DUT: TP1030.1
VGH1_SNS_DUT: TP1032.1
VGH1_SNS_SRC: TP1031.1
VGH_SRC: TP1029.1
VGL1_DUT: TP1034.1
VGL_SRC: TP1033.1
VIN_12V_PROT: TP1001.1
VIN_12V_RAW: TP1000.1

Notes on the sheet:
B10_A / Test points 1 / power and feedback sense
All test points are connected to existing nets; no additional rail tie is introduced.
SNS pads are Kelvin probes. Never short GND_F to system GND with a grounded probe.
