Gugong0412/currentboard/R2_REPAIRED_006/B10_B.kicad_sch

## KiCad design R2_REPAIRED_006/B10_B.kicad_sch (2026-10-15)

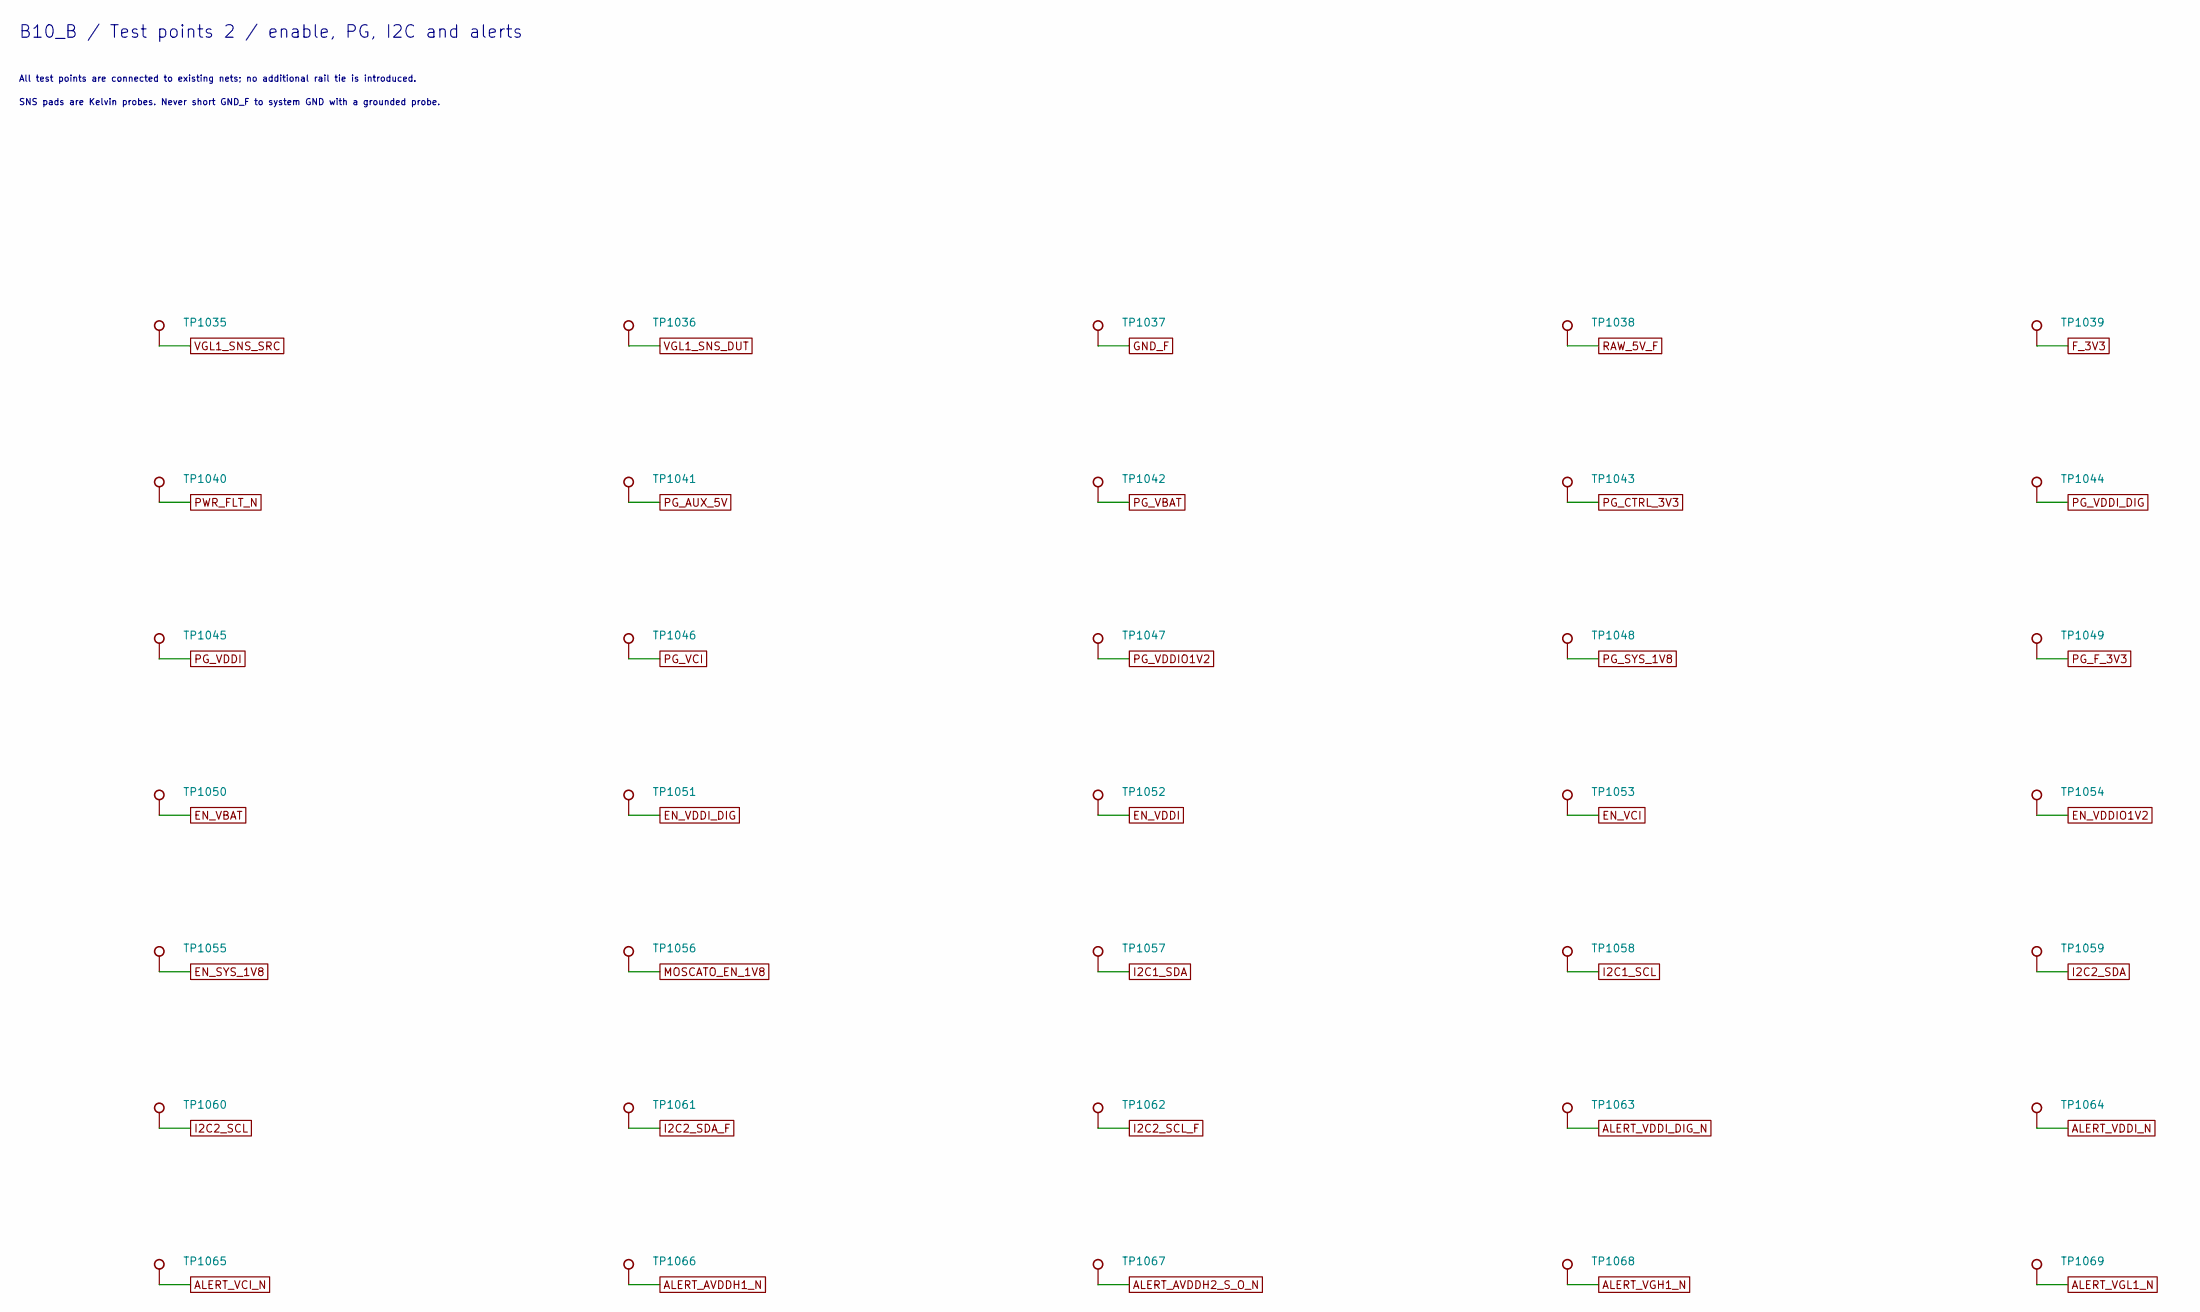
[picture p25: schematic B10_B.kicad_sch]

Parts:
TP1035: VGL1_SNS_SRC; TestPoint_Pad_D1.5mm; Rating 동박노출 pad1.5mm; BOM 제외; MPN N/A
TP1036: VGL1_SNS_DUT; TestPoint_Pad_D1.5mm; Rating 동박노출 pad1.5mm; BOM 제외; MPN N/A
TP1037: GND_F; TestPoint_Pad_D1.5mm; Rating 동박노출 pad1.5mm; BOM 제외; MPN N/A
TP1038: RAW_5V_F; TestPoint_Pad_D1.5mm; Rating 동박노출 pad1.5mm; BOM 제외; MPN N/A
TP1039: F_3V3; TestPoint_Pad_D1.5mm; Rating 동박노출 pad1.5mm; BOM 제외; MPN N/A
TP1040: PWR_FLT_N; TestPoint_Pad_D1.5mm; Rating 동박노출 pad1.5mm; BOM 제외; MPN N/A
TP1041: PG_AUX_5V; TestPoint_Pad_D1.5mm; Rating 동박노출 pad1.5mm; BOM 제외; MPN N/A
TP1042: PG_VBAT; TestPoint_Pad_D1.5mm; Rating 동박노출 pad1.5mm; BOM 제외; MPN N/A
TP1043: PG_CTRL_3V3; TestPoint_Pad_D1.5mm; Rating 동박노출 pad1.5mm; BOM 제외; MPN N/A
TP1044: PG_VDDI_DIG; TestPoint_Pad_D1.5mm; Rating 동박노출 pad1.5mm; BOM 제외; MPN N/A
TP1045: PG_VDDI; TestPoint_Pad_D1.5mm; Rating 동박노출 pad1.5mm; BOM 제외; MPN N/A
TP1046: PG_VCI; TestPoint_Pad_D1.5mm; Rating 동박노출 pad1.5mm; BOM 제외; MPN N/A
TP1047: PG_VDDIO1V2; TestPoint_Pad_D1.5mm; Rating 동박노출 pad1.5mm; BOM 제외; MPN N/A
TP1048: PG_SYS_1V8; TestPoint_Pad_D1.5mm; Rating 동박노출 pad1.5mm; BOM 제외; MPN N/A
TP1049: PG_F_3V3; TestPoint_Pad_D1.5mm; Rating 동박노출 pad1.5mm; BOM 제외; MPN N/A
TP1050: EN_VBAT; TestPoint_Pad_D1.5mm; Rating 동박노출 pad1.5mm; BOM 제외; MPN N/A
TP1051: EN_VDDI_DIG; TestPoint_Pad_D1.5mm; Rating 동박노출 pad1.5mm; BOM 제외; MPN N/A
TP1052: EN_VDDI; TestPoint_Pad_D1.5mm; Rating 동박노출 pad1.5mm; BOM 제외; MPN N/A
TP1053: EN_VCI; TestPoint_Pad_D1.5mm; Rating 동박노출 pad1.5mm; BOM 제외; MPN N/A
TP1054: EN_VDDIO1V2; TestPoint_Pad_D1.5mm; Rating 동박노출 pad1.5mm; BOM 제외; MPN N/A
TP1055: EN_SYS_1V8; TestPoint_Pad_D1.5mm; Rating 동박노출 pad1.5mm; BOM 제외; MPN N/A
TP1056: MOSCATO_EN_1V8; TestPoint_Pad_D1.5mm; Rating 동박노출 pad1.5mm; BOM 제외; MPN N/A
TP1057: I2C1_SDA; TestPoint_Pad_D1.5mm; Rating 동박노출 pad1.5mm; BOM 제외; MPN N/A
TP1058: I2C1_SCL; TestPoint_Pad_D1.5mm; Rating 동박노출 pad1.5mm; BOM 제외; MPN N/A
TP1059: I2C2_SDA; TestPoint_Pad_D1.5mm; Rating 동박노출 pad1.5mm; BOM 제외; MPN N/A
TP1060: I2C2_SCL; TestPoint_Pad_D1.5mm; Rating 동박노출 pad1.5mm; BOM 제외; MPN N/A
TP1061: I2C2_SDA_F; TestPoint_Pad_D1.5mm; Rating 동박노출 pad1.5mm; BOM 제외; MPN N/A
TP1062: I2C2_SCL_F; TestPoint_Pad_D1.5mm; Rating 동박노출 pad1.5mm; BOM 제외; MPN N/A
TP1063: ALERT_VDDI_DIG_N; TestPoint_Pad_D1.5mm; Rating 동박노출 pad1.5mm; BOM 제외; MPN N/A
TP1064: ALERT_VDDI_N; TestPoint_Pad_D1.5mm; Rating 동박노출 pad1.5mm; BOM 제외; MPN N/A
TP1065: ALERT_VCI_N; TestPoint_Pad_D1.5mm; Rating 동박노출 pad1.5mm; BOM 제외; MPN N/A
TP1066: ALERT_AVDDH1_N; TestPoint_Pad_D1.5mm; Rating 동박노출 pad1.5mm; BOM 제외; MPN N/A
TP1067: ALERT_AVDDH2_S_O_N; TestPoint_Pad_D1.5mm; Rating 동박노출 pad1.5mm; BOM 제외; MPN N/A
TP1068: ALERT_VGH1_N; TestPoint_Pad_D1.5mm; Rating 동박노출 pad1.5mm; BOM 제외; MPN N/A
TP1069: ALERT_VGL1_N; TestPoint_Pad_D1.5mm; Rating 동박노출 pad1.5mm; BOM 제외; MPN N/A

Connections:
ALERT_AVDDH1_N: TP1066.1
ALERT_AVDDH2_S_O_N: TP1067.1
ALERT_VCI_N: TP1065.1
ALERT_VDDI_DIG_N: TP1063.1
ALERT_VDDI_N: TP1064.1
ALERT_VGH1_N: TP1068.1
ALERT_VGL1_N: TP1069.1
EN_SYS_1V8: TP1055.1
EN_VBAT: TP1050.1
EN_VCI: TP1053.1
EN_VDDI: TP1052.1
EN_VDDIO1V2: TP1054.1
EN_VDDI_DIG: TP1051.1
F_3V3: TP1039.1
GND_F: TP1037.1
I2C1_SCL: TP1058.1
I2C1_SDA: TP1057.1
I2C2_SCL: TP1060.1
I2C2_SCL_F: TP1062.1
I2C2_SDA: TP1059.1
I2C2_SDA_F: TP1061.1
MOSCATO_EN_1V8: TP1056.1
PG_AUX_5V: TP1041.1
PG_CTRL_3V3: TP1043.1
PG_F_3V3: TP1049.1
PG_SYS_1V8: TP1048.1
PG_VBAT: TP1042.1
PG_VCI: TP1046.1
PG_VDDI: TP1045.1
PG_VDDIO1V2: TP1047.1
PG_VDDI_DIG: TP1044.1
PWR_FLT_N: TP1040.1
RAW_5V_F: TP1038.1
VGL1_SNS_DUT: TP1036.1
VGL1_SNS_SRC: TP1035.1

Notes on the sheet:
B10_B / Test points 2 / enable, PG, I2C and alerts
All test points are connected to existing nets; no additional rail tie is introduced.
SNS pads are Kelvin probes. Never short GND_F to system GND with a grounded probe.
