Gugong0412/currentboard/R2_REPAIRED_006/B11_CLOCK.kicad_sch

## KiCad design R2_REPAIRED_006/B11_CLOCK.kicad_sch (2026-10-15)

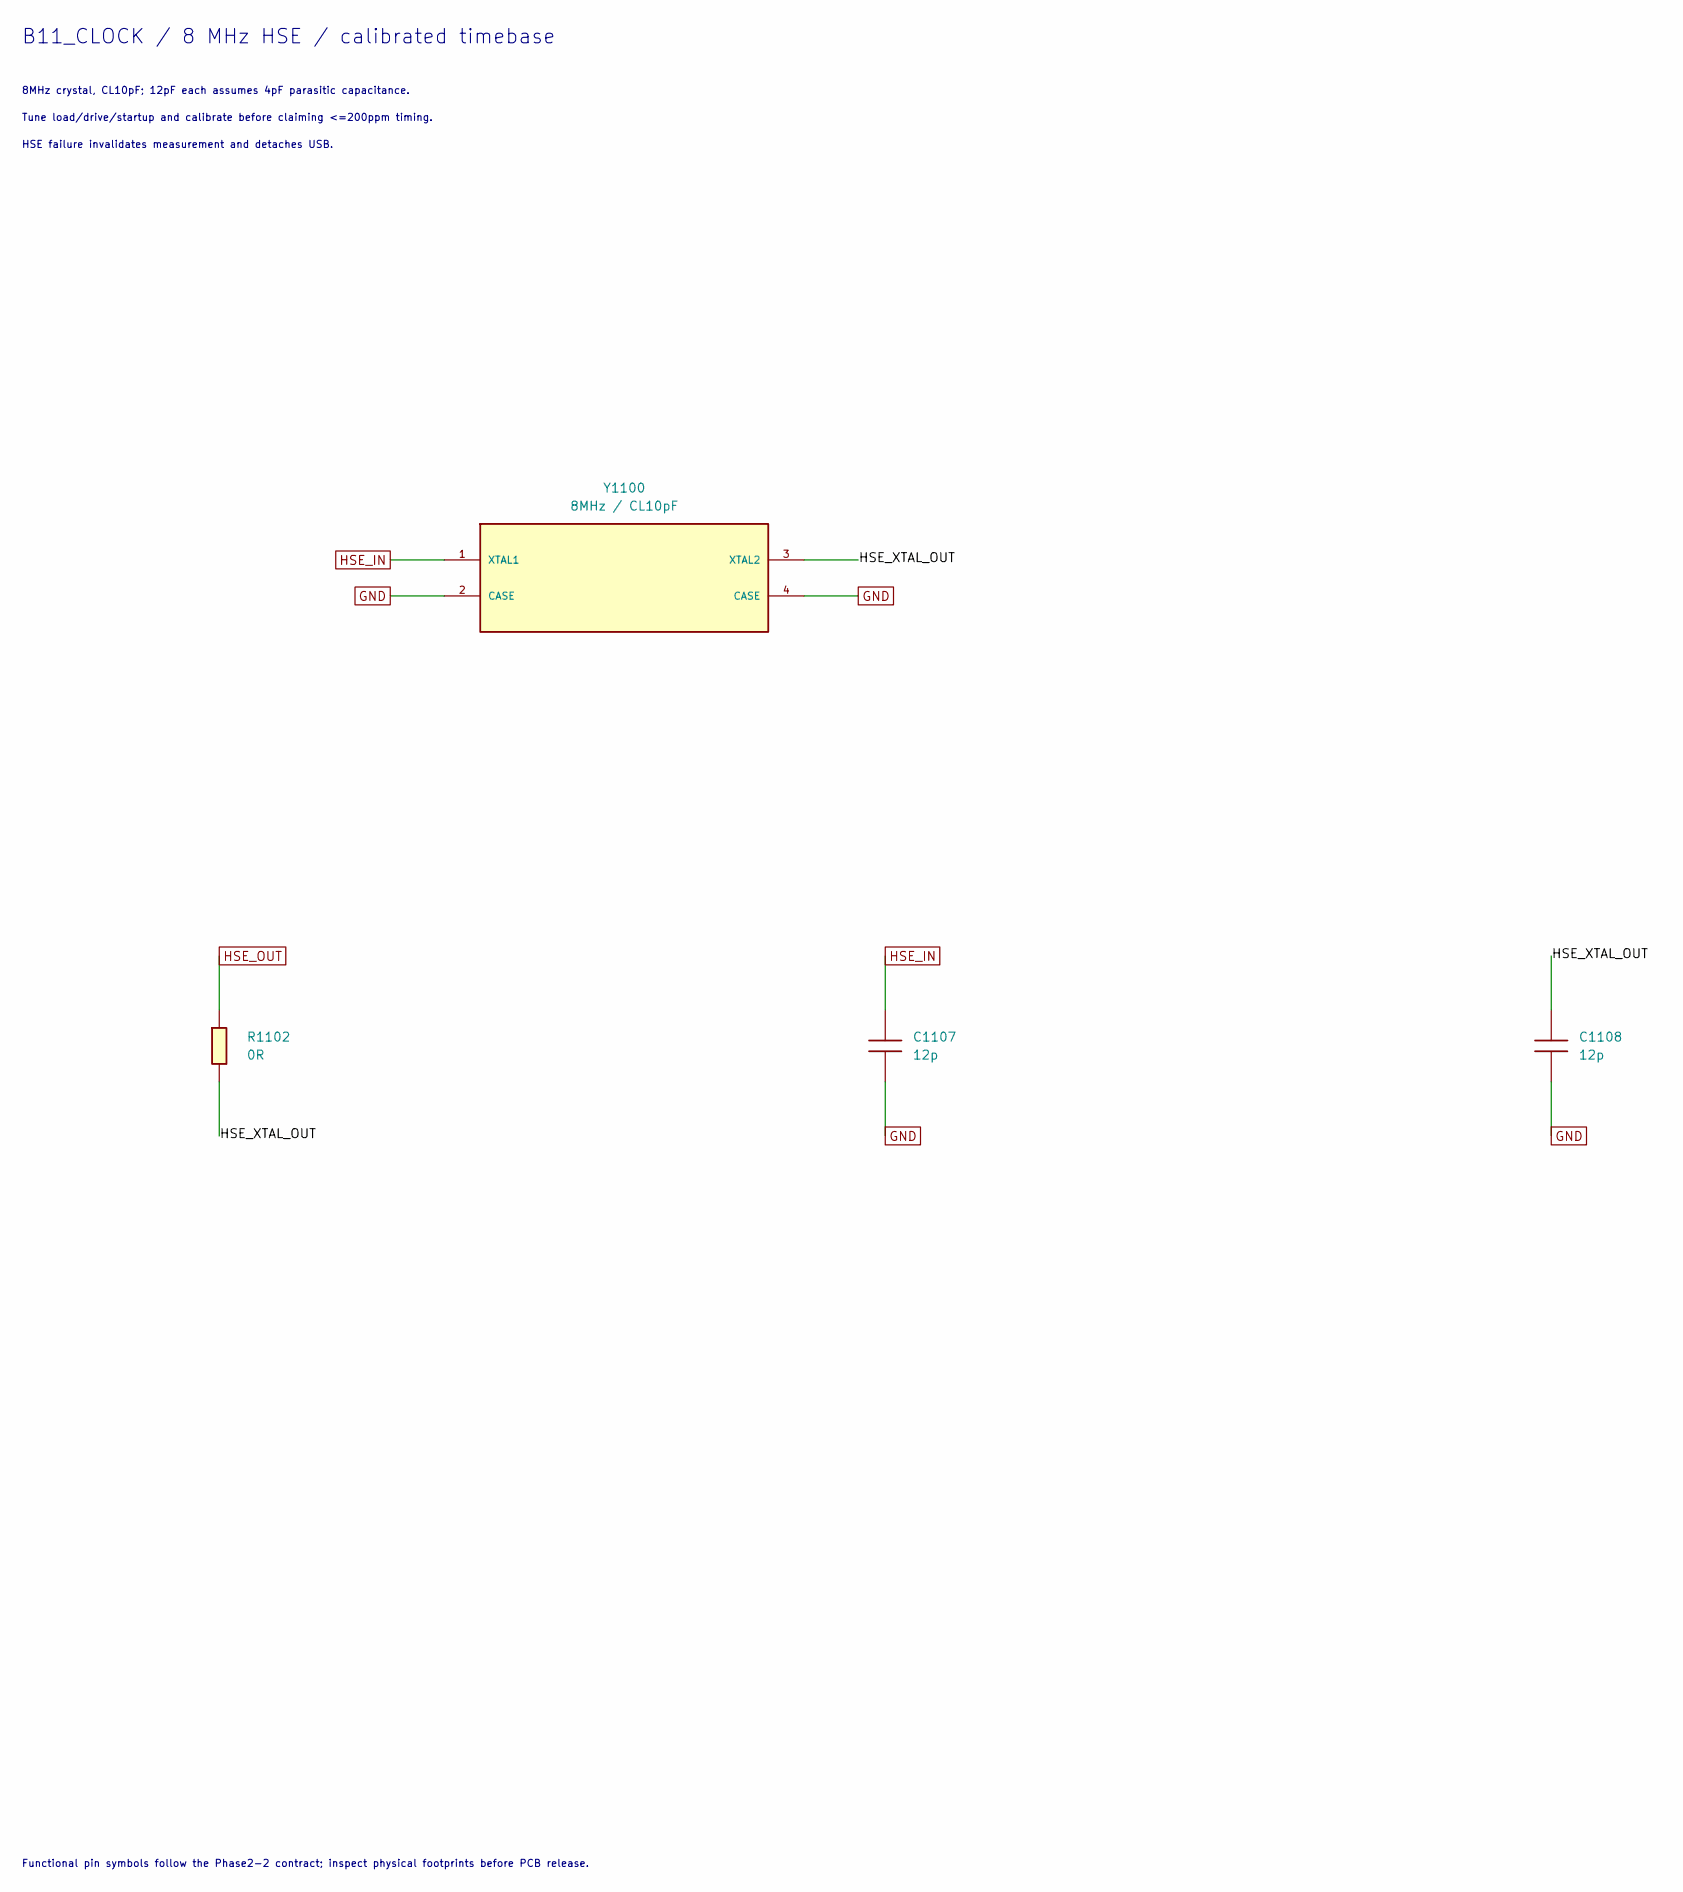
[picture p26: schematic B11_CLOCK.kicad_sch]

Parts:
C1107, C1108: 12p; C_0603_1608Metric; Rating 50V C0G ±1%; MPN 확인 필요: 유효용량·공차 구매품
R1102: 0R; R_0603_1608Metric; Rating 1%, ≥0.1W, ≥50V; MPN 확인 필요: 지정값·정격 구매품
Y1100: 8MHz / CL10pF; Crystal_SMD_5032-4Pin_5.0x3.2mm; Rating ±10ppm initial, ±10ppm temperature(-10~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; MPN ABM3B-8.000MHZ-10-1-U-T

Connections:
GND: C1107.2, C1108.2, Y1100.2 (CASE), Y1100.4 (CASE)
HSE_IN: C1107.1, Y1100.1 (XTAL1)
HSE_OUT: R1102.1
HSE_XTAL_OUT: C1108.1, R1102.2, Y1100.3 (XTAL2)

Notes on the sheet:
B11_CLOCK / 8 MHz HSE / calibrated timebase
8MHz crystal, CL10pF; 12pF each assumes 4pF parasitic capacitance.
Tune load/drive/startup and calibrate before claiming <=200ppm timing.
HSE failure invalidates measurement and detaches USB.
Functional pin symbols follow the Phase2-2 contract; inspect physical footprints before PCB release.
