Gugong0412/currentboard/R2_REPAIRED_006/B11_DEBUG.kicad_sch

## KiCad design R2_REPAIRED_006/B11_DEBUG.kicad_sch (2026-10-15)

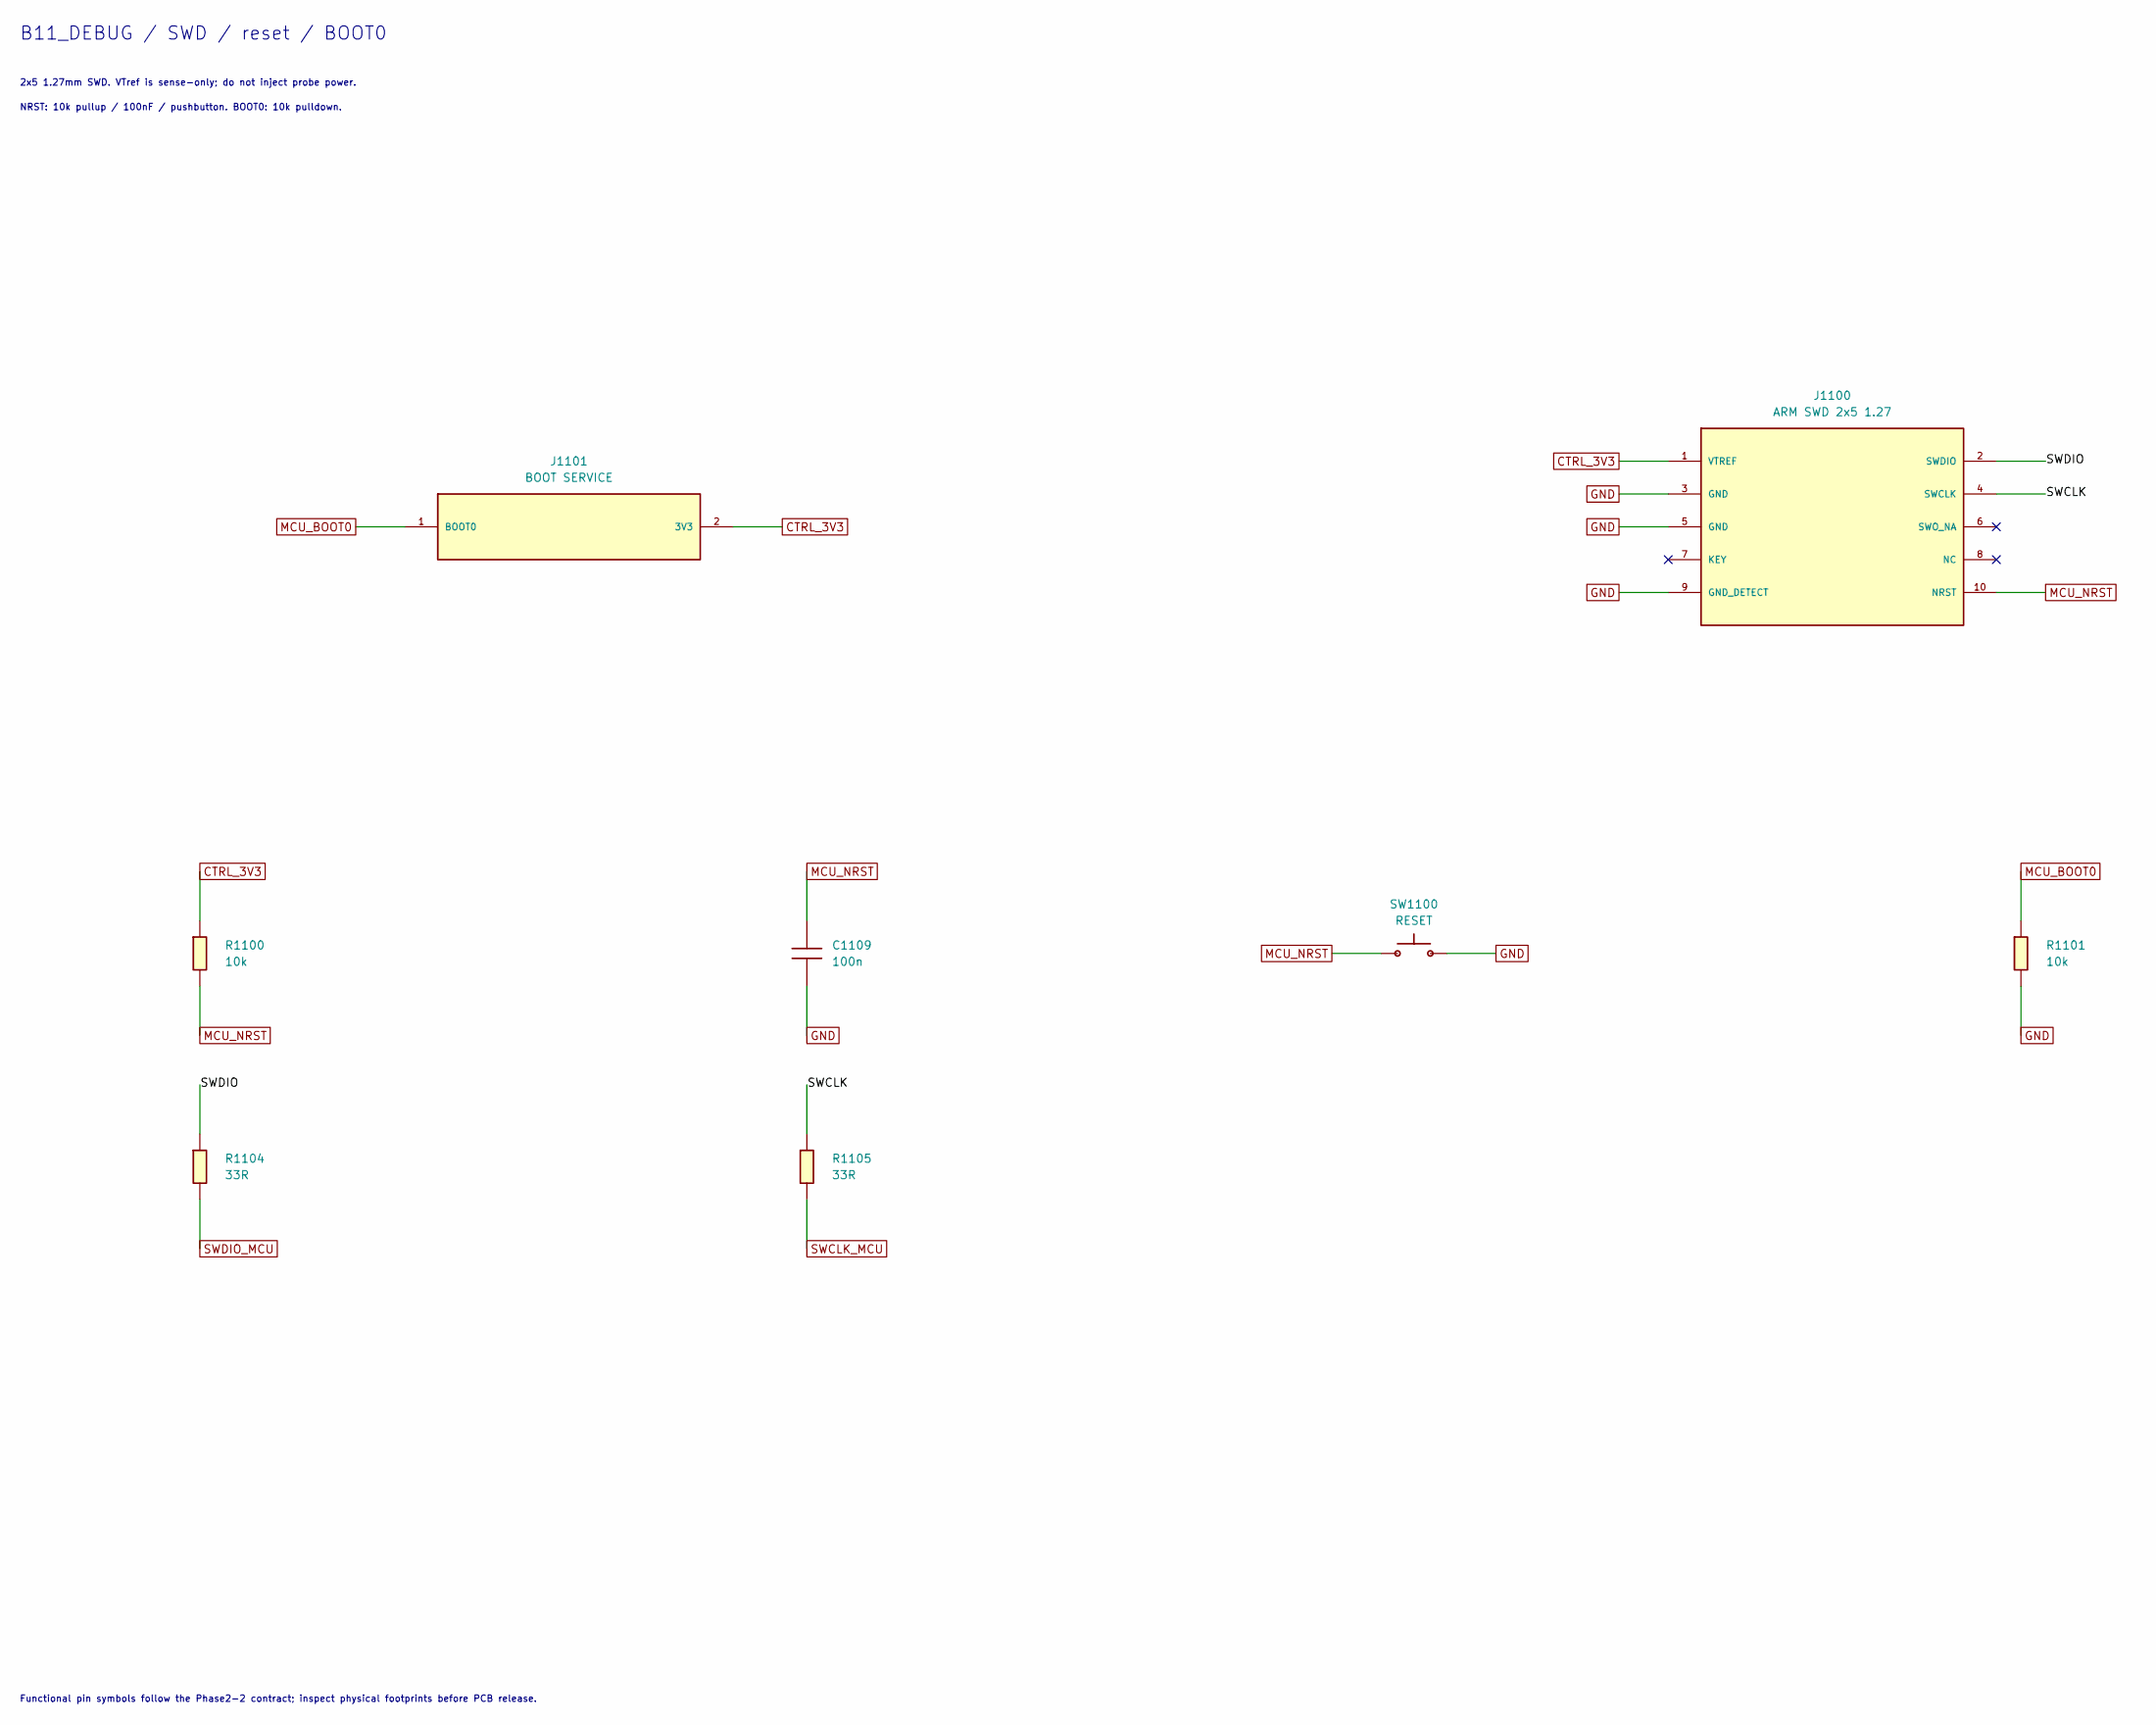
[picture p27: schematic B11_DEBUG.kicad_sch]

Parts:
C1109: 100n; C_0603_1608Metric; Rating 16V X7R ±10%; MPN 확인 필요: 유효용량·공차 구매품
J1100: ARM SWD 2x5 1.27; PinHeader_2x05_P1.27mm_Vertical_SMD; Rating 1.27mm; footprint tail/land pattern 최종 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; MPN FTSH-105-01-L-DV-K
J1101: BOOT SERVICE; PinHeader_1x02_P2.54mm_Vertical; Rating 3.3V, shunt 기본 미장착; MPN 확인 필요: 1x2 2.54mm
R1100, R1101: 10k; R_0603_1608Metric; Rating 1%, ≥0.1W, ≥50V; MPN 확인 필요: 지정값·정격 구매품
R1104, R1105: 33R; R_0603_1608Metric; Rating 1%, ≥0.1W, ≥50V; MPN 확인 필요: 지정값·정격 구매품
SW1100: RESET; SW_SPST_B3U-1000P; Rating 접점 정격 원문 확인 필요; MPN B3U-1000P

Connections:
CTRL_3V3: J1100.1 (VTREF), J1101.2 (3V3), R1100.1
GND: C1109.2, J1100.3 (GND), J1100.5 (GND), J1100.9 (GND_DETECT), R1101.2, SW1100.2
MCU_BOOT0: J1101.1 (BOOT0), R1101.1
MCU_NRST: C1109.1, J1100.10 (NRST), R1100.2, SW1100.1
SWCLK: J1100.4 (SWCLK), R1105.1
SWCLK_MCU: R1105.2
SWDIO: J1100.2 (SWDIO), R1104.1
SWDIO_MCU: R1104.2

Notes on the sheet:
B11_DEBUG / SWD / reset / BOOT0
2x5 1.27mm SWD. VTref is sense-only; do not inject probe power.
NRST: 10k pullup / 100nF / pushbutton. BOOT0: 10k pulldown.
Functional pin symbols follow the Phase2-2 contract; inspect physical footprints before PCB release.
