Gugong0412/currentboard/R2_REPAIRED_006/B11_POWER.kicad_sch

## KiCad design R2_REPAIRED_006/B11_POWER.kicad_sch (2026-10-15)

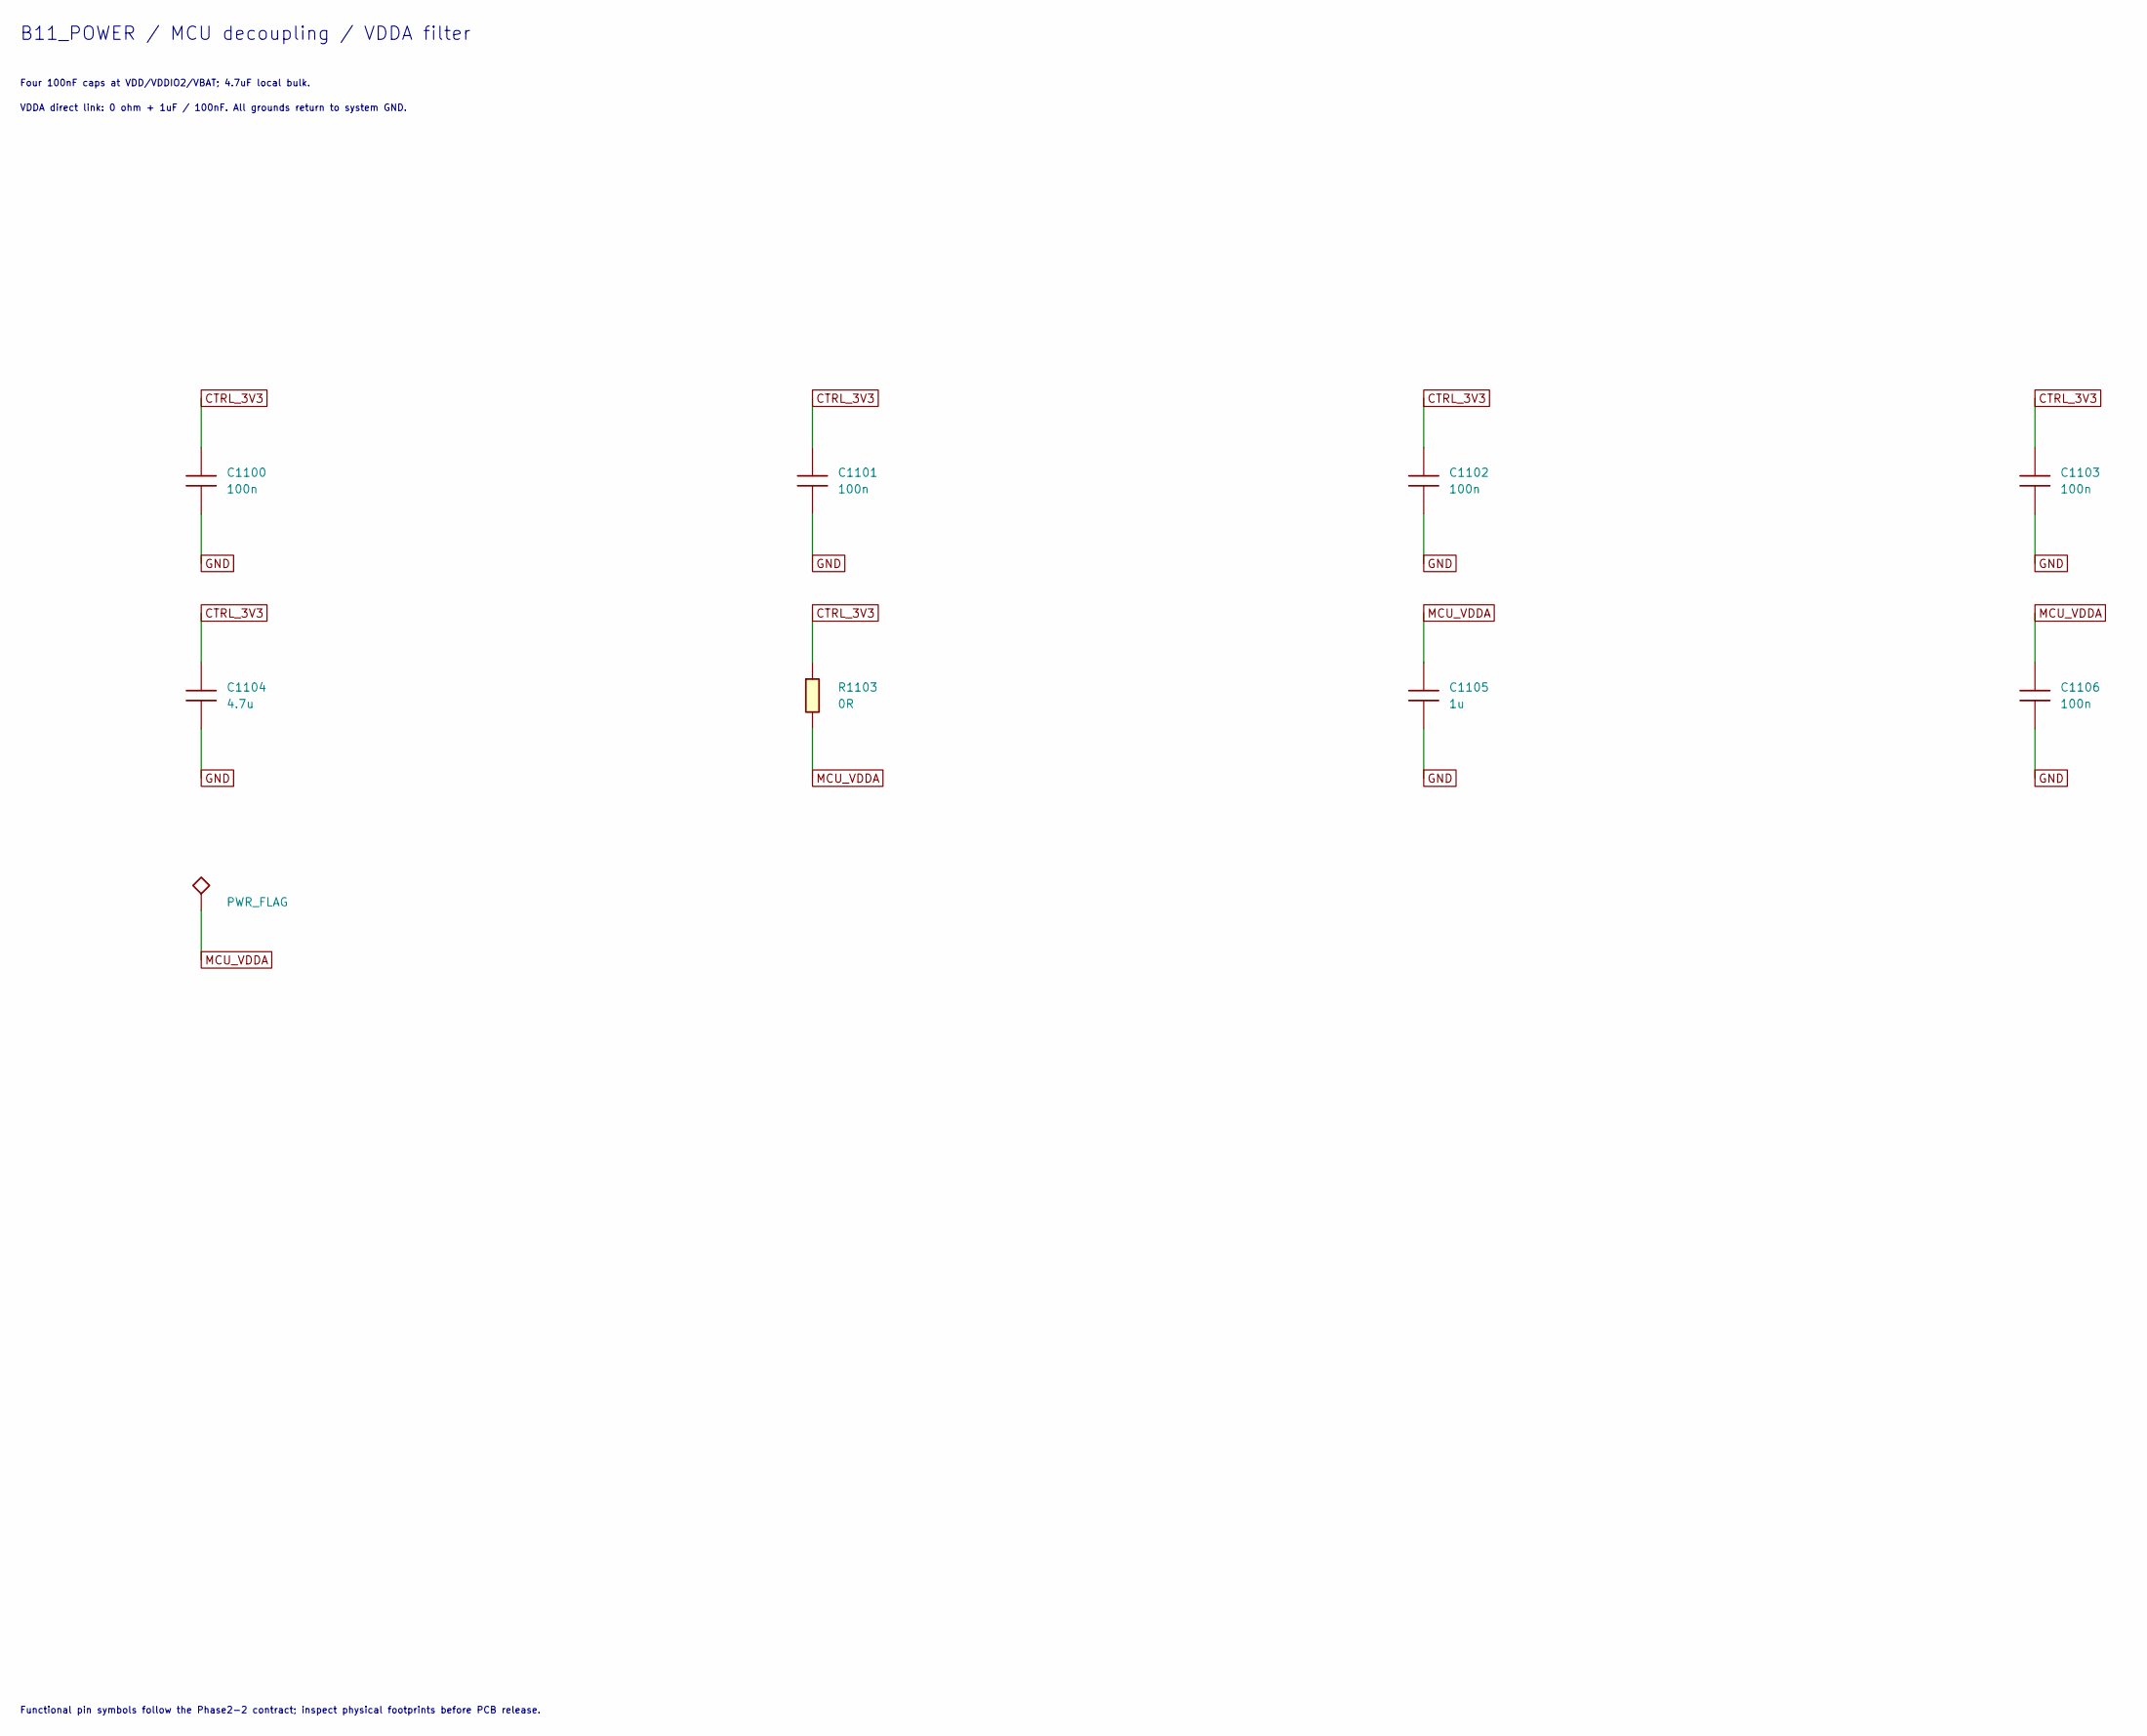
[picture p28: schematic B11_POWER.kicad_sch]

Parts:
C1100, C1101, C1102, C1103, C1106: 100n; C_0603_1608Metric; Rating 16V X7R ±10%; MPN 확인 필요: 유효용량·공차 구매품
C1104: 4.7u; C_0805_2012Metric; Rating 16V X7R ±10%; MPN 확인 필요: 유효용량·공차 구매품
C1105: 1u; C_0603_1608Metric; Rating 16V X7R ±10%; MPN 확인 필요: 유효용량·공차 구매품
R1103: 0R; R_0603_1608Metric; Rating jumper;≤50mΩ 목표; ≥0.1W; MPN 확인 필요: 지정값·정격 구매품

Connections:
CTRL_3V3: C1100.1, C1101.1, C1102.1, C1103.1, C1104.1, R1103.1
GND: C1100.2, C1101.2, C1102.2, C1103.2, C1104.2, C1105.2, C1106.2
MCU_VDDA: C1105.1, C1106.1, R1103.2

Notes on the sheet:
B11_POWER / MCU decoupling / VDDA filter
Four 100nF caps at VDD/VDDIO2/VBAT; 4.7uF local bulk.
VDDA direct link: 0 ohm + 1uF / 100nF. All grounds return to system GND.
Functional pin symbols follow the Phase2-2 contract; inspect physical footprints before PCB release.
