Gugong0412/currentboard/R2_REPAIRED_006/B12_CONNECTOR.kicad_sch

## KiCad design R2_REPAIRED_006/B12_CONNECTOR.kicad_sch (2026-10-15)

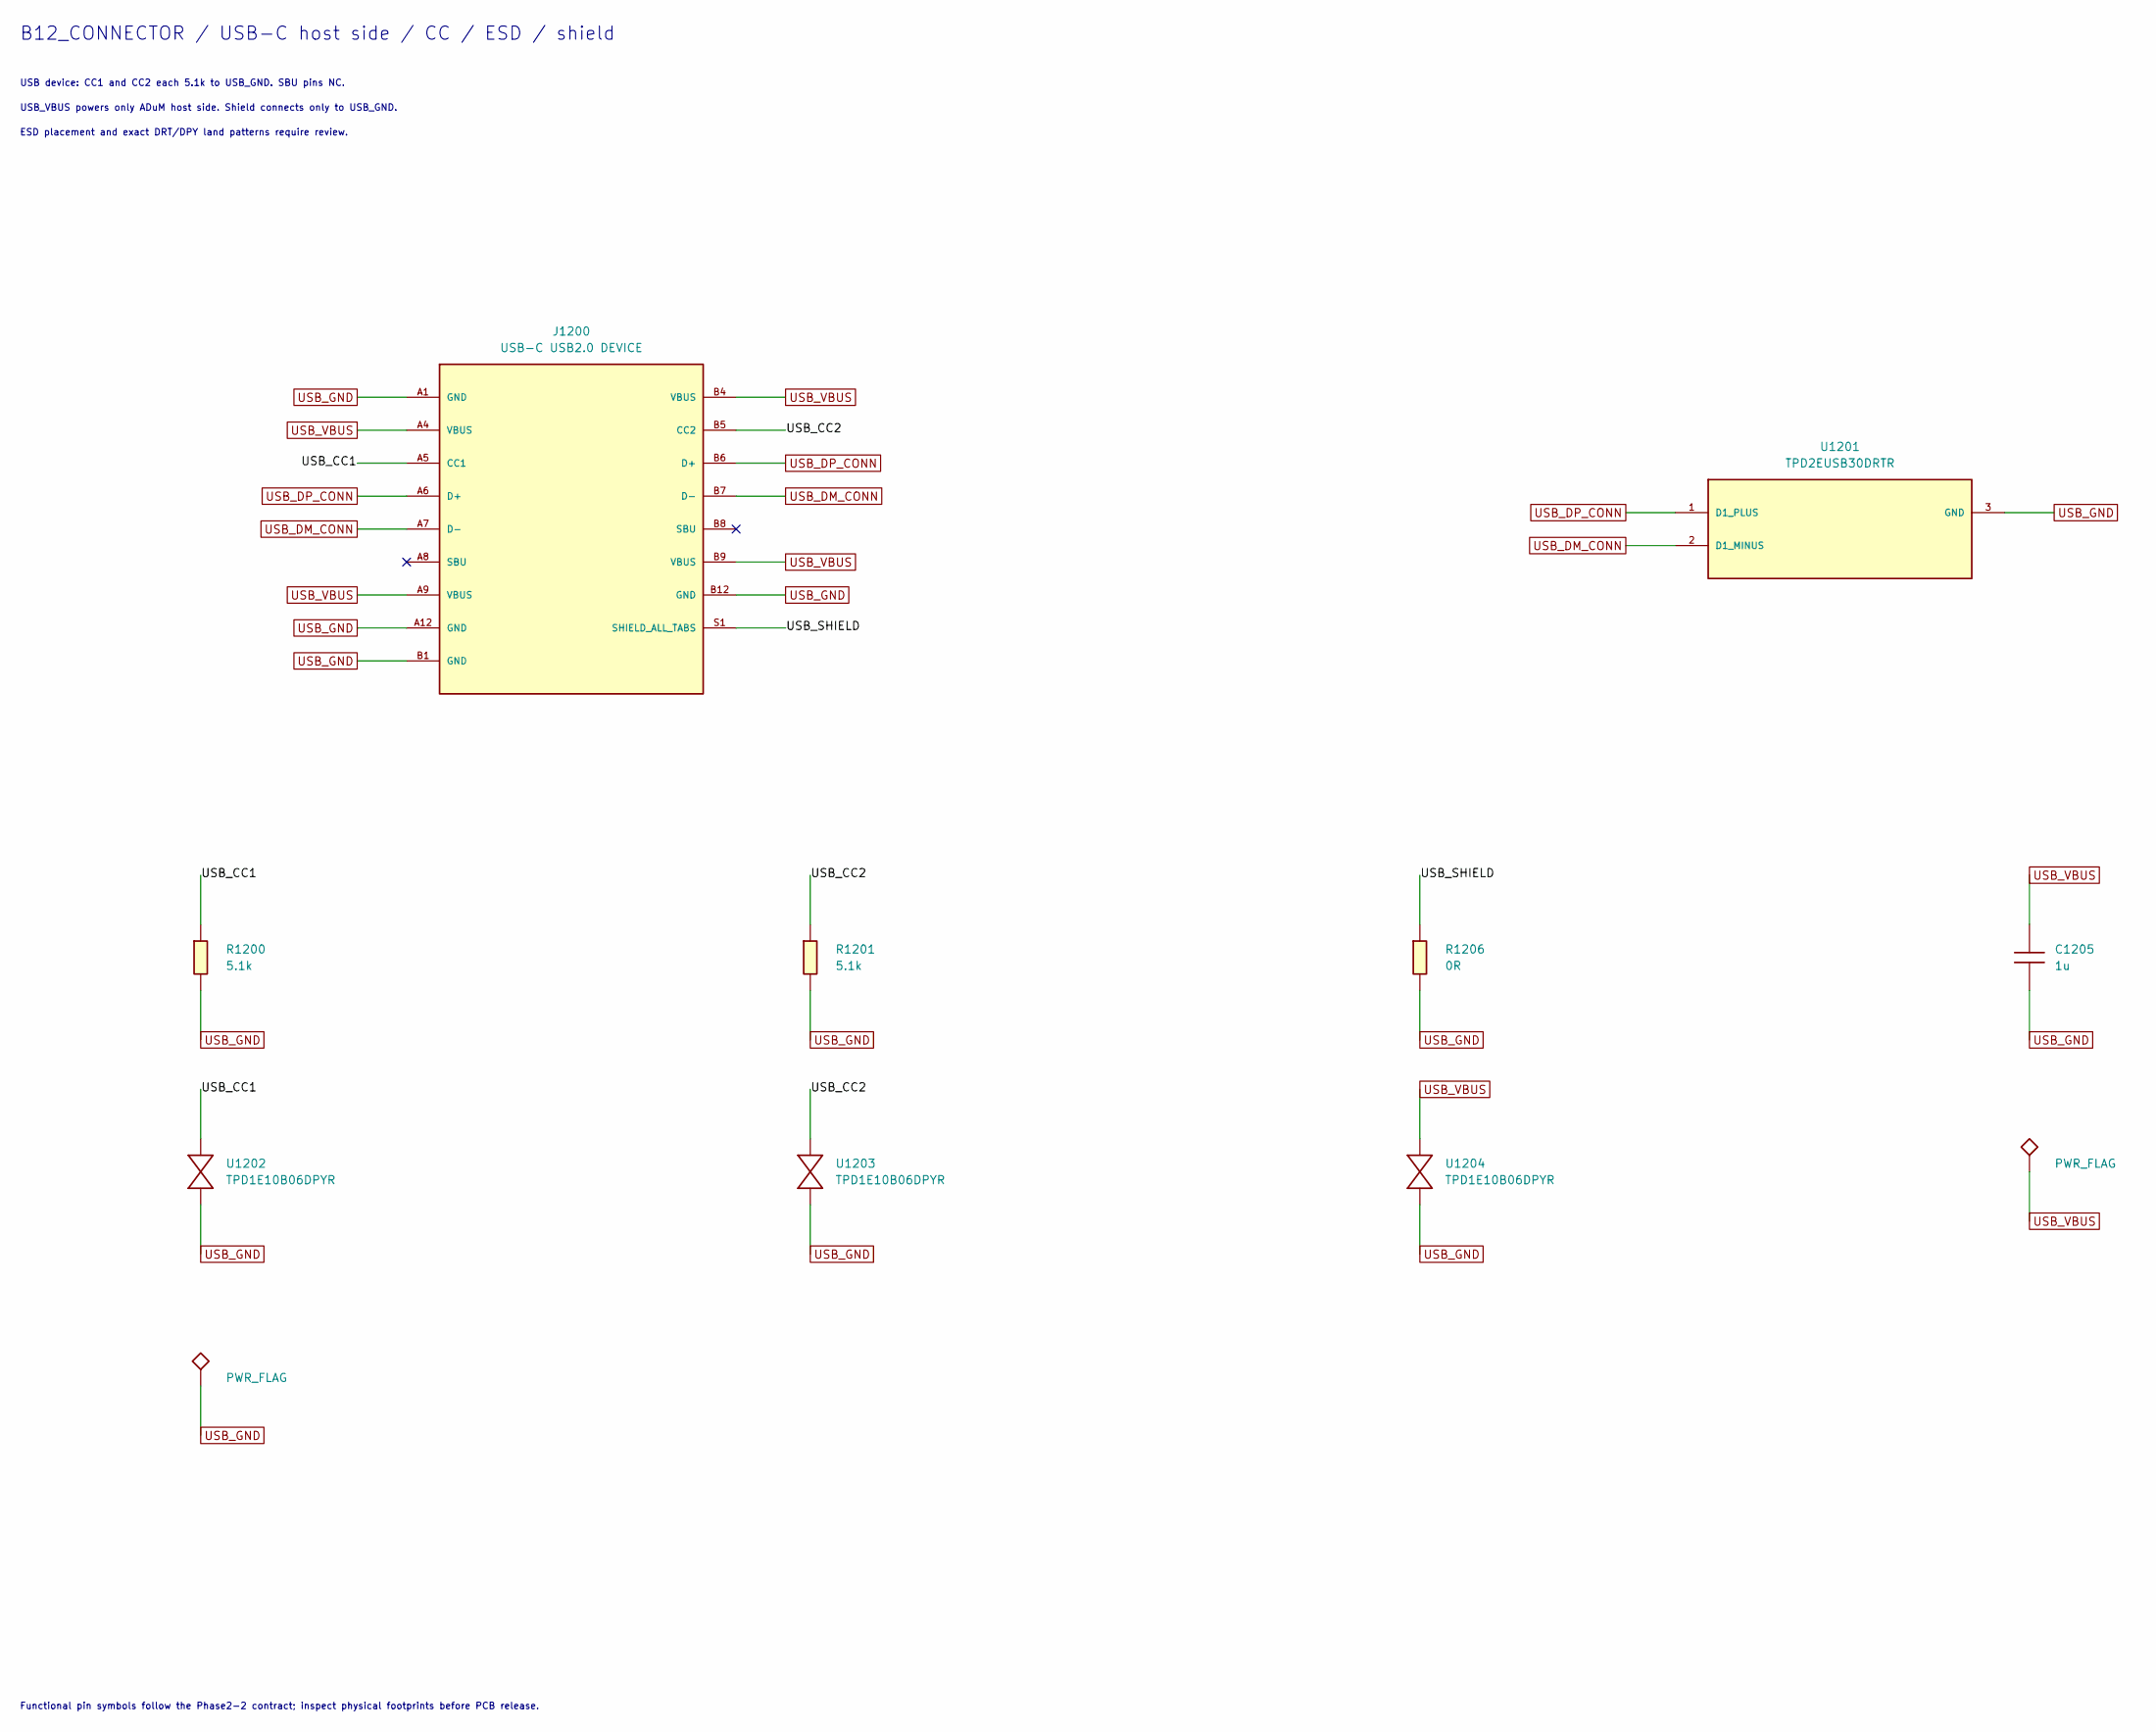
[picture p29: schematic B12_CONNECTOR.kicad_sch]

Parts:
C1205: 1u; C_0603_1608Metric; Rating 16V X7R ±10%; MPN 확인 필요: 유효용량·공차 구매품
J1200: USB-C USB2.0 DEVICE; USB_C_Receptacle_GCT_USB4105-xx-A_16P_TopMnt_Horizontal_S1; Rating VBUS contacts collective5A, GND6.25A; 사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; MPN USB4105-GF-A
R1200, R1201: 5.1k; R_0603_1608Metric; Rating 1%, ≥0.1W, ≥50V; MPN 확인 필요: 지정값·정격 구매품
R1206: 0R; R_0603_1608Metric; Rating 1%, ≥0.1W, ≥50V; MPN 확인 필요: 지정값·정격 구매품
U1201: TPD2EUSB30DRTR; Rating DRT3, Cio typ0.7pF; VBR/VRWM 원문 확인; MPN TPD2EUSB30DRTR
U1202, U1203, U1204: TPD1E10B06DPYR; Rating 6V standoff; 양방향; DPY2; MPN TPD1E10B06DPYR

Connections:
USB_CC1: J1200.A5 (CC1), R1200.1, U1202.1 (A1)
USB_CC2: J1200.B5 (CC2), R1201.1, U1203.1 (A1)
USB_DM_CONN: J1200.A7 (D-), J1200.B7 (D-), U1201.2 (D1_MINUS)
USB_DP_CONN: J1200.A6 (D+), J1200.B6 (D+), U1201.1 (D1_PLUS)
USB_GND: C1205.2, J1200.A1 (GND), J1200.A12 (GND), J1200.B1 (GND), J1200.B12 (GND), R1200.2, R1201.2, R1206.2, U1201.3 (GND), U1202.2 (A2), U1203.2 (A2), U1204.2 (A2)
USB_SHIELD: J1200.S1 (SHIELD_ALL_TABS), R1206.1
USB_VBUS: C1205.1, J1200.A4 (VBUS), J1200.A9 (VBUS), J1200.B4 (VBUS), J1200.B9 (VBUS), U1204.1 (A1)

Notes on the sheet:
B12_CONNECTOR / USB-C host side / CC / ESD / shield
USB device: CC1 and CC2 each 5.1k to USB_GND. SBU pins NC.
USB_VBUS powers only ADuM host side. Shield connects only to USB_GND.
ESD placement and exact DRT/DPY land patterns require review.
Functional pin symbols follow the Phase2-2 contract; inspect physical footprints before PCB release.
