Gugong0412/currentboard/R2_REPAIRED_006/B12_ISOLATOR.kicad_sch

## KiCad design R2_REPAIRED_006/B12_ISOLATOR.kicad_sch (2026-10-15)

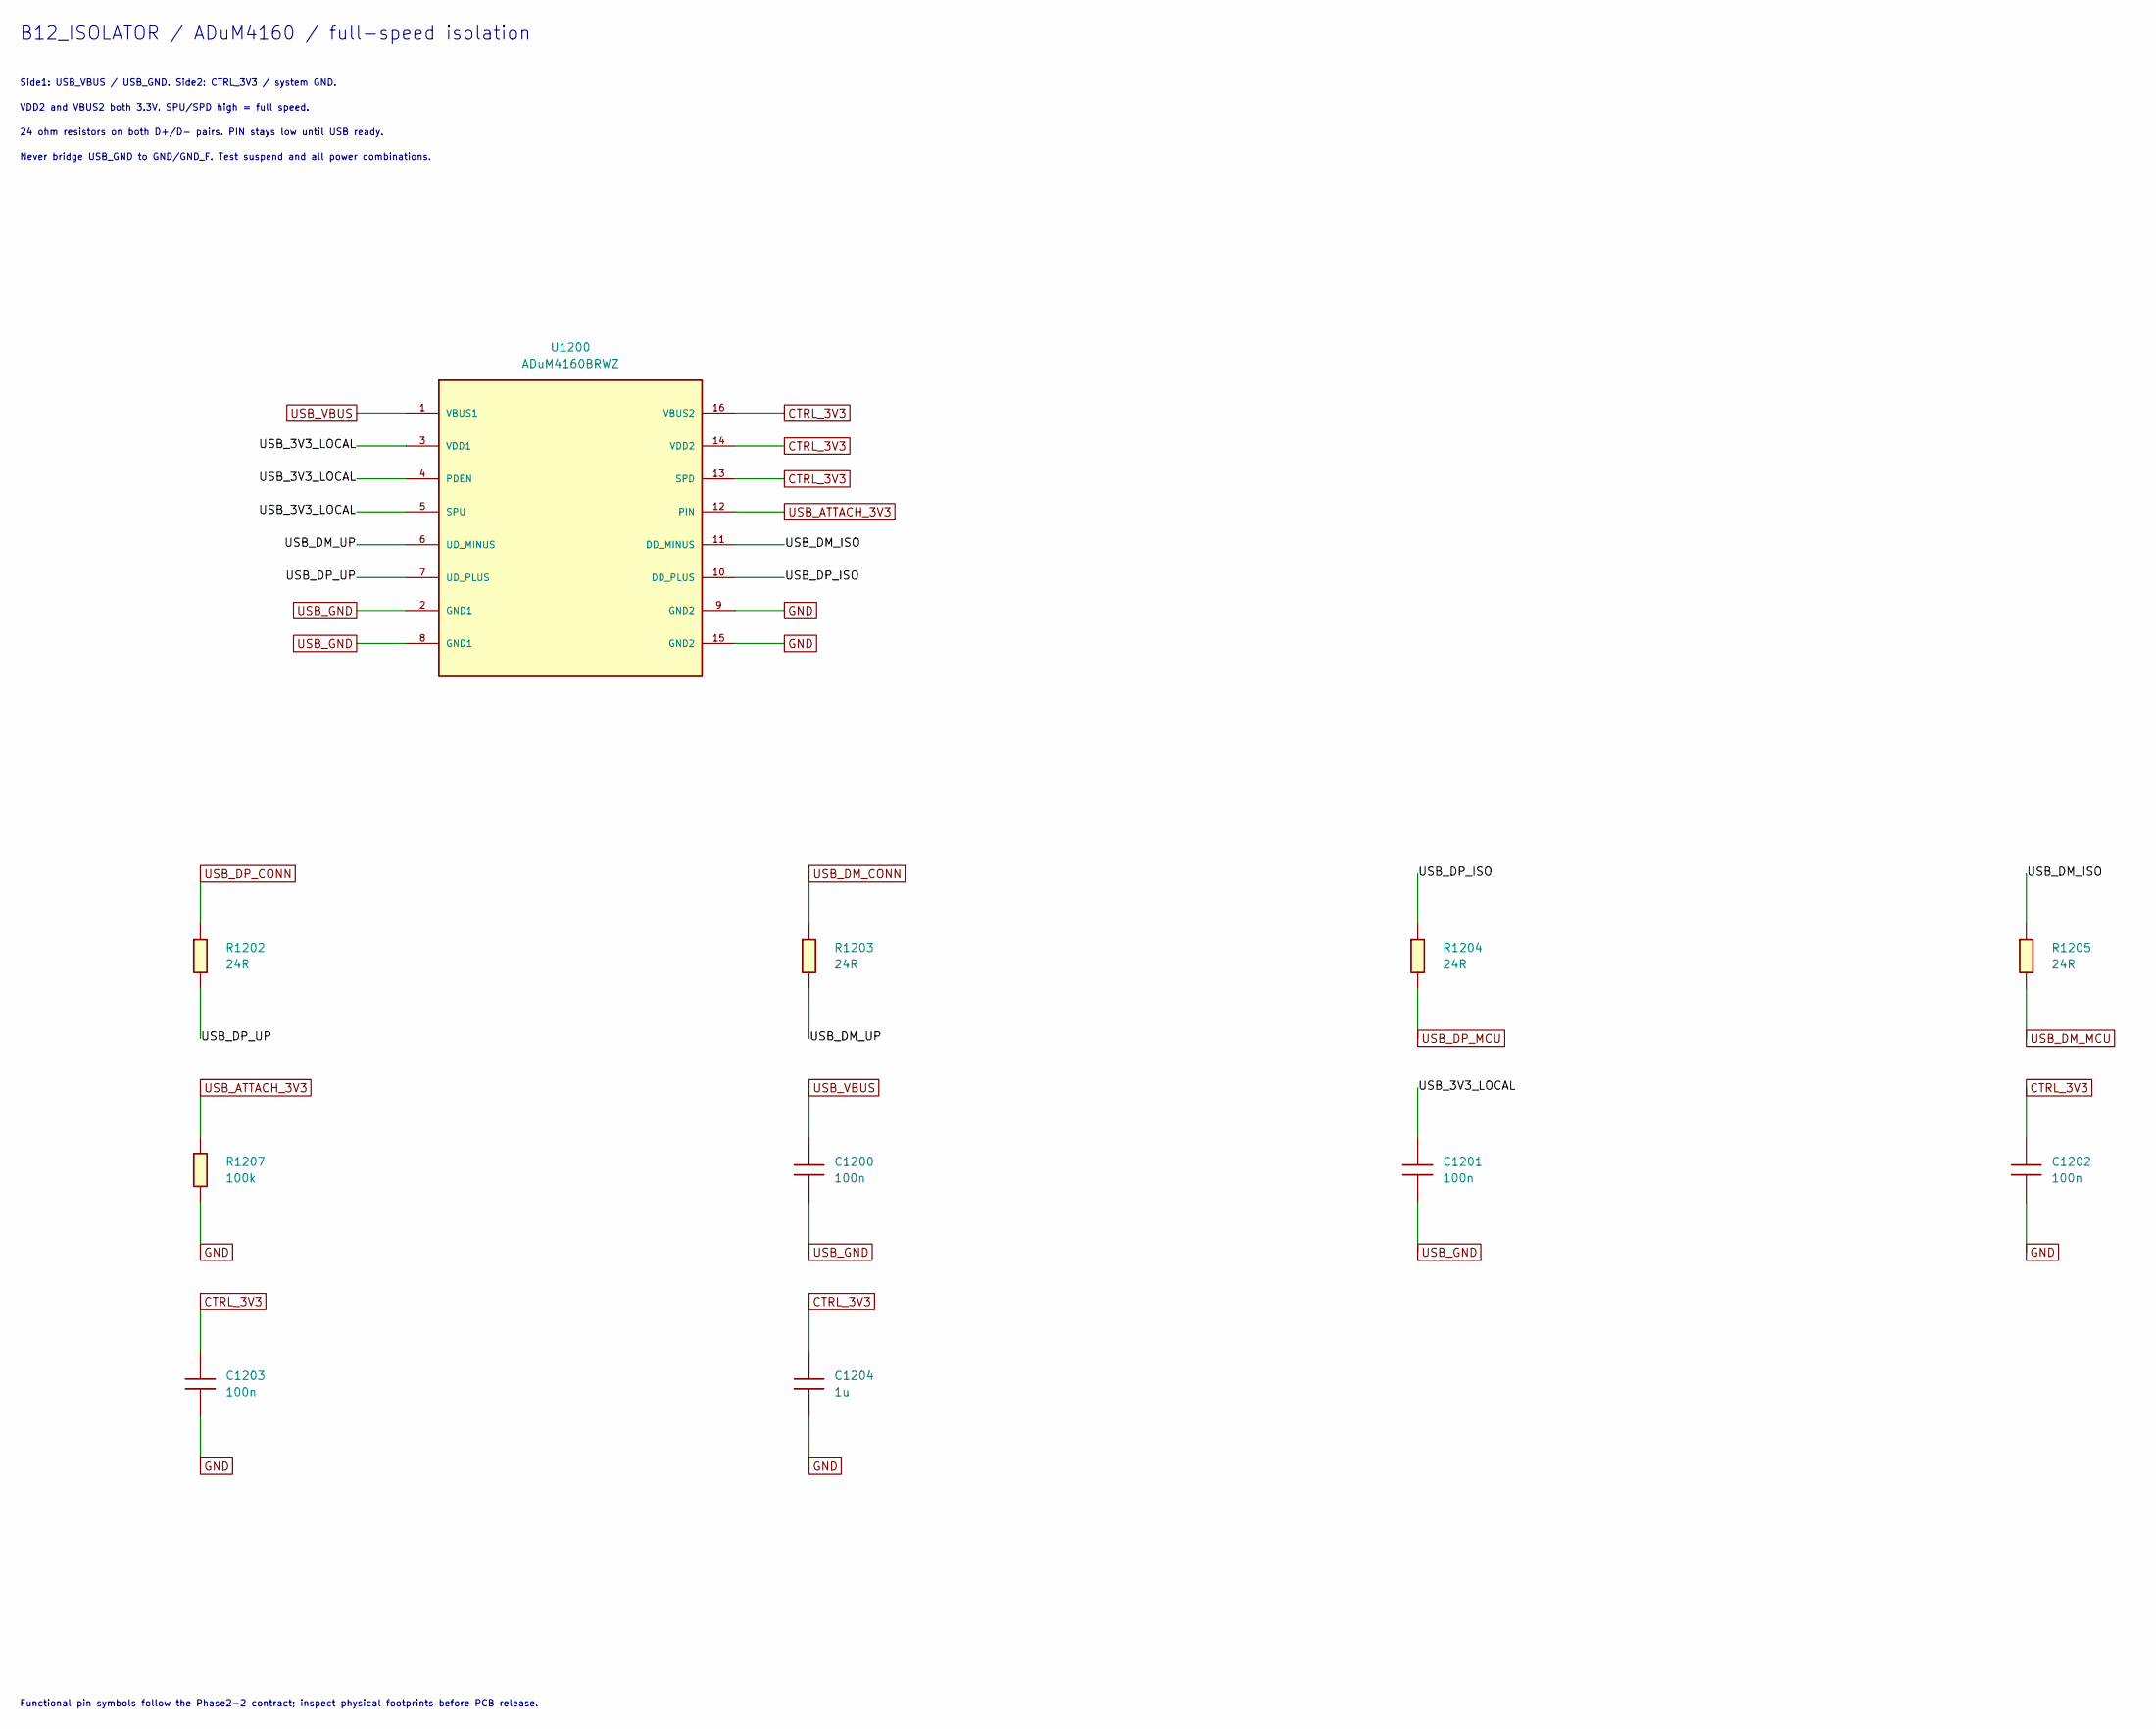
[picture p30: schematic B12_ISOLATOR.kicad_sch]

Parts:
C1200, C1201, C1202, C1203: 100n; C_0603_1608Metric; Rating 16V X7R ±10%; MPN 확인 필요: 유효용량·공차 구매품
C1204: 1u; C_0603_1608Metric; Rating 16V X7R ±10%; MPN 확인 필요: 유효용량·공차 구매품
R1202, R1203, R1204, R1205: 24R; R_0603_1608Metric; Rating 1%, ≥0.1W, ≥50V; MPN 확인 필요: 지정값·정격 구매품
R1207: 100k; R_0603_1608Metric; Rating 1%, ≥0.1W, ≥50V; MPN 확인 필요: 지정값·정격 구매품
U1200: ADuM4160BRWZ; SOIC-16W_7.5x10.3mm_P1.27mm; Rating USB FS12Mbps, side1 5V / side2 3.3V, ea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; MPN ADuM4160BRWZ

Connections:
CTRL_3V3: C1202.1, C1203.1, C1204.1, U1200.13 (SPD), U1200.14 (VDD2), U1200.16 (VBUS2)
GND: C1202.2, C1203.2, C1204.2, R1207.2, U1200.9 (GND2), U1200.15 (GND2)
USB_3V3_LOCAL: C1201.1, U1200.3 (VDD1), U1200.4 (PDEN), U1200.5 (SPU)
USB_ATTACH_3V3: R1207.1, U1200.12 (PIN)
USB_DM_CONN: R1203.1
USB_DM_ISO: R1205.1, U1200.11 (DD_MINUS)
USB_DM_MCU: R1205.2
USB_DM_UP: R1203.2, U1200.6 (UD_MINUS)
USB_DP_CONN: R1202.1
USB_DP_ISO: R1204.1, U1200.10 (DD_PLUS)
USB_DP_MCU: R1204.2
USB_DP_UP: R1202.2, U1200.7 (UD_PLUS)
USB_GND: C1200.2, C1201.2, U1200.2 (GND1), U1200.8 (GND1)
USB_VBUS: C1200.1, U1200.1 (VBUS1)

Notes on the sheet:
B12_ISOLATOR / ADuM4160 / full-speed isolation
Side1: USB_VBUS / USB_GND. Side2: CTRL_3V3 / system GND.
VDD2 and VBUS2 both 3.3V. SPU/SPD high = full speed.
24 ohm resistors on both D+/D- pairs. PIN stays low until USB ready.
Never bridge USB_GND to GND/GND_F. Test suspend and all power combinations.
Functional pin symbols follow the Phase2-2 contract; inspect physical footprints before PCB release.
