Gugong0412/currentboard/R2_REPAIRED_006/B13.kicad_sch

## KiCad design R2_REPAIRED_006/B13.kicad_sch (2026-10-15)

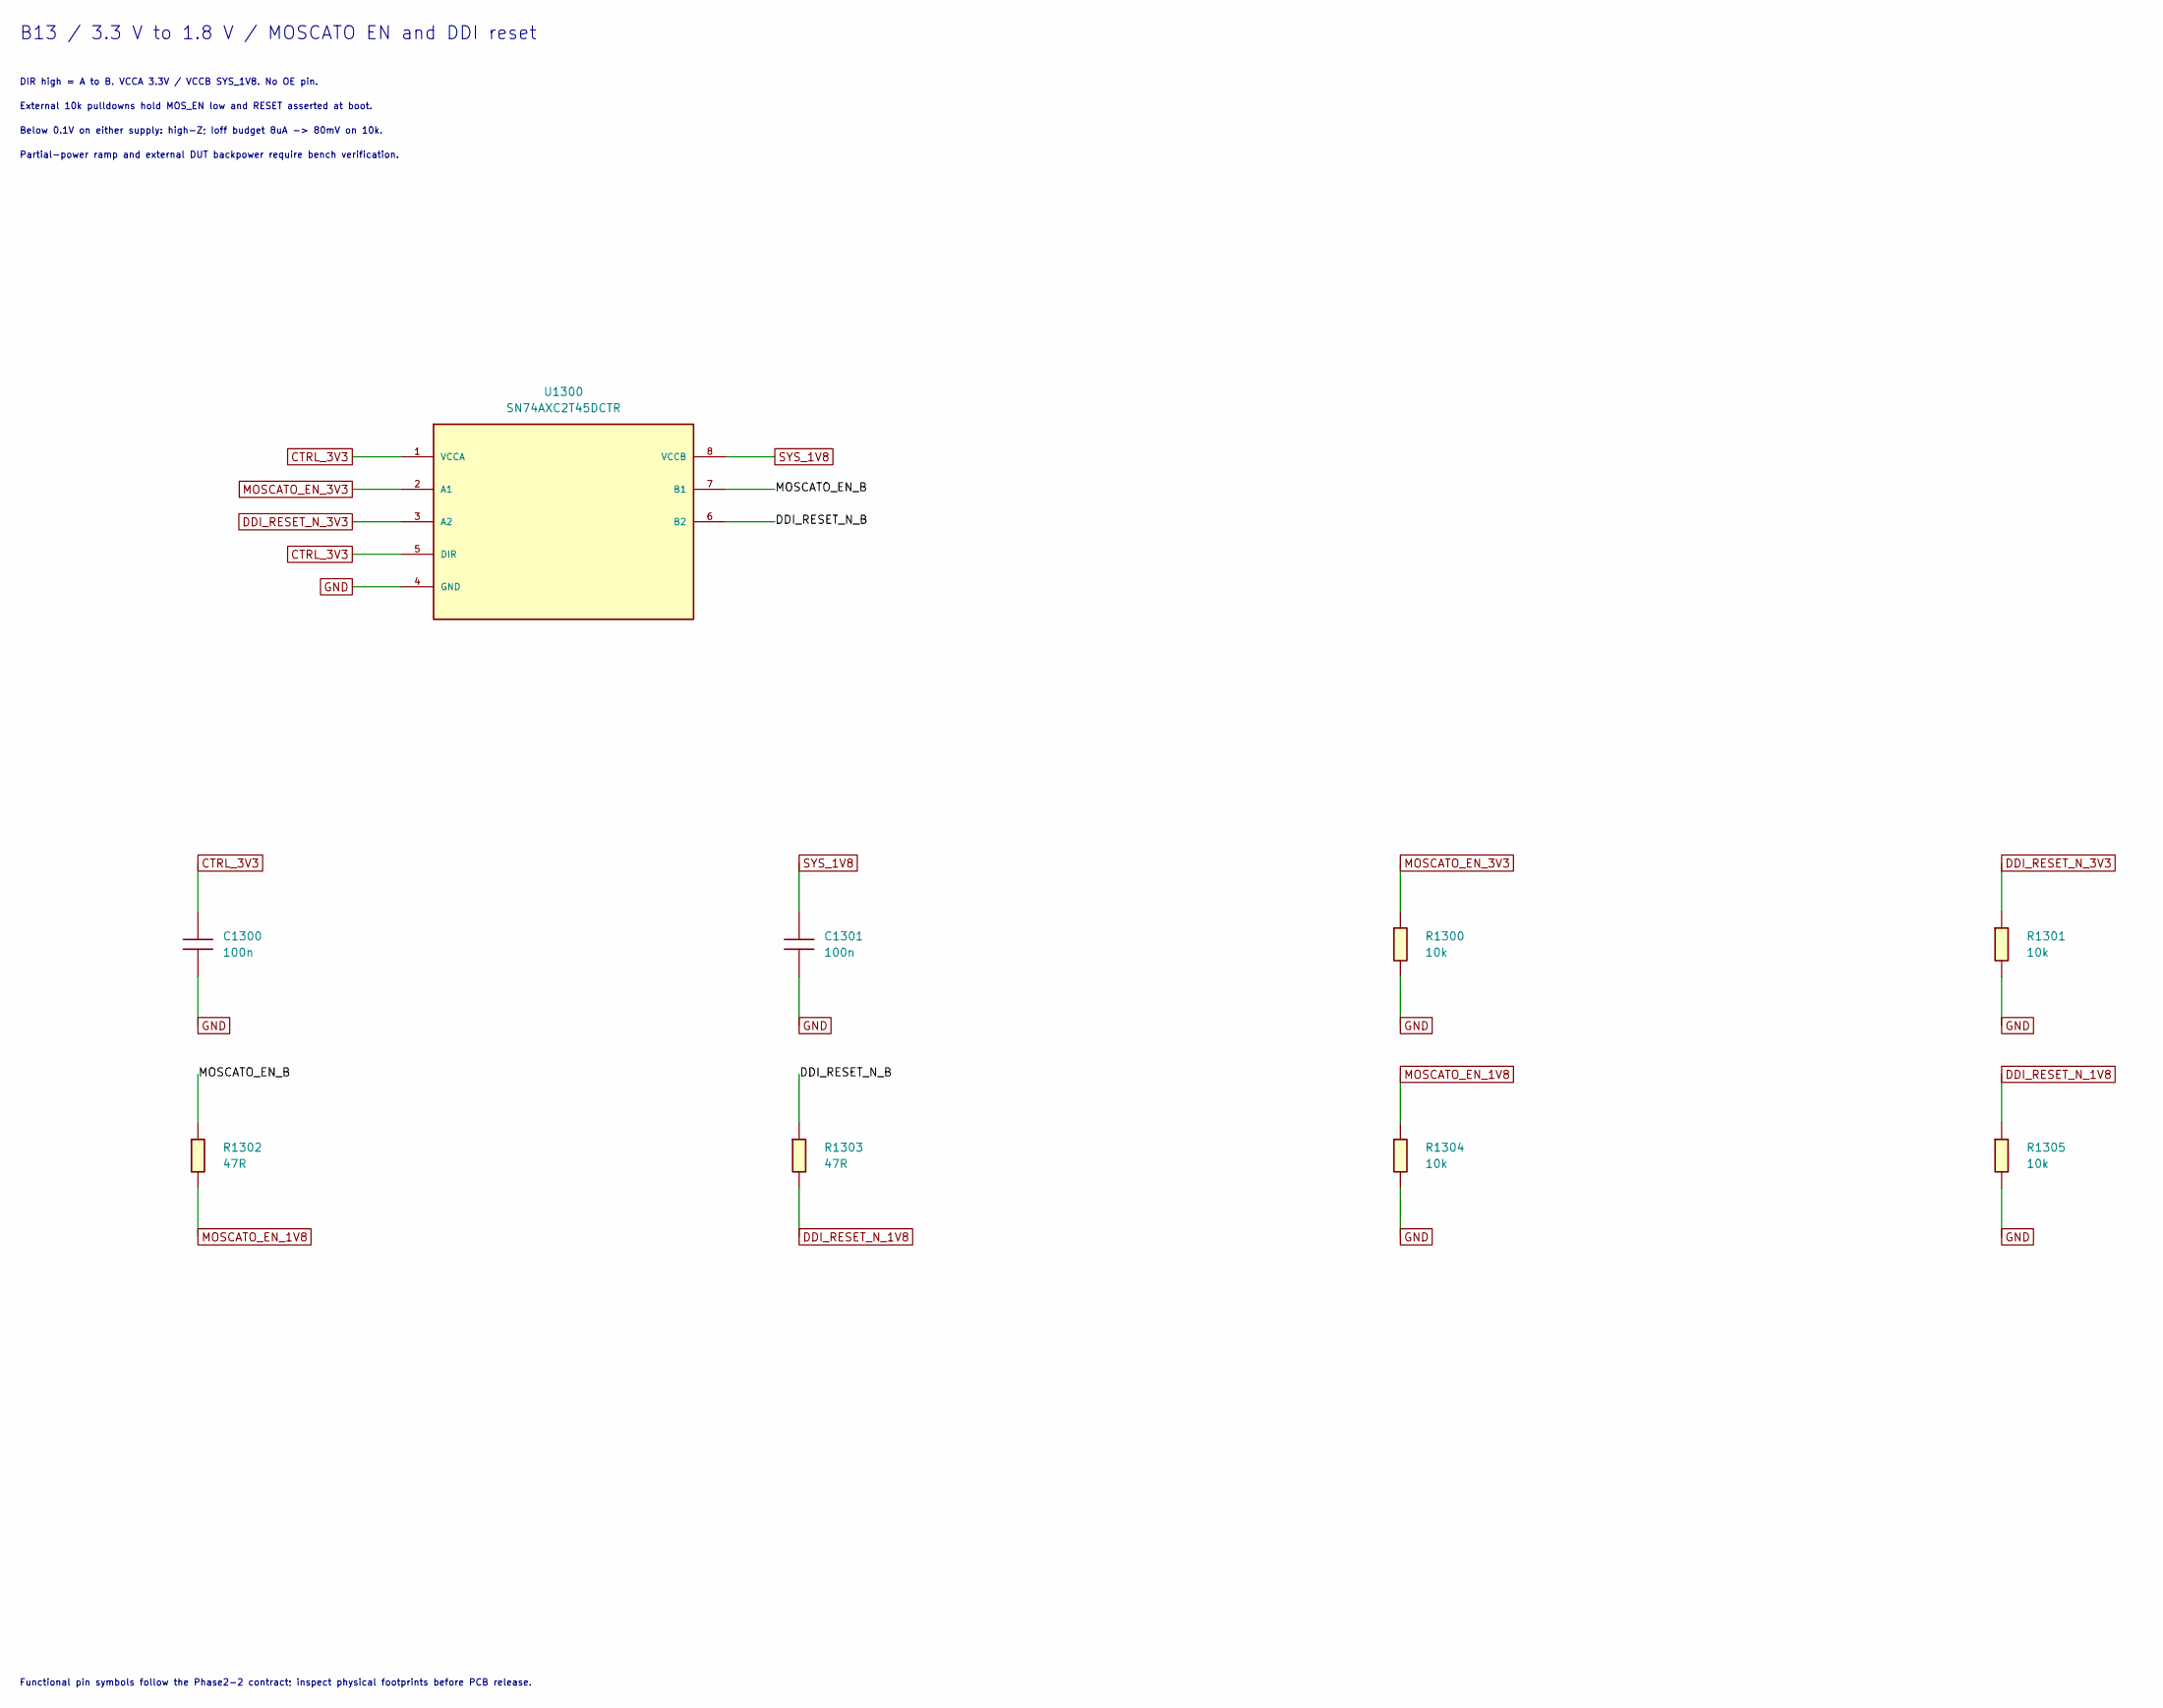
[picture p31: schematic B13.kicad_sch]

Parts:
C1300, C1301: 100n; C_0603_1608Metric; Rating 16V X7R ±10%; MPN 확인 필요: 유효용량·공차 구매품
R1300, R1301, R1304, R1305: 10k; R_0603_1608Metric; Rating 1%, ≥0.1W, ≥50V; MPN 확인 필요: 지정값·정격 구매품
R1302, R1303: 47R; R_0603_1608Metric; Rating 1%, ≥0.1W, ≥50V; MPN 확인 필요: 지정값·정격 구매품
U1300: SN74AXC2T45DCTR; Rating DIR=VCCA -> A to B; VCC<0.1V시 high-Z; I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; MPN SN74AXC2T45DCTR

Connections:
CTRL_3V3: C1300.1, U1300.1 (VCCA), U1300.5 (DIR)
DDI_RESET_N_1V8: R1303.2, R1305.1
DDI_RESET_N_3V3: R1301.1, U1300.3 (A2)
DDI_RESET_N_B: R1303.1, U1300.6 (B2)
GND: C1300.2, C1301.2, R1300.2, R1301.2, R1304.2, R1305.2, U1300.4 (GND)
MOSCATO_EN_1V8: R1302.2, R1304.1
MOSCATO_EN_3V3: R1300.1, U1300.2 (A1)
MOSCATO_EN_B: R1302.1, U1300.7 (B1)
SYS_1V8: C1301.1, U1300.8 (VCCB)

Notes on the sheet:
B13 / 3.3 V to 1.8 V / MOSCATO EN and DDI reset
DIR high = A to B. VCCA 3.3V / VCCB SYS_1V8. No OE pin.
External 10k pulldowns hold MOS_EN low and RESET asserted at boot.
Below 0.1V on either supply: high-Z; Ioff budget 8uA -> 80mV on 10k.
Partial-power ramp and external DUT backpower require bench verification.
Functional pin symbols follow the Phase2-2 contract; inspect physical footprints before PCB release.
