Gugong0412/currentboard/R2_REPAIRED_006/B14.kicad_sch

## KiCad design R2_REPAIRED_006/B14.kicad_sch (2026-10-15)

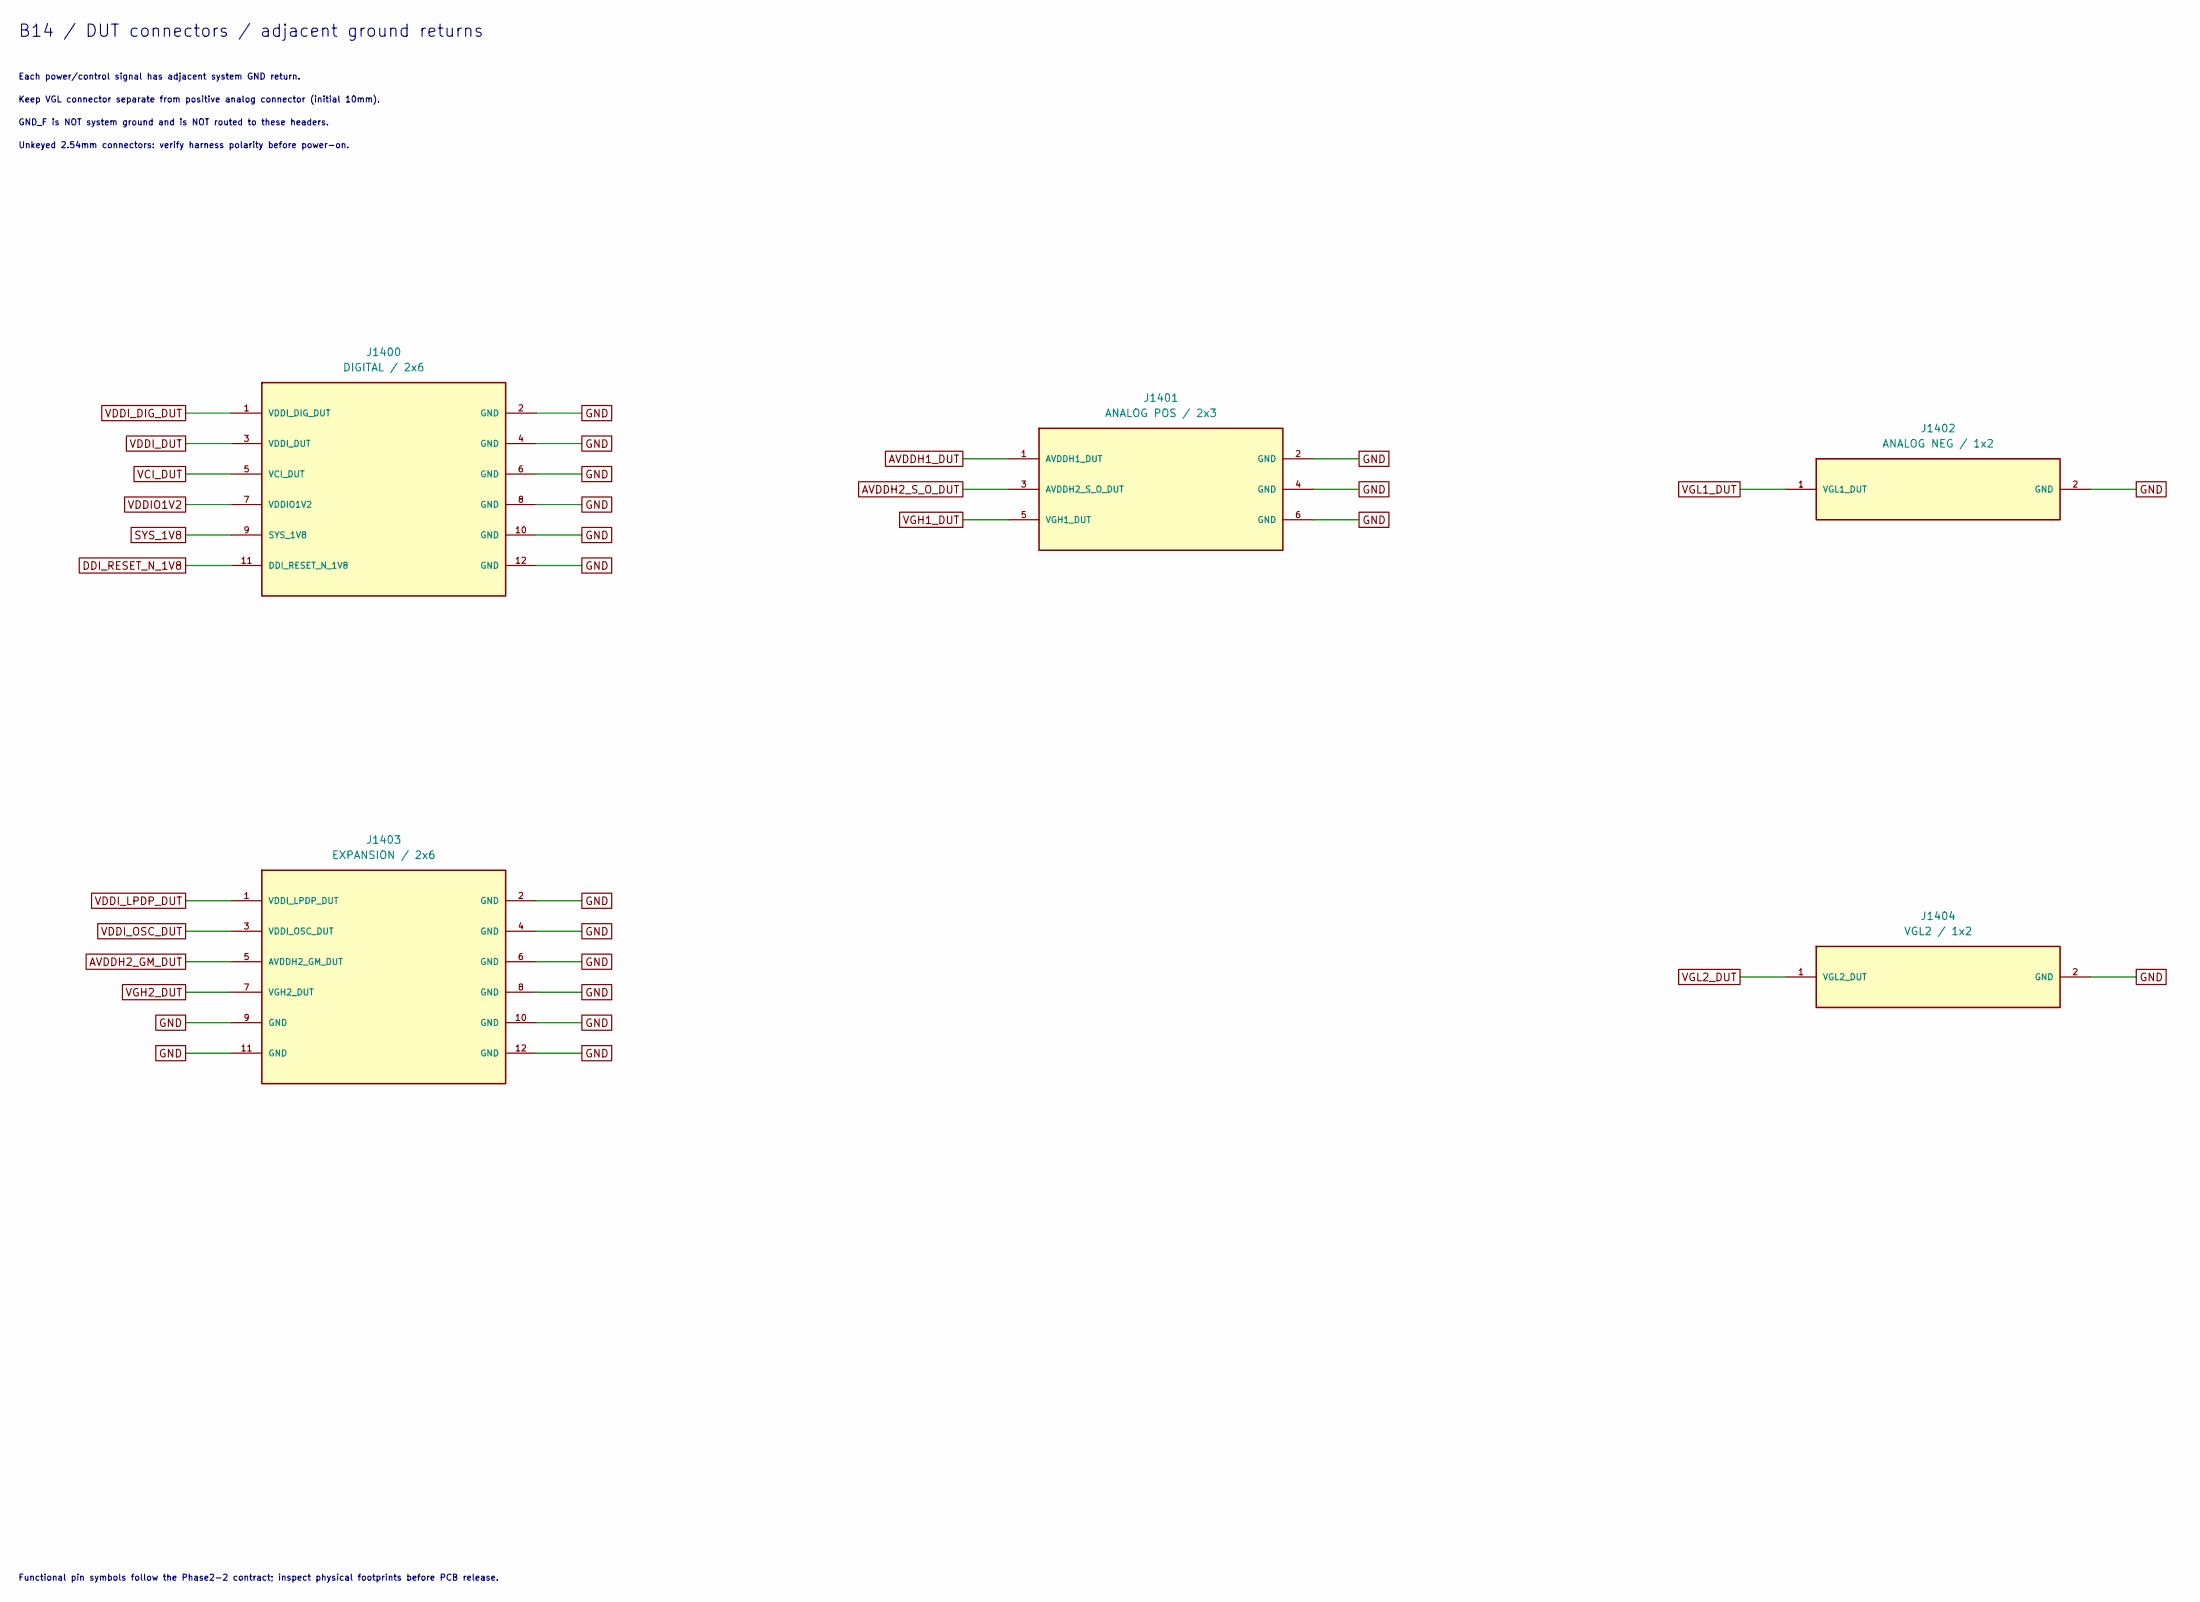
[picture p32: schematic B14.kicad_sch]

Parts:
J1400: DIGITAL / 2x6; PinHeader_2x06_P2.54mm_Vertical; Rating TSW/SSW 4.7A(one pin/row powered); 시스템 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; MPN TSW-106-07-G-D
J1401: ANALOG POS / 2x3; PinHeader_2x03_P2.54mm_Vertical; Rating TSW/SSW 4.7A(one pin/row powered); 시스템 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; MPN TSW-103-07-G-D
J1402: ANALOG NEG / 1x2; PinHeader_1x02_P2.54mm_Vertical; Rating TSW/SSW 4.7A(one pin/row powered); 시스템 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; MPN TSW-102-07-G-S
J1403: EXPANSION / 2x6; PinHeader_2x06_P2.54mm_Vertical; Rating TSW/SSW 4.7A(one pin/row powered); 시스템 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; MPN TSW-106-07-G-D
J1404: VGL2 / 1x2; PinHeader_1x02_P2.54mm_Vertical; Rating TSW/SSW 4.7A(one pin/row powered); 시스템 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; MPN TSW-102-07-G-S

Connections:
AVDDH1_DUT: J1401.1 (AVDDH1_DUT)
AVDDH2_GM_DUT: J1403.5 (AVDDH2_GM_DUT)
AVDDH2_S_O_DUT: J1401.3 (AVDDH2_S_O_DUT)
DDI_RESET_N_1V8: J1400.11 (DDI_RESET_N_1V8)
GND: J1400.2 (GND), J1400.4 (GND), J1400.6 (GND), J1400.8 (GND), J1400.10 (GND), J1400.12 (GND), J1401.2 (GND), J1401.4 (GND), J1401.6 (GND), J1402.2 (GND), J1403.2 (GND), J1403.4 (GND), J1403.6 (GND), J1403.8 (GND), J1403.9 (GND), J1403.10 (GND), J1403.11 (GND), J1403.12 (GND), J1404.2 (GND)
SYS_1V8: J1400.9 (SYS_1V8)
VCI_DUT: J1400.5 (VCI_DUT)
VDDIO1V2: J1400.7 (VDDIO1V2)
VDDI_DIG_DUT: J1400.1 (VDDI_DIG_DUT)
VDDI_DUT: J1400.3 (VDDI_DUT)
VDDI_LPDP_DUT: J1403.1 (VDDI_LPDP_DUT)
VDDI_OSC_DUT: J1403.3 (VDDI_OSC_DUT)
VGH1_DUT: J1401.5 (VGH1_DUT)
VGH2_DUT: J1403.7 (VGH2_DUT)
VGL1_DUT: J1402.1 (VGL1_DUT)
VGL2_DUT: J1404.1 (VGL2_DUT)

Notes on the sheet:
B14 / DUT connectors / adjacent ground returns
Each power/control signal has adjacent system GND return.
Keep VGL connector separate from positive analog connector (initial 10mm).
GND_F is NOT system ground and is NOT routed to these headers.
Unkeyed 2.54mm connectors: verify harness polarity before power-on.
Functional pin symbols follow the Phase2-2 contract; inspect physical footprints before PCB release.
