Gugong0412/currentboard/R2_REPAIRED_006/B15.kicad_sch

## KiCad design R2_REPAIRED_006/B15.kicad_sch (2026-10-15)

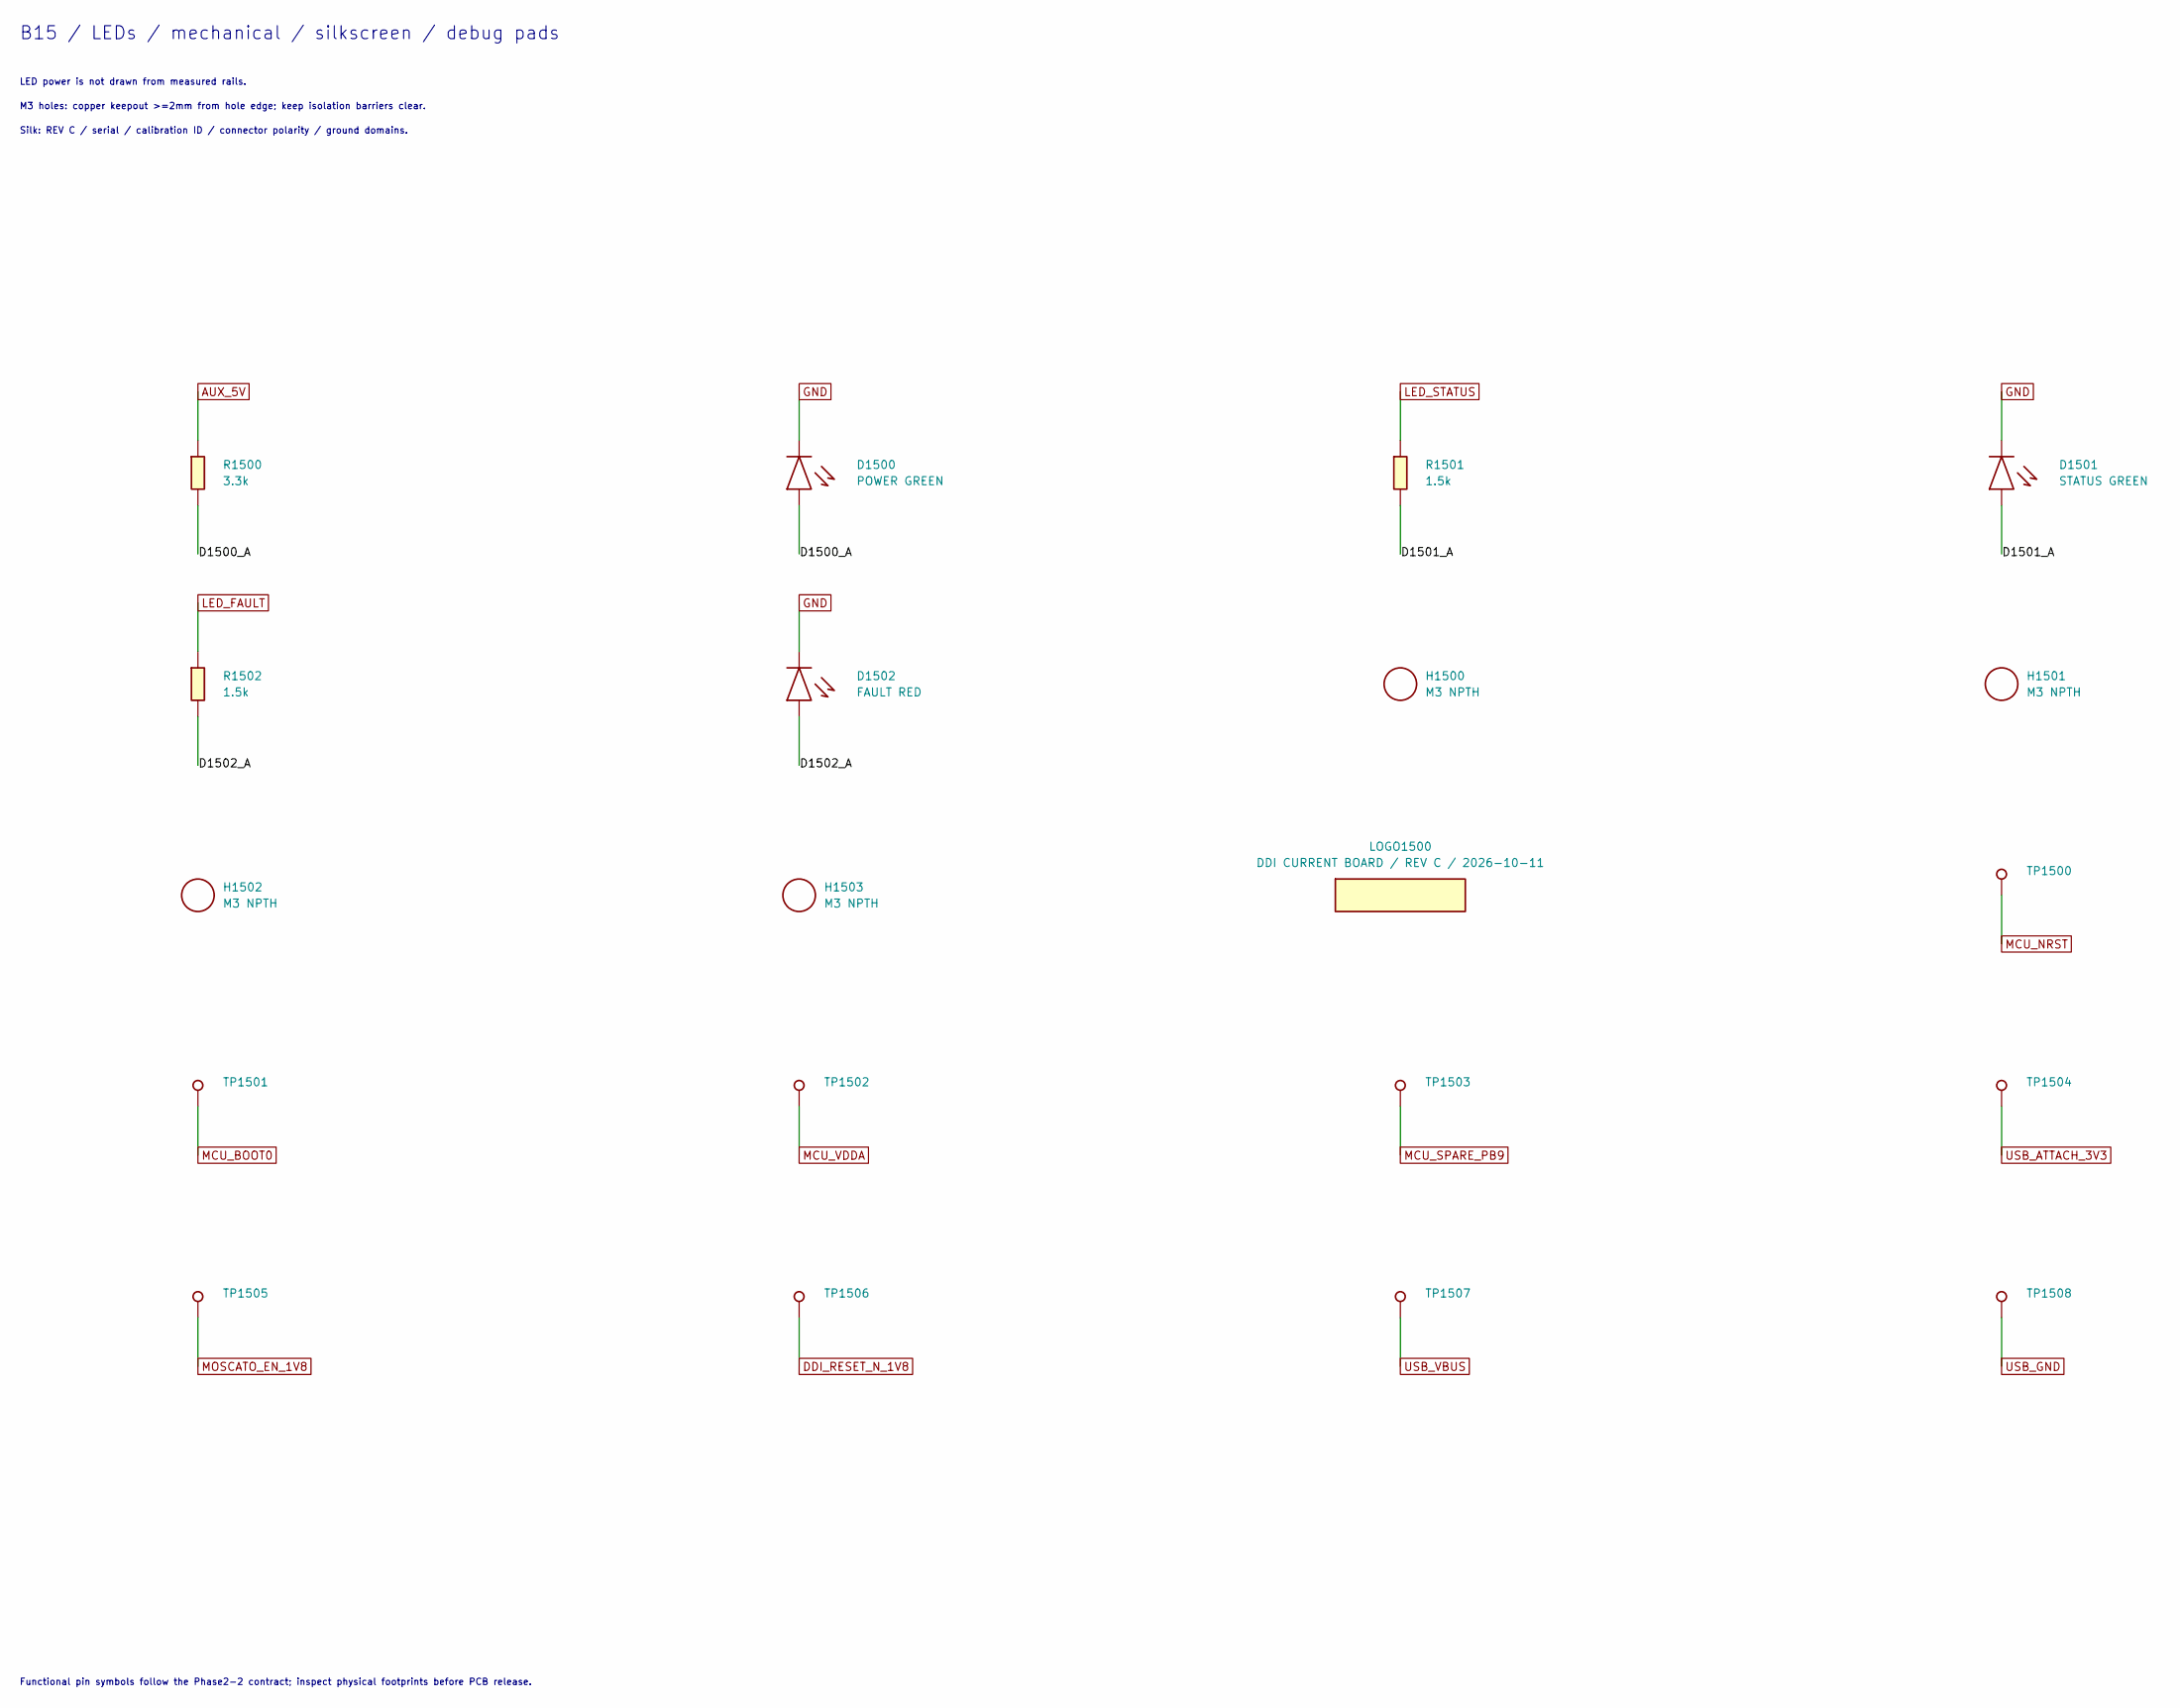
[picture p33: schematic B15.kicad_sch]

Parts:
D1500: POWER GREEN; LED_0603_1608Metric; Rating Vf/밝기/핀 극성 발주품 확인 필요; MPN 확인 필요: green 0603 LED
D1501: STATUS GREEN; LED_0603_1608Metric; Rating Vf/밝기/핀 극성 발주품 확인 필요; MPN 확인 필요: green 0603 LED
D1502: FAULT RED; LED_0603_1608Metric; Rating Vf/밝기/핀 극성 발주품 확인 필요; MPN 확인 필요: red 0603 LED
H1500, H1501, H1502, H1503: M3 NPTH; MountingHole_3.2mm_M3; Rating 3.2mm NPTH; copper keepout ≥2mm from ho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; MPN N/A
LOGO1500: DDI CURRENT BOARD / REV C / 2026-10-11; Rating PCB graphic 지시, 전기핀 없음; MPN N/A
R1500: 3.3k; R_0603_1608Metric; Rating 1%, ≥0.1W, ≥50V; MPN 확인 필요: 지정값·정격 구매품
R1501, R1502: 1.5k; R_0603_1608Metric; Rating 1%, ≥0.1W, ≥50V; MPN 확인 필요: 지정값·정격 구매품
TP1500: MCU_NRST; TestPoint_Pad_D1.5mm; Rating 패드; MPN N/A
TP1501: MCU_BOOT0; TestPoint_Pad_D1.5mm; Rating 패드; MPN N/A
TP1502: MCU_VDDA; TestPoint_Pad_D1.5mm; Rating 패드; MPN N/A
TP1503: MCU_SPARE_PB9; TestPoint_Pad_D1.5mm; Rating 패드; MPN N/A
TP1504: USB_ATTACH_3V3; TestPoint_Pad_D1.5mm; Rating 패드; MPN N/A
TP1505: MOSCATO_EN_1V8; TestPoint_Pad_D1.5mm; Rating 패드; MPN N/A
TP1506: DDI_RESET_N_1V8; TestPoint_Pad_D1.5mm; Rating 패드; MPN N/A
TP1507: USB_VBUS; TestPoint_Pad_D1.5mm; Rating 패드; MPN N/A
TP1508: USB_GND; TestPoint_Pad_D1.5mm; Rating 패드; MPN N/A

Connections:
AUX_5V: R1500.1
D1500_A: D1500.2 (A), R1500.2
D1501_A: D1501.2 (A), R1501.2
D1502_A: D1502.2 (A), R1502.2
DDI_RESET_N_1V8: TP1506.1
GND: D1500.1 (K), D1501.1 (K), D1502.1 (K)
LED_FAULT: R1502.1
LED_STATUS: R1501.1
MCU_BOOT0: TP1501.1
MCU_NRST: TP1500.1
MCU_SPARE_PB9: TP1503.1
MCU_VDDA: TP1502.1
MOSCATO_EN_1V8: TP1505.1
USB_ATTACH_3V3: TP1504.1
USB_GND: TP1508.1
USB_VBUS: TP1507.1

Notes on the sheet:
B15 / LEDs / mechanical / silkscreen / debug pads
LED power is not drawn from measured rails.
M3 holes: copper keepout >=2mm from hole edge; keep isolation barriers clear.
Silk: REV C / serial / calibration ID / connector polarity / ground domains.
Functional pin symbols follow the Phase2-2 contract; inspect physical footprints before PCB release.
