Gugong0412/currentboard/(commit log)

2026-10-11 Create Kicad
2026-10-11 Initial commit: DDI 소비전류 측정보드 설계 자료
    - 요구사항, 단계별 설계 문서(Phase 1 ~ 2-2), 설계 AI 프롬프트
    - KiCad 회로도 프로젝트 (DDI_Phase2_2_KiCad)
    - 넷리스트 대조 스크립트 (netcheck): 현재 회로도 오류 0건
    - .gitignore (KiCad 백업/캐시 제외), README
    Claude-Session: https://claude.ai/code/session_013aefX1guu3GeYHzvfM7Vdw
    [B1.kicad_sch, B10_A.kicad_sch, B10_B.kicad_sch, B11_CLOCK.kicad_sch, B11_CORE.kicad_sch, B11_DEBUG.kicad_sch, B11_POWER.kicad_sch, B12_CONNECTOR.kicad_sch]
2026-10-13 docs: record verified Phase 2-2 handoff and PCB pre-layout blockers
2026-10-13 docs: add Oct 13 Phase 2-2 R1 revised schematic package and block diagrams
2026-10-13 docs: add interactive pin-to-pin DDI schematic HTML with TBD pin highlights
2026-10-14 docs: add contract-grounded full schematic overview to HTML explorer
2026-10-15 fix: reconcile R2 schematic labels and verify 12-channel design
    [B1.kicad_sch, B10_A.kicad_sch, B10_B.kicad_sch, B11_CLOCK.kicad_sch, B11_CORE.kicad_sch, B11_DEBUG.kicad_sch, B11_POWER.kicad_sch, B12_CONNECTOR.kicad_sch]
2026-10-15 fix: connect R2 ALERT nets and update complete block diagram
    [B1.kicad_sch, B10_A.kicad_sch, B10_B.kicad_sch, B11_CLOCK.kicad_sch, B11_CORE.kicad_sch, B11_DEBUG.kicad_sch, B11_POWER.kicad_sch, B12_CONNECTOR.kicad_sch]
2026-10-15 docs: add interactive R2 diagram and organize final deliverables
    [B1.kicad_sch, B10_A.kicad_sch, B10_B.kicad_sch, B11_CLOCK.kicad_sch, B11_CORE.kicad_sch, B11_DEBUG.kicad_sch, B11_POWER.kicad_sch, B12_CONNECTOR.kicad_sch]
2026-10-20 fix: align VDDI jumper labels and add verified block guides
    [B1.kicad_sch, B10_A.kicad_sch, B10_B.kicad_sch, B11_CLOCK.kicad_sch, B11_CORE.kicad_sch, B11_DEBUG.kicad_sch, B11_POWER.kicad_sch, B12_CONNECTOR.kicad_sch]
2026-10-20 docs: publish tabbed circuit guide through GitHub Pages
2026-10-20 docs: rebuild B2-B15 circuit guides to match B1 detail
    [SCHEMATIC_DRAWING_AUDIT.json]
